RoboticsURJC/tfg-vperez/README.md

# Trabajo de Fin de Grado - Vidal Pérez

### The dedicated repo of this proyect is available [here!](https://github.com/vidalperezbohoyo/g-arm/tree/main)
