RoboticsURJC/tfg-vperez/latex/Presentacion/slides.tex

% Completa los datos convenientemente en las zonas marcadas con TODO

\documentclass{beamer}
%PARA VISUALIZAR PRESENTACIONN CON NOTAS USAR VISUALIZADOR "pdfpc":
%Para ver las notas, el cronometro y siguente diapo:
% pdfpc --notes=right slides.pdf
% "tecla p": para pausar el cronometro
\mode<presentation> {
  \usetheme{CambridgeUS}
  \usecolortheme{crane} % color naranja
}
\setbeamercolor{titlelike}{parent=structure,bg=yellow!85!orange} % Cambia el color de la caja del título de la página inicial

\setbeamertemplate{navigation symbols}{} % ocultar iconos de navegación
\setbeamerfont{subsection in toc}{size=\small} % reducir tamaño en TOC
\setbeamerfont{date}{size=\tiny}
\usepackage[spanish]{babel}
\usepackage[utf8]{inputenc}
\usepackage{graphicx}
\usepackage{eurosym}
\usepackage{booktabs}
\usepackage{hyperref}
\usepackage{graphicx}
\usepackage{multicol}
\usepackage{pgfpages}
\usepackage{listings}
\usepackage{multimedia}
\usepackage[export]{adjustbox}
\usepackage{outlines} % Para poner bullets tabulados (\1 \2 \3 ...) y no items
\usepackage{siunitx}
\usepackage{multicol}
\usepackage{xspace}
\usepackage{xcolor}
\usepackage{array,tabularx} % para tabular leyenda de ecuaciones
\newenvironment{conditions*} % entorno de "leyenda de ecuación"
  {\par\vspace{\abovedisplayskip}\noindent
   \tabularx{\columnwidth}{>{$}l<{$} @{\ : } >{\raggedright\arraybackslash}X}}
  {\endtabularx\par\vspace{\belowdisplayskip}}
  
% USO DE NOTAS
\setbeameroption{hide notes} % Para mostrar u ocultar (hide/show)
%\setbeameroption{show only notes} % Mostrar solo las notas
%\setbeameroption{show notes on second screen=right} % Mostrar notas en otra pantalla
\setbeamertemplate{note page}{ % asi solo muestro el texto de las notas
  \insertnote%
}

%========= TODO: datos internos del documento
\hypersetup{
	pdftitle={Defensa de trabajo de fin de grado de Vidal Pérez Bohoyo},
	pdfauthor={Vidal Pérez Bohoyo},
	pdfsubject={Brazo robótico de bajo coste para la docencia universitaria},
	pdfkeywords={teaching, robotics, arm, ROS, actuators, DOF, 3D, printer},
	pdfproducer={pdfLaTeX},
  colorlinks=true,
  linkcolor=blue
}
%=========

%========= TODO: diapositiva de portada
\title[Brazo robótico de bajo coste]{Brazo robótico de bajo coste \\ para la docencia universitaria} % El título reducido aparece en la parte inferior de todas las diapositivas
                                         % El título completo aparece solo en la diapositiva de portada
\author[Vidal Pérez Bohoyo]{Vidal Pérez Bohoyo}
\institute[URJC]
{
\textit{\href{mailto:v.perezb.2019@alumnos.urjc.es}{\color{blue}{\underline{v.perezb.2019@alumnos.urjc.es}}}}\\
\vspace{0.5cm}
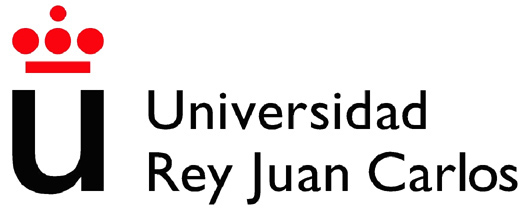
[picture p1: latex/Presentacion/figs/logo-urjc.jpg]
\\
\vspace{1cm}
Trabajo fin de grado
}
\date{27 de octubre de 2023}
%=========

%========= COMIENZO DEL DOCUMENTO
\begin{document}

%========= Portada inicial con notas
\begin{frame}[plain] % plain: quita header y footer
\large{\titlepage}
\note[item]{En esta presentación voy a hablar sobre...}
\note[item]{En primer lugar...}
\end{frame}

%========= Licencia
\begin{frame}
\input{licencia.tex}
\end{frame}

%========= Índice o tabla de contenidos (TOC)
\begin{frame}
\frametitle{Contenidos}
%\begin{multicols}{2} % si tengo muchas secciones, lo parte en dos columnas
  \tableofcontents[hideallsubsections] % no muestra subsecciones
%\end{multicols}
\note[item]{La presentaci\'on esta dividida en cuatro partes.}
\end{frame}

%========= Diapositiva "vacía" de comienzo de sección:
\section*{}
\begin{frame}{}
  \centering \Huge
  \emph{Introducción}
\note[item]{Comencemos con la introducción.}
\end{frame}

\section{Introducción}
\subsection{Contexto general}

\begin{frame}
\frametitle{Robótica industrial}
\begin{table}[htbp]
  \centering
  \begin{tabular}{cc}
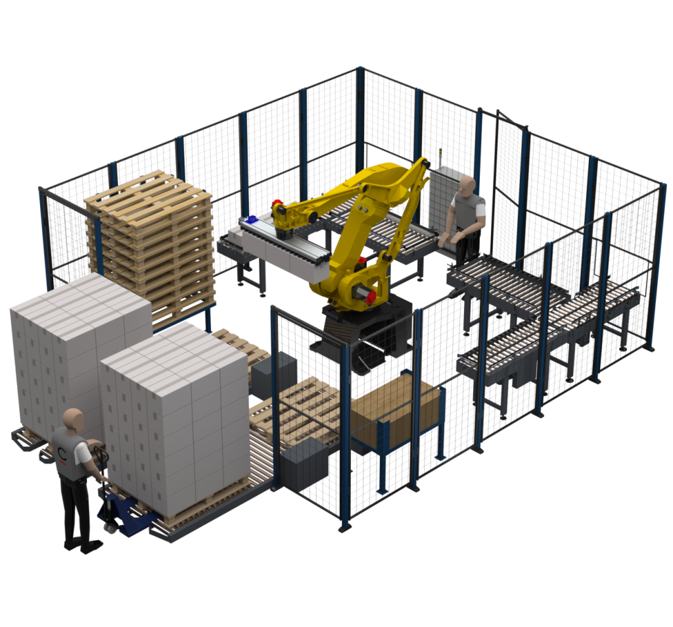
[picture p2: latex/Presentacion/figs/robotica_industrial_jaula.png]
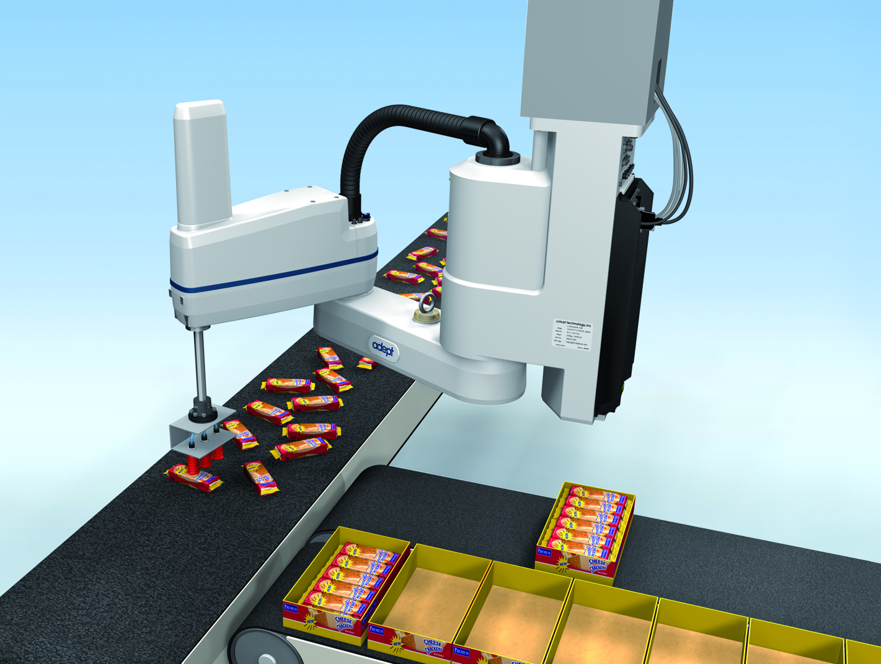
[picture p3: latex/Presentacion/figs/robotica_industrial_adept.png]
       &  \\
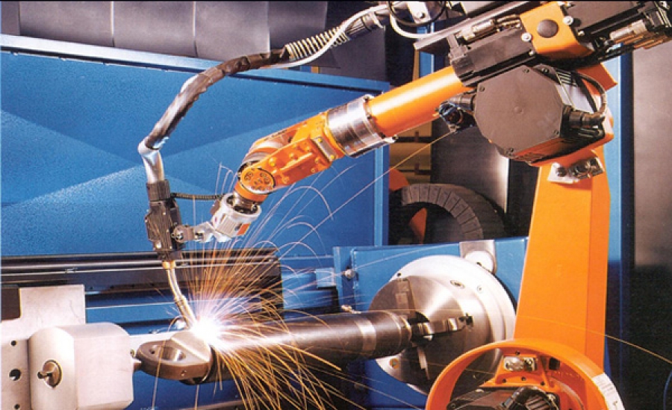
[picture p4: latex/Presentacion/figs/robotica_industrial_soldadura.png]
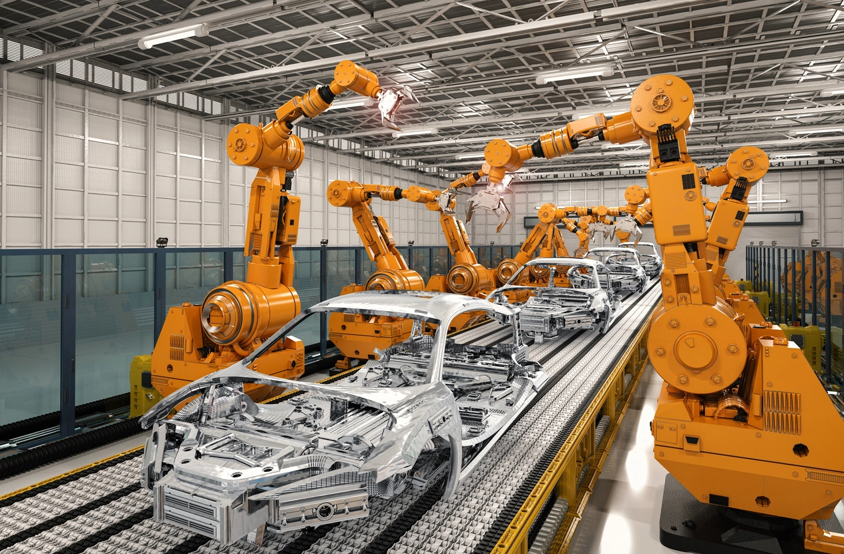
[picture p5: latex/Presentacion/figs/robotica_industrial_coches.png]
       &  
  \end{tabular}
\end{table}
\end{frame}

\begin{frame}
\frametitle{Robótica educativa}
\begin{table}[htbp]
  \centering
  \begin{tabular}{cc}
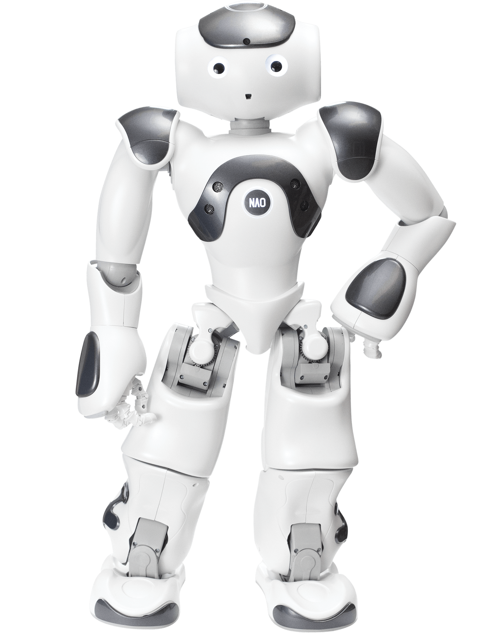
[picture p6: latex/Presentacion/figs/nao.png]
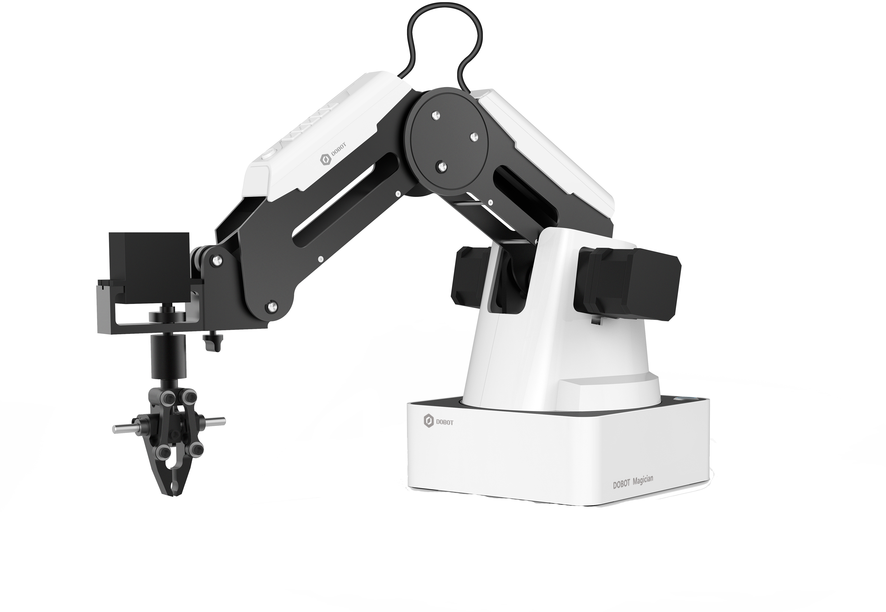
[picture p7: latex/Presentacion/figs/dobot.png]
       &  \\
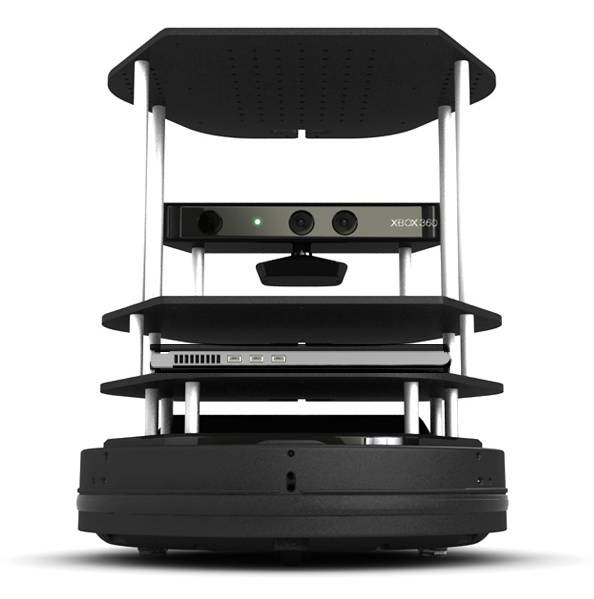
[picture p8: latex/Presentacion/figs/turtlebot.jpg]
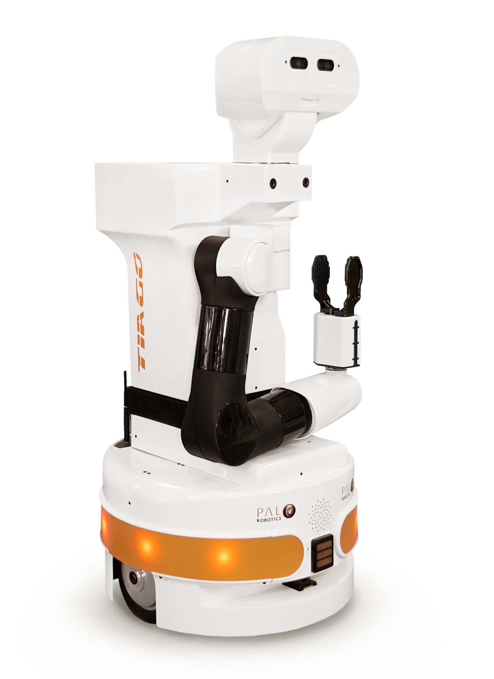
[picture p9: latex/Presentacion/figs/tiago.jpg]
       &  
  \end{tabular}
\end{table}
\end{frame}

\begin{frame}
\frametitle{Robótica de bajo coste}
\begin{table}[htbp]
  \centering
  \begin{tabular}{cc}
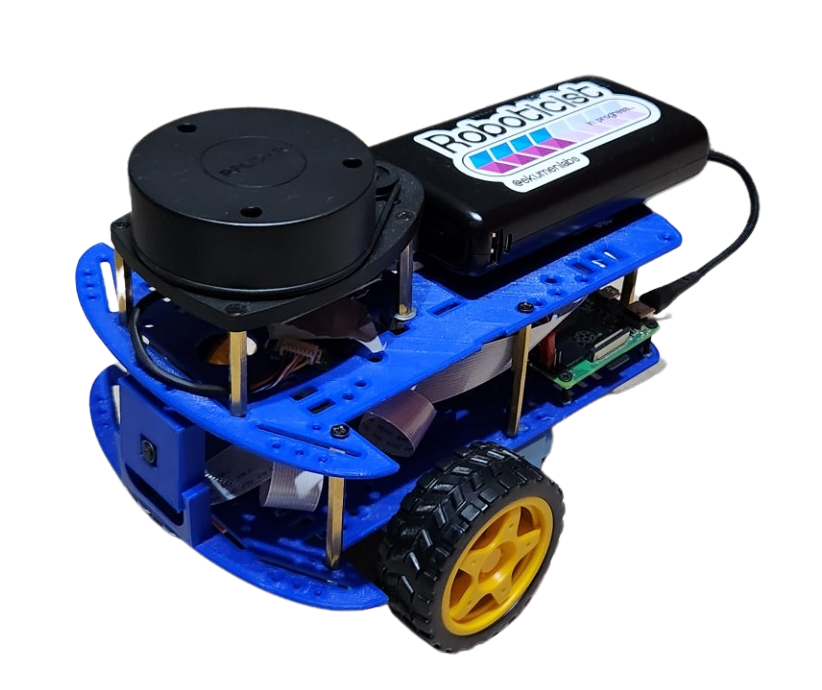
[picture p10: latex/Presentacion/figs/andino.png]
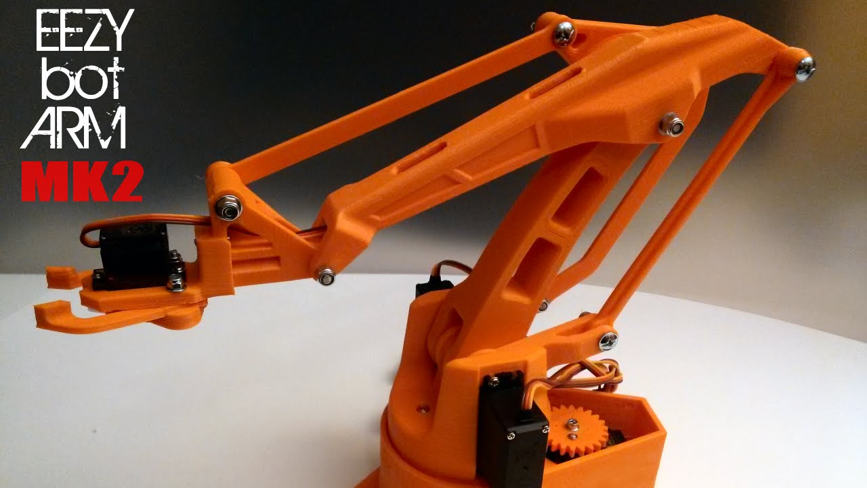
[picture p11: latex/Presentacion/figs/eezy.jpg]
       &  \\
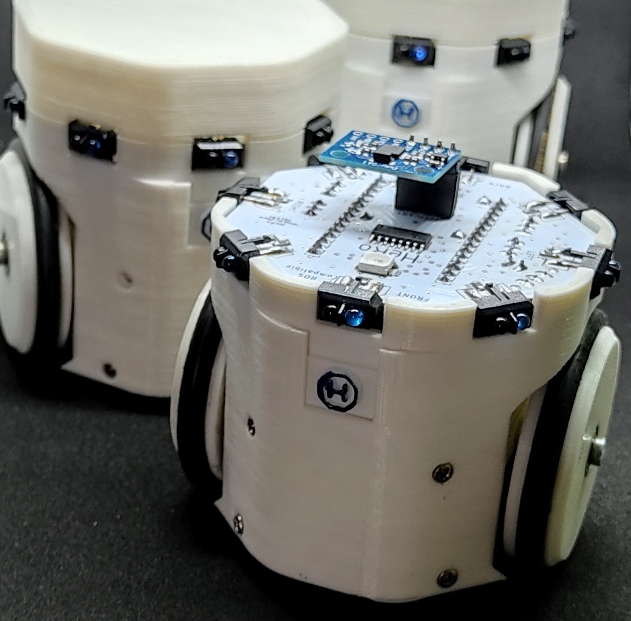
[picture p12: latex/Presentacion/figs/hero.png]
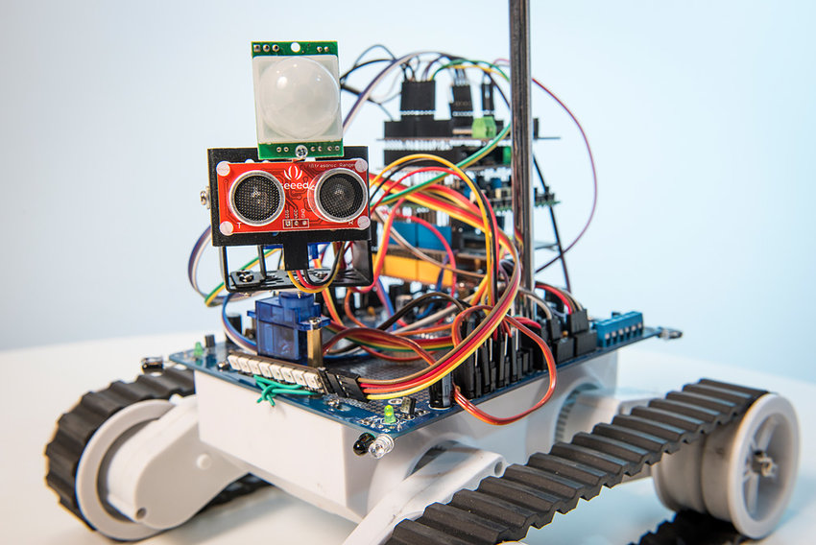
[picture p13: latex/Presentacion/figs/r5robot.png]
       &  
  \end{tabular}
\end{table}
\end{frame}

\section*{}
\begin{frame}{}
  \centering \Huge
  \emph{Objetivos}
\note[item]{Pasemos ahora a comentar los objetivos que nos hemos con este trabajo.}
\end{frame}

\section{Objetivos}

\begin{frame}
\frametitle{Descripción del problema}
\begin{table}[htbp]
  \centering
  \begin{tabular}{cc}
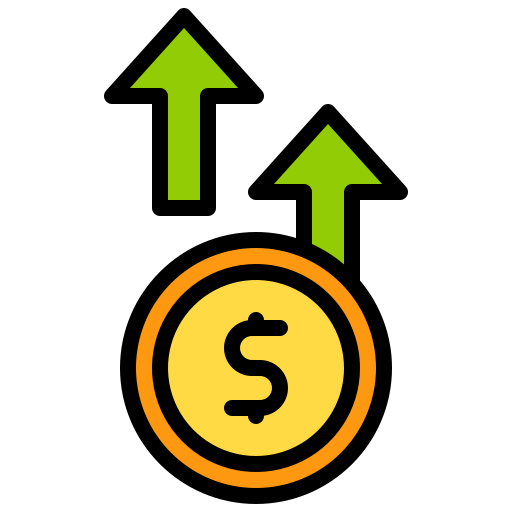
[picture p14: latex/Presentacion/figs/high_price.png]
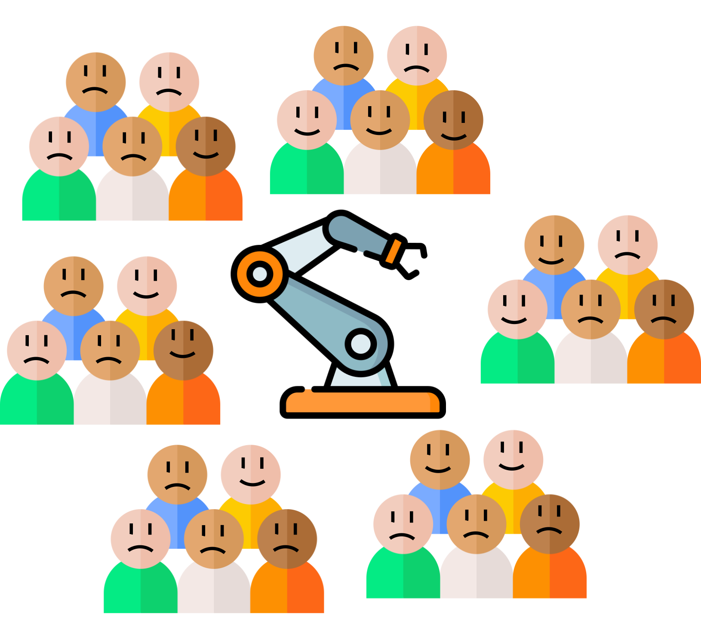
[picture p15: latex/Presentacion/figs/high_people.png]
       &  \\
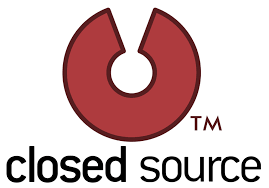
[picture p16: latex/Presentacion/figs/closed_source.png]
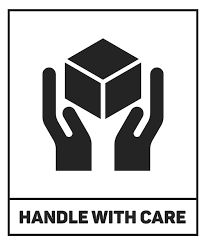
[picture p17: latex/Presentacion/figs/care.png]
       & 
  \end{tabular}
\end{table}
\end{frame}
  
\begin{frame}
\frametitle{Requisitos}
\begin{enumerate}
\item Coste inferior a 200\euro.
\item En su mayoría impreso en 3D.
\item Bajo consumo eléctrico, inferior a 25 vatios.
\item Tamaño reducido.
\item Sencillo de montar.
\item Tener integración con ROS 2 y MoveIt 2.
\end{enumerate}
\end{frame}

\begin{frame}
\frametitle{Metodología}
\begin{table}[htbp]
  \centering
  \begin{tabular}{ccc}
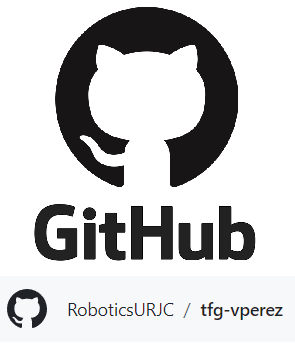
[picture p18: latex/Presentacion/figs/repo.png]
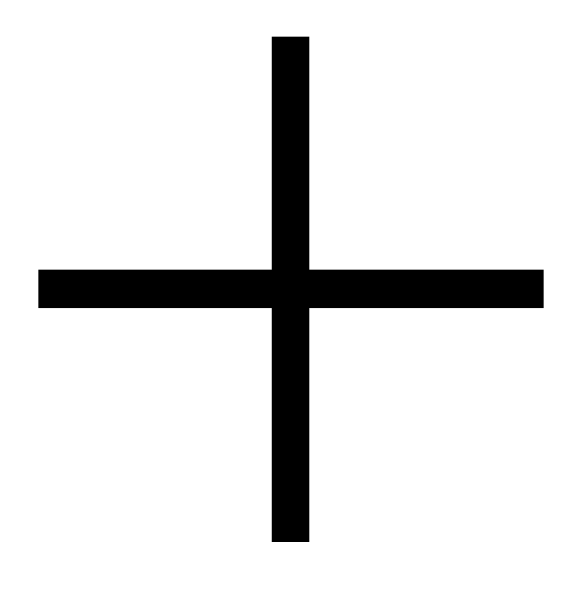
[picture p19: latex/Presentacion/figs/plus.png]
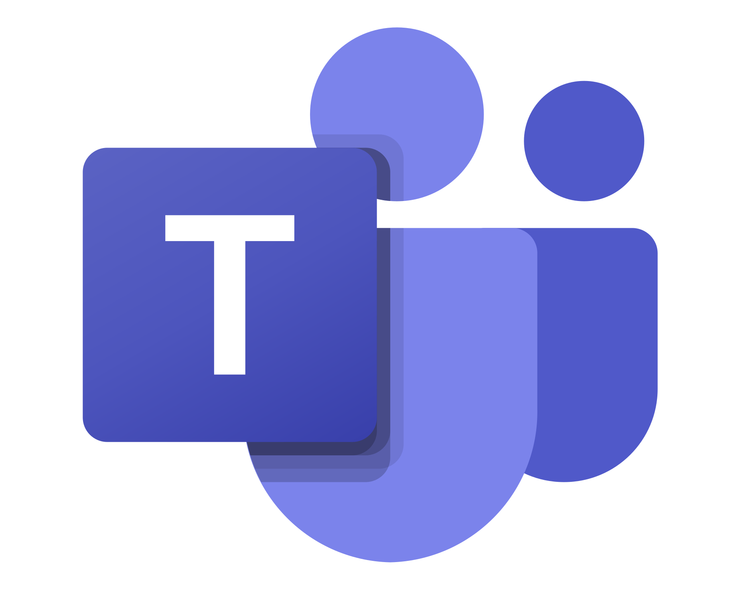
[picture p20: latex/Presentacion/figs/teams.png]
       &  &  
  \end{tabular}
\end{table}
\begin{center}
  \url{https://github.com/RoboticsURJC/tfg-vperez}
\end{center}

\end{frame}

\section*{}
\begin{frame}{}
  \centering \Huge
  \emph{Plataforma de desarrollo}
\note[item]{Una vez descritos los objetivos, veamos qué hemos hecho para alcanzarlos.}
\end{frame}
\section{Plataforma de desarrollo}
\begin{frame}
\frametitle{Software}
\begin{table}[htbp]
  \centering
  \begin{tabular}{ccc}
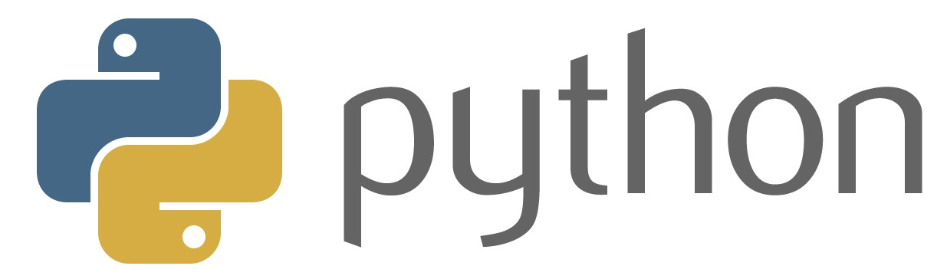
[picture p21: latex/Presentacion/figs/phyton.jpg]
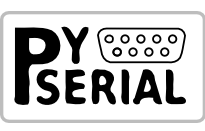
[picture p22: latex/Presentacion/figs/pyserial.png]
       &  &
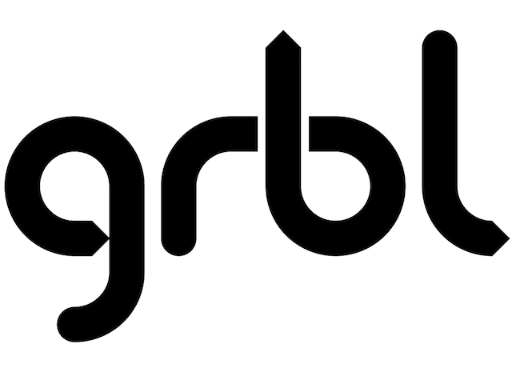
[picture p23: latex/Presentacion/figs/grbl.png]
       \\
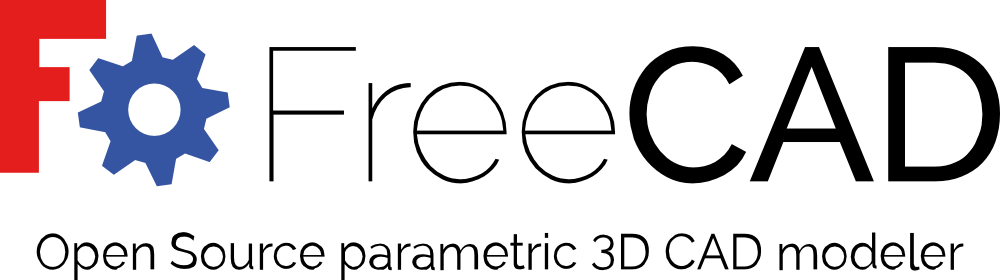
[picture p24: latex/Presentacion/figs/freecad.png]
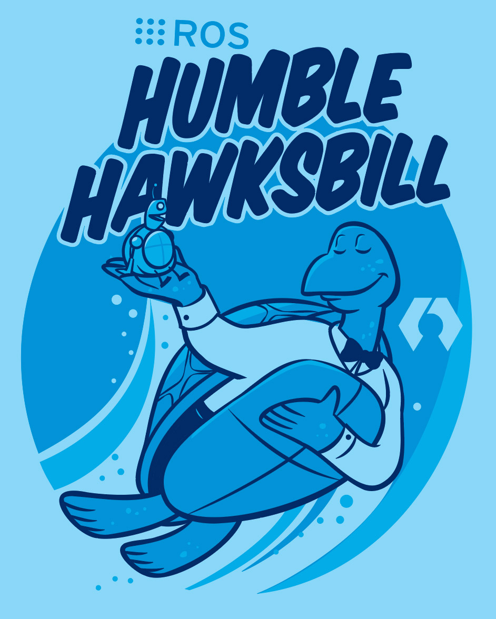
[picture p25: latex/Presentacion/figs/ros2logo.jpeg]
       &  & 
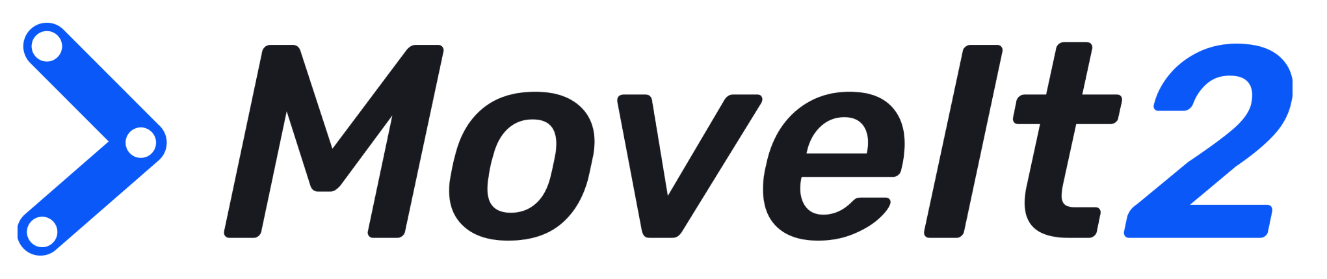
[picture p26: latex/Presentacion/figs/moveit2.png]
      
  \end{tabular}
\end{table}
\end{frame}

\begin{frame}
\frametitle{Hardware}
\begin{table}[htbp]
  \centering
  \begin{tabular}{ccc}
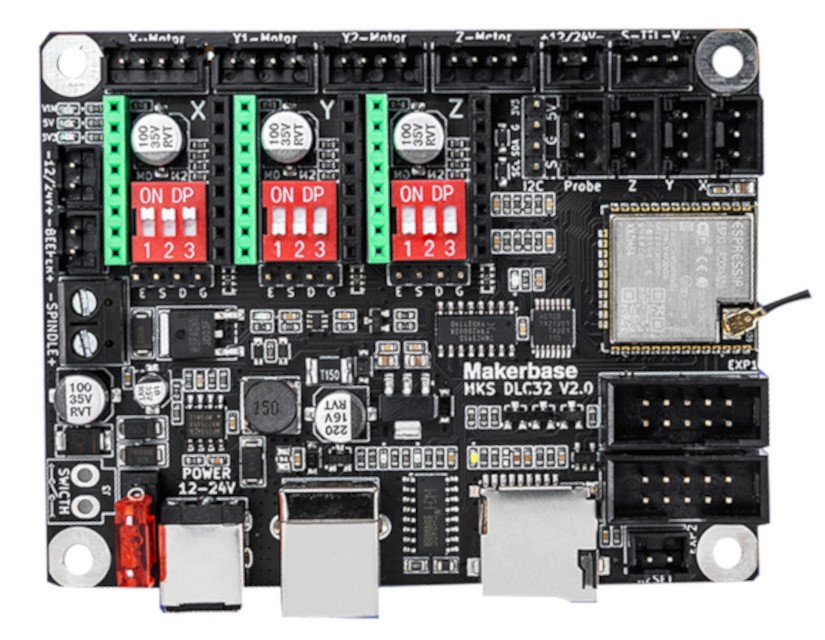
[picture p27: latex/Presentacion/figs/mksdlc32.jpg]
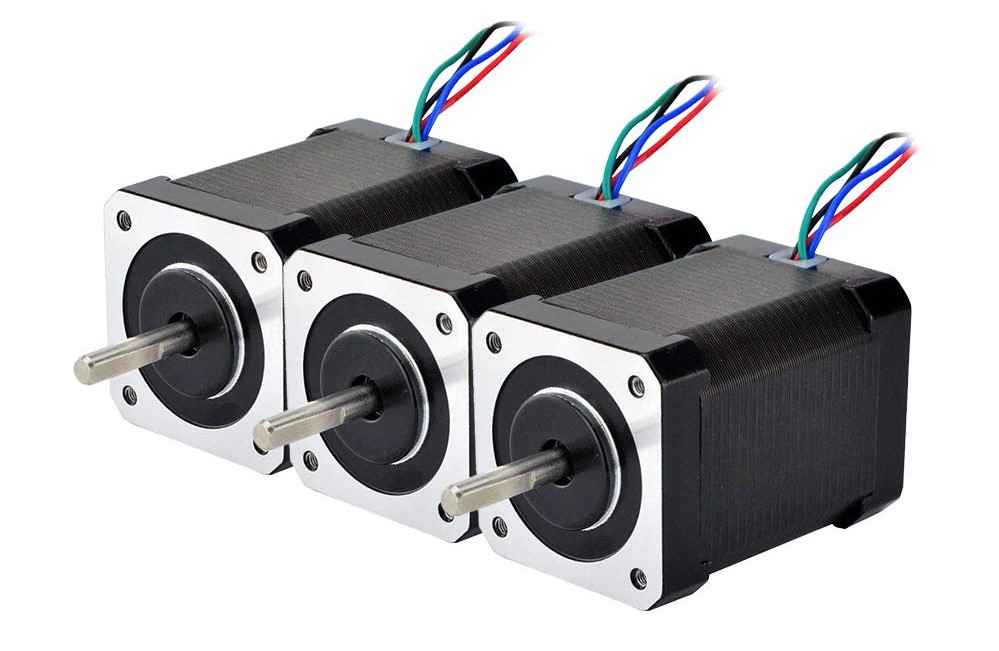
[picture p28: latex/Presentacion/figs/nema17.jpg]
       &  &
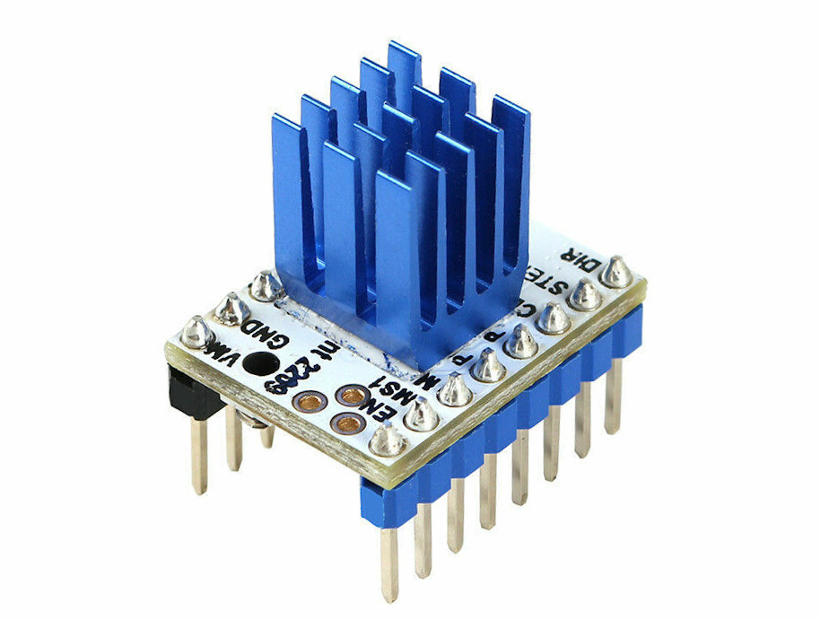
[picture p29: latex/Presentacion/figs/TMC2209.jpg]
       \\
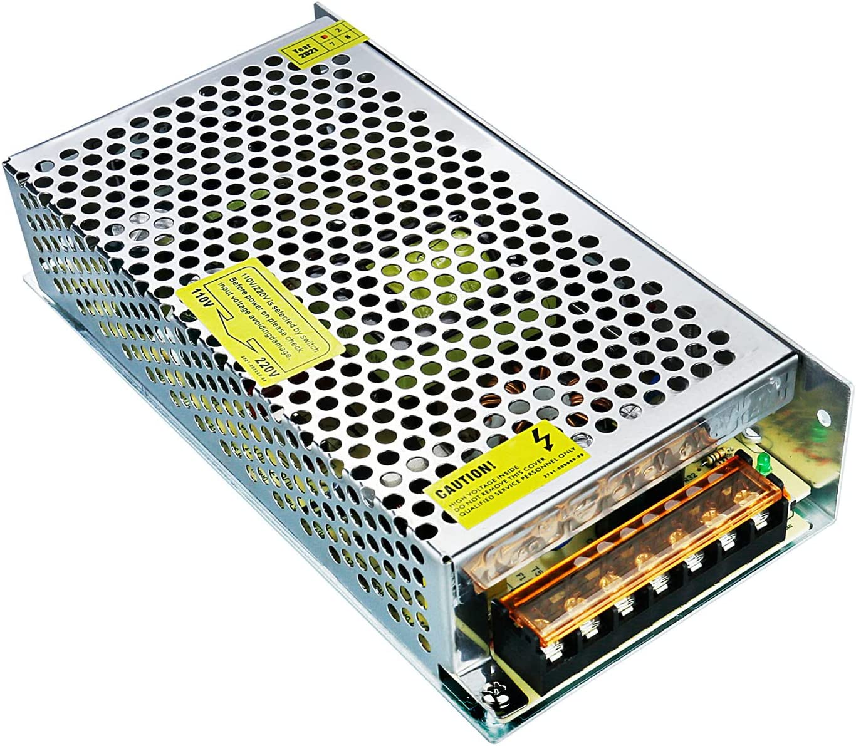
[picture p30: latex/Presentacion/figs/pw24v.jpg]
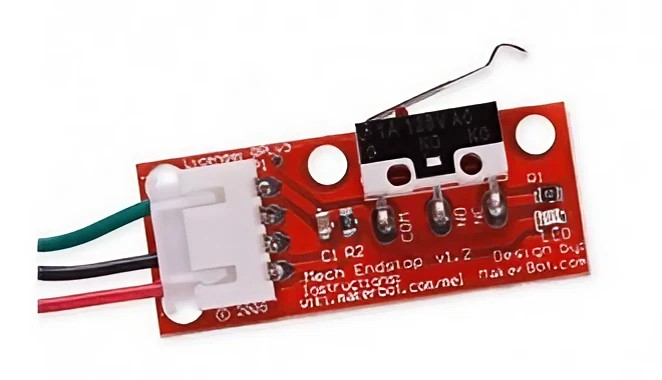
[picture p31: latex/Presentacion/figs/finaldecarrera.jpg]
       &  & 
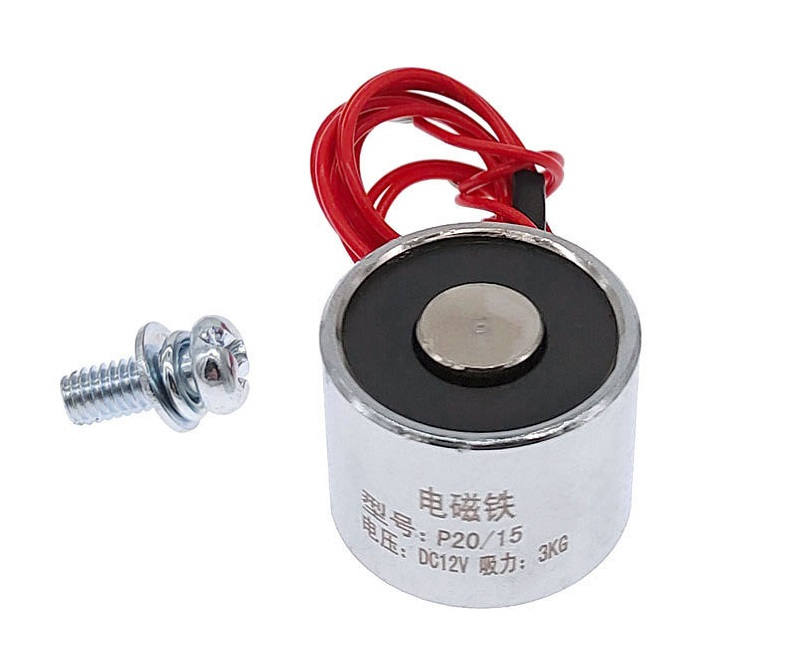
[picture p32: latex/Presentacion/figs/d20h15.jpg]
       \\ 
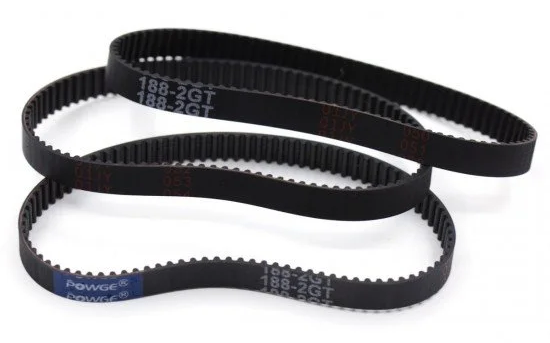
[picture p33: latex/Presentacion/figs/correa.png]
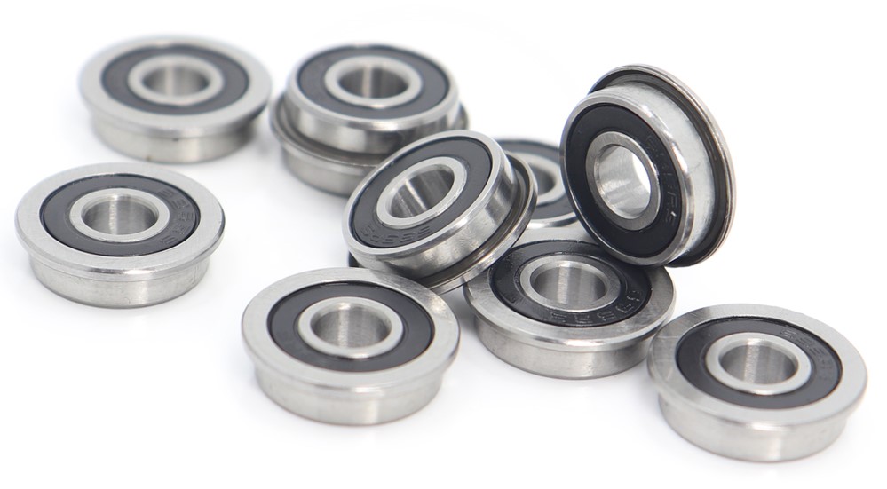
[picture p34: latex/Presentacion/figs/F695-2RS.jpeg]
       &  & 
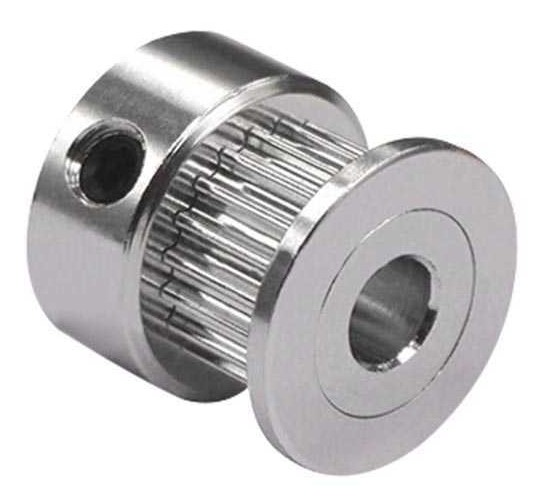
[picture p35: latex/Presentacion/figs/20t.jpg]
      
  \end{tabular}
\end{table}
\end{frame}

\section*{}
\begin{frame}{}
  \centering \Huge
  \emph{Desarrollo hardware}
\note[item]{Una vez descritos los objetivos, veamos qué hemos hecho para alcanzarlos.}
\end{frame}
\section{Desarrollo hardware}

\begin{frame}
  \frametitle{Concepción de la idea: Inspiración}
  \begin{table}[htbp]
    \centering
    \begin{tabular}{cc}
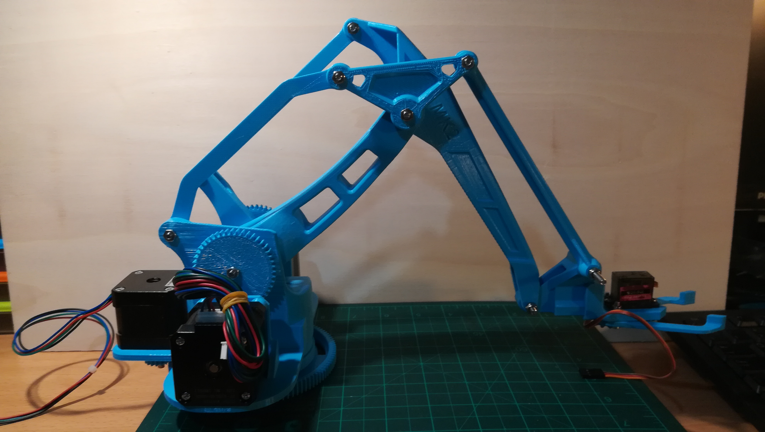
[picture p36: latex/Presentacion/figs/robotarmMK2plus.jpg]
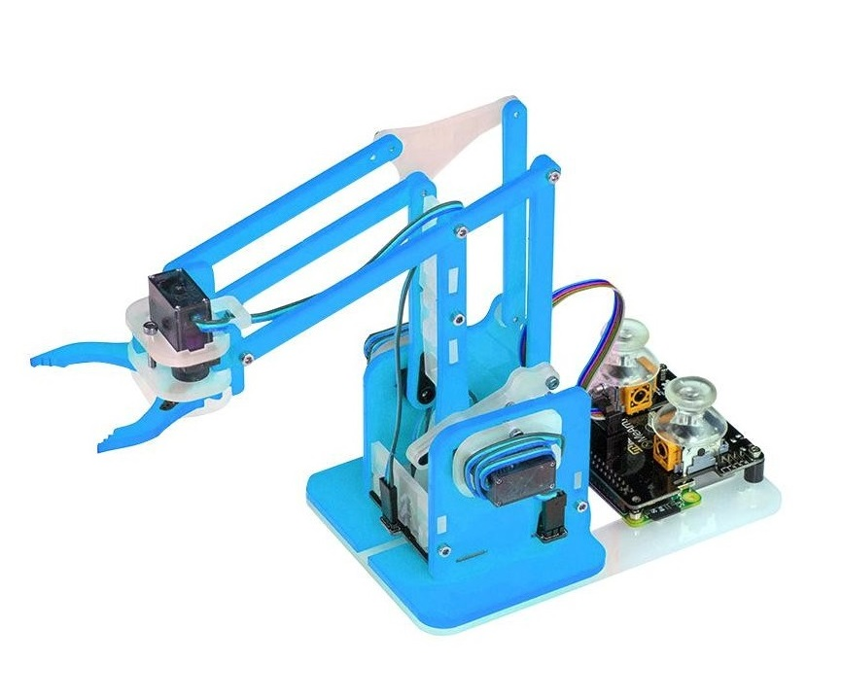
[picture p37: latex/Presentacion/figs/mearm.jpg]
         &  
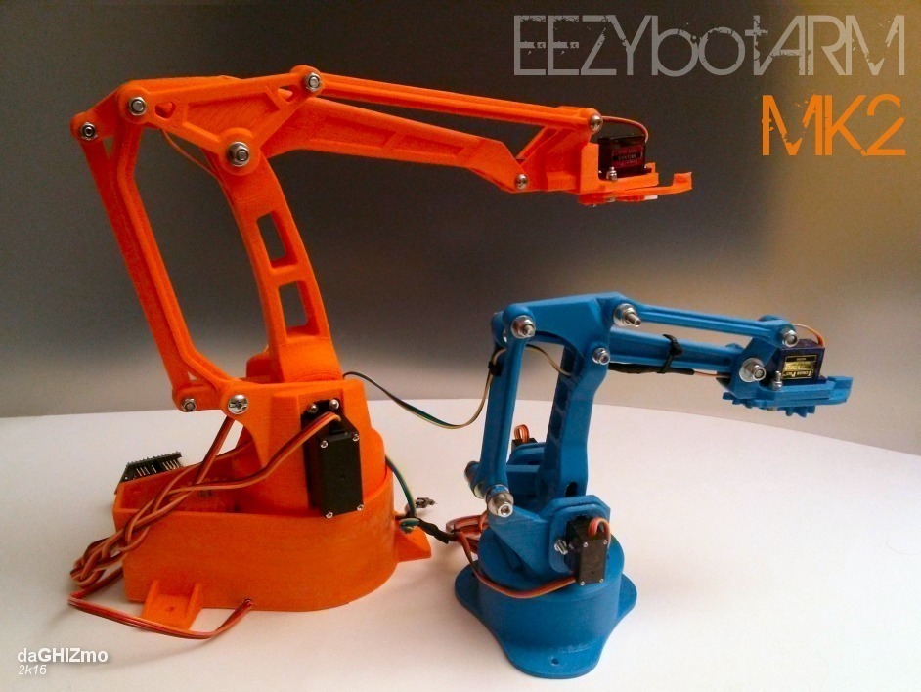
[picture p38: latex/Presentacion/figs/mearms.jpg]
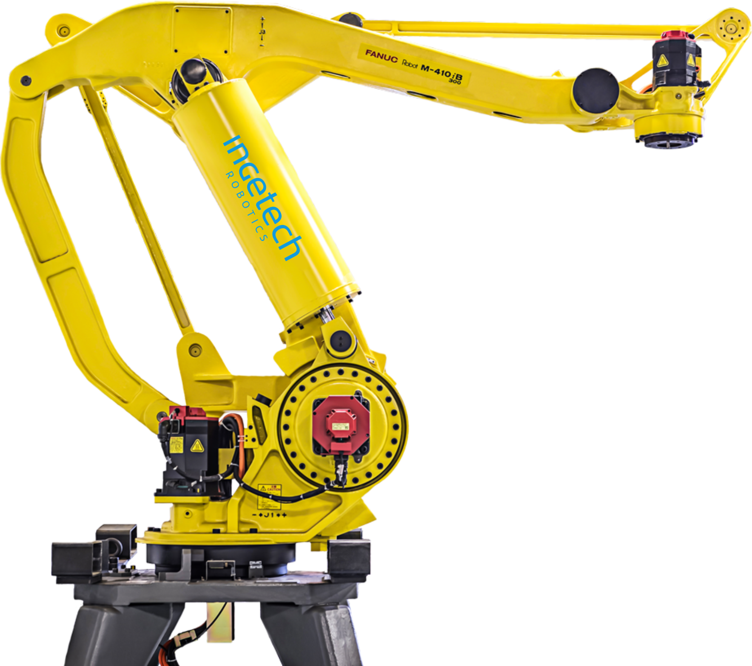
[picture p39: latex/Presentacion/figs/fanuc.png]
         \\  &  
        
    \end{tabular}
  \end{table} 
\end{frame}

\begin{frame}
  \frametitle{Concepción de la idea: Mejoras}
  \begin{block}{Puntos débiles de las soluciones ya existentes}
    \begin{itemize}
    \item \textcolor{red}{Baja fuerza} y capacidad de carga.
    \item \textcolor{red}{Holgura} en engranajes y articuaciones los hace inexactos e imprecisos.
    \item Poco tiempo de vida por el \textcolor{red}{desgaste} del plástico de sus articulaciones.
    \end{itemize}
  \end{block}

  \begin{table}[htbp]
    \centering
    \begin{tabular}{cccc}
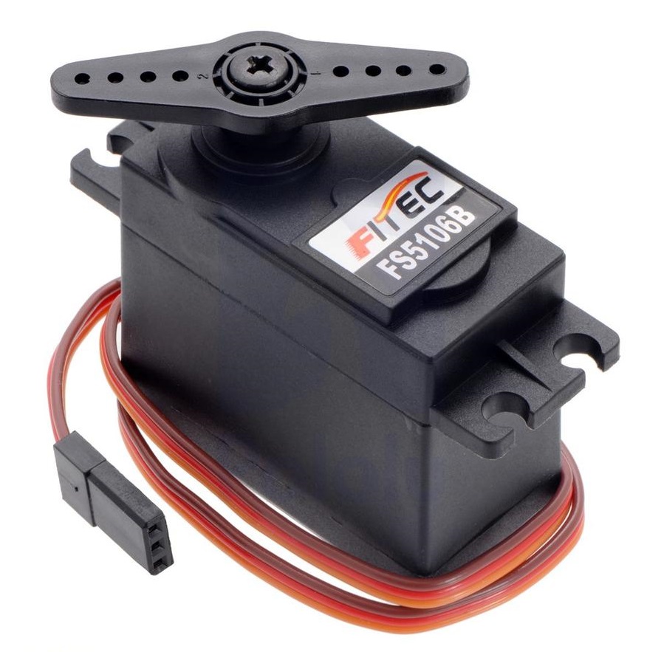
[picture p40: latex/Presentacion/figs/servo.jpg]
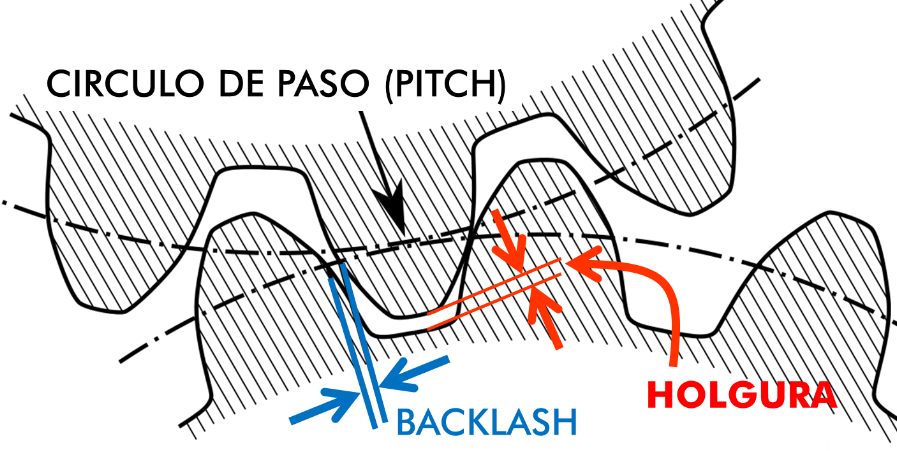
[picture p41: latex/Presentacion/figs/holgura.png]
         &  
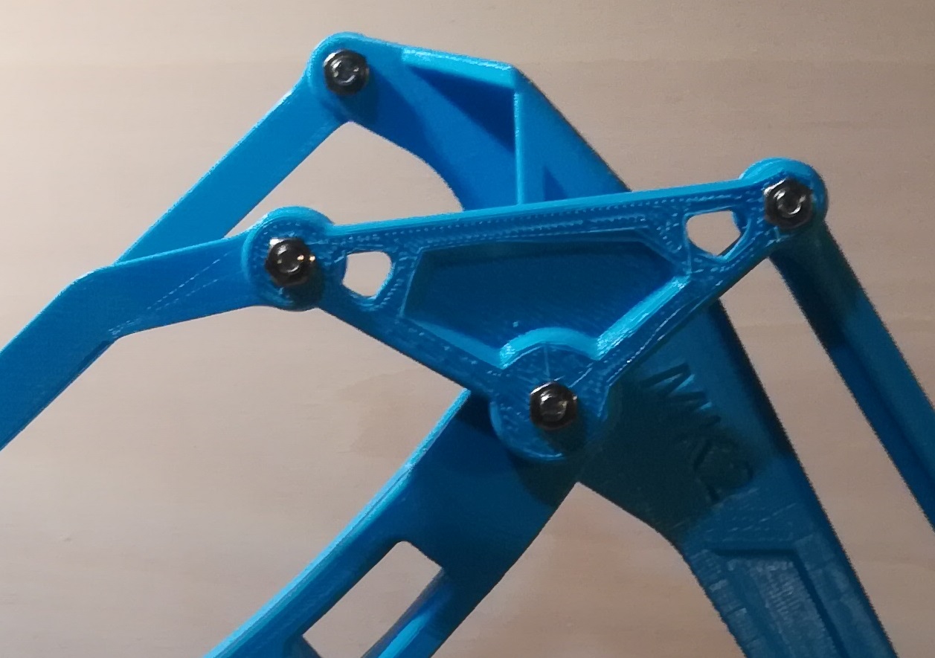
[picture p42: latex/Presentacion/figs/friccion.jpg]
        & 
        
    \end{tabular}
  \end{table} 

\end{frame}

\begin{frame}
  \frametitle{Concepción de la idea: Mejoras}
  
  \begin{block}{Soluciónes y mejoras}
    \begin{itemize}
    \item Utilizar motores más potentes de tipo \textcolor{blue}{paso a paso}, en vez de servos.
    \item \textcolor{blue}{Correas} dentadas para eliminar la holgura en la reductora del motor.
    \item \textcolor{blue}{Rodamientos} en articulaciones. Menos fricción y más vida útil.
    \end{itemize}
  \end{block}
  \begin{tabular}{cccc}
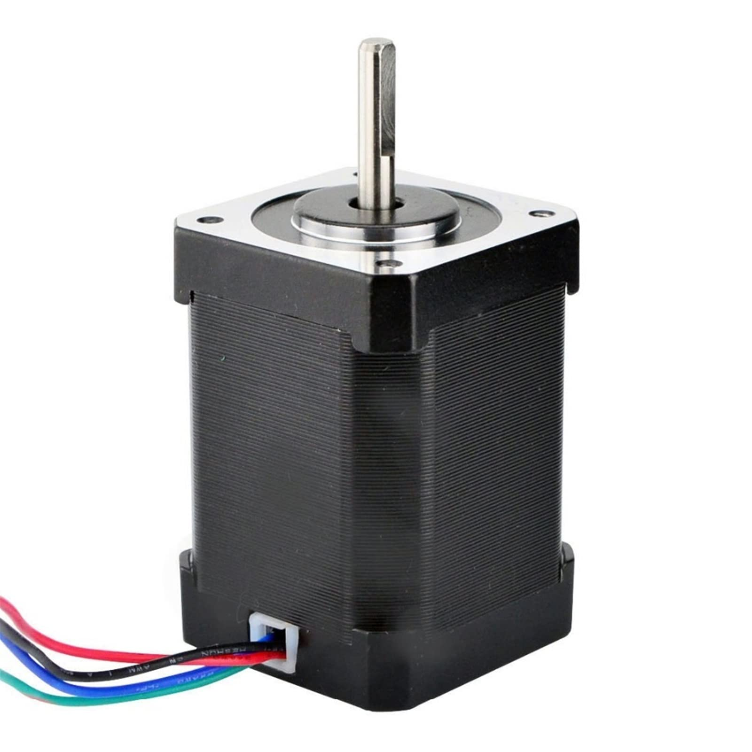
[picture p43: latex/Presentacion/figs/nema1760.jpg]
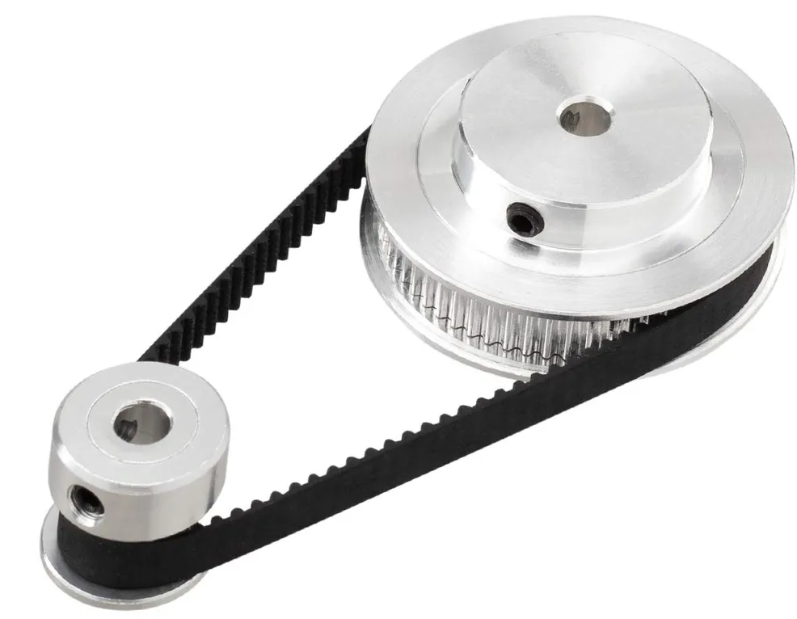
[picture p44: latex/Presentacion/figs/polea.png]
     &  
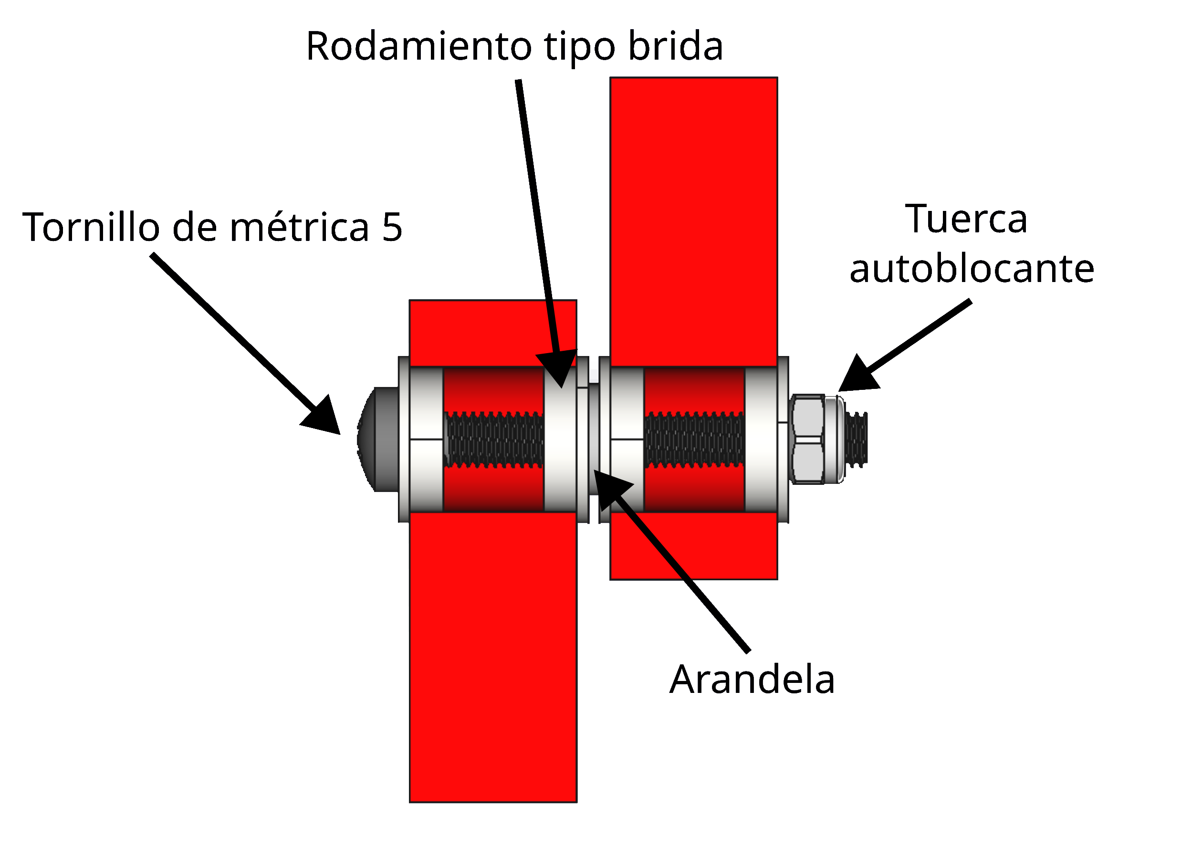
[picture p45: latex/Presentacion/figs/RodamientosBrida.png]
    & 
    
\end{tabular}
\end{frame}

\begin{frame}
  \frametitle{Concepción de la idea: Bocetos}
  \begin{table}[htbp]
    \centering
    \begin{tabular}{ccc}
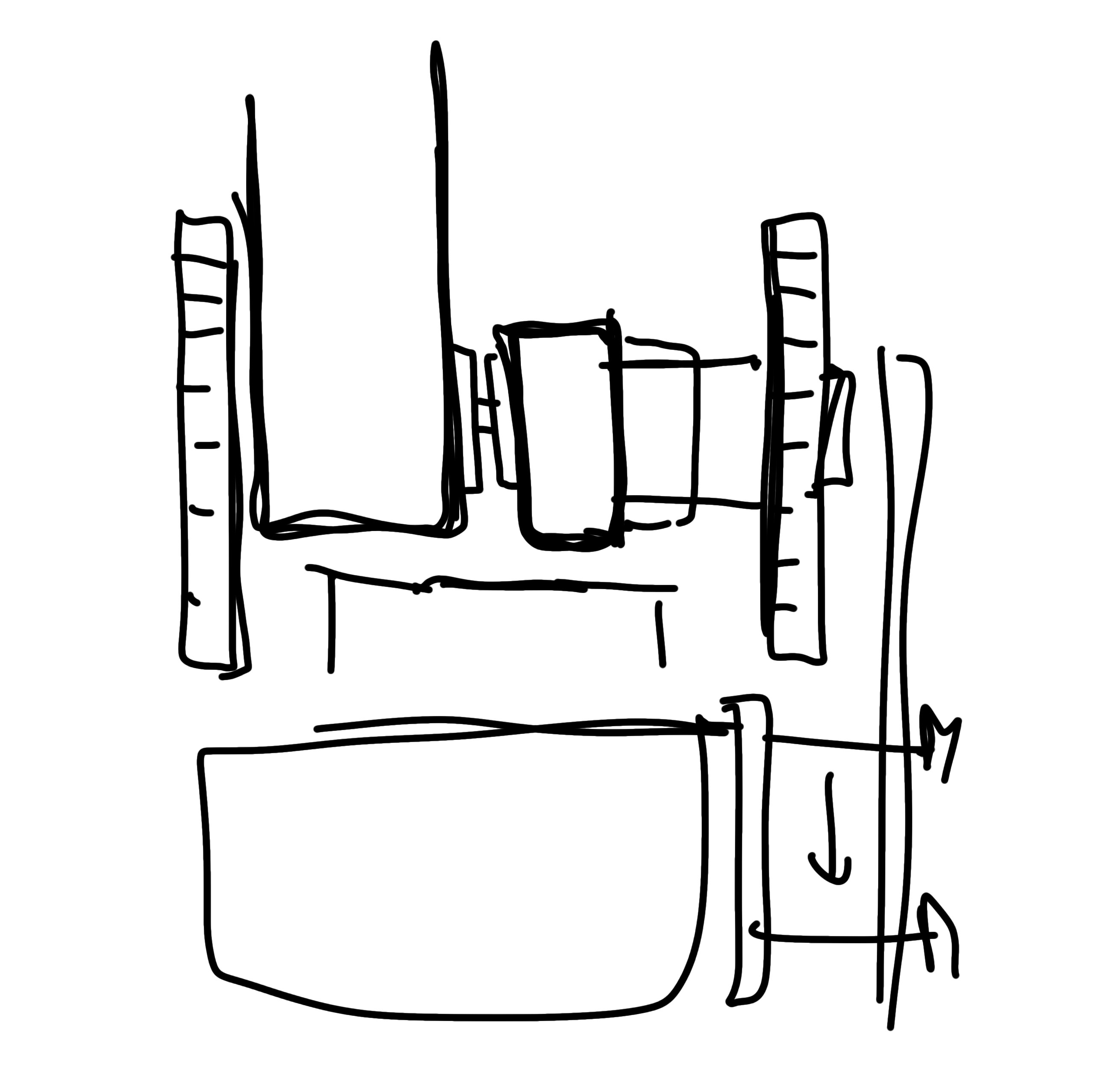
[picture p46: latex/Presentacion/figs/boceto4.PNG]
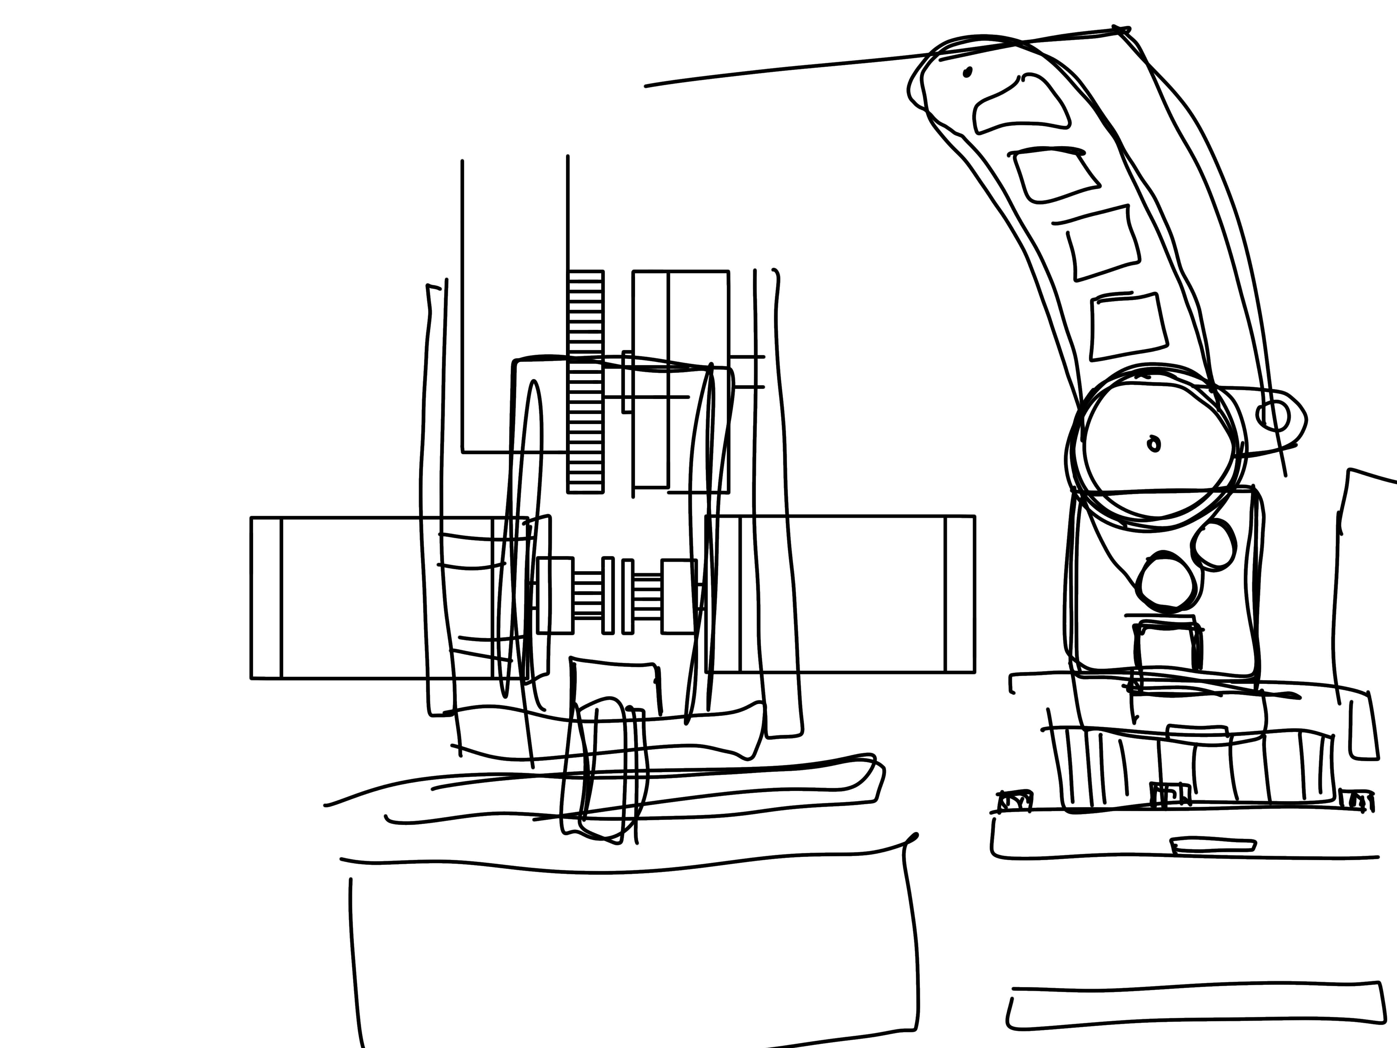
[picture p47: latex/Presentacion/figs/boceto2.PNG]
         &  
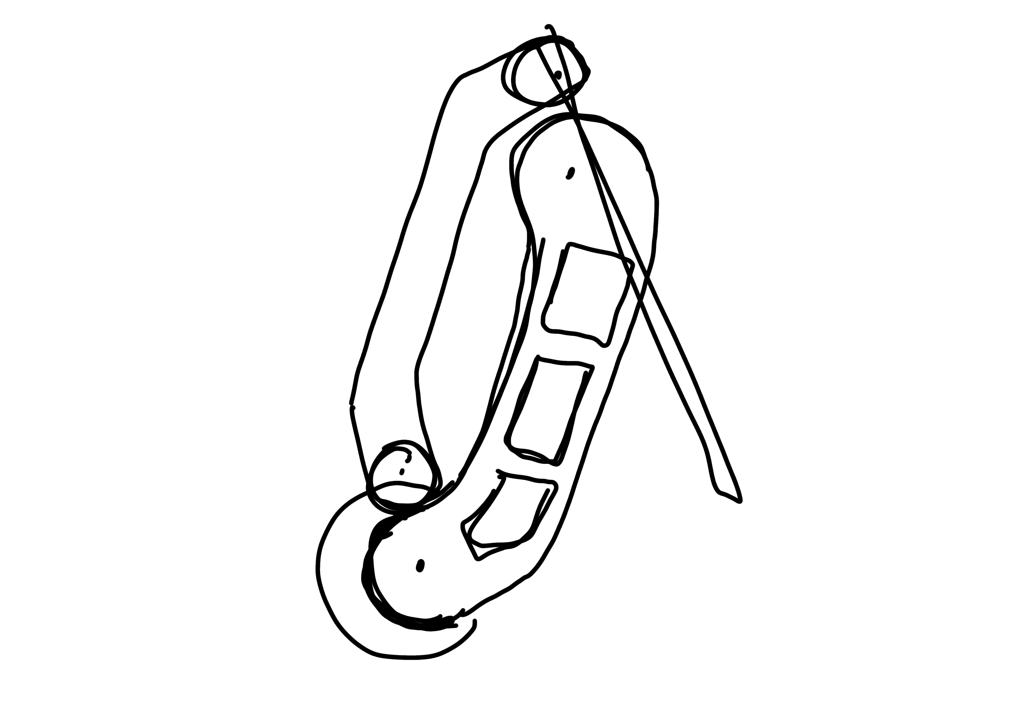
[picture p48: latex/Presentacion/figs/boceto7.jpeg]
         &  \\
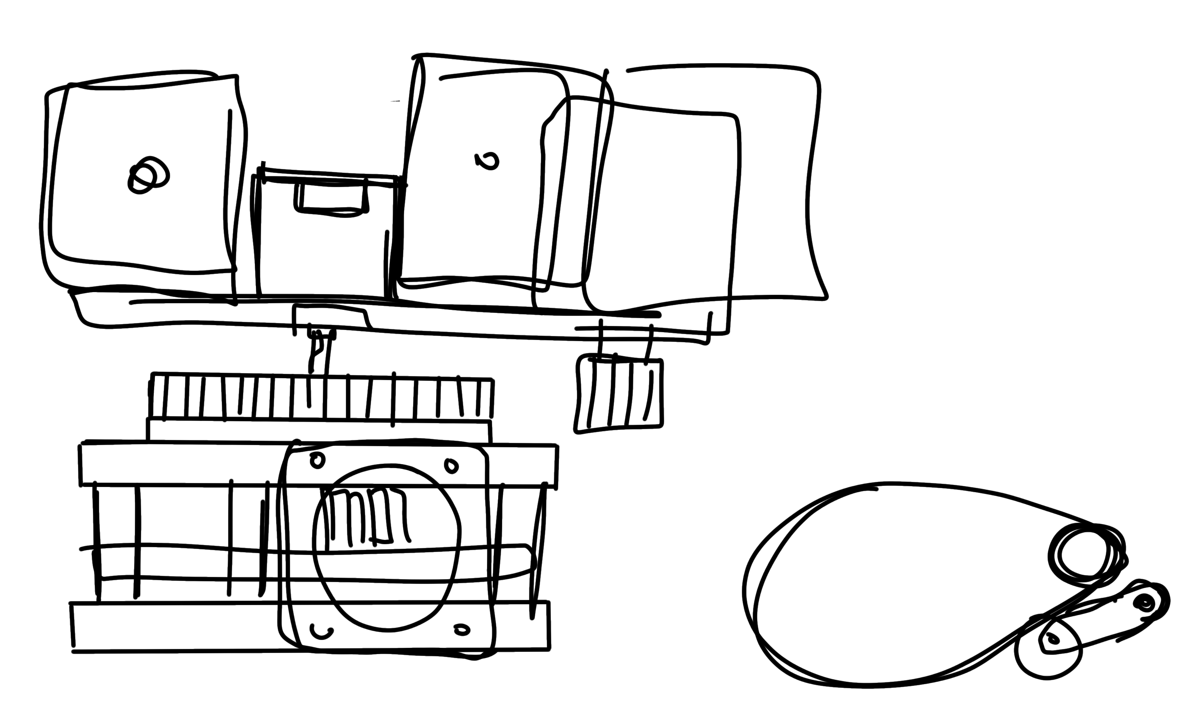
[picture p49: latex/Presentacion/figs/boceto5.PNG]
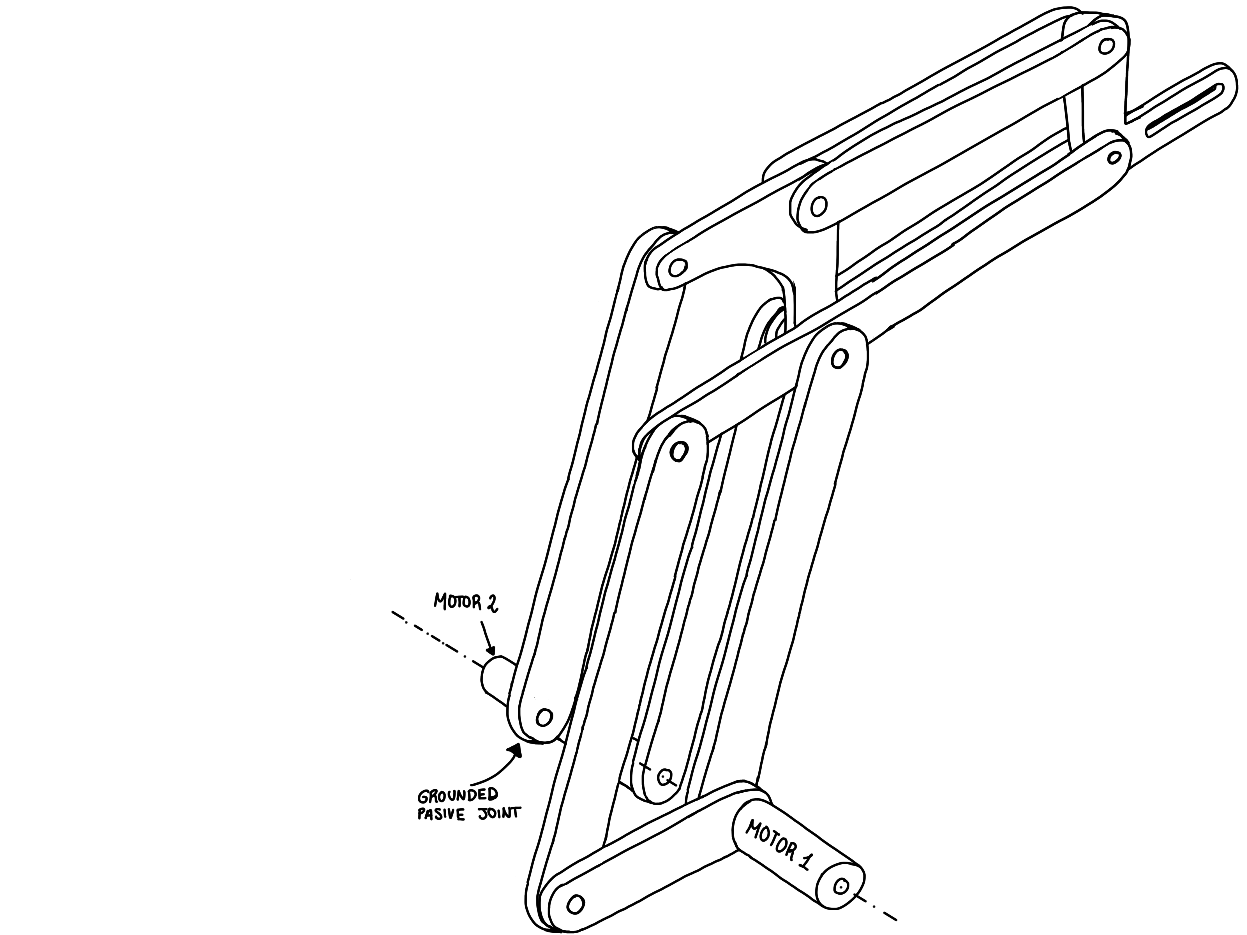
[picture p50: latex/Presentacion/figs/boceto1.PNG]
          &  
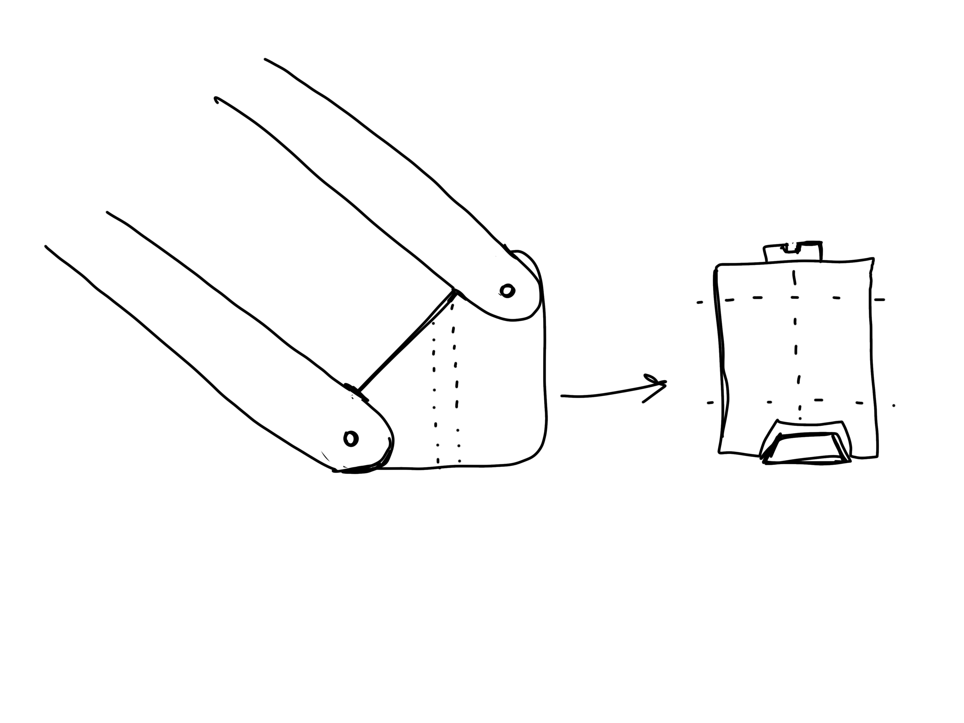
[picture p51: latex/Presentacion/figs/boceto8.jpeg]
         & 
        
    \end{tabular}
  \end{table}
\end{frame}

\begin{frame}
  \frametitle{Diseño alámbrico}
  \begin{figure}[h]
    \centering
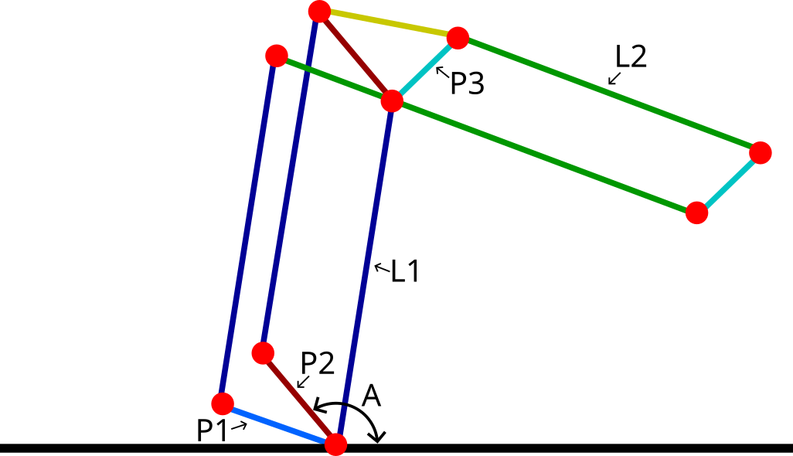
[picture p52: latex/Presentacion/figs/alambrico_params.png]
    
  \end{figure}
\end{frame}

\begin{frame}
  \frametitle{Diseño CAD (FreeCAD)}
  \begin{figure}[h]
    \centering
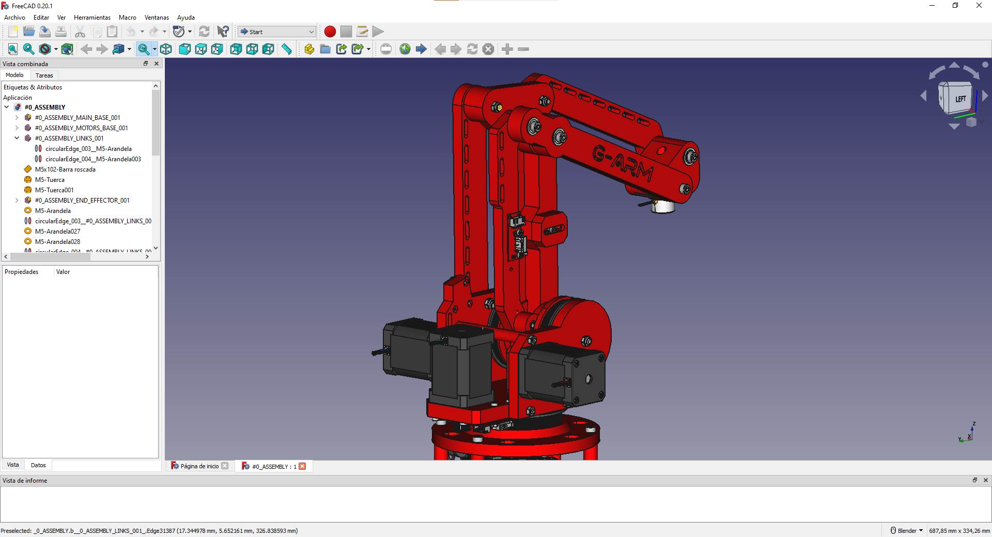
[picture p53: latex/Presentacion/figs/freecadUI.png]
    
  \end{figure}
\end{frame}

\begin{frame}
  \frametitle{Impresión y montaje}
  \begin{table}[htbp]
    \centering
    \begin{tabular}{ccc}
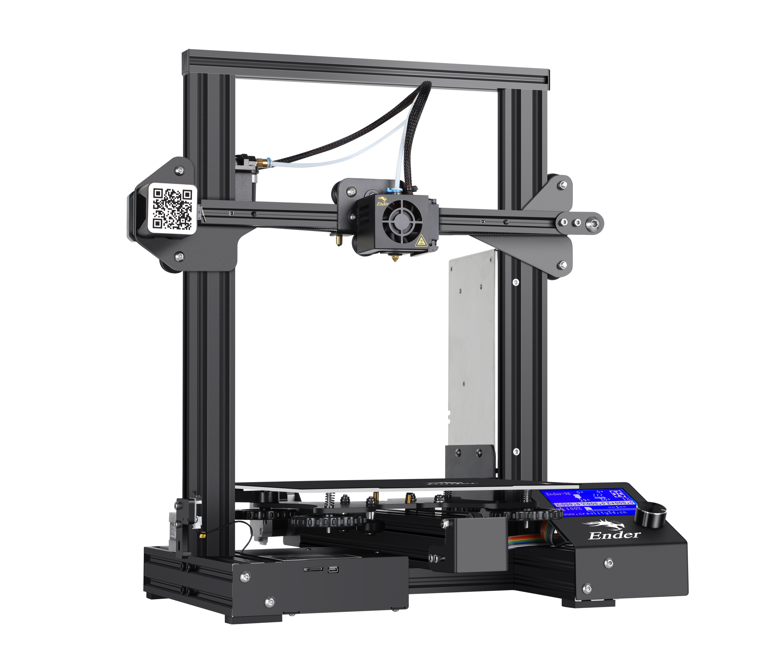
[picture p54: latex/Presentacion/figs/ender3.png]
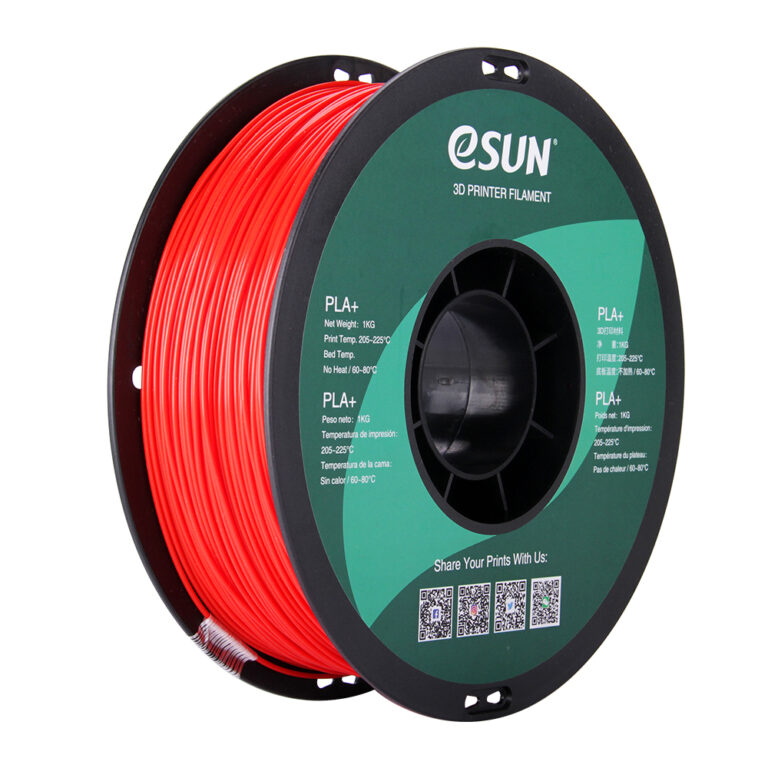
[picture p55: latex/Presentacion/figs/pla.jpg]
         &  
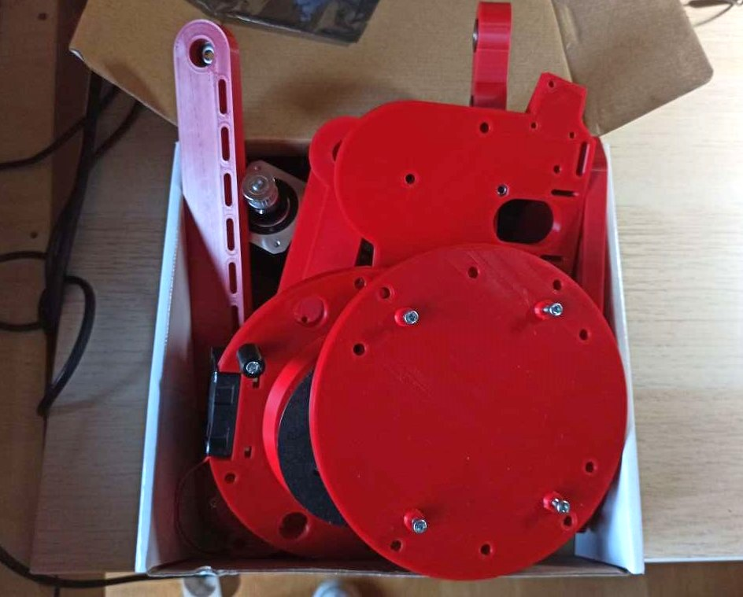
[picture p56: latex/Presentacion/figs/montaje2.JPEG]
         &  \\
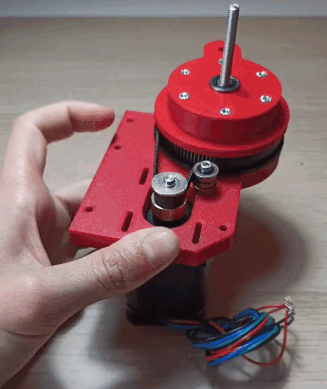
[picture p57: latex/Presentacion/figs/montaje.png]
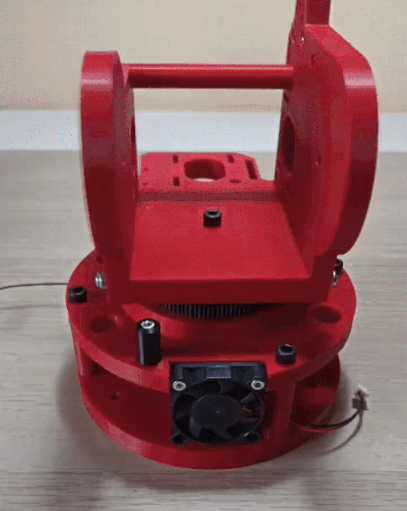
[picture p58: latex/Presentacion/figs/montaje1.png]
          &  
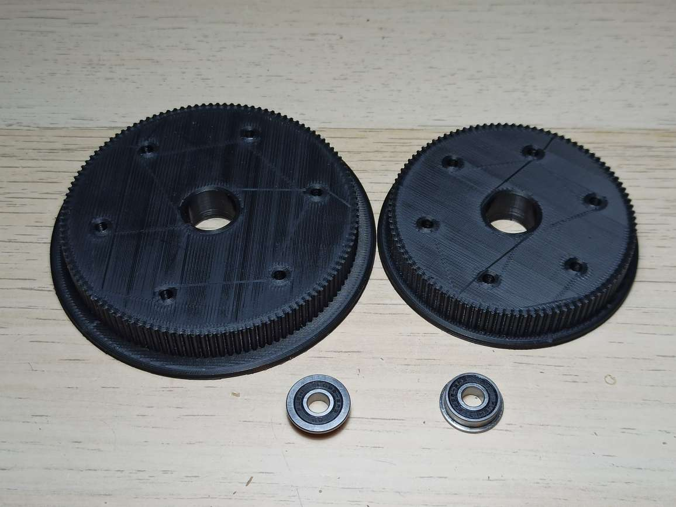
[picture p59: latex/Presentacion/figs/montaje3.JPEG]
         & 
        
    \end{tabular}
  \end{table}
\end{frame}

\begin{frame}
  \frametitle{Resultado final}
  \begin{table}[htbp]
  \begin{tabular}{cc}
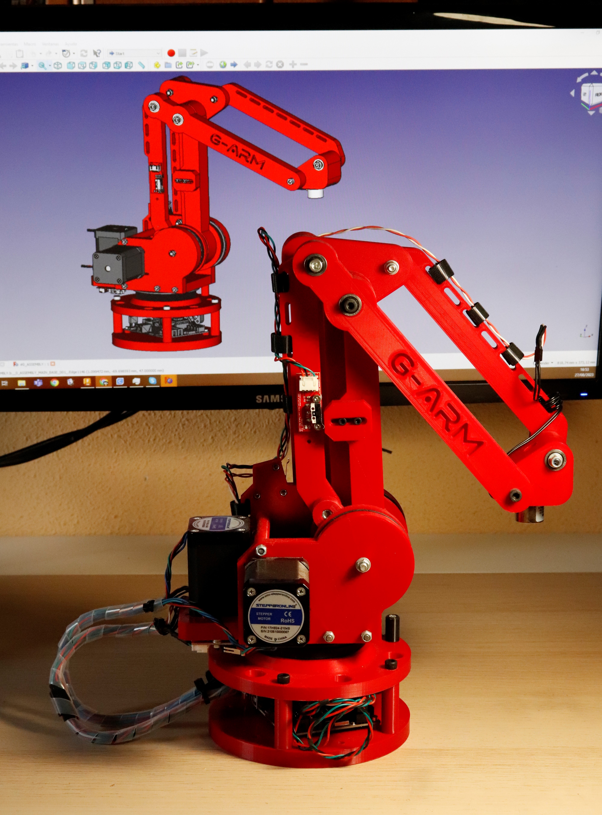
[picture p60: latex/Presentacion/figs/resultado2.jpg]
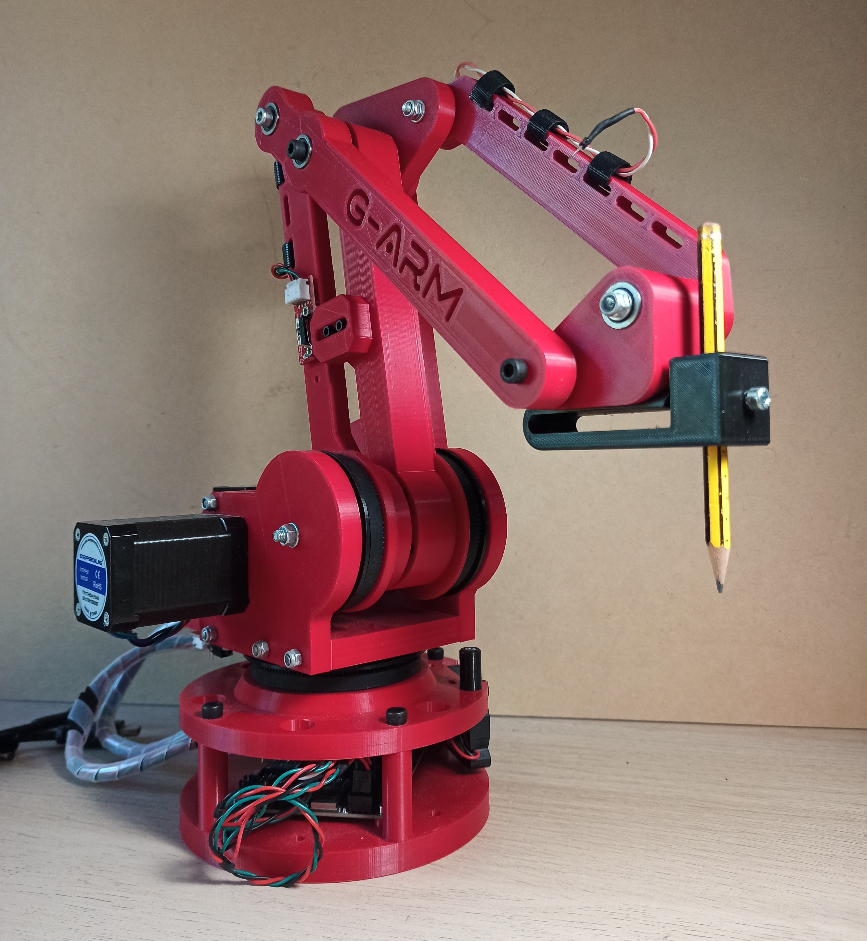
[picture p61: latex/Presentacion/figs/resultado1.jpg]
     &  
  \end{tabular}
\end{table}
\end{frame}

\section*{}
\begin{frame}{}
  \centering \Huge
  \emph{Desarrollo software}
\note[item]{Una vez descritos los objetivos, veamos qué hemos hecho para alcanzarlos.}
\end{frame}
\section{Desarrollo software}

\begin{frame}
  \frametitle{Arquitectura software}
  \begin{figure}[h]
    \centering
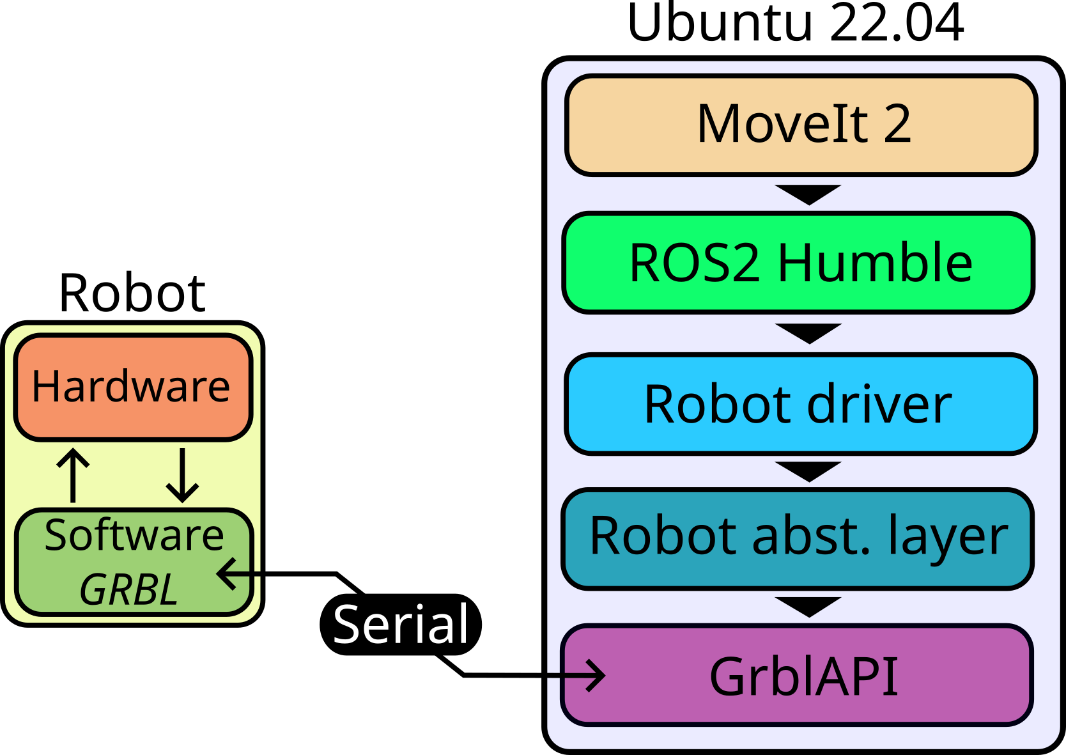
[picture p62: latex/Presentacion/figs/arquitectura_sw.png]
    
  \end{figure}
  \end{frame}

\begin{frame}
\frametitle{Grbl y comunicación con el ordenador}
\begin{figure}[h]
  \centering
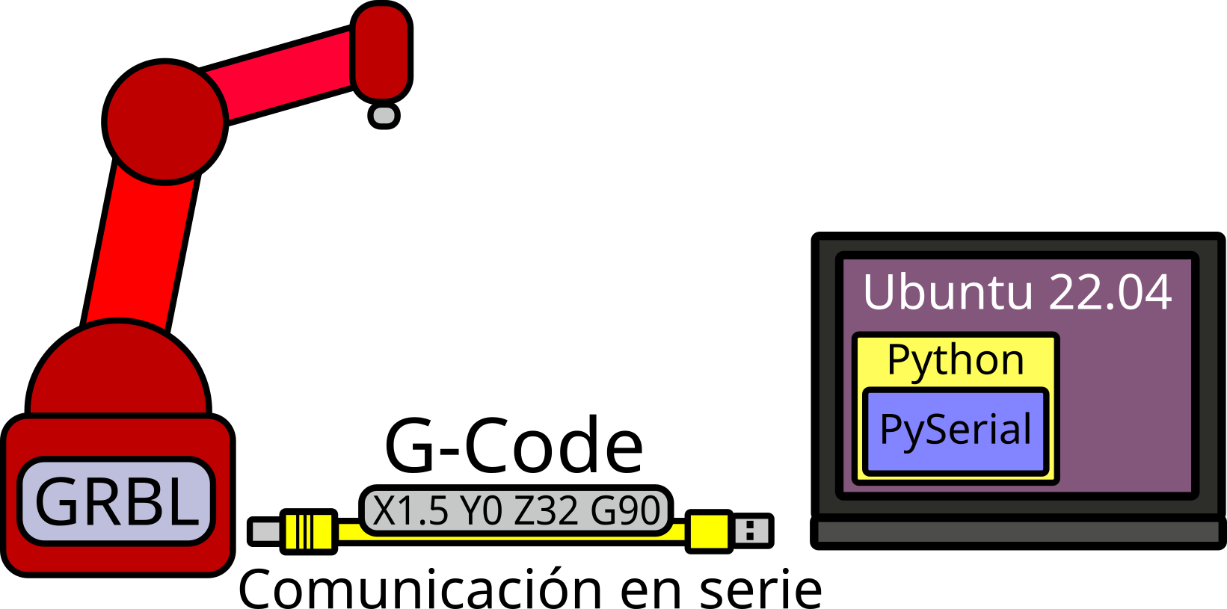
[picture p63: latex/Presentacion/figs/coms.png]
  
\end{figure}
\end{frame}

\begin{frame}
\frametitle{Integración con ROS 2}
\begin{table}[htbp]
  \centering
  \begin{tabular}{ccccc}
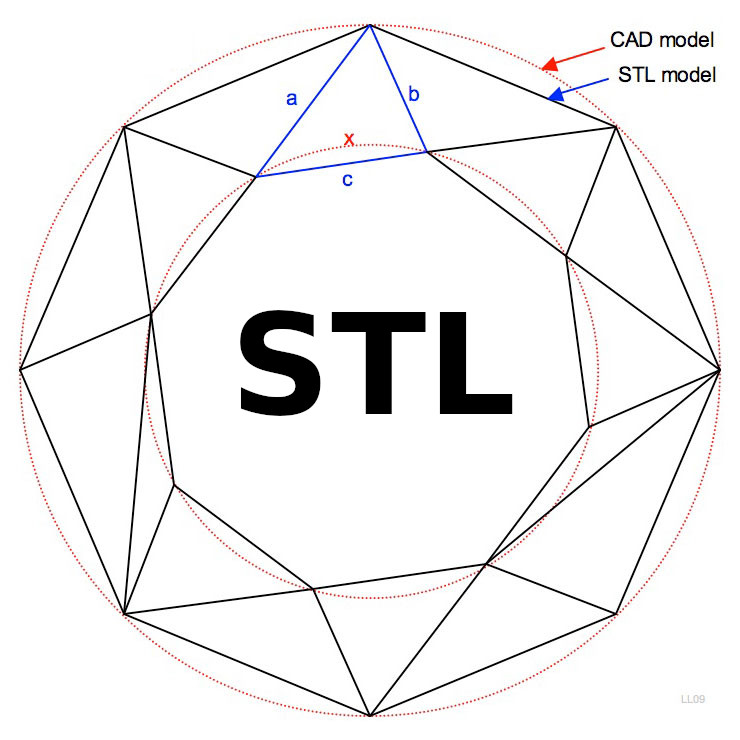
[picture p64: latex/Presentacion/figs/STL.jpg]
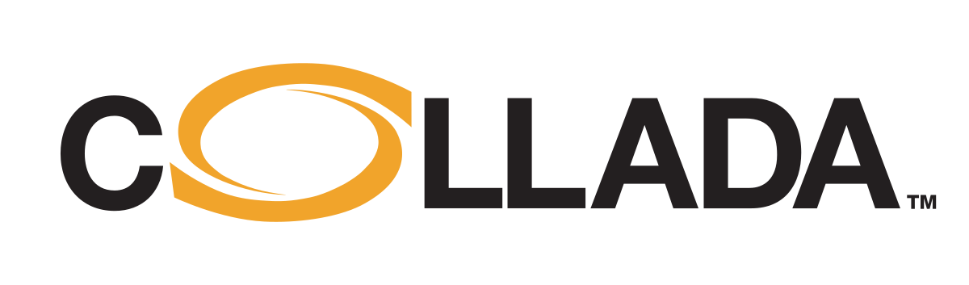
[picture p65: latex/Presentacion/figs/collada.png]
       &  &  
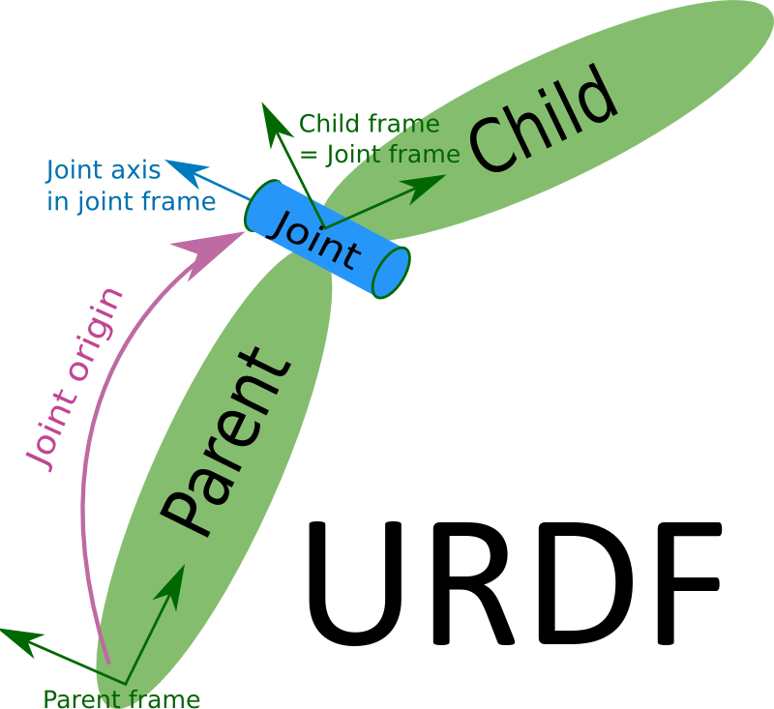
[picture p66: latex/Presentacion/figs/urdf.png]
       &  &  \\
      
  \end{tabular}
\end{table} 
\begin{figure}[h]
  
\centering
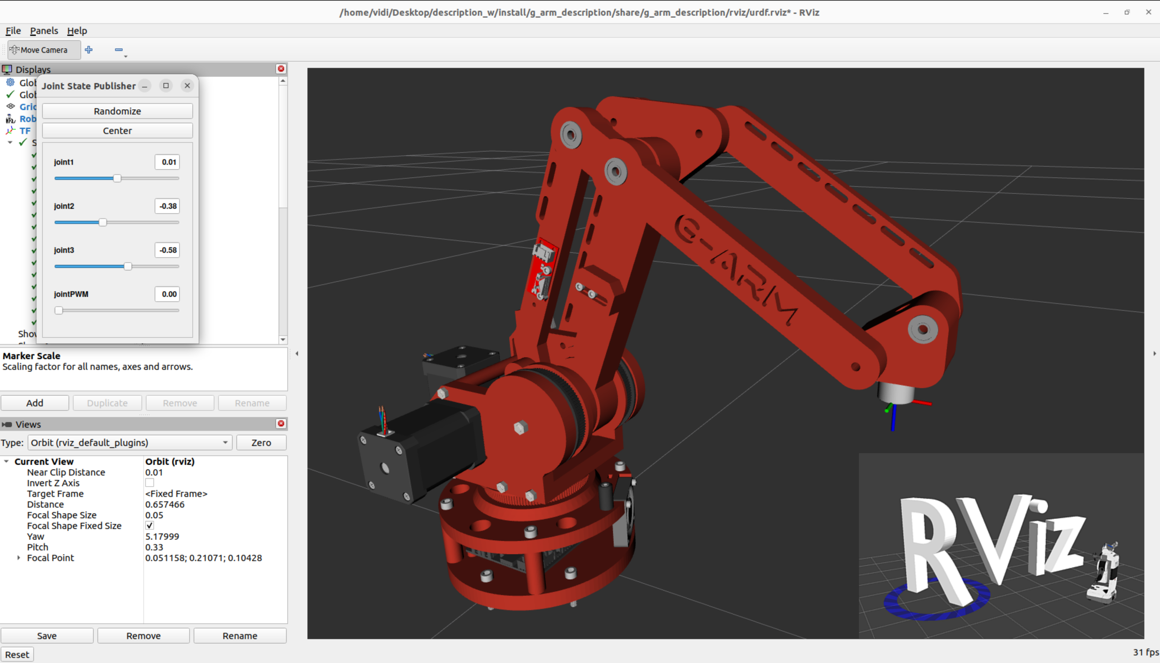
[picture p67: latex/Presentacion/figs/rviz.png]

\end{figure}  
\end{frame}

\begin{frame}
\frametitle{Integración con MoveIt 2}
\begin{table}[htbp]
  \centering
  \begin{tabular}{cc}
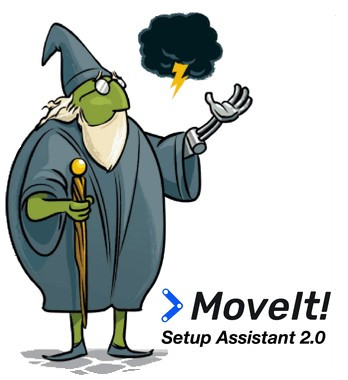
[picture p68: latex/Presentacion/figs/setup_assistant.jpg]
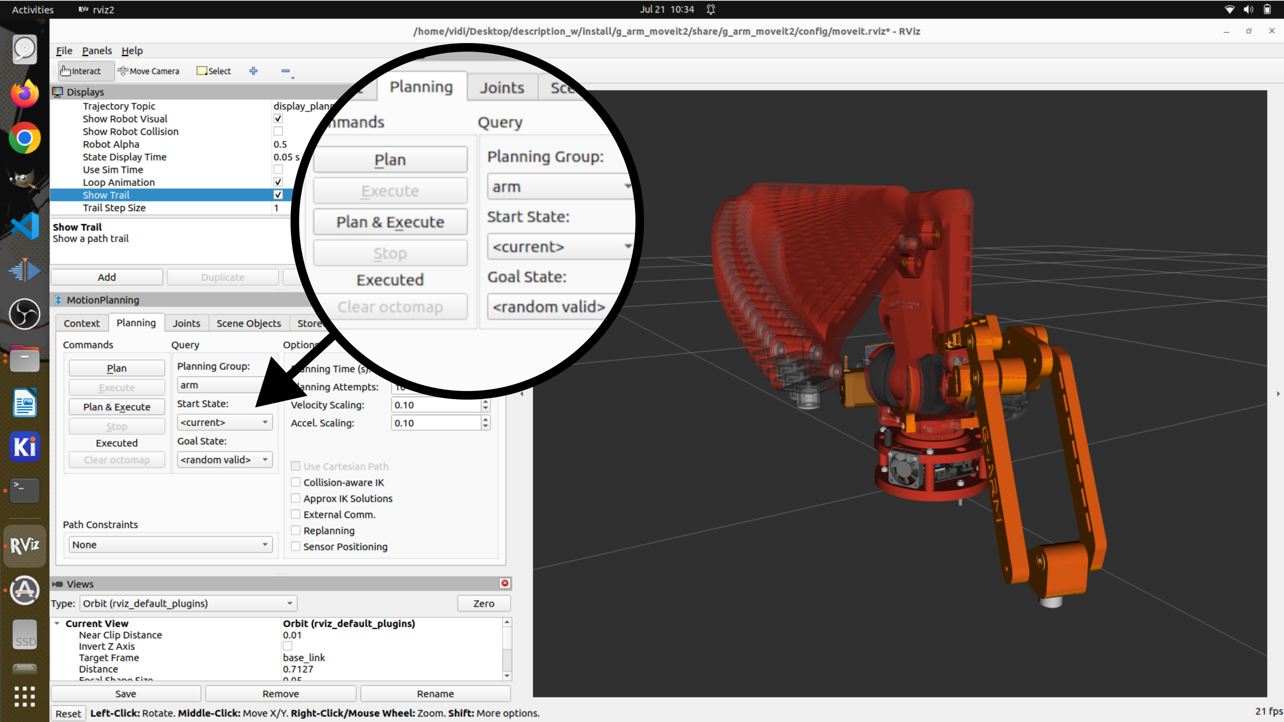
[picture p69: latex/Presentacion/figs/moveit_demo_trajectory.png]
       &  
  \end{tabular}
\end{table}  
\end{frame}

\begin{frame}
\frametitle{Herramientas disponibles a día de hoy}
\begin{table}[htbp]
  \centering
  \begin{tabular}{cc}
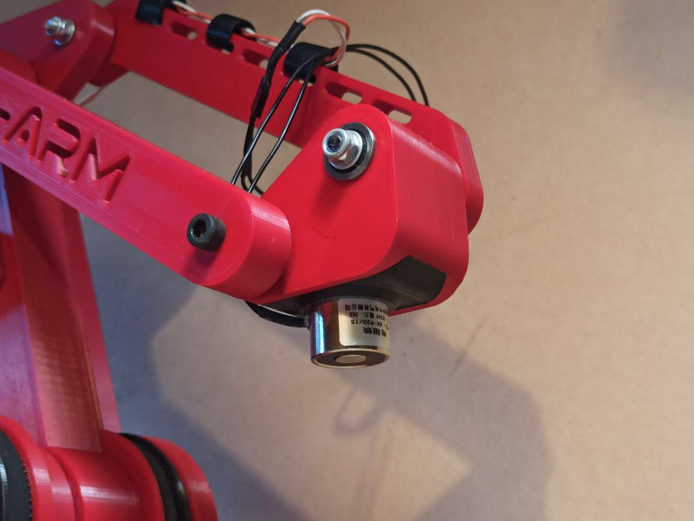
[picture p70: latex/Presentacion/figs/electromagnet_tool.JPEG]
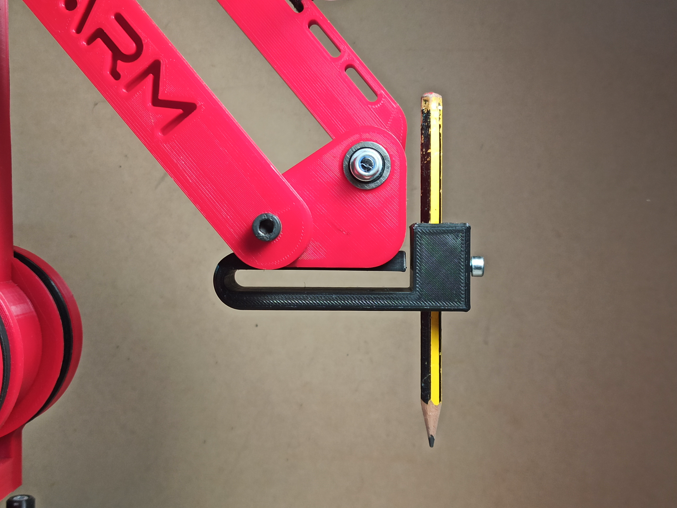
[picture p71: latex/Presentacion/figs/pen_tool.jpg]
       &   \\
      Electroimán & Porta lápices/bolígrafos
  \end{tabular}
\end{table}  
\end{frame}

\section*{}
\begin{frame}{}
  \centering \Huge
  \emph{Pruebas técnicas}
\end{frame}
\section{Pruebas técnicas}
\begin{frame}
  \frametitle{Capacidad de carga}
  \begin{columns}
    \begin{column}{0.35\textwidth} % Columna izquierda para la imagen
      
    \end{column}
    \begin{column}{0.5\textwidth} % Columna derecha para la tabla
      Tres escenarios distintos:
      \begin{itemize}
        \item 1: Completamente extendido.
        \item 2: Parcialmente retraído.
        \item 3: Fuerza del electroimán.
      \end{itemize}
      \begin{table}[H]
        \begin{center}
        \begin{tabular}{|c|c|}
        \hline
        \textbf{Escenario} & \textbf{Carga máxima} \\
        \hline
        Escenario 1& \SI{365}{\gram} \\
        Escenario 2 & \SI{480}{\gram} \\
        Escenario 3 & \SI{305}{\gram} \\
        \hline
        \end{tabular}
        \end{center}
        \end{table}
    
      \end{column}
  \end{columns}
\end{frame}

\begin{frame}
  \frametitle{Velocidad máxima}
  \begin{columns}
    \begin{column}{0.35\textwidth} % Columna izquierda para la imagen
      
    \end{column}
    \begin{column}{0.5\textwidth} % Columna derecha para la tabla
      
      \begin{itemize}
        \item Velocidad máxima de la base: 225º/s
        \item Velocidad máxima de los otros dos grados de libertad: 120º/s
      \end{itemize}

      Por debajo, pero no mucho, de un ABB IRB120 de 20.000\euro, que ronda los 
      250º/s.
      \end{column}
  \end{columns}
\end{frame}

\begin{frame}
  \frametitle{Consumo eléctrico}
  \begin{columns}
    \begin{column}{0.35\textwidth} % Columna izquierda para la imagen
      
    \end{column}
    \begin{column}{0.5\textwidth} % Columna derecha para la tabla
      
      Tres escenarios distintos:
      \begin{itemize}
        \item 1: Movimientos lentos.
        \item 2: Movimientos rápidos.
        \item 3: Robot inmóvil.
      \end{itemize}
      \begin{table}[H]
        \begin{center}
        \begin{tabular}{|c|c|}
        \hline
        \textbf{Escenario} & \textbf{Consumo medio}\\
        \hline
        Escenario 1 & 14.4W\\
        Escenario 2 & 17W\\
        Escenario 3 & 6.8W\\
        \hline
        \end{tabular}
        \end{center}
        \end{table}
      \end{column}
  \end{columns}
\end{frame}

\section*{}
\begin{frame}{}
  \centering \Huge
  \emph{Conclusiones}
\note[item]{Para acabar esta presentación, vamos a repasar lo hecho, unas breves conclusiones y las líneas futuras.}
\end{frame}

\section{Conclusiones}

\begin{frame}
\begin{block}{Objetivos cumplidos}
\begin{itemize}
\item Coste de fabricación completo inferior a 200\euro\xspace(aprox. \textcolor{blue}{171\euro})
\item Más del 80\% del robot está impreso en 3D.
\item Consumo inferior a 25 vatios.
\item Es \textcolor{blue}{portable} y tiene un tamaño ideal para usarse sobre cualquier mesa.
\item Supera la capacidad de carga propuesta de 300g.
\item Es simple de montar y es reproducible en \textcolor{blue}{cualquier impresora 3D}.
\item Se ha realizado una integración completa en \textcolor{blue}{ROS 2} y \textcolor{blue}{MoveIt2}.
\end{itemize}
\end{block}
\end{frame}

\begin{frame}
\begin{block}{Líneas futuras}
  \begin{itemize}
  \item Añadir un \textcolor{blue}{cuarto grado de libertad} para rotar piezas en el plano XY.
  \item Crear más herramientas para aumentar así sus posibilidades.
  \item Integrar este robot en la asignatura de Robótica Industrial (\textcolor{blue}{Anexo II}).
  \item Crear un \textcolor{blue}{firmware específico} para controlarlo a más bajo nivel.
  \end{itemize}
  \end{block}
\end{frame}

\begin{frame}[plain]
\large{\titlepage}
\note[item]{Y hasta aquí mi exposición.}
\note[item]{Quedo a disposición del tribunal...}
\end{frame}

\end{document}
