RoboticsURJC/tfg-vperez/latex/Memoria/anexos.tex

\input{estilo.tex} % archivo de configuraci�n de estilo

\makeindex

\begin{document}

\setcounter{page}{1}

\input{capitulos/anexoi}

\input{capitulos/anexoii}

\clearpage
\thispagestyle{empty}

\printindex \nocite{*}
\appendix

\end{document}
