RoboticsURJC/tfg-vperez/latex/Memoria/portada/portada.tex

\thispagestyle{empty}
\vspace{2cm}

\begin{figure}[htb]
  \centerline{\resizebox{.60\textwidth}{!}{}}
\end{figure}

\begin{center}
  {\Large {\bf GRADO EN INGENIERÍA DE ROBÓTICA SOFTWARE}}
  \vspace{5mm}
 
  {\large {Escuela de Ingeniería de Fuenlabrada}}
  \vspace{5mm}

  {\large {Curso académico 2023-2024}}

  \vspace{1cm}

  {\large {\bf Trabajo Fin de Grado}}

  \vspace{2cm}

  {\Large {Brazo robótico de bajo coste para la docencia universitaria  \\[1cm] }}

  \vspace{5cm}
  {\bf Tutor}: Julio Vega Pérez \\
  {\bf Autor}: Vidal Pérez Bohoyo
\end{center}

\clearpage
\thispagestyle{empty}
