RoboticsURJC/tfg-vperez/latex/Memoria/portada/acronimos.tex

\cleardoublepage

\chapter*{Acrónimos\markboth{Acrónimos}{Acrónimos}}

% Añade a continuación los acrónimos que uses en el documento. Algunos ejemplos:
\begin{acronym}
	\acro{DOF}{\emph{Degrees Of Freedom}}
	\acro{STEM}{\emph{Science, Technology, Engineering and Mathematics}}
	\acro{DIY}{\emph{Do It by Yourself}}
	\acro{CAD}{\emph{Computer-Aided Design}}
	\acro{FDM}{\emph{Fused Deposition Modeling}}
	\acro{ROS}{\emph{Robot Operating System}}
	\acro{CNC}{\emph{Control Numérico por Computadora}}
	\acro{PWM}{\emph{Pulse Width Modulation}}
	\acro{DDS}{\emph{Data Distribution Service}}
	\acro{SCARA}{\emph{Selective Compilant Assembly Robot Arm}}
	\acro{URDF}{\emph{Unified Robot Description Format}}
	\acro{XML}{\emph{eXtensible Markup Language}}
	\acro{UART}{\emph{Universal Asynchronous Receiver/Transmitter}}
	\acro{STL}{\emph{Standard Tessellation Language}}
\end{acronym}
