RoboticsURJC/tfg-vperez/latex/Memoria/portada/dedicatoria.tex

\begin{verse}
\begin{flushright}
\vspace*{3cm}
\textit{A mi familia\\ 
	(biológica y\\
	 política).}
\end{flushright}
\end{verse}
