RoboticsURJC/tfg-vperez/latex/Memoria/memoria.tex

\input{estilo.tex} % archivo de configuraci�n de estilo

\makeindex

\begin{document}
\baselineskip 1.35\baselineskip

\frontmatter

\input{portada/indice.tex} % aqu� se cargan todas las "primeras p�ginas"

% Bibliograf�a
\let\OLDthebibliography=\thebibliography
\def\thebibliography#1{\OLDthebibliography{#1}
  \addcontentsline{toc}{chapter}{\bibname}}

\mainmatter

\setcounter{page}{1}
\input{capitulos/capitulo1}

\input{capitulos/capitulo2}

\input{capitulos/capitulo3}

\input{capitulos/capitulo4}

\input{capitulos/capitulo5}

\input{capitulos/capitulo6}

\input{capitulos/capitulo7}

\clearpage
\thispagestyle{empty}

\printindex \nocite{*}
\appendix
\bibliographystyle{apalike} \bibliography{bibliografia}

\end{document}
