RoboticsURJC/tfg-vperez/latex/Memoria/portada/resumen.tex

\cleardoublepage

\chapter*{Resumen\markboth{Resumen}{Resumen}}
\noindent La robótica ---disciplina enfocada en el diseño, construcción y programación de robots--- se compone de 
diversas ramas entre las cuales interesa destacar la robótica educativa, caracterizada por 
ofrecer robots útiles para el aprendizaje, y 
la robótica de bajo coste, campo de estudio que busca superar las barreras 
económicas que presentan los robots tradicionales para garantizar que todo el mundo 
pueda acceder a esta tecnología, ambas ramas estrechamente relacionadas con este proyecto.

Los robots usados comúnmente en las universidades son realmente costosos, por lo que 
es complicado adquirir una gran cantidad de ellos, limitando su disponibilidad. Es por esto que 
en este trabajo se ha desarrollado una solución para este problema. Concretamente, se ha desarrollado 
un brazo robótico industrial de bajo coste que puede ser fabricado mediante cualquier impresora 3D convencional.

El modelo 3D se ha desarrollado con la herramienta de diseño 3D FreeCAD, por ser de código abierto. Por 
otro lado, el hardware empleado es fácilmente adquirible a través de internet, lo que ha permitido 
desarrollar el robot de manera accesible y económica. 

El robot final ha sido integrado en ROS 2 Humble, un \textit{middleware} de código abierto ampliamente 
utilizado en aplicaciones robóticas. Esta integración ha proporcionado una interfaz 
estandarizada y eficiente para que cualquier aplicación desarrollada en este ecosistema pueda hacer uso de él. Además, 
ha sido configurado para utilizarse en el \textit{framework} MoveIt 2, lo que facilita aún más su uso.

Con la combinación de estas herramientas y tecnologías, se ha logrado desarrollar un robot altamente 
funcional y resistente, preparado para utilizarse en un entorno académico formando a nuevas generaciones. El 
resultado obtenido representa un esfuerzo de investigación y desarrollo significativo, que abre la puerta a futuras 
mejoras y avances en el campo de la robótica.

Finalmente, se han realizado numerosas pruebas que evalúan los distintos aspectos técnicos que 
definen el rendimiento y características del robot final.
