RoboticsURJC/tfg-vperez/latex/Presentacion/slides.pdf

# Brazo robótico de bajo coste para la docencia universitaria

# Vidal Pérez Bohoyo

### v.perezb.2019@alumnos.urjc.es

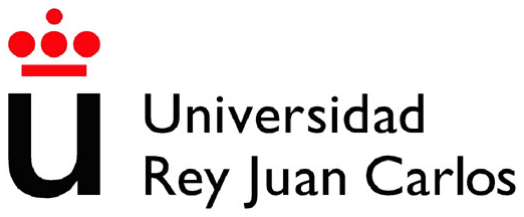
[picture p153: figure]

### Trabajo fin de grado

xx de xxxxxxx de 20xx

(CC) Vidal Pérez Bohoyo

Este trabajo se entrega bajo licencia CC BY-NC-SA. (https://creativecommons.org/licenses/by-nc-sa/3.0/es/) Usted es libre de (a) compartir: copiar y redistribuir el material en cualquier medio o formato; y (b) adaptar: remezclar, transformar y crear a partir del material. El licenciador no puede revocar estas libertades mientras cumpla con los términos de la licencia.

Vidal Pérez Bohoyo (URJC) | Brazo robótico de bajo coste | xx de xxxxxxx de 20xx | 2 / 26

# Contenidos

1 | Introducción
2 | Plataforma de desarrollo
3 | Desarrollo hardware
4 | Desarrollo software
5 | Conclusiones
Vidal Pérez Bohoyo (URJC) | Brazo robótico de bajo coste | xx de xxxxxxx de 20xx | 3 / 26

# Introducción

Vidal Pérez Bohoyo (URJC) | Brazo robótico de bajo coste | xx de xxxxxxx de 20xx | 4 / 26

Introducción Contexto general

# Robótica industrial

Vidal Pérez Bohoyo (URJC) | Brazo robótico de bajo coste | xx de xxxxxxx de 20xx | 5 / 26

Introducción Contexto general

# Robótica educativa

Vidal Pérez Bohoyo (URJC) | Brazo robótico de bajo coste | xx de xxxxxxx de 20xx | 6 / 26

Introducción Contexto general

# Robótica de bajo coste

Vidal Pérez Bohoyo (URJC) | Brazo robótico de bajo coste | xx de xxxxxxx de 20xx | 7 / 26

Introducción Contexto general

# Situación de la Robótica

La tecnología está cada vez más presente en la vida cotidiana. Los robots de servicio aparecen en el mercado.
La domótica presenta cada vez más aplicaciones domésticas.
Vidal Pérez Bohoyo (URJC) | Brazo robótico de bajo coste | xx de xxxxxxx de 20xx | 8 / 26

Introducción Contexto específico

# Precedentes de la robótica

# Primera revolución industrial de 1800

Productos fabricados por máquinas. La máquina de vapor fue clave.

Vidal Pérez Bohoyo (URJC) | Brazo robótico de bajo coste | xx de xxxxxxx de 20xx | 9 / 26

# Objetivos

Vidal Pérez Bohoyo (URJC) | Brazo robótico de bajo coste | xx de xxxxxxx de 20xx | 10 / 26

# Descripción del problema

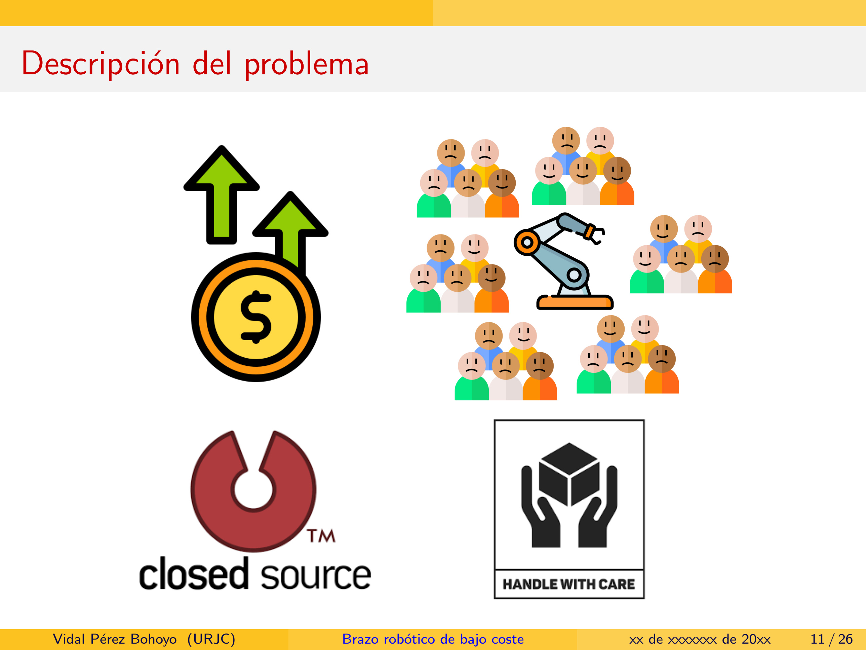
[picture p154: page 11]

Vidal Pérez Bohoyo (URJC) | Brazo robótico de bajo coste | xx de xxxxxxx de 20xx | 11 / 26

# Requisitos

1 | Coste inferior a 200e.
2 | En su mayoría impreso en 3D.
3 | Bajo consumo eléctrico, inferior a 25 vatios.
4 | Tamaño reducido.
5 | Sencillo de montar.
6 | Tener integración con ROS 2 y MoveIt 2.
Vidal Pérez Bohoyo (URJC) | Brazo robótico de bajo coste | xx de xxxxxxx de 20xx | 12 / 26

# Metodología

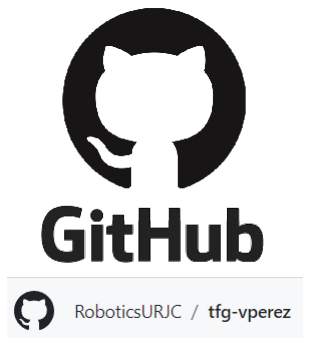
[picture p155: figure]

Vidal Pérez Bohoyo (URJC) | Brazo robótico de bajo coste | xx de xxxxxxx de 20xx | 13 / 26

# Plataforma de desarrollo

Vidal Pérez Bohoyo (URJC) | Brazo robótico de bajo coste | xx de xxxxxxx de 20xx | 14 / 26

Plataforma de desarrollo

# Software

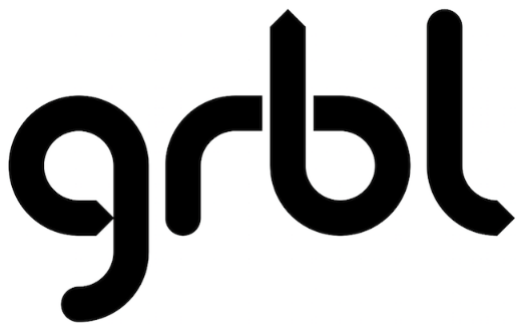
[picture p156: figure]
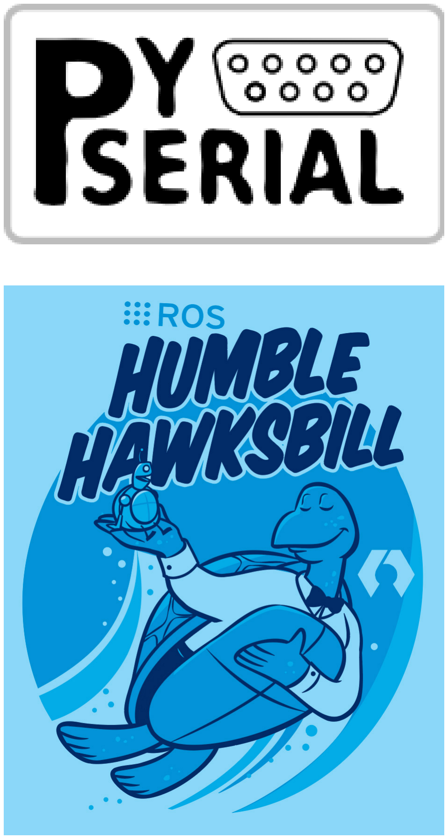
[picture p157: figure]
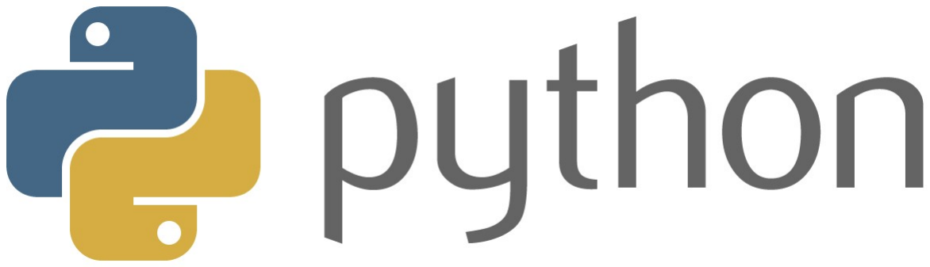
[picture p158: figure]
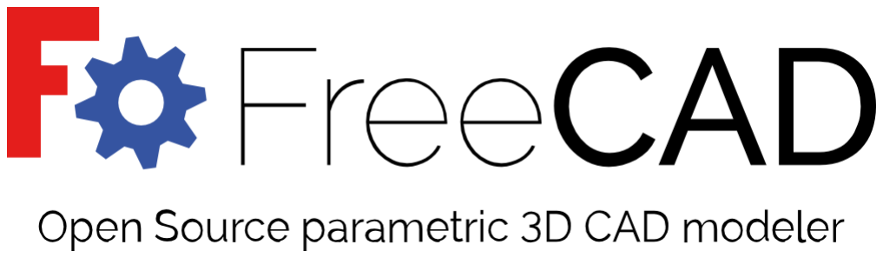
[picture p159: figure]
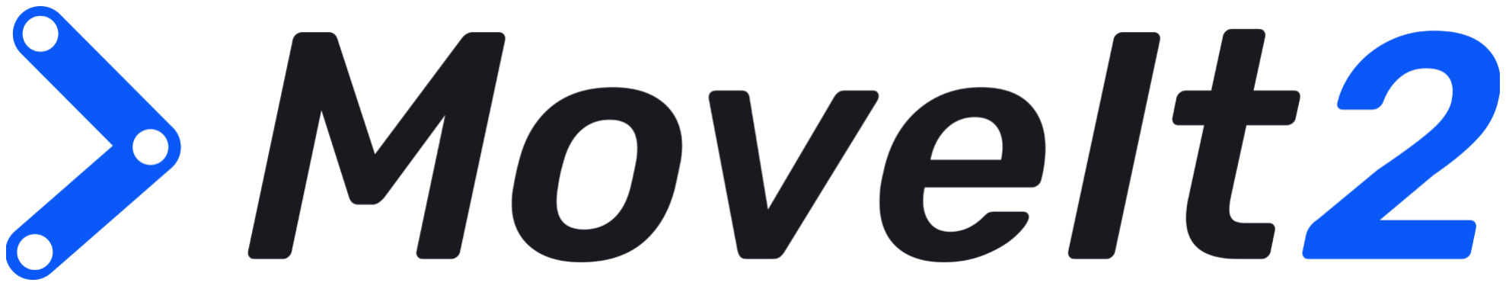
[picture p160: figure]

Vidal Pérez Bohoyo (URJC) | Brazo robótico de bajo coste | xx de xxxxxxx de 20xx | 15 / 26

Plataforma de desarrollo

# Hardware

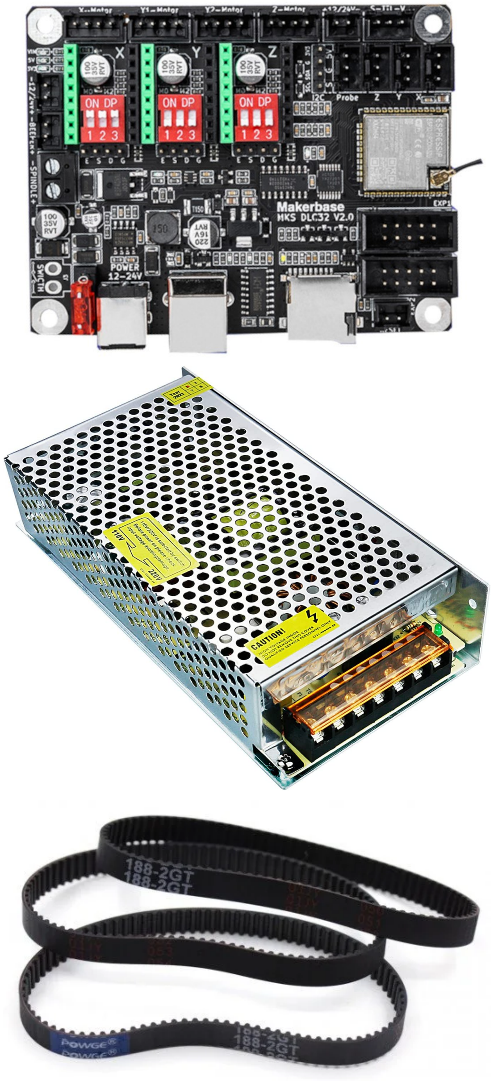
[picture p161: figure]
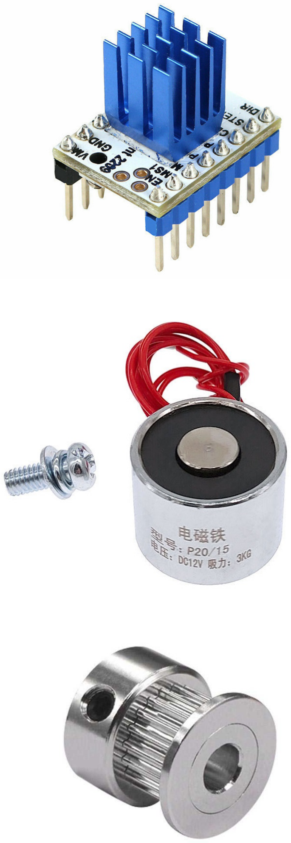
[picture p162: figure]
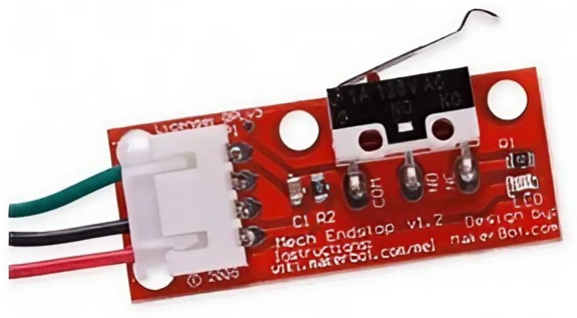
[picture p163: figure]

Vidal Pérez Bohoyo (URJC) | Brazo robótico de bajo coste | xx de xxxxxxx de 20xx | 16 / 26

# Desarrollo hardware

Vidal Pérez Bohoyo (URJC) | Brazo robótico de bajo coste | xx de xxxxxxx de 20xx | 17 / 26

# Desarrollo software

Vidal Pérez Bohoyo (URJC) | Brazo robótico de bajo coste | xx de xxxxxxx de 20xx | 18 / 26

Desarrollo software

# Grbl y comunicación con el ordenador

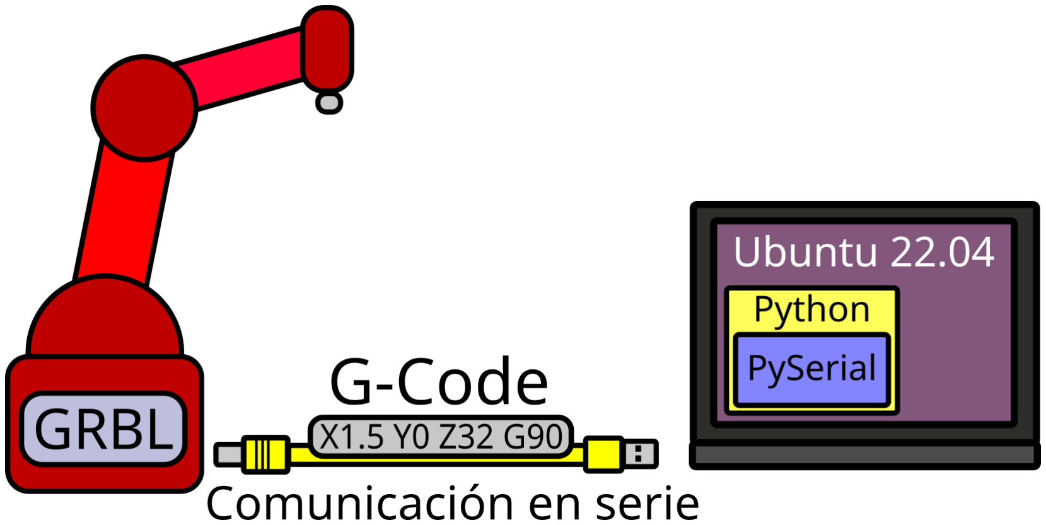
[picture p164: figure]

Vidal Pérez Bohoyo (URJC) | Brazo robótico de bajo coste | xx de xxxxxxx de 20xx | 19 / 26

# Integración con ROS 2

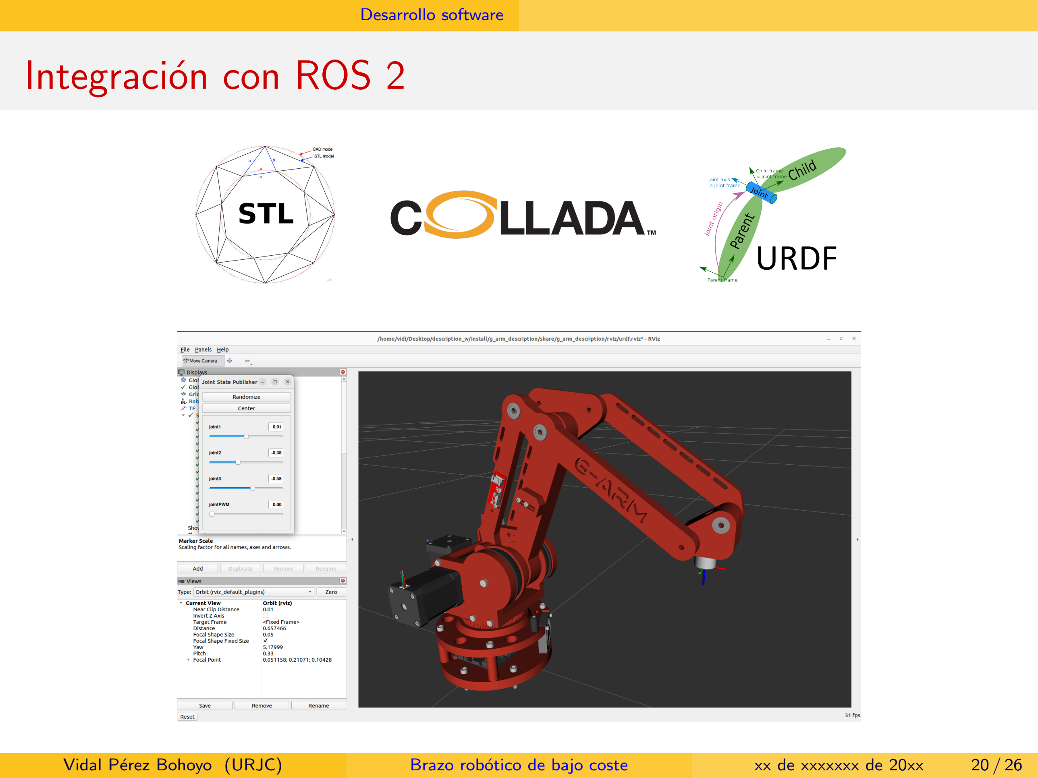
[picture p165: page 20]

Desarrollo software

Vidal Pérez Bohoyo (URJC) | Brazo robótico de bajo coste | xx de xxxxxxx de 20xx | 20 / 26

# Integración con MoveIt 2

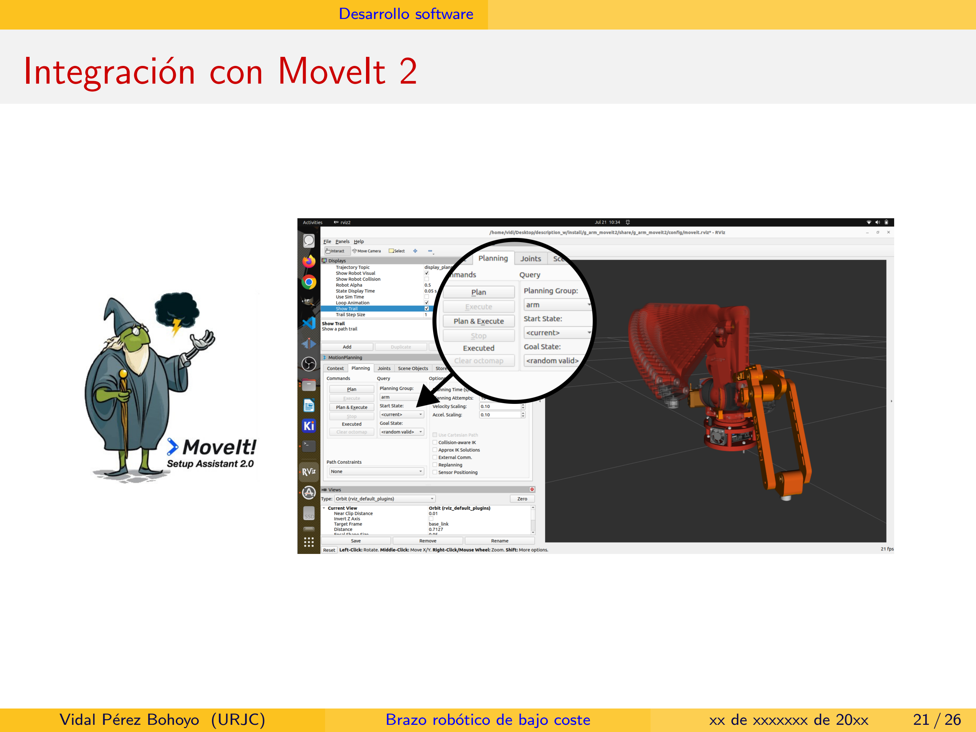
[picture p166: page 21]

Desarrollo software

Vidal Pérez Bohoyo (URJC) | Brazo robótico de bajo coste | xx de xxxxxxx de 20xx | 21 / 26

Desarrollo software

# Arquitectura software

Vidal Pérez Bohoyo (URJC) | Brazo robótico de bajo coste | xx de xxxxxxx de 20xx | 22 / 26

# Pruebas técnicas

Vidal Pérez Bohoyo (URJC) | Brazo robótico de bajo coste | xx de xxxxxxx de 20xx | 23 / 26

# Conclusiones

Vidal Pérez Bohoyo (URJC) | Brazo robótico de bajo coste | xx de xxxxxxx de 20xx | 24 / 26

Conclusiones

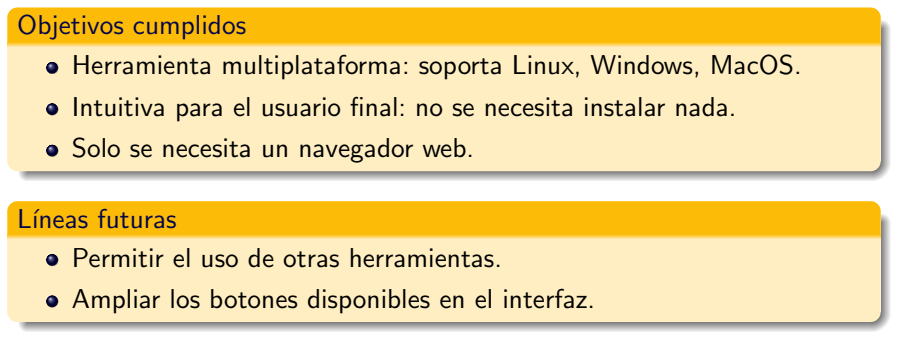
[picture p167: figure]
Objetivos cumplidos; Solo se necesita un navegador web.; Líneas futuras; Permitir el uso de otras herramientas.

Herramienta multiplataforma: soporta Linux, Windows, MacOS.

Intuitiva para el usuario final: no se necesita instalar nada.

Ampliar los botones disponibles en el interfaz.

Vidal Pérez Bohoyo (URJC) | Brazo robótico de bajo coste | xx de xxxxxxx de 20xx | 25 / 26

# Brazo robótico de bajo coste para la docencia universitaria

# Vidal Pérez Bohoyo

### v.perezb.2019@alumnos.urjc.es

### Trabajo fin de grado

xx de xxxxxxx de 20xx
