RoboticsURJC/tfg-vperez/img/ackerman.jpeg

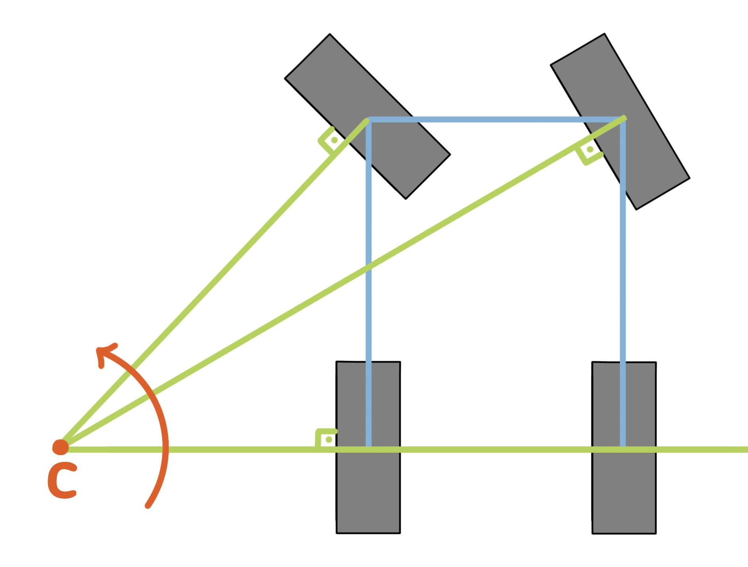
img/ackerman.jpeg
