RoboticsURJC/tfg-vperez/img/AckermanExplain.PNG

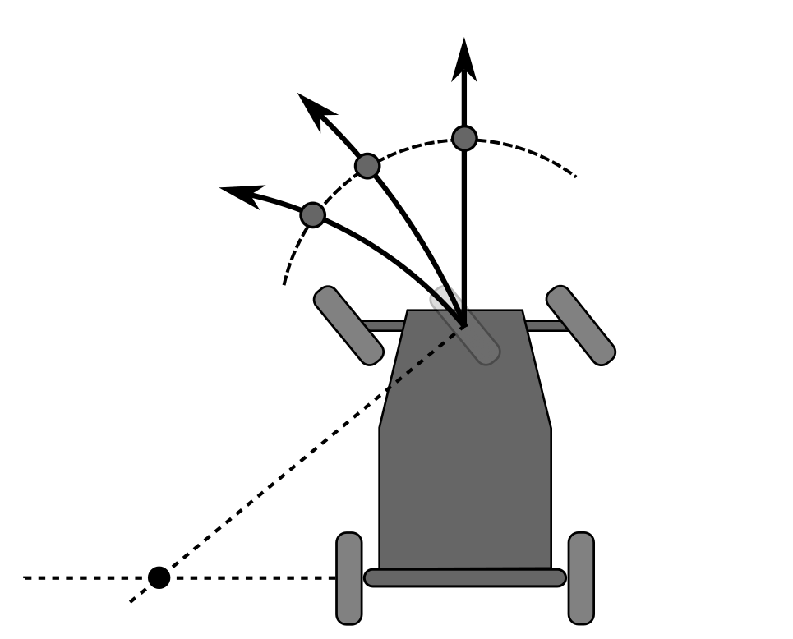
img/AckermanExplain.PNG
