RoboticsURJC/tfg-vperez/img/alambrico_garm.png

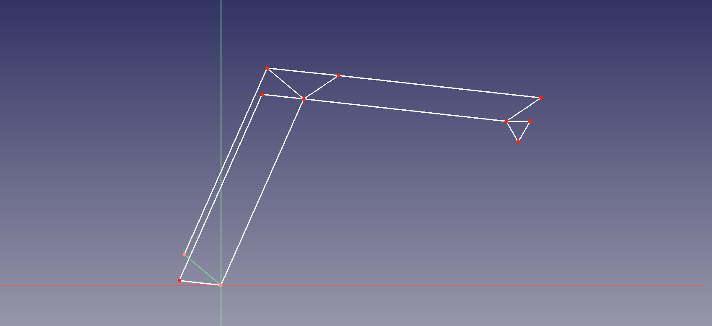
img/alambrico_garm.png
