RoboticsURJC/tfg-vperez/img/AprendiendoModeloAlambrico.gif

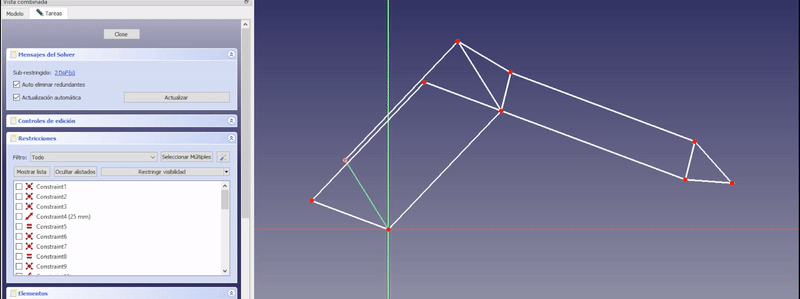
img/AprendiendoModeloAlambrico.gif
