RoboticsURJC/tfg-vperez/img/baseRedonda.png

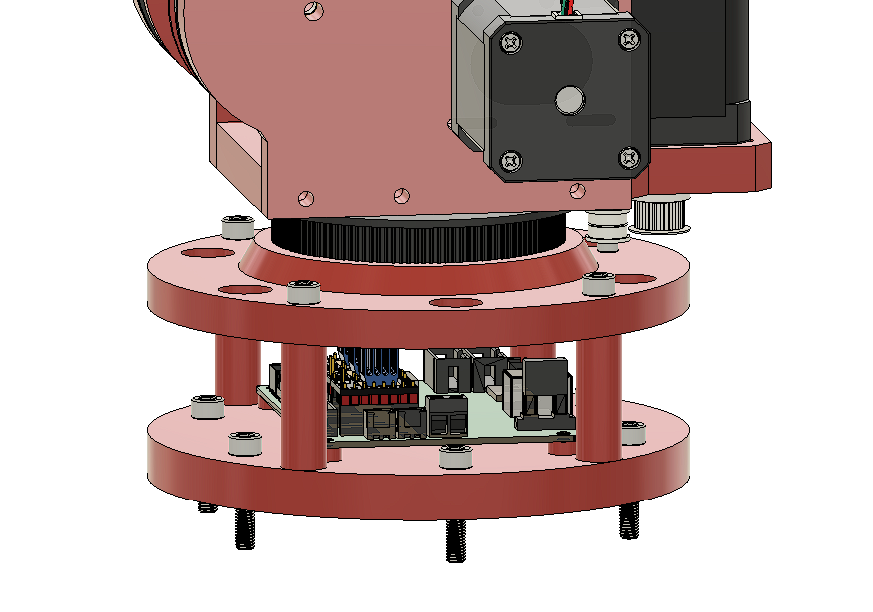
img/baseRedonda.png
