RoboticsURJC/tfg-vperez/img/bocetoManipulador.jpeg

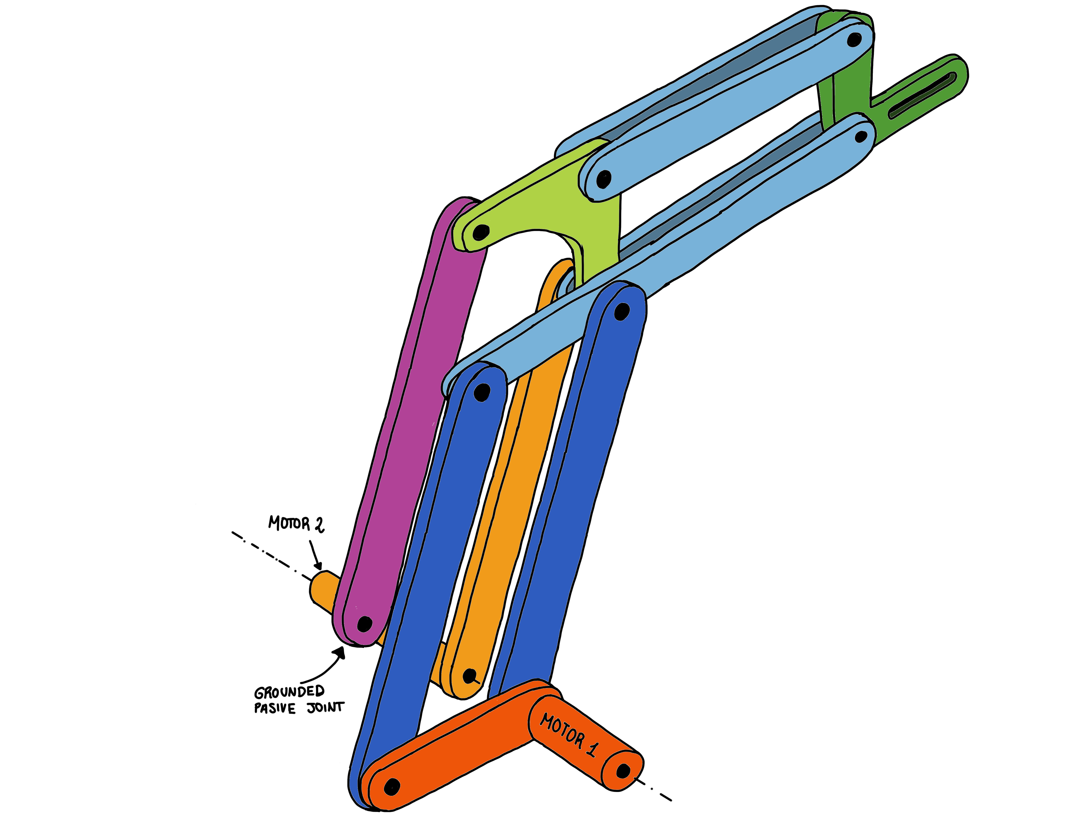
img/bocetoManipulador.jpeg
