RoboticsURJC/tfg-vperez/img/bocetoRealBase.jpg

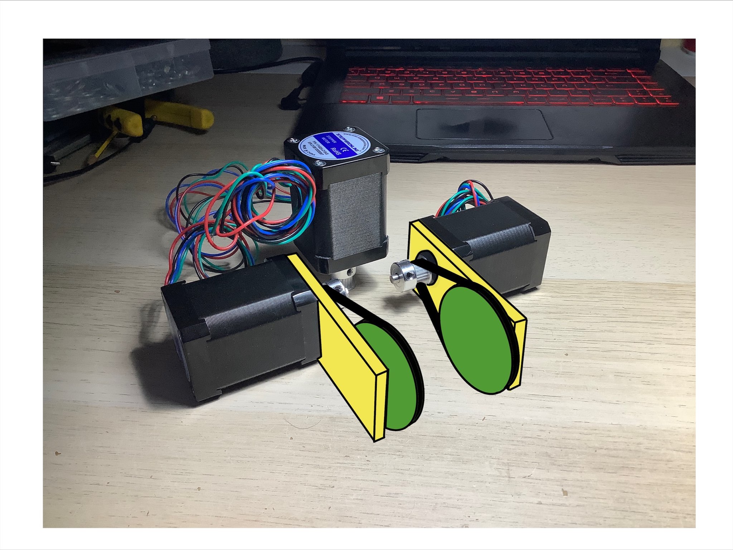
img/bocetoRealBase.jpg
