RoboticsURJC/tfg-vperez/img/childOrientation.PNG

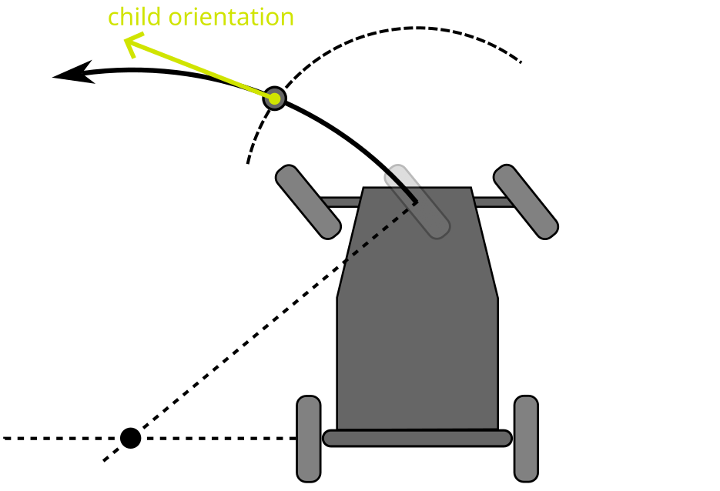
img/childOrientation.PNG
