RoboticsURJC/tfg-vperez/img/childs.jpg

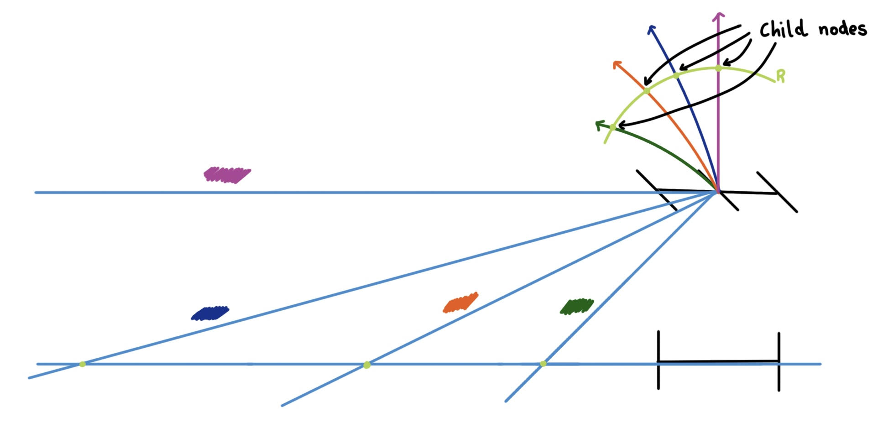
img/childs.jpg
