RoboticsURJC/tfg-vperez/img/closed-open_kinematics.jpg

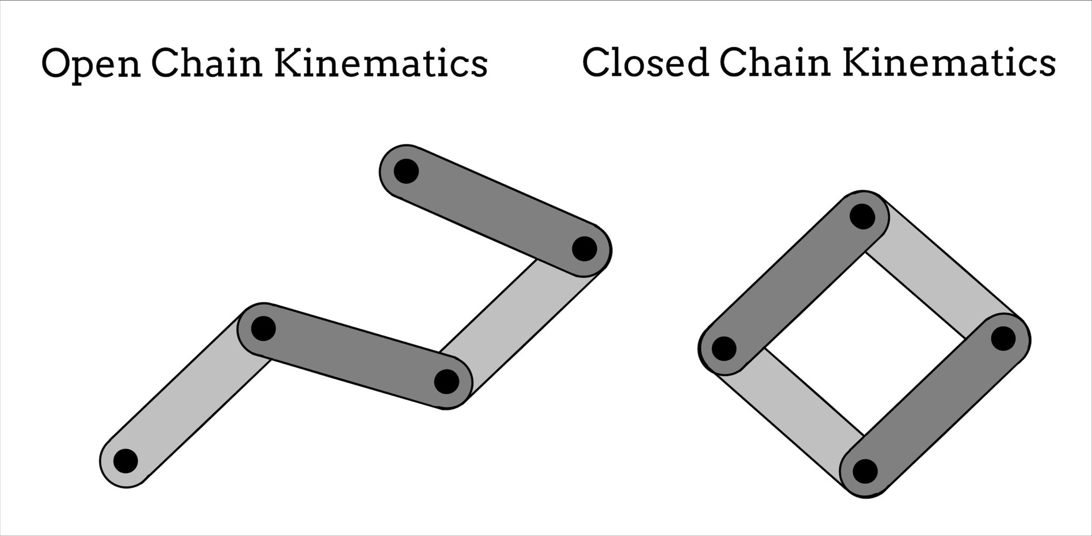
img/closed-open_kinematics.jpg
