RoboticsURJC/tfg-vperez/img/CNCShield.png

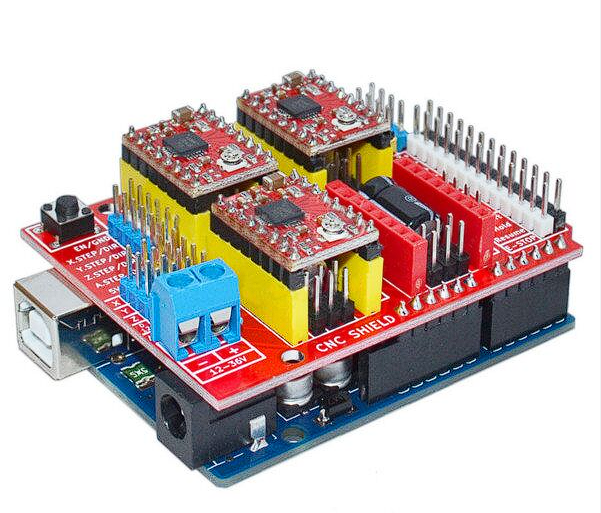
img/CNCShield.png
