RoboticsURJC/tfg-vperez/img/correaTensionExplicacion.jpg

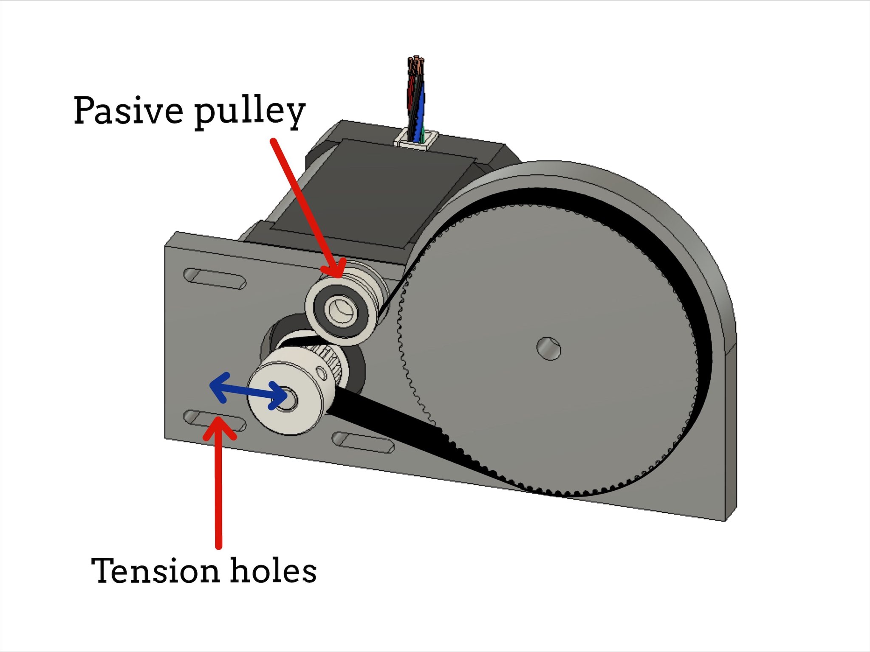
img/correaTensionExplicacion.jpg
