RoboticsURJC/tfg-vperez/img/DH_Joints.png

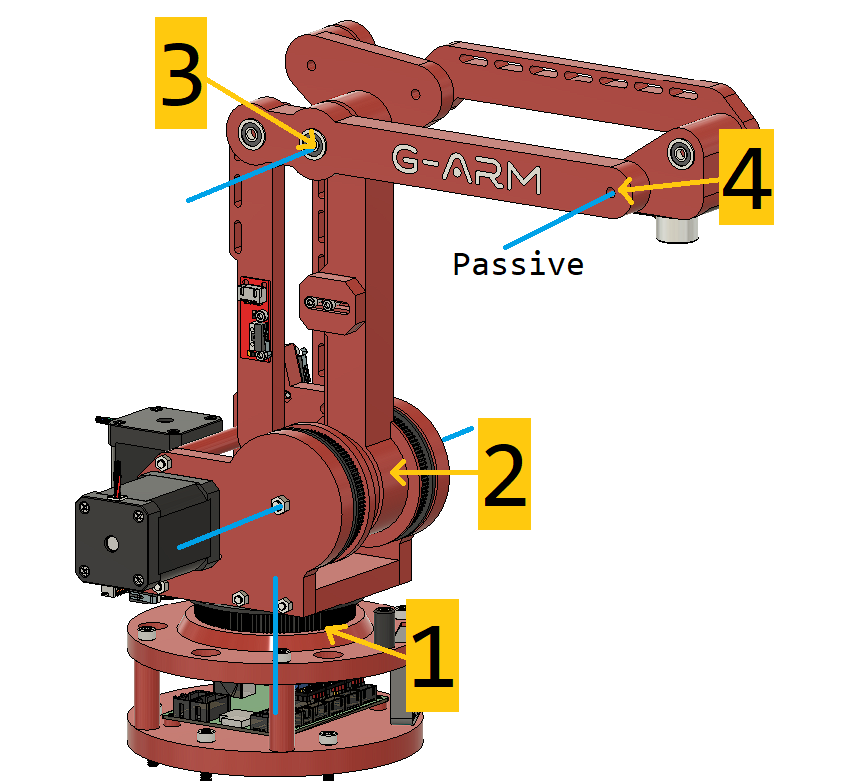
img/DH_Joints.png
