RoboticsURJC/tfg-vperez/img/DH_Links.png

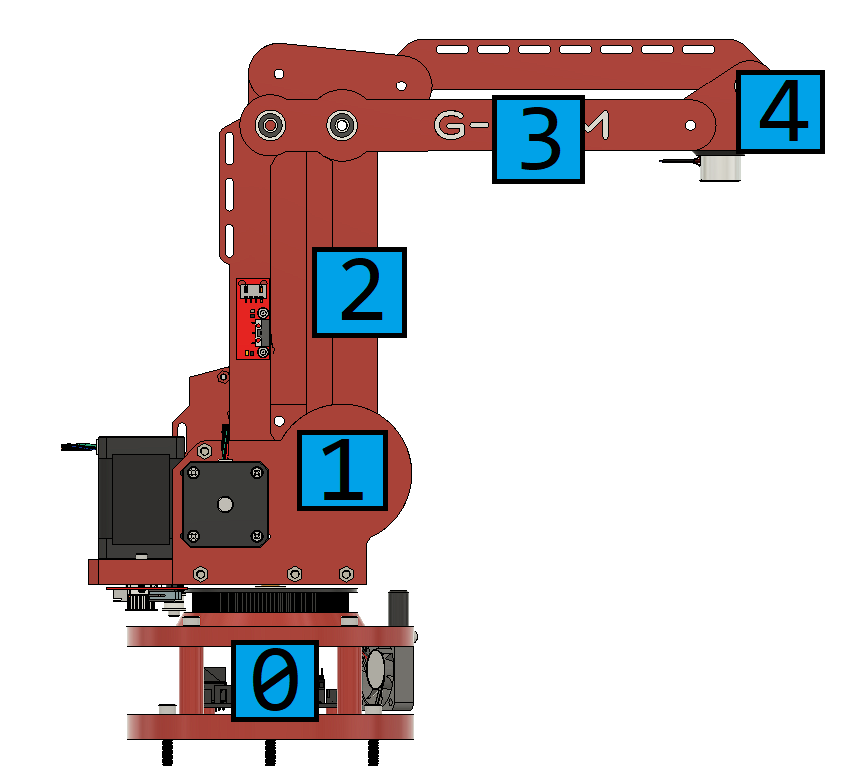
img/DH_Links.png
