RoboticsURJC/tfg-vperez/img/DH_Zero.png

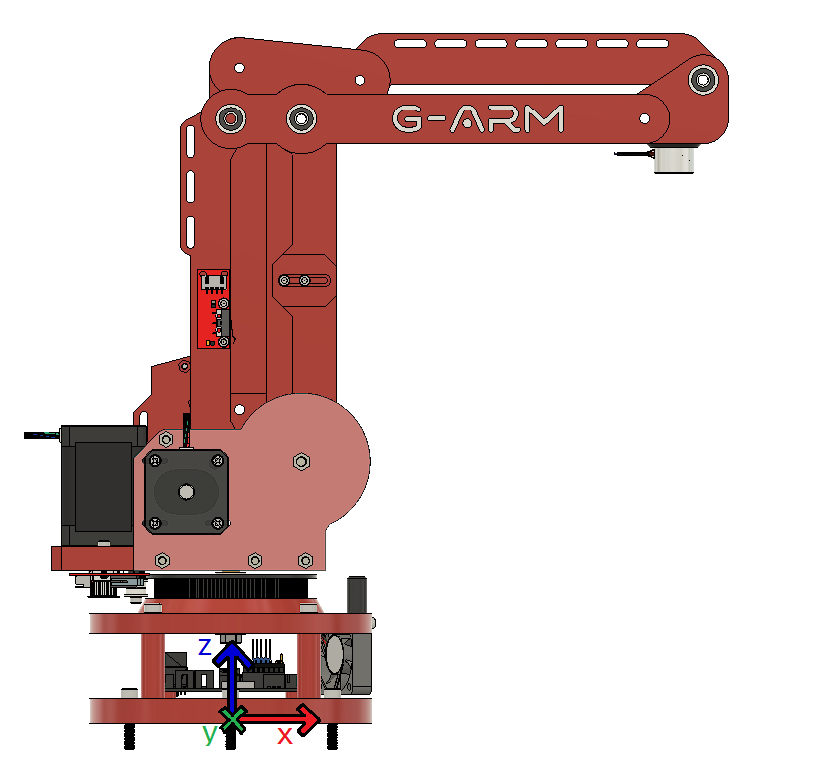
img/DH_Zero.png
