RoboticsURJC/tfg-vperez/img/dilema_Placa_abajo.png

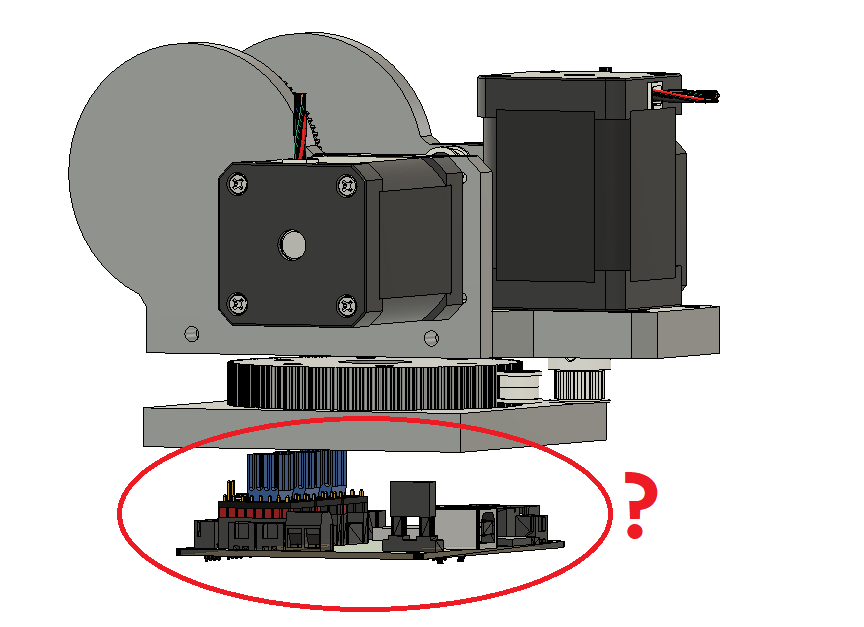
img/dilema_Placa_abajo.png
