RoboticsURJC/tfg-vperez/img/dilema_ventilador.png

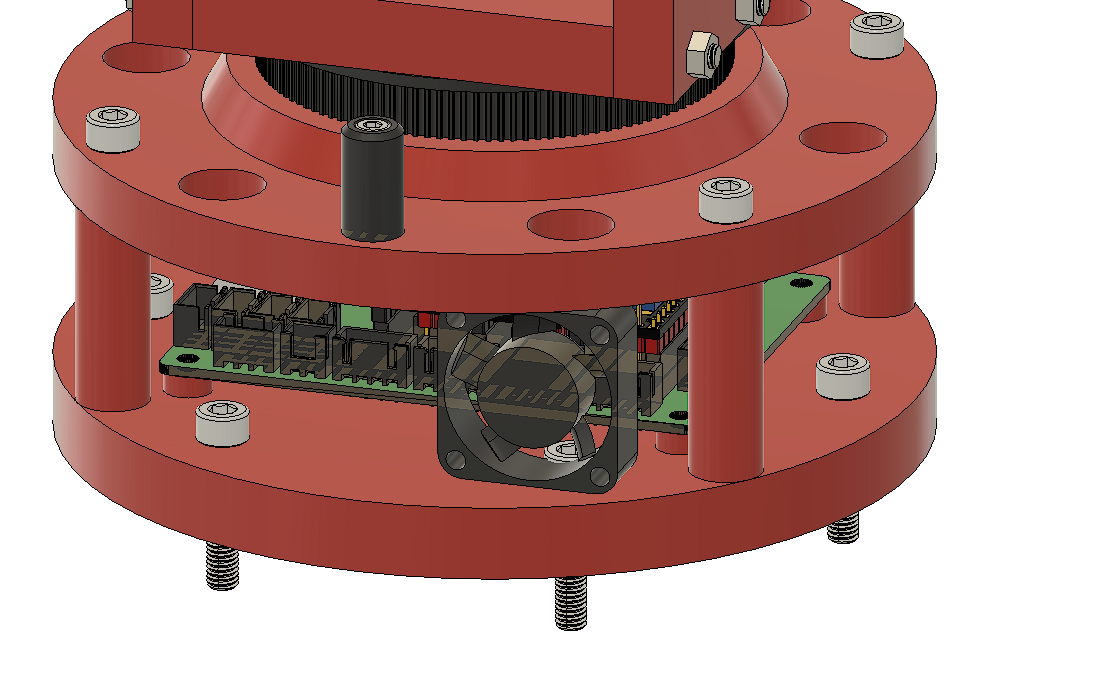
img/dilema_ventilador.png
