RoboticsURJC/tfg-vperez/img/DinamicModel.jpeg

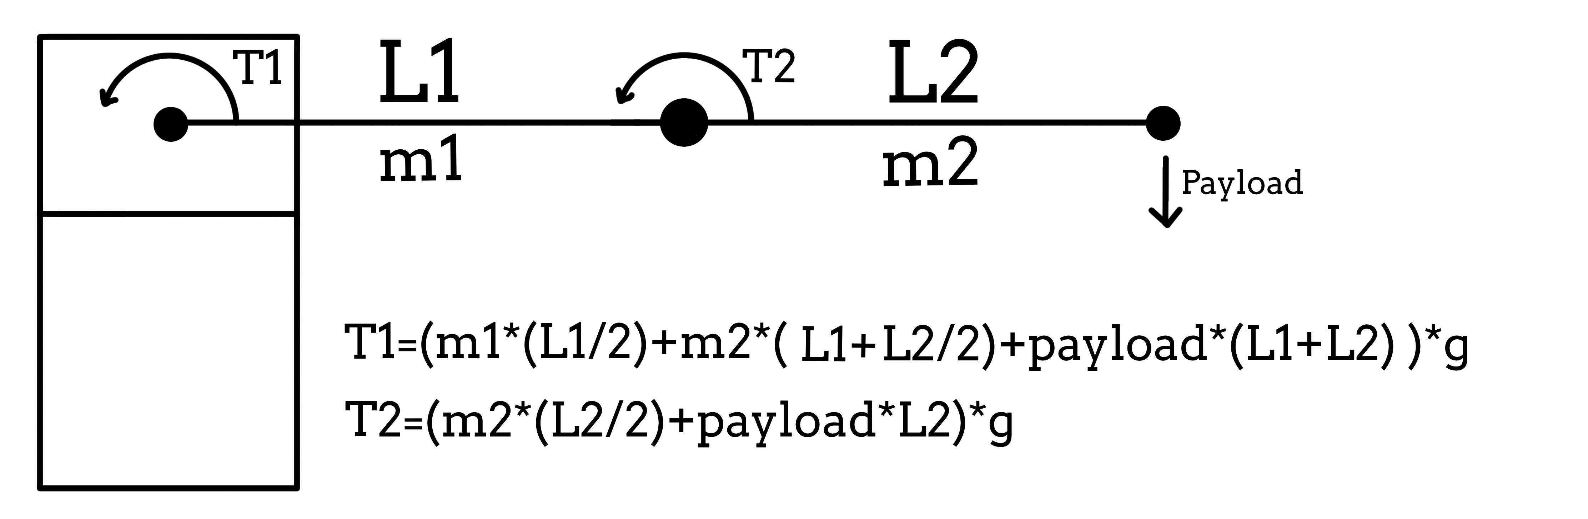
img/DinamicModel.jpeg
