RoboticsURJC/tfg-vperez/img/direct_kinematics.jpg

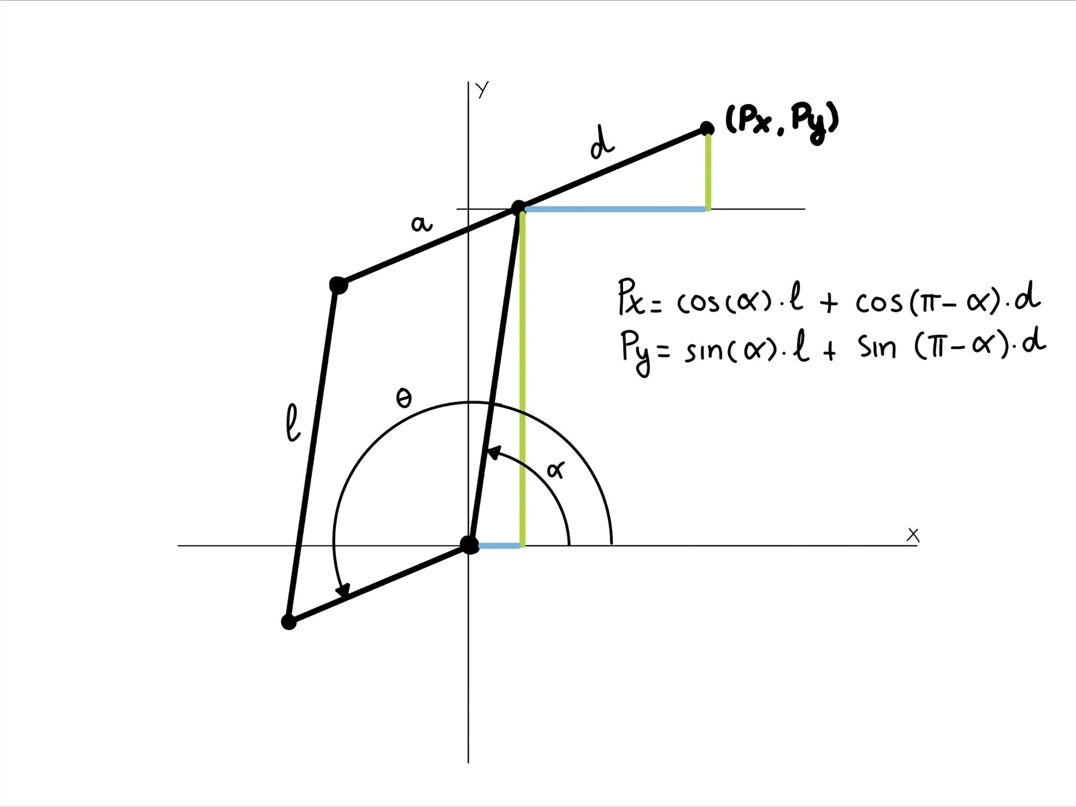
img/direct_kinematics.jpg
