RoboticsURJC/tfg-vperez/img/diseño_de_cables_link1link2.png

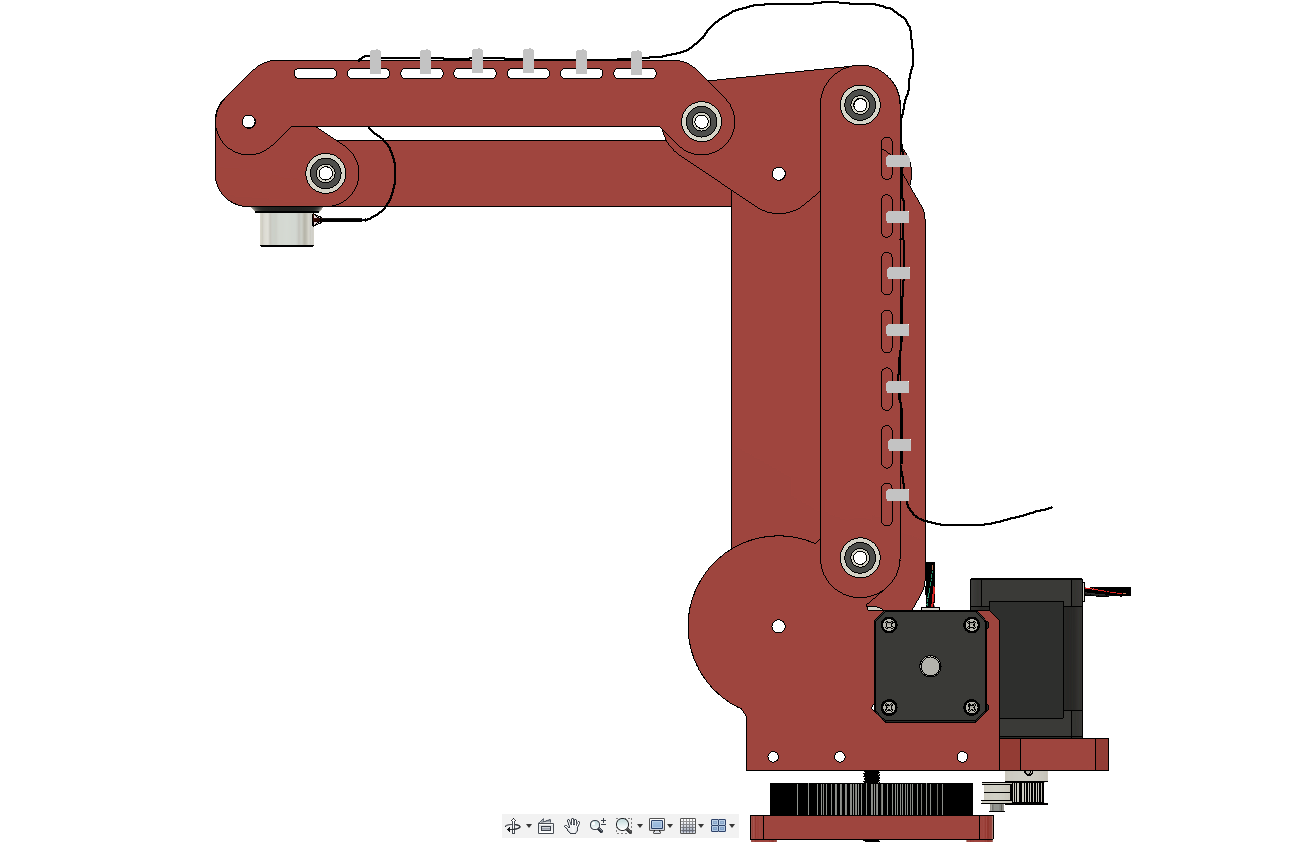
img/diseño_de_cables_link1link2.png
