RoboticsURJC/tfg-vperez/img/DisposicionMotores.png

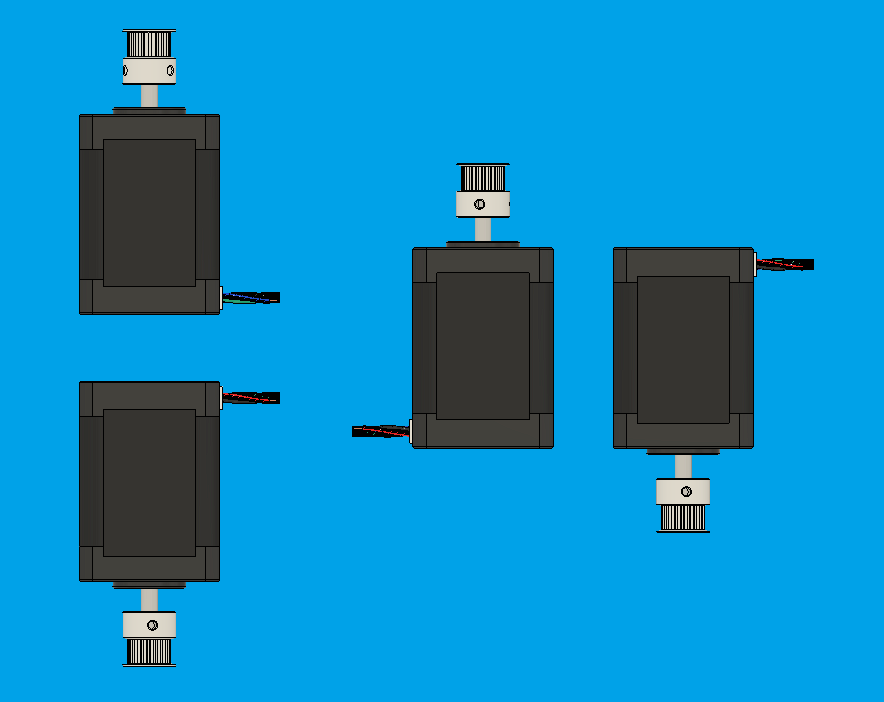
img/DisposicionMotores.png
