RoboticsURJC/tfg-vperez/img/drievrs.png

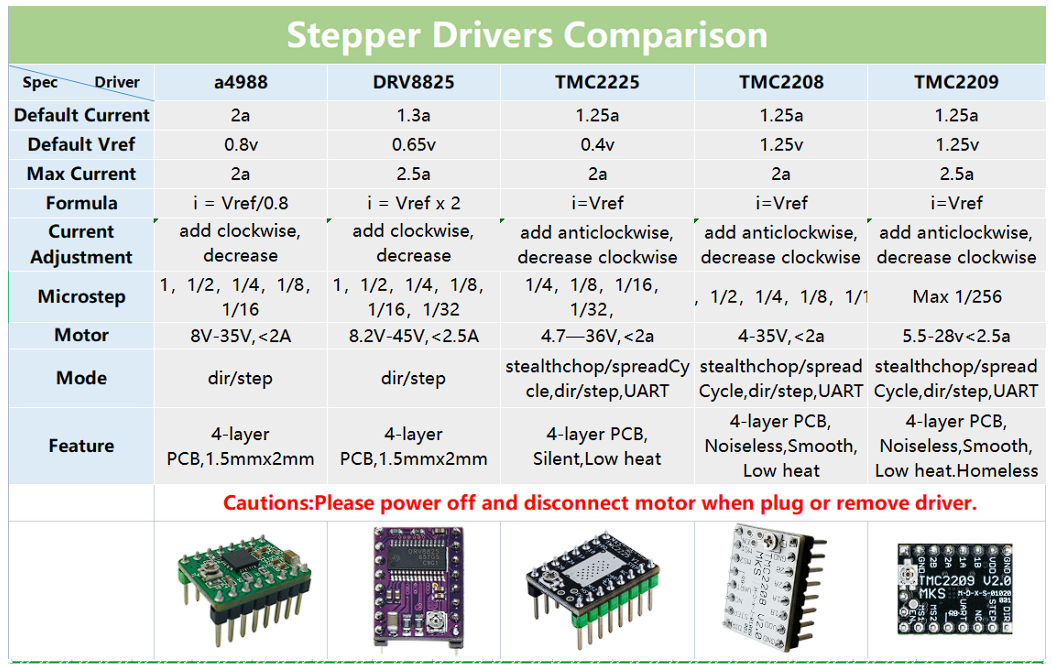
img/drievrs.png
