RoboticsURJC/tfg-vperez/img/electroiman_como_lo_situo.png

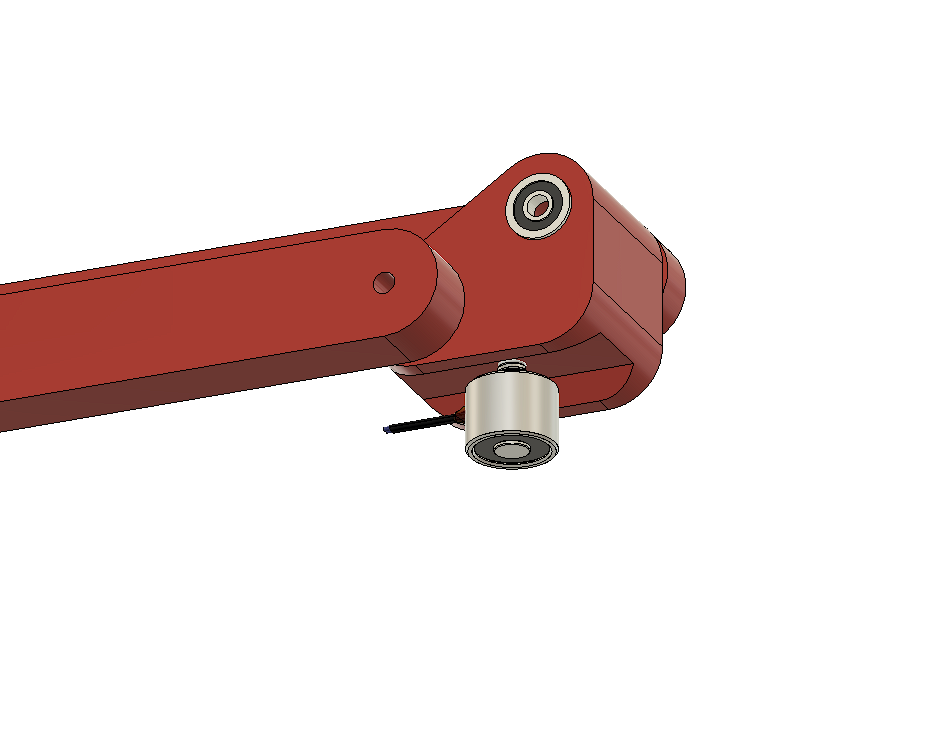
img/electroiman_como_lo_situo.png
