RoboticsURJC/tfg-vperez/img/FirstCircle.png

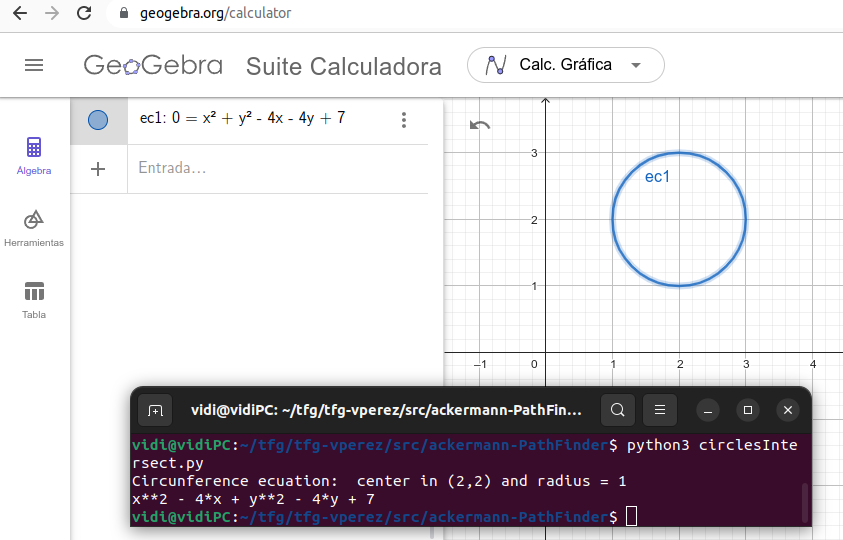
img/FirstCircle.png
