RoboticsURJC/tfg-vperez/img/firstRobotMoveit.gif

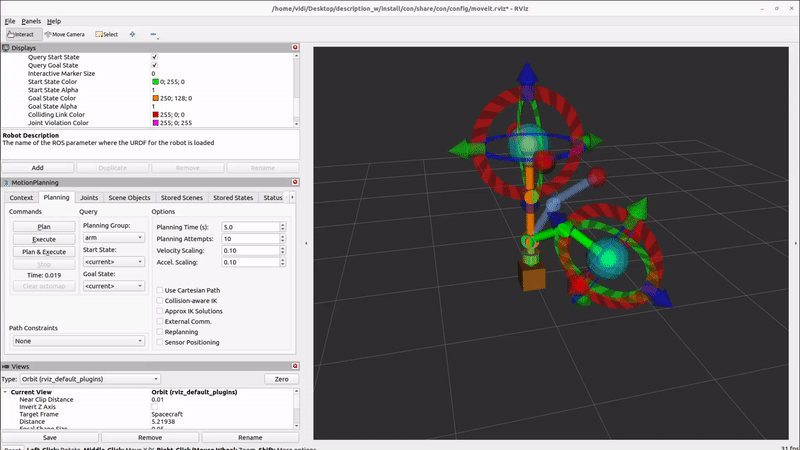
img/firstRobotMoveit.gif
