RoboticsURJC/tfg-vperez/img/GIF_rviz_desacoupled.gif

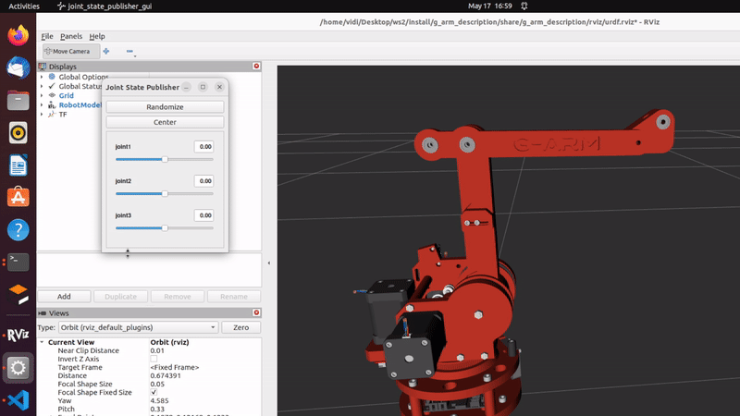
img/GIF_rviz_desacoupled.gif
