RoboticsURJC/tfg-vperez/img/GIF_rviz_end_effector_mimic.gif

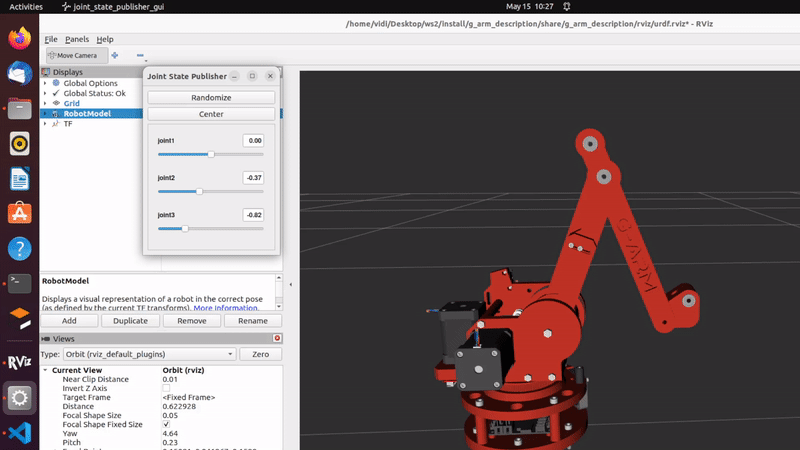
img/GIF_rviz_end_effector_mimic.gif
