RoboticsURJC/tfg-vperez/img/GIF_rviz_end_effector_mimic_bad_working.gif

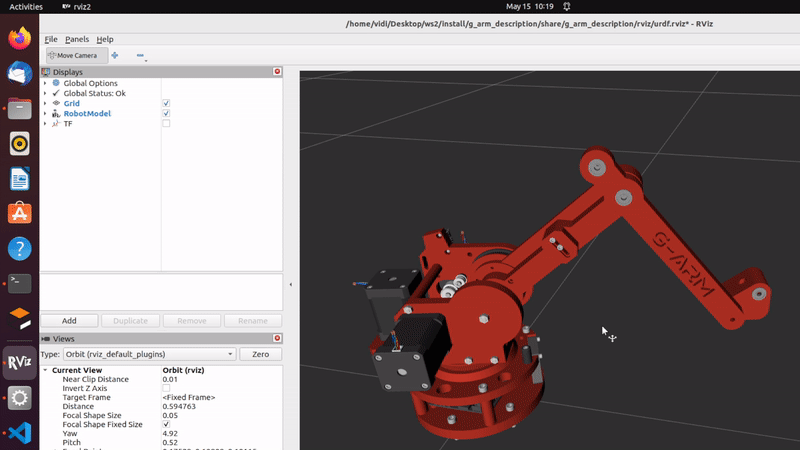
img/GIF_rviz_end_effector_mimic_bad_working.gif
