RoboticsURJC/tfg-vperez/img/GIF_rviz_simple_collisions.gif

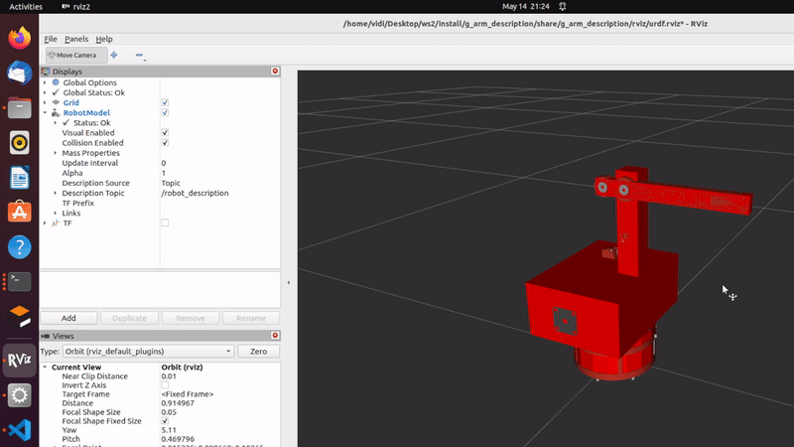
img/GIF_rviz_simple_collisions.gif
