RoboticsURJC/tfg-vperez/img/gif_ZeroPieza.gif

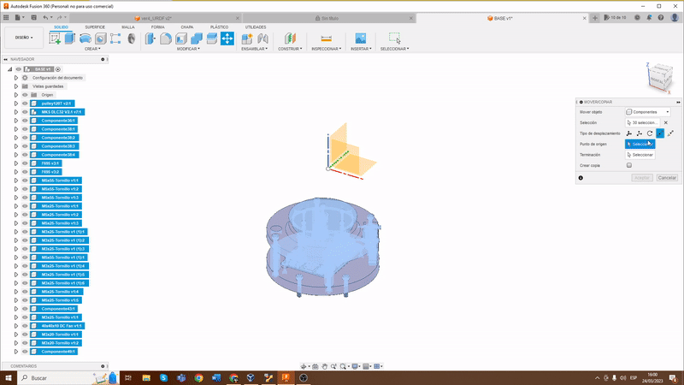
img/gif_ZeroPieza.gif
