RoboticsURJC/tfg-vperez/img/grbl_$$.png

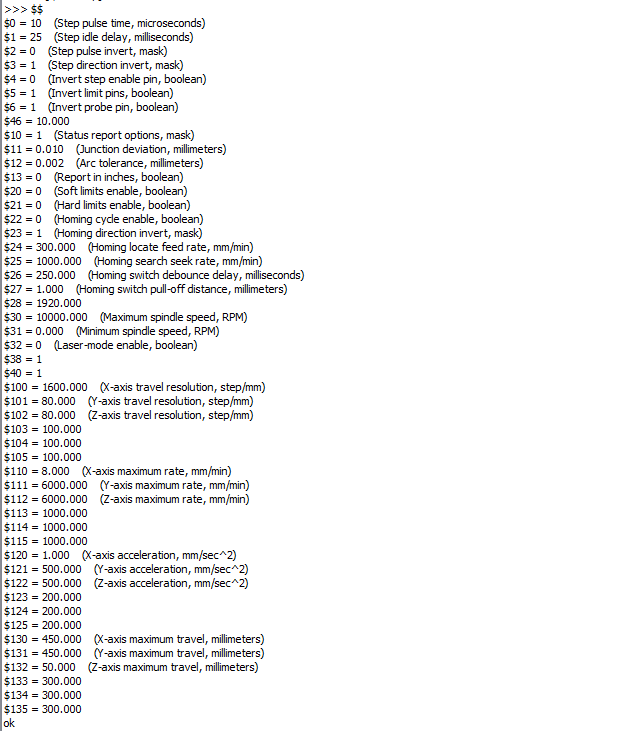
img/grbl_$$.png
