RoboticsURJC/tfg-vperez/img/GT2 20 to 60.png

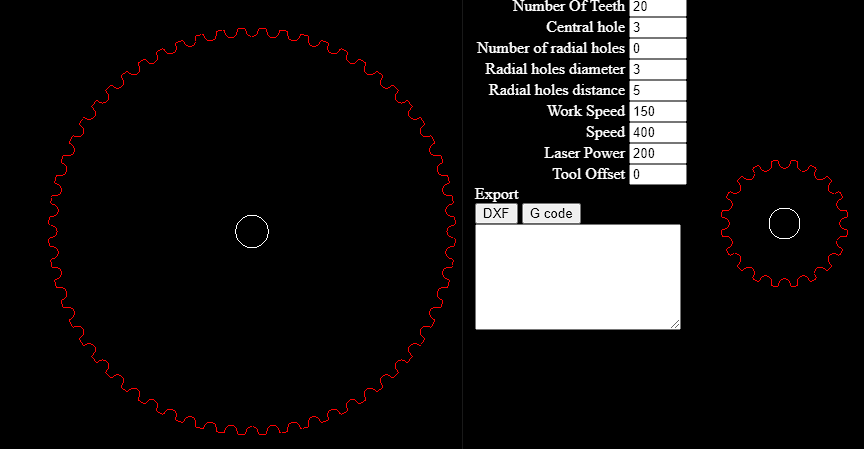
img/GT2 20 to 60.png
