RoboticsURJC/tfg-vperez/img/invert_kinematics.jpg

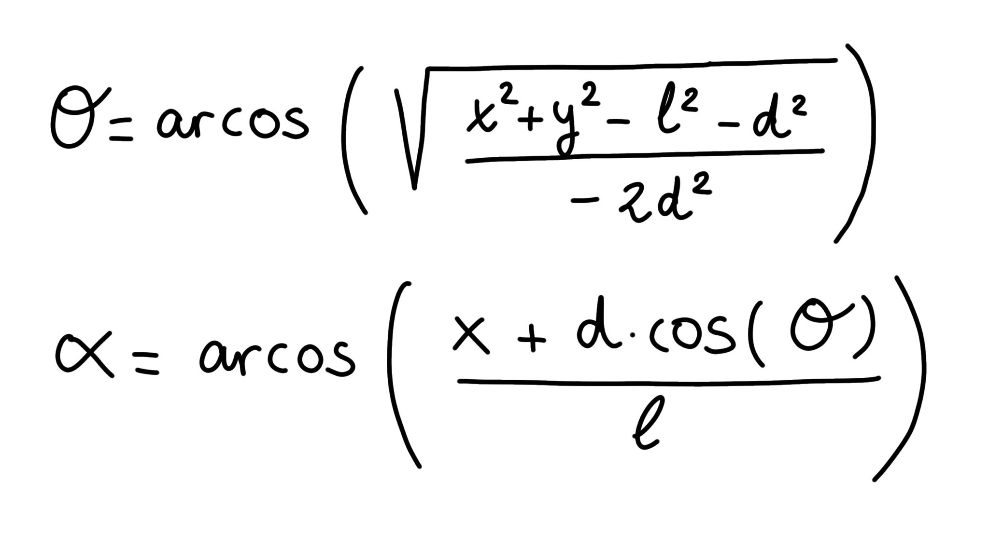
img/invert_kinematics.jpg
