RoboticsURJC/tfg-vperez/img/largocorrea.png

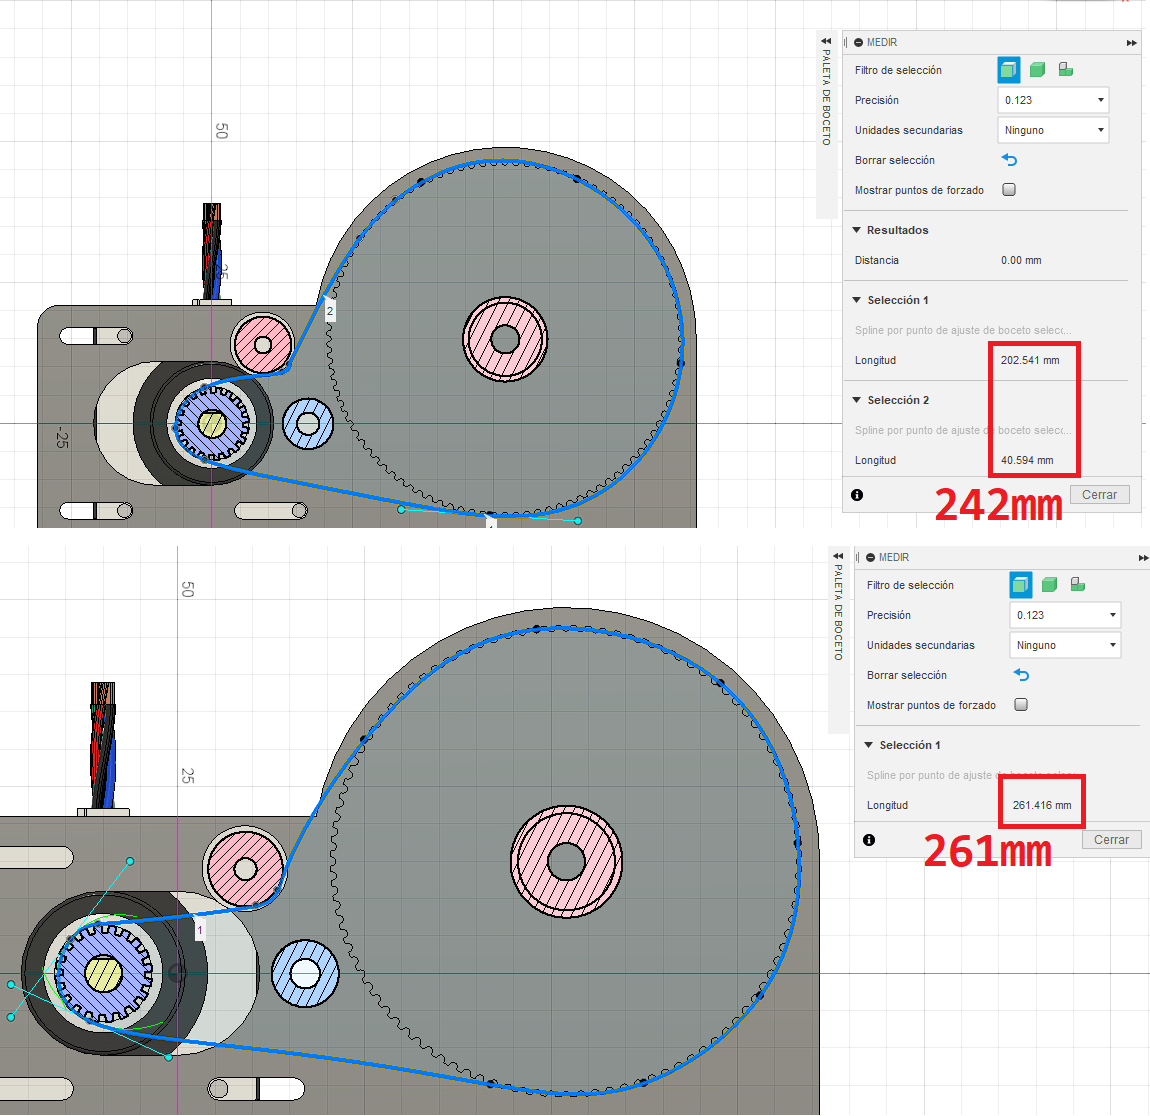
img/largocorrea.png
