RoboticsURJC/tfg-vperez/img/LineIntersection.png

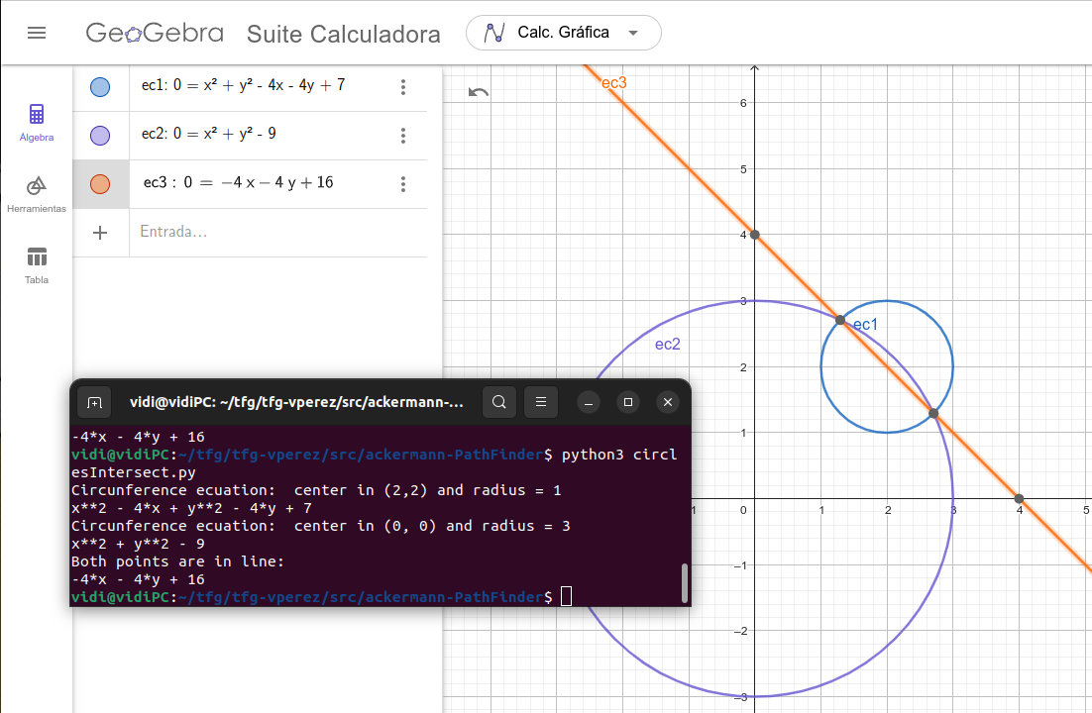
img/LineIntersection.png
