RoboticsURJC/tfg-vperez/img/link2_curvatura.png

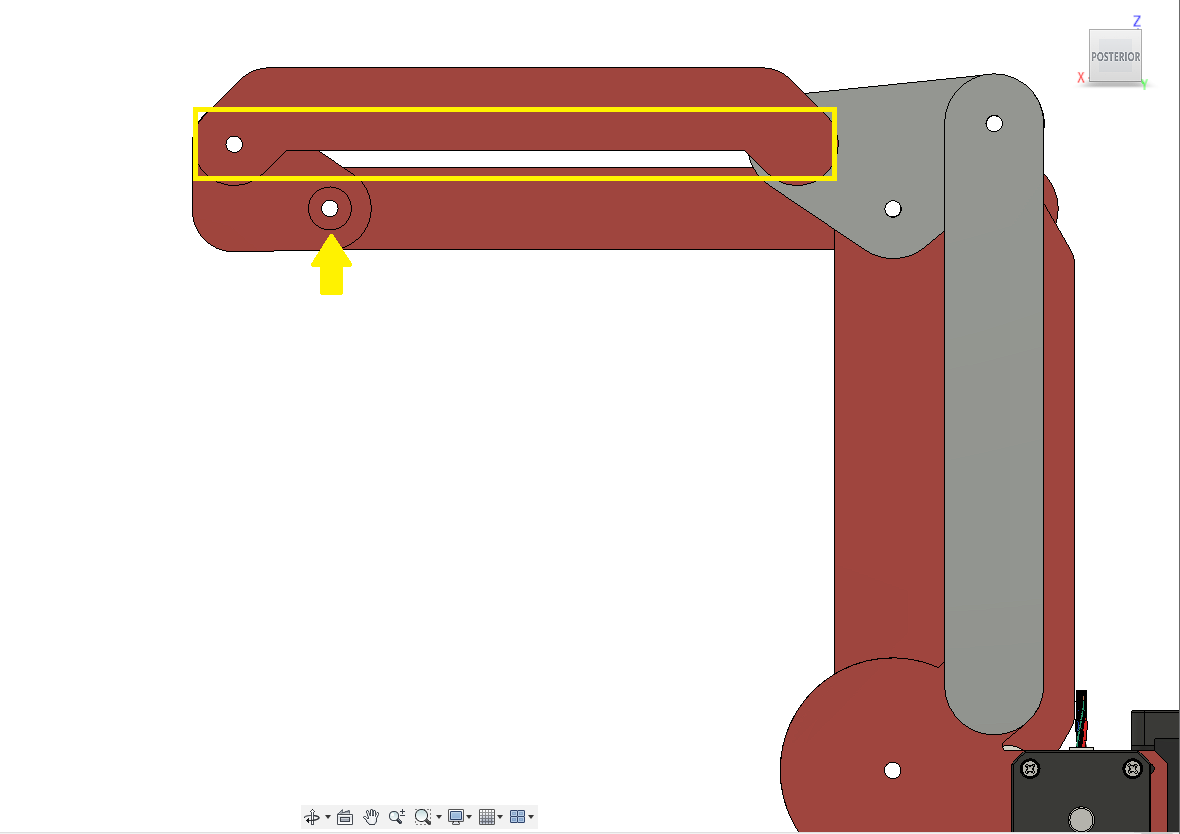
img/link2_curvatura.png
