RoboticsURJC/tfg-vperez/img/Motor precio.png

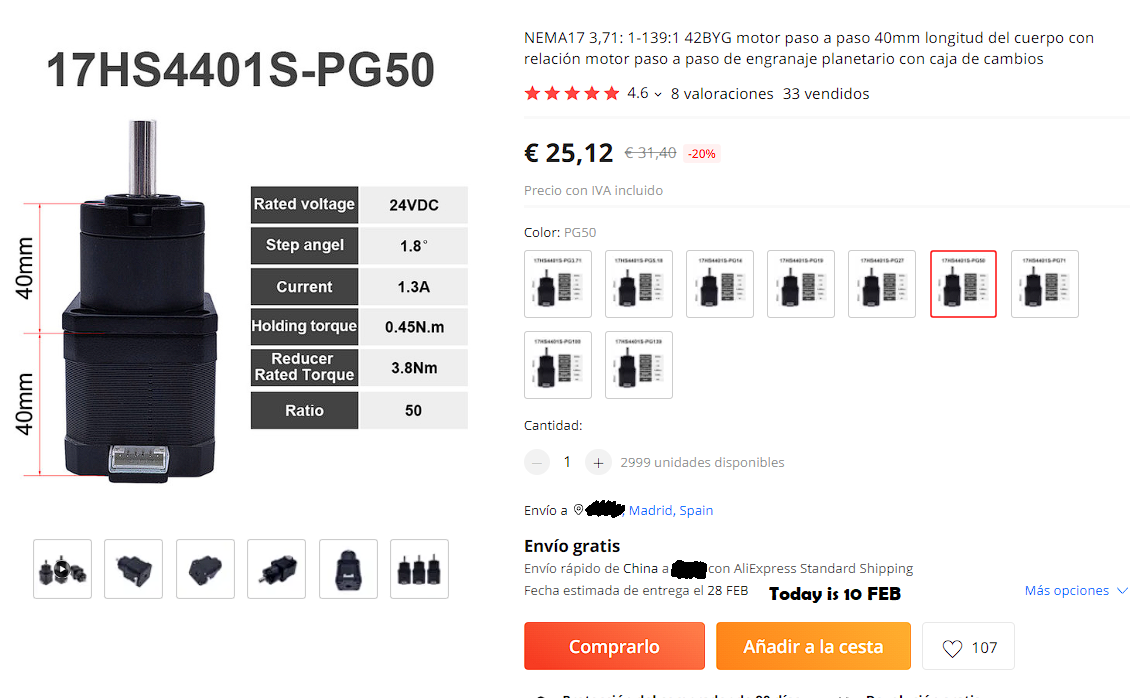
img/Motor precio.png
