RoboticsURJC/tfg-vperez/img/NewMethod.jpeg

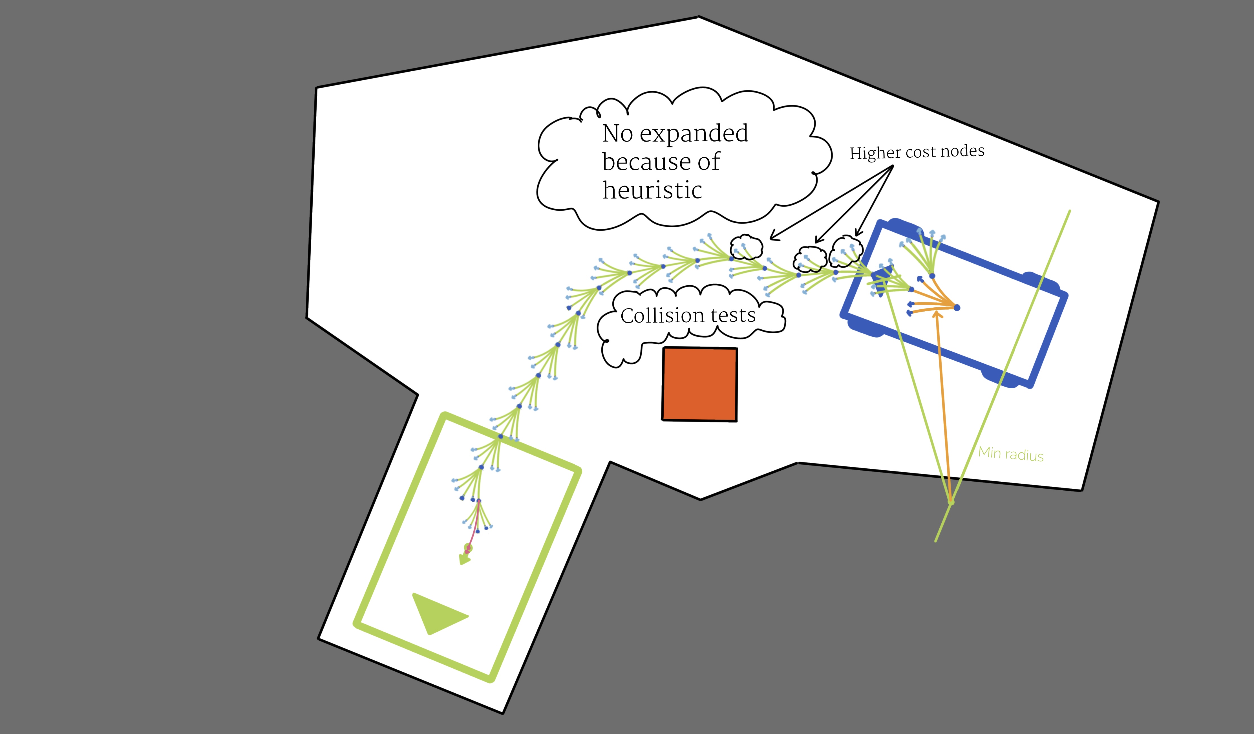
img/NewMethod.jpeg
