RoboticsURJC/tfg-vperez/img/ParalelepipedoRestricciones.png

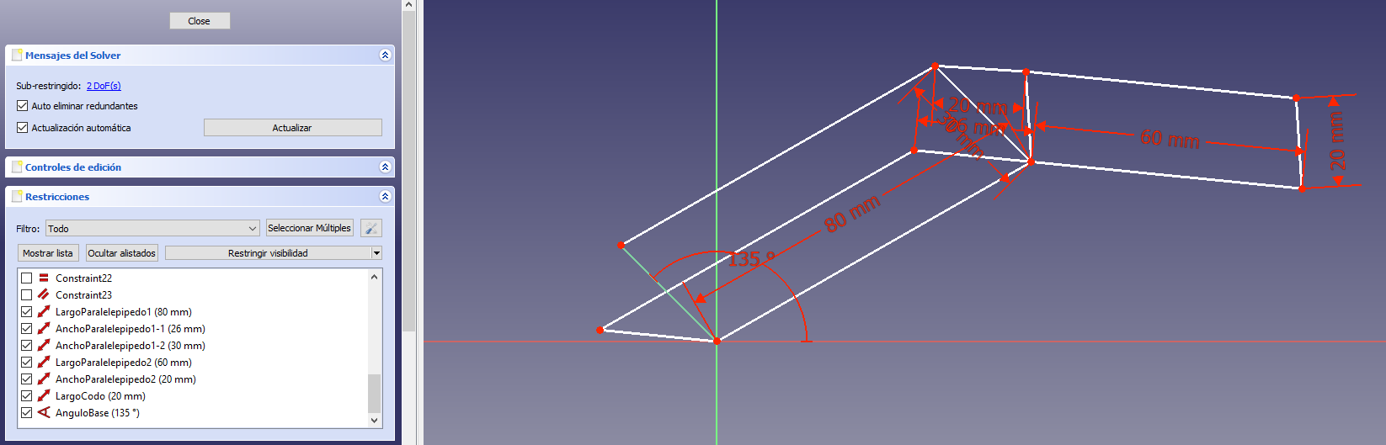
img/ParalelepipedoRestricciones.png
