RoboticsURJC/tfg-vperez/img/parallel-to-RR.jpg

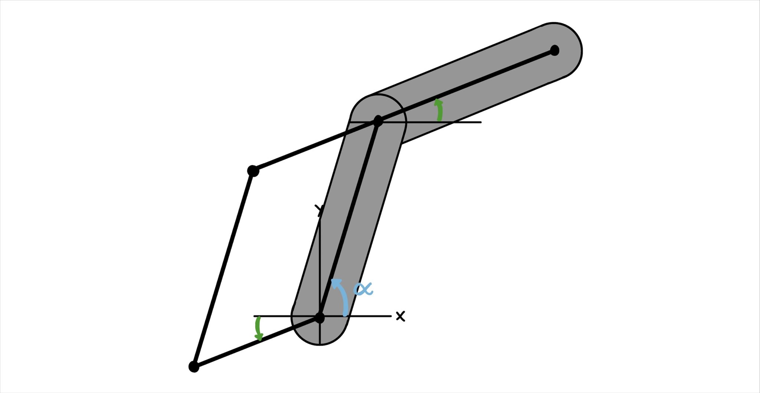
img/parallel-to-RR.jpg
