RoboticsURJC/tfg-vperez/img/PendantFirstView.gif

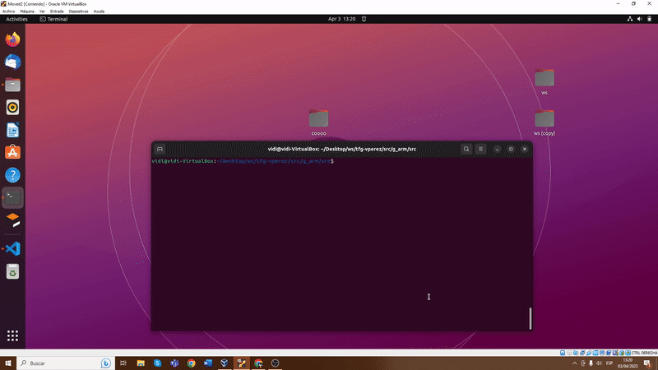
img/PendantFirstView.gif
