RoboticsURJC/tfg-vperez/img/PesoLink2.JPEG

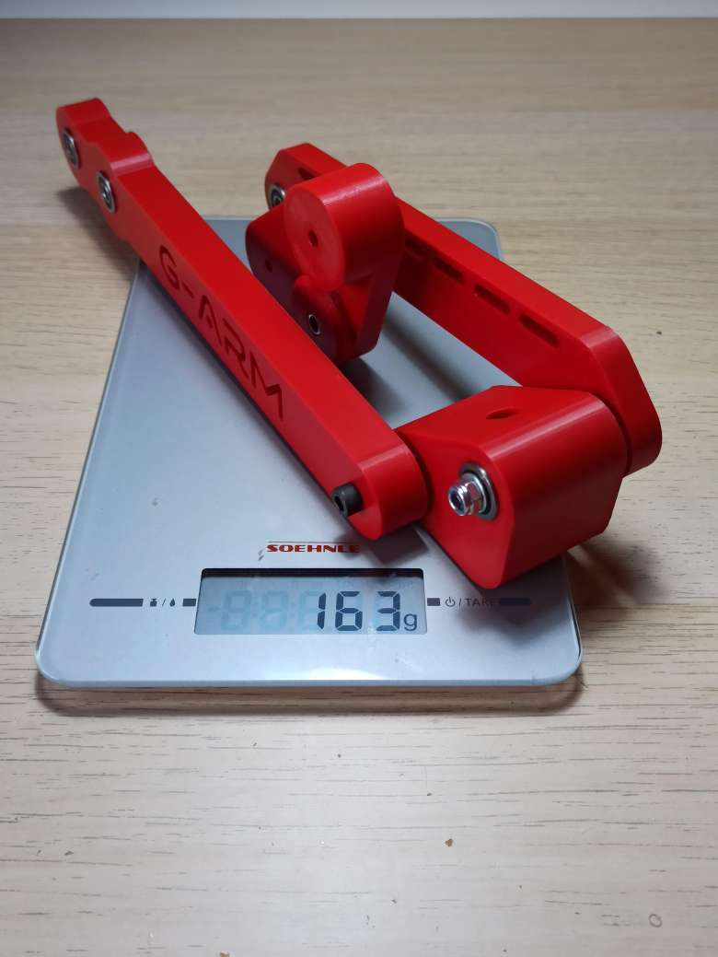
img/PesoLink2.JPEG
