RoboticsURJC/tfg-vperez/img/pizarra_brazo1.JPEG

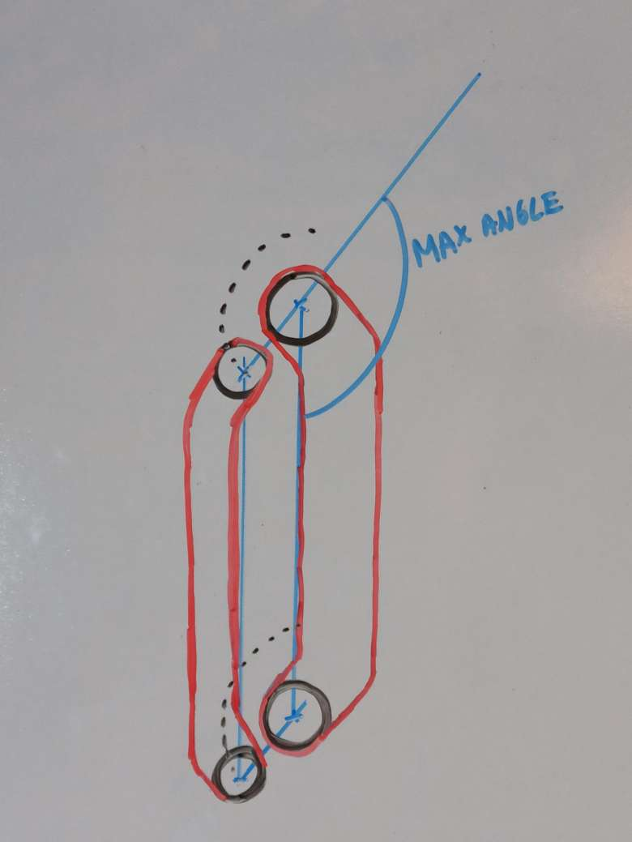
img/pizarra_brazo1.JPEG
