RoboticsURJC/tfg-vperez/img/Placa_abajo_concept.png

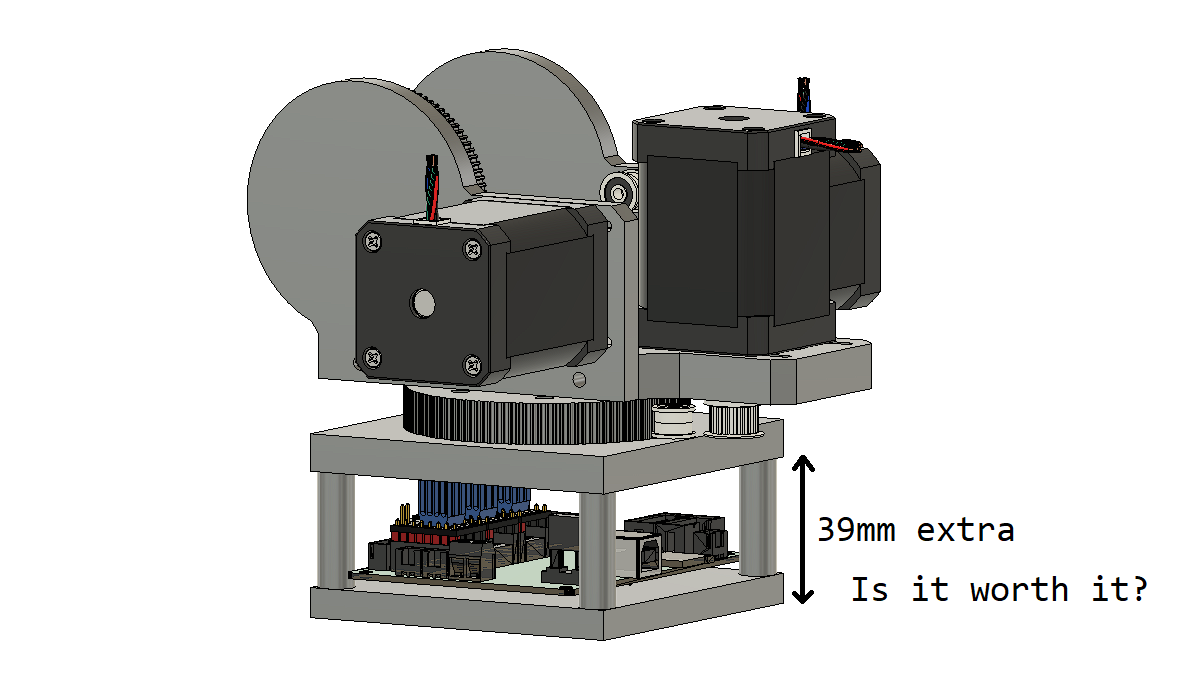
img/Placa_abajo_concept.png
