RoboticsURJC/tfg-vperez/img/PointExtraction.png

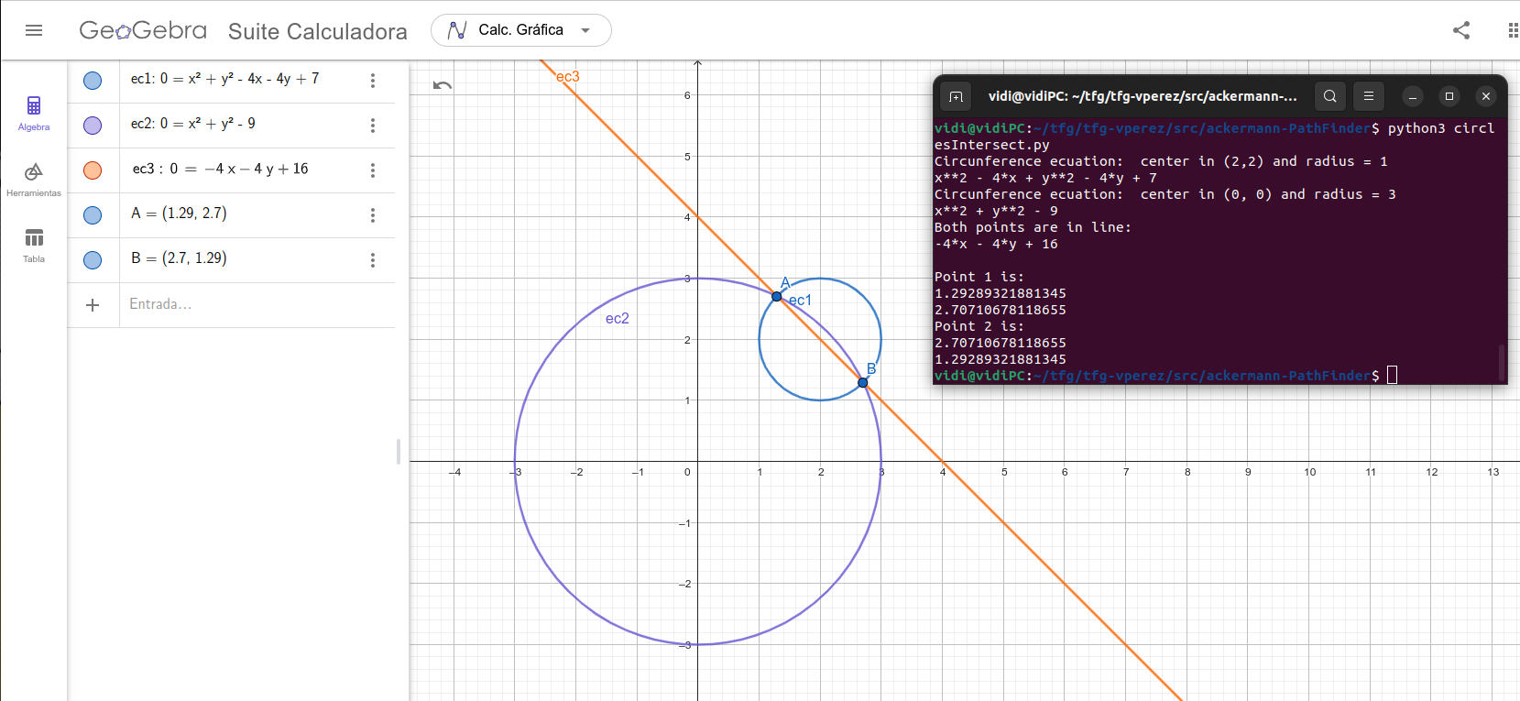
img/PointExtraction.png
