RoboticsURJC/tfg-vperez/img/portada_video_codo.png

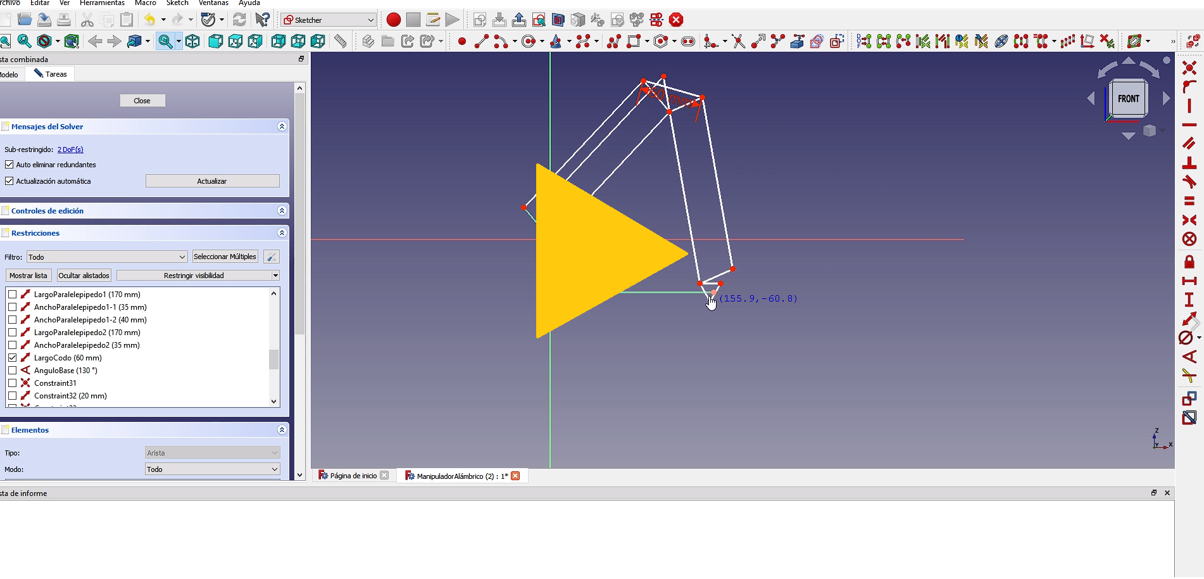
img/portada_video_codo.png
