RoboticsURJC/tfg-vperez/img/portada_video_electroiman.png

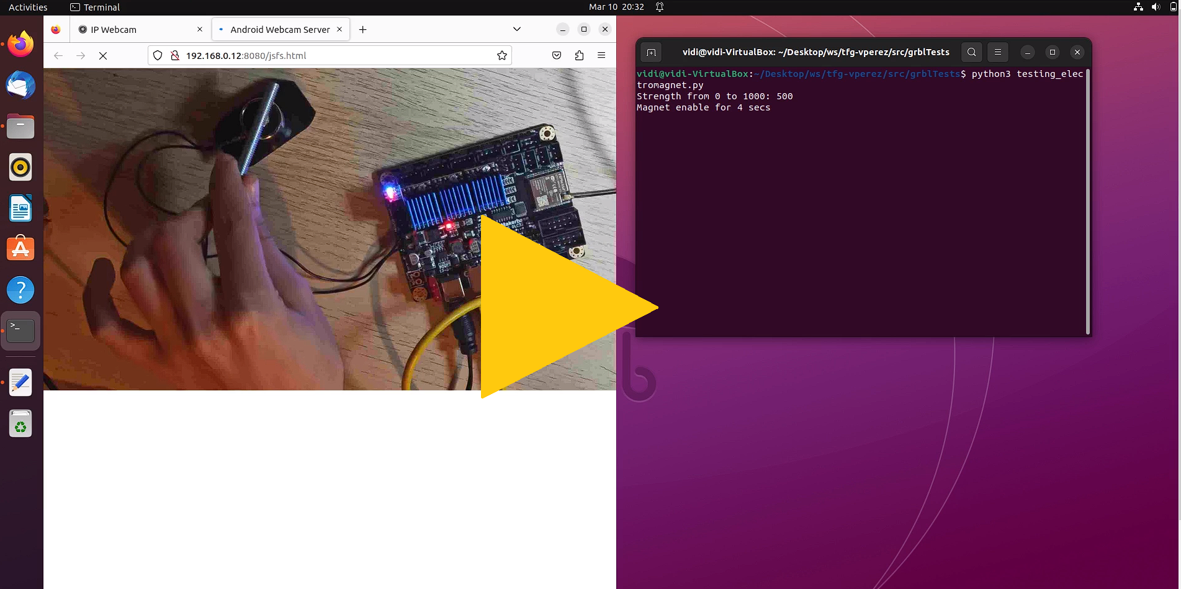
img/portada_video_electroiman.png
