RoboticsURJC/tfg-vperez/img/portada_videoApi1.png

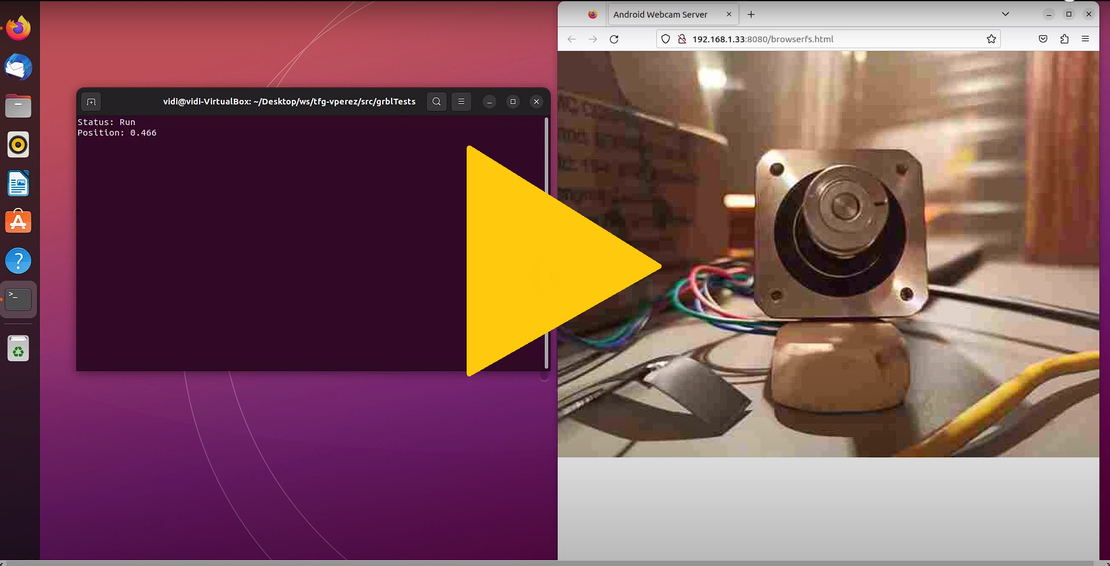
img/portada_videoApi1.png
