RoboticsURJC/tfg-vperez/img/prefixM5.JPEG

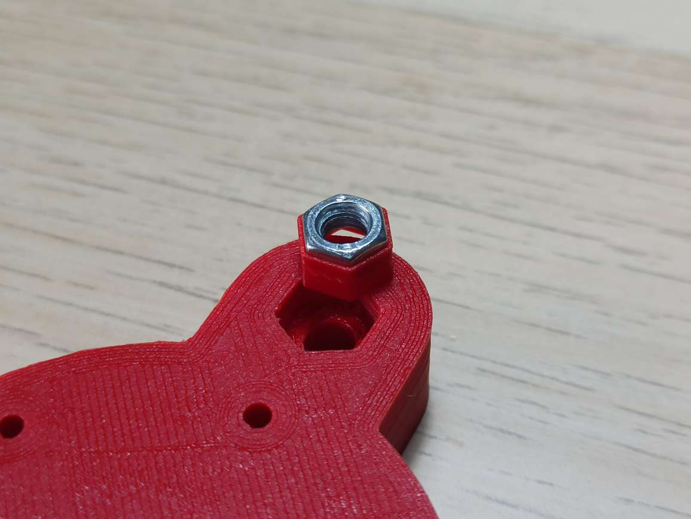
img/prefixM5.JPEG
