RoboticsURJC/tfg-vperez/img/problema_link_fijo.png

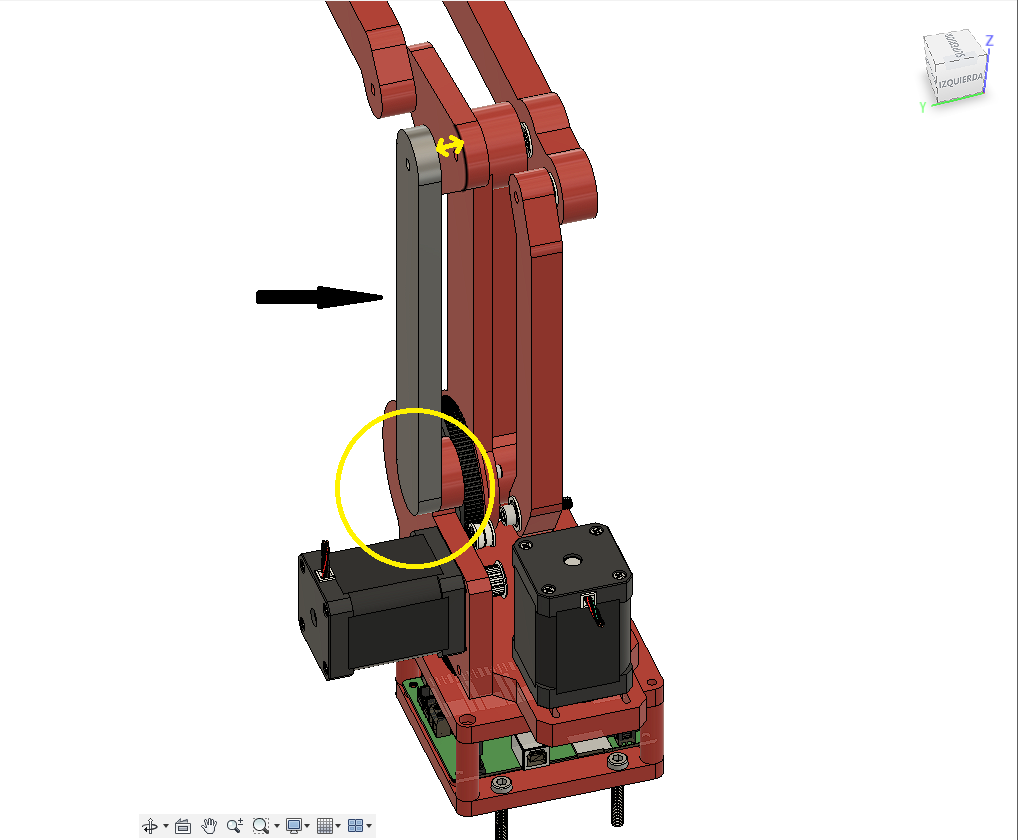
img/problema_link_fijo.png
