RoboticsURJC/tfg-vperez/img/ReferenceSystems.PNG

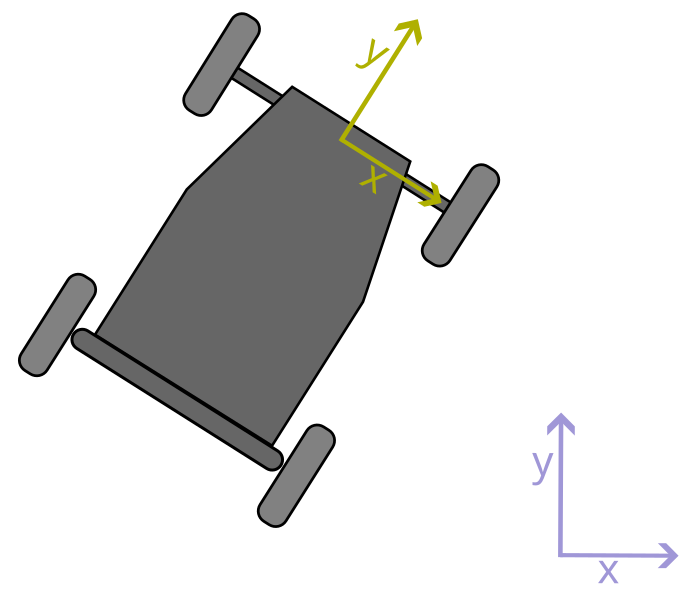
img/ReferenceSystems.PNG
