RoboticsURJC/tfg-vperez/img/Robot limitsText.png

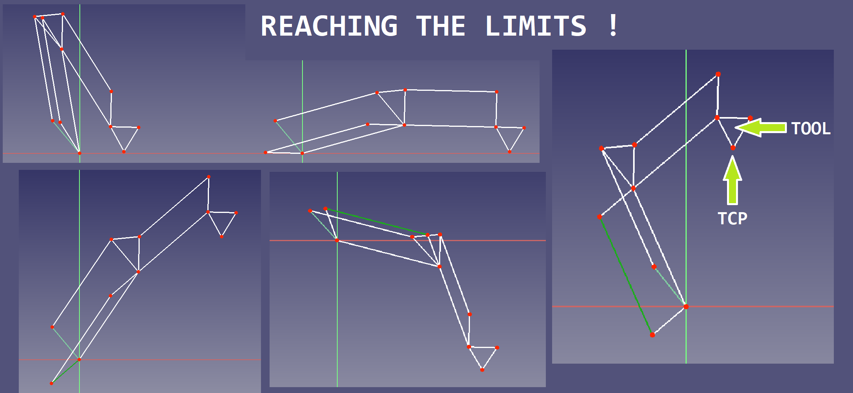
img/Robot limitsText.png
