RoboticsURJC/tfg-vperez/img/RR-gif.gif

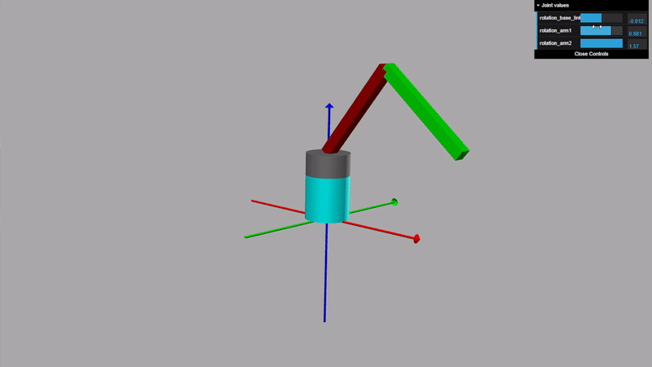
img/RR-gif.gif
