RoboticsURJC/tfg-vperez/img/rviz_g_arm_simple.png

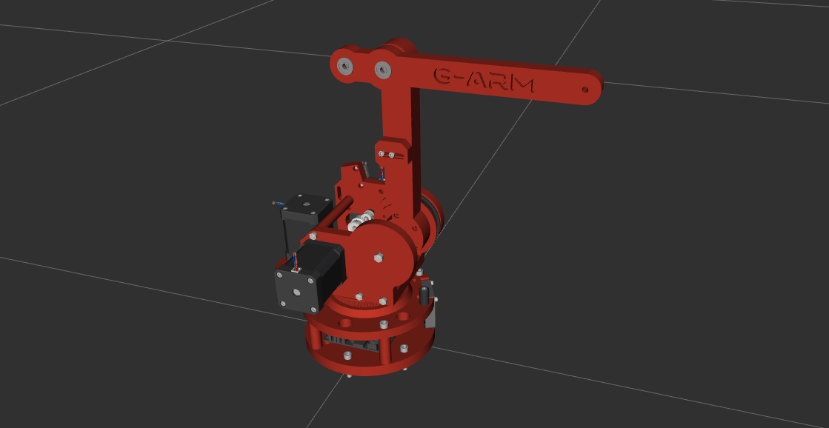
img/rviz_g_arm_simple.png
