RoboticsURJC/tfg-vperez/img/rvizBasePrimerIntento.gif

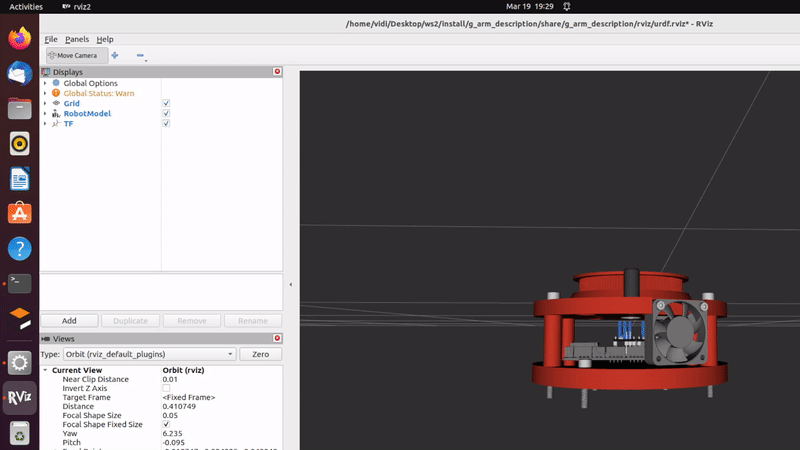
img/rvizBasePrimerIntento.gif
