RoboticsURJC/tfg-vperez/img/SolucionMotorTornilloCorto.png

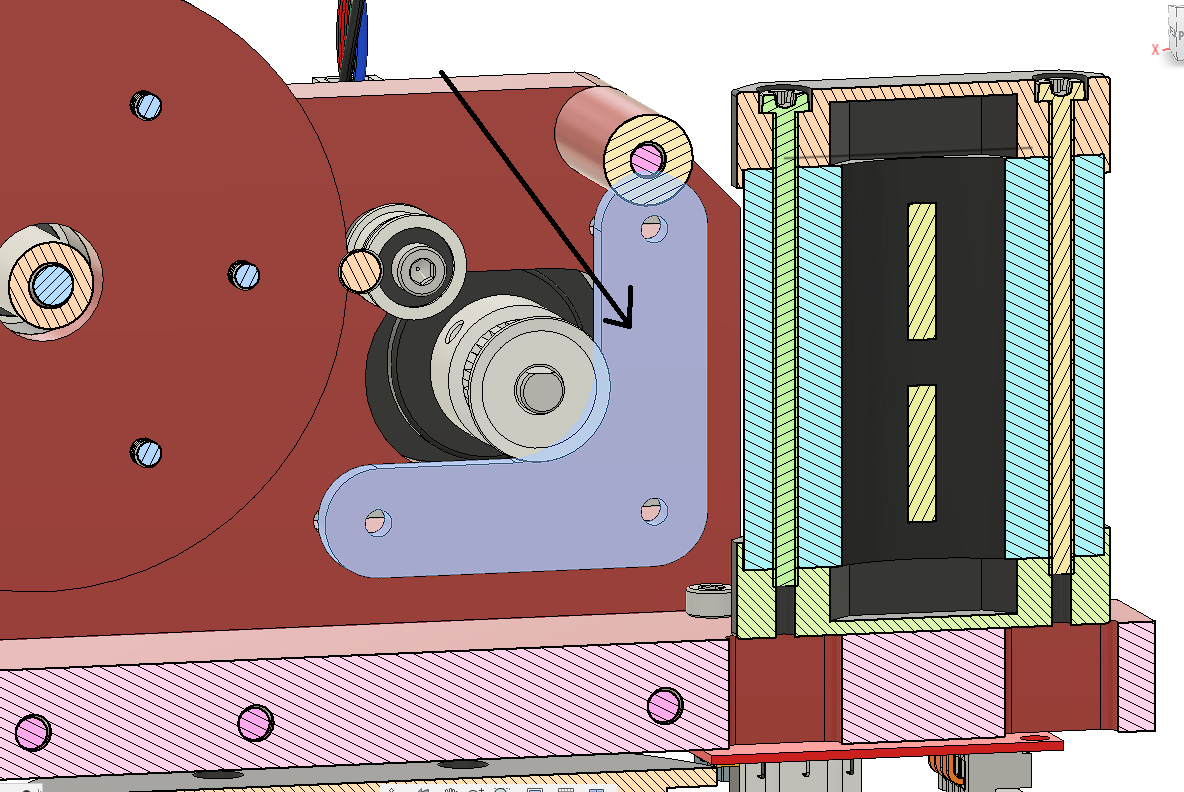
img/SolucionMotorTornilloCorto.png
