RoboticsURJC/tfg-vperez/img/soporte_real_modelo.png

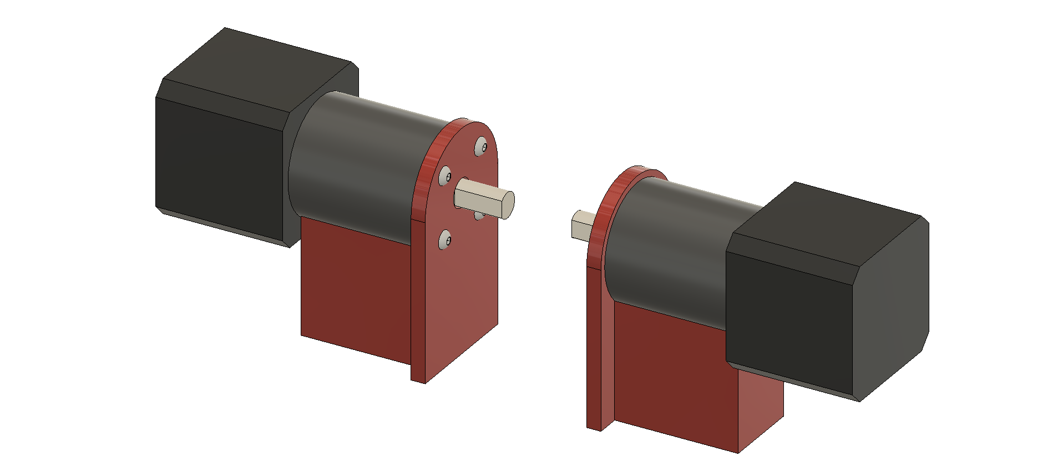
img/soporte_real_modelo.png
