RoboticsURJC/tfg-vperez/img/TeseladoX10.png

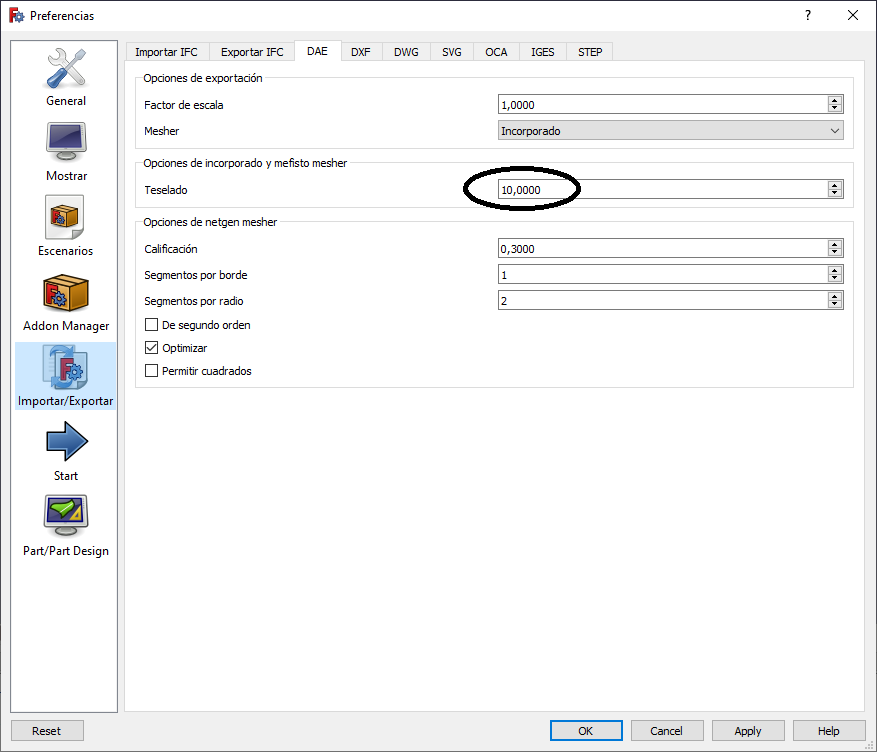
img/TeseladoX10.png
