RoboticsURJC/tfg-vperez/img/xyz_explanations_.jpg

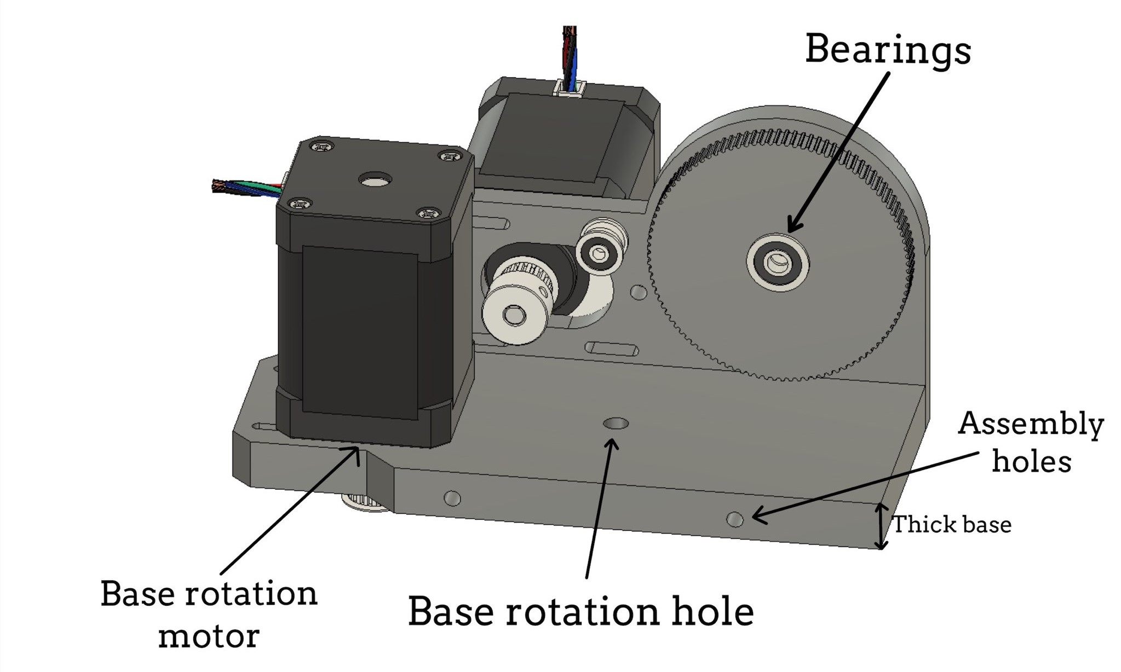
img/xyz_explanations_.jpg
