RoboticsURJC/tfg-vperez/latex/Memoria/figs/agv.jpg

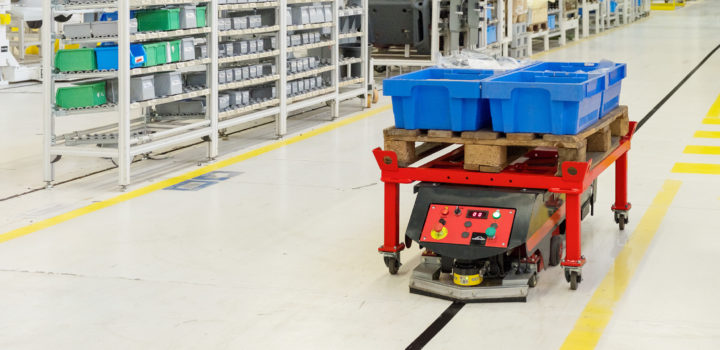
latex/Memoria/figs/agv.jpg
