RoboticsURJC/tfg-vperez/latex/Memoria/figs/autopilot.jpg

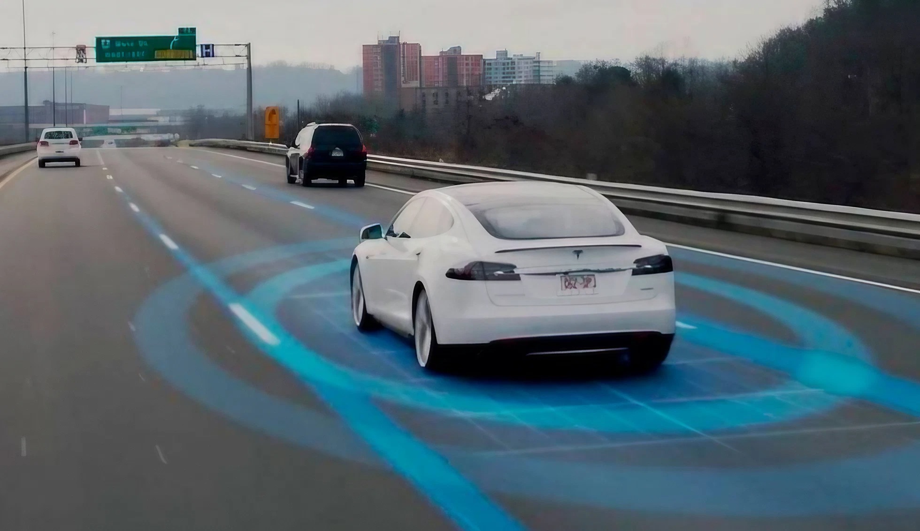
latex/Memoria/figs/autopilot.jpg
