RoboticsURJC/tfg-vperez/latex/Memoria/figs/boceto4.PNG

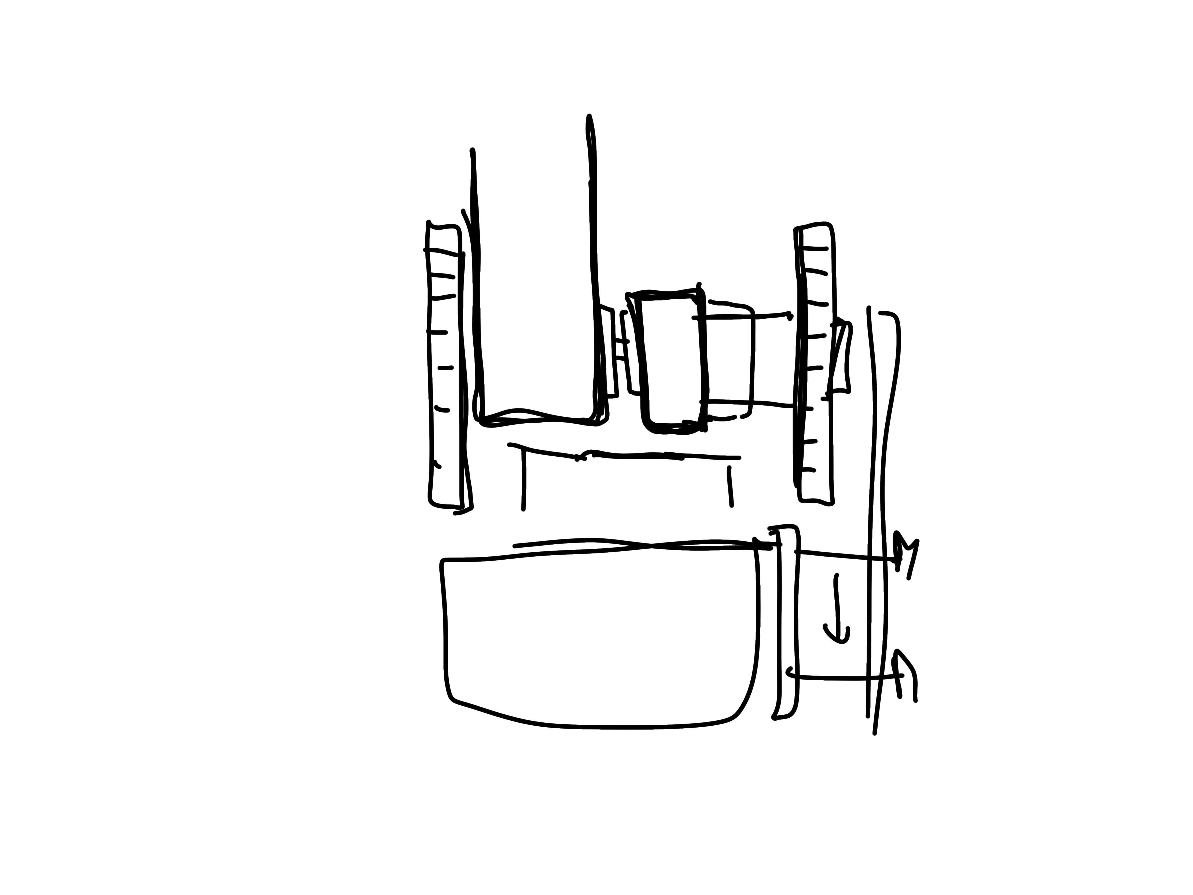
latex/Memoria/figs/boceto4.PNG
