RoboticsURJC/tfg-vperez/latex/Memoria/figs/boceto5.PNG

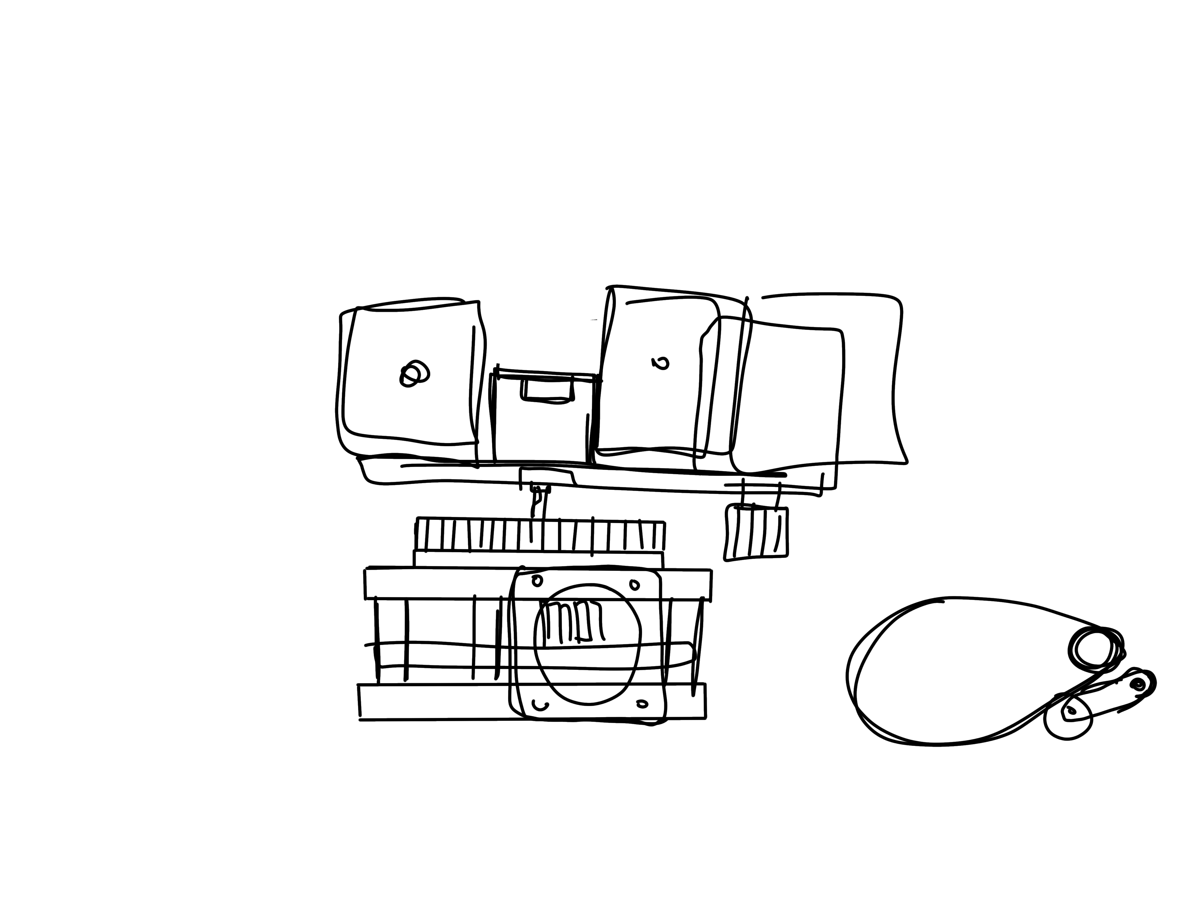
latex/Memoria/figs/boceto5.PNG
