RoboticsURJC/tfg-vperez/latex/Memoria/figs/diyroboticsarm.jpg

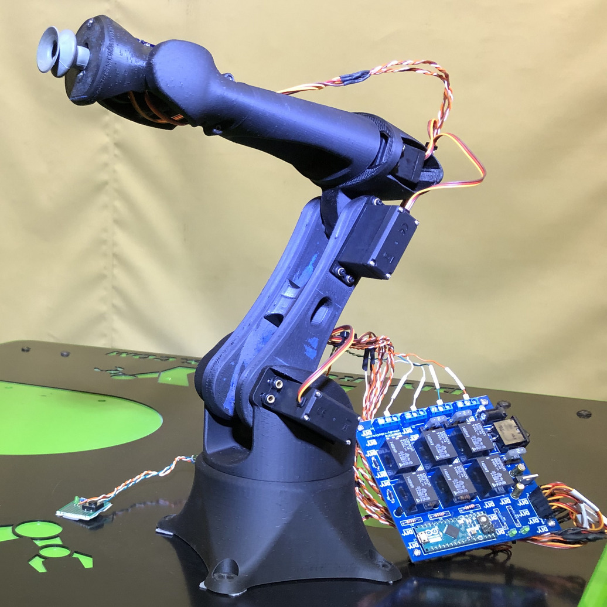
latex/Memoria/figs/diyroboticsarm.jpg
