RoboticsURJC/tfg-vperez/latex/Memoria/figs/drone.jpg

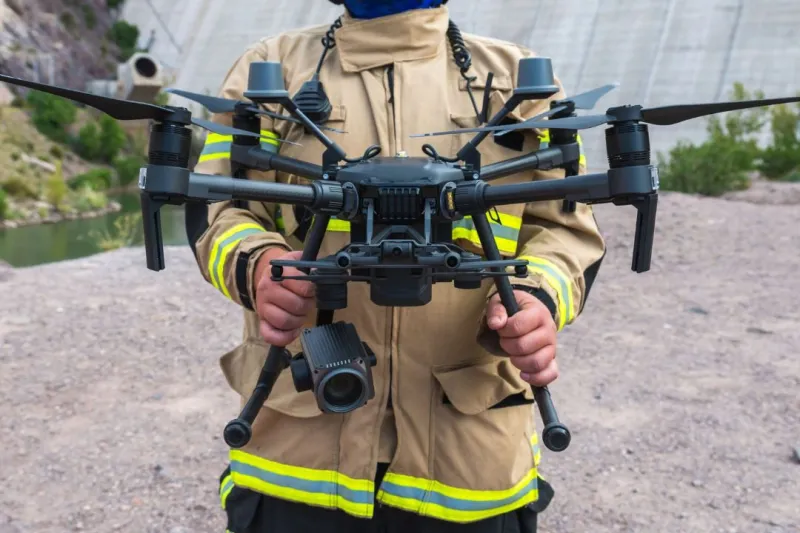
latex/Memoria/figs/drone.jpg
