RoboticsURJC/tfg-vperez/latex/Memoria/figs/eezy.jpg

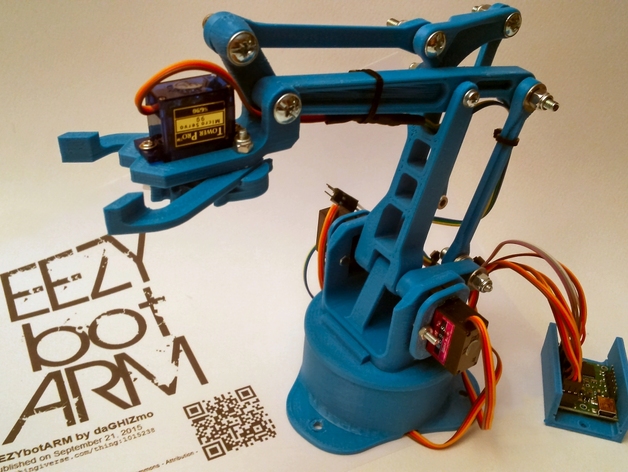
latex/Memoria/figs/eezy.jpg
