RoboticsURJC/tfg-vperez/latex/Memoria/figs/examples_goal.png

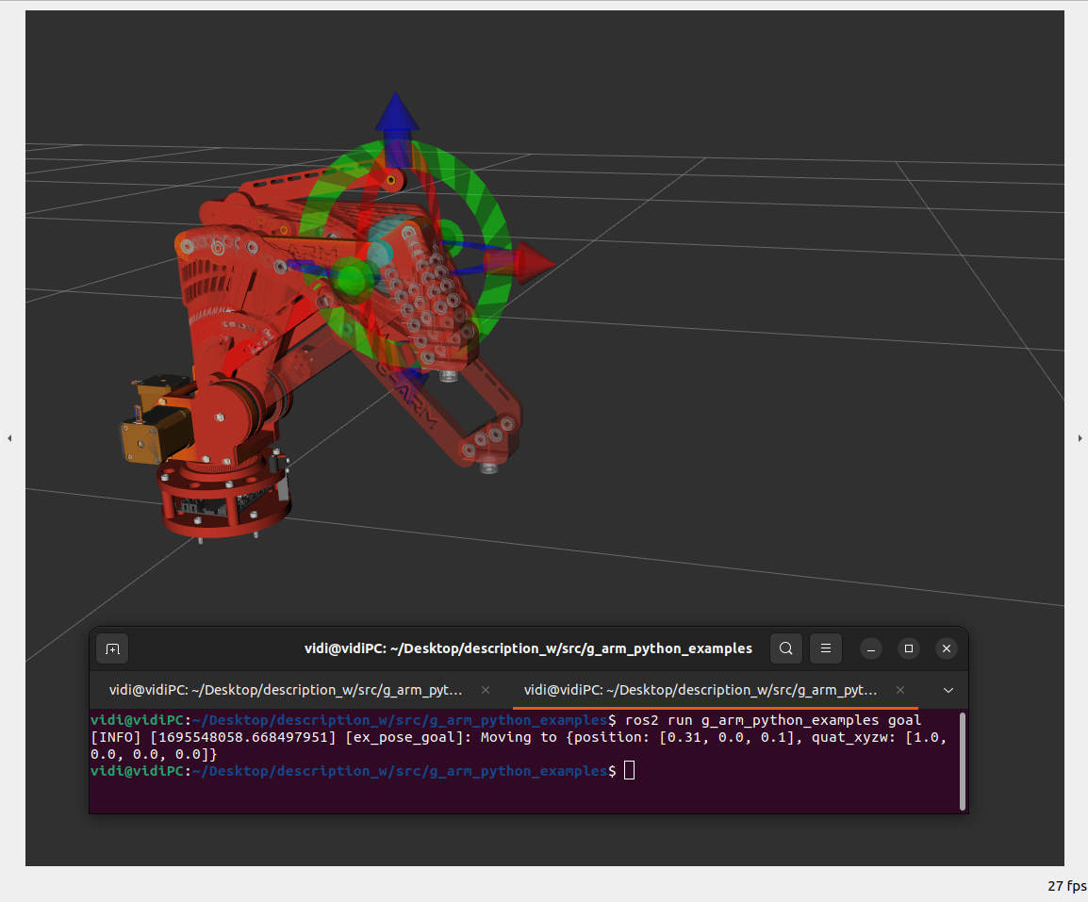
latex/Memoria/figs/examples_goal.png
