RoboticsURJC/tfg-vperez/latex/Memoria/figs/F695-2RS.jpeg

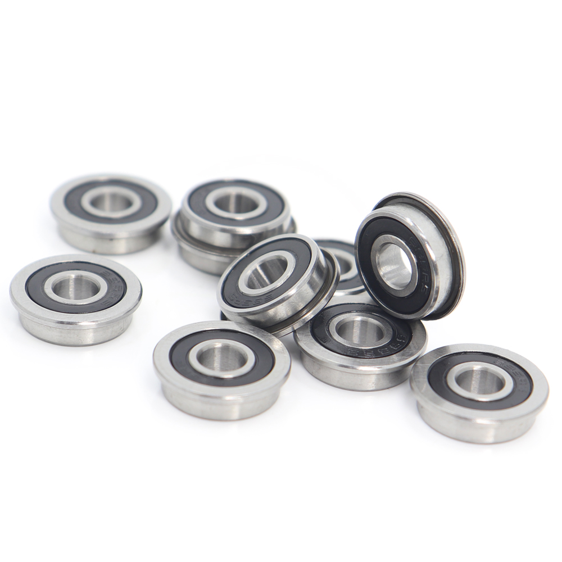
latex/Memoria/figs/F695-2RS.jpeg
