RoboticsURJC/tfg-vperez/latex/Memoria/figs/fanuc_spacio.jpg

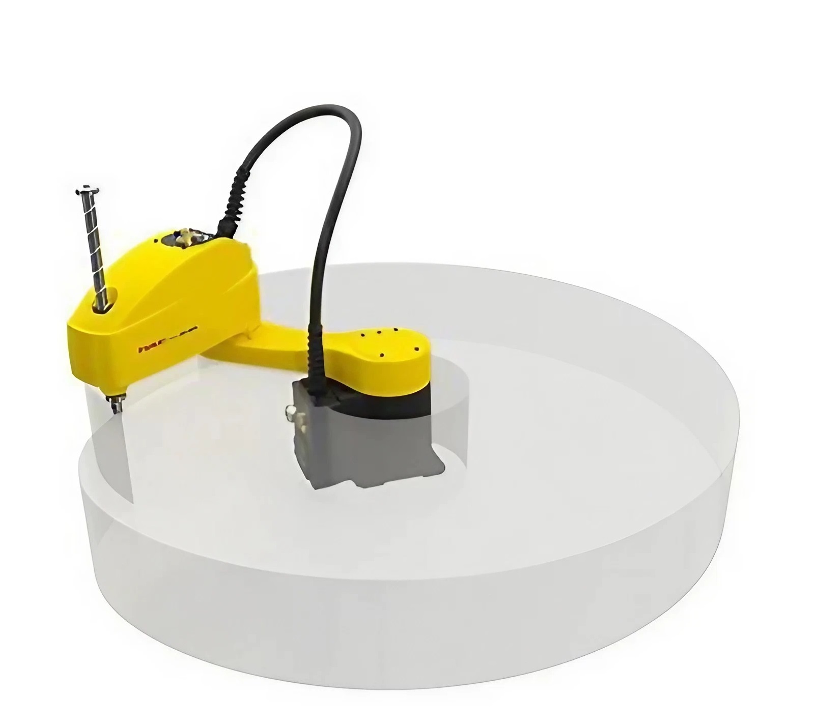
latex/Memoria/figs/fanuc_spacio.jpg
