RoboticsURJC/tfg-vperez/latex/Memoria/figs/icebot.png

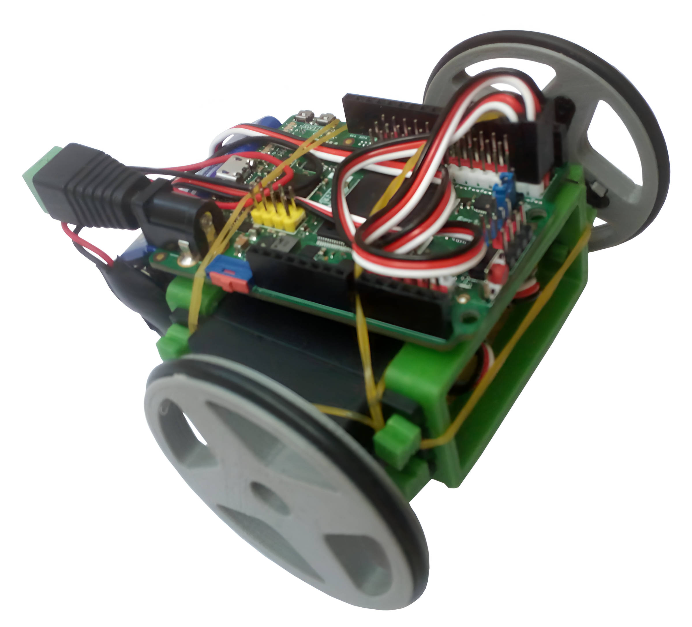
latex/Memoria/figs/icebot.png
