RoboticsURJC/tfg-vperez/latex/Memoria/figs/igus_space.png

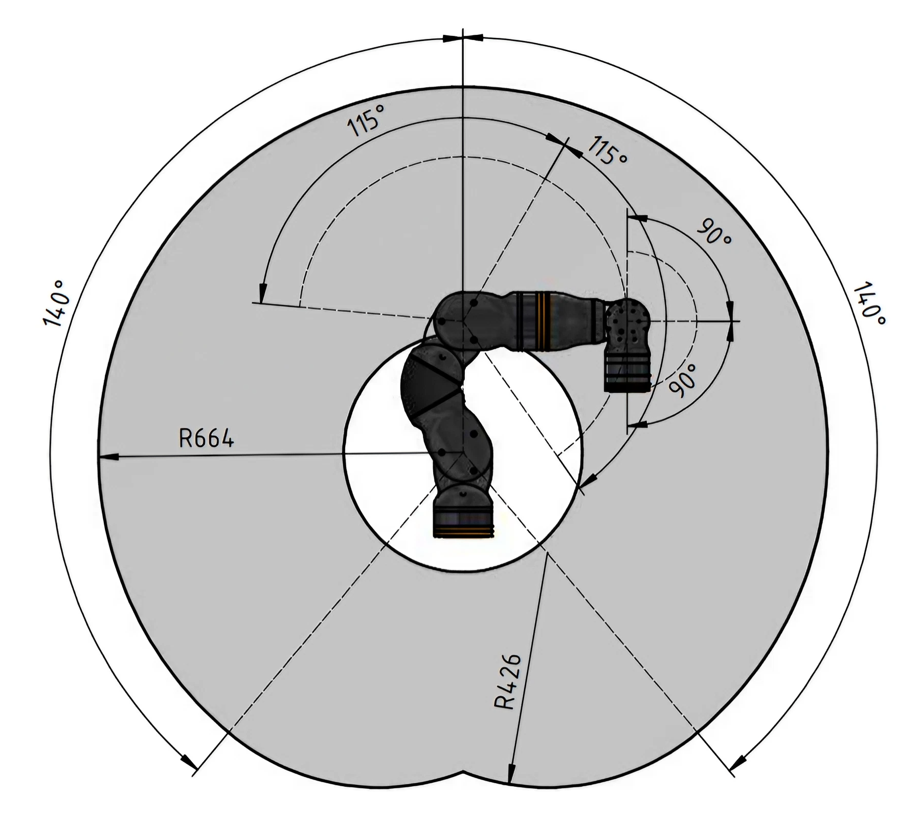
latex/Memoria/figs/igus_space.png
