RoboticsURJC/tfg-vperez/latex/Memoria/figs/joint_cil.png

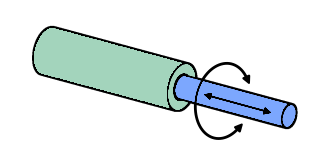
latex/Memoria/figs/joint_cil.png
