RoboticsURJC/tfg-vperez/latex/Memoria/figs/joint_esf.png

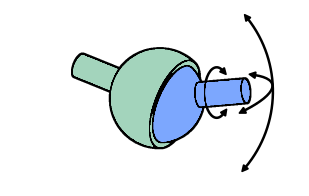
latex/Memoria/figs/joint_esf.png
