RoboticsURJC/tfg-vperez/latex/Memoria/figs/keystudio.jpg

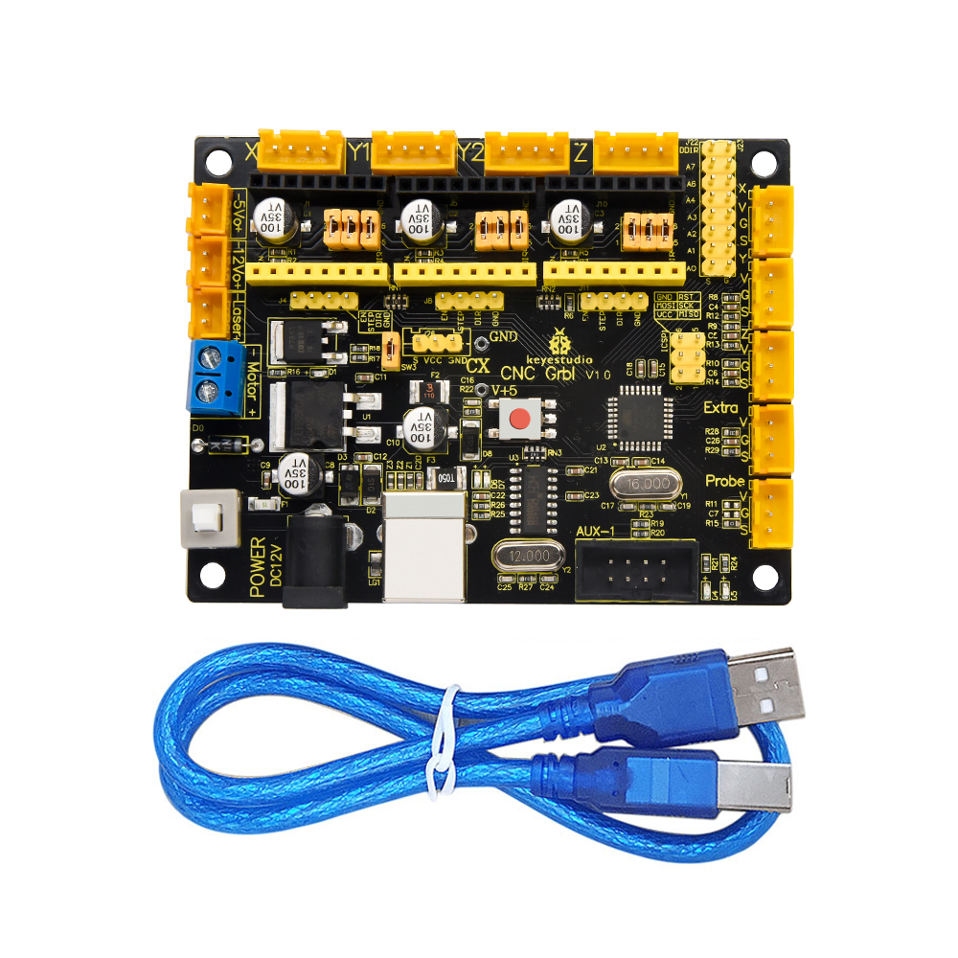
latex/Memoria/figs/keystudio.jpg
