RoboticsURJC/tfg-vperez/latex/Memoria/figs/lab_robot.jpg

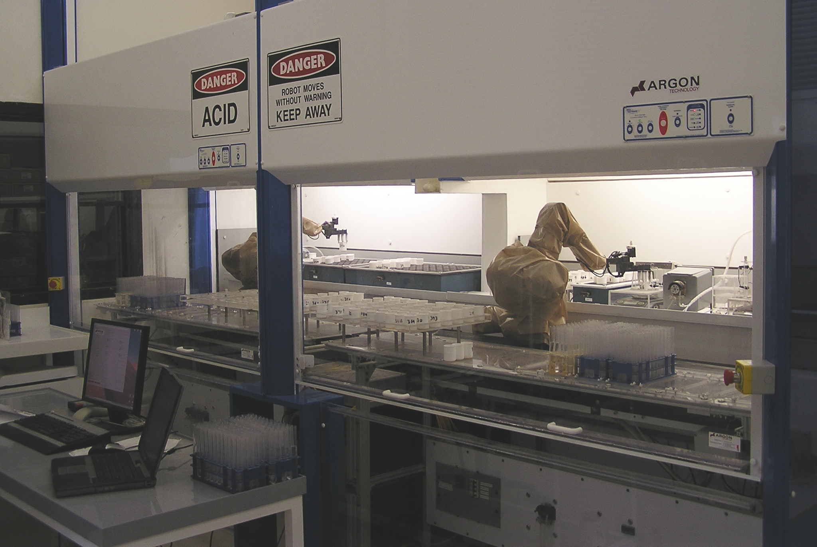
latex/Memoria/figs/lab_robot.jpg
