RoboticsURJC/tfg-vperez/latex/Memoria/figs/mearm.jpg

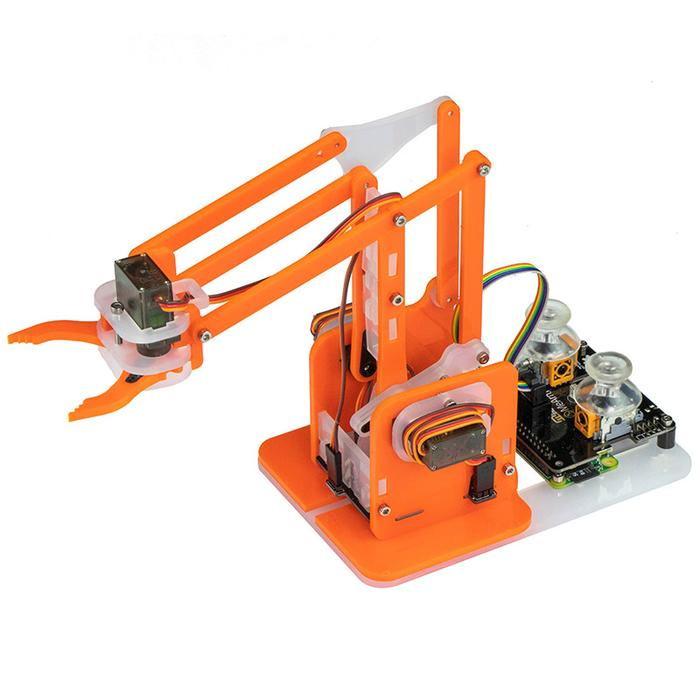
latex/Memoria/figs/mearm.jpg
