RoboticsURJC/tfg-vperez/latex/Memoria/figs/mksdlc32.jpg

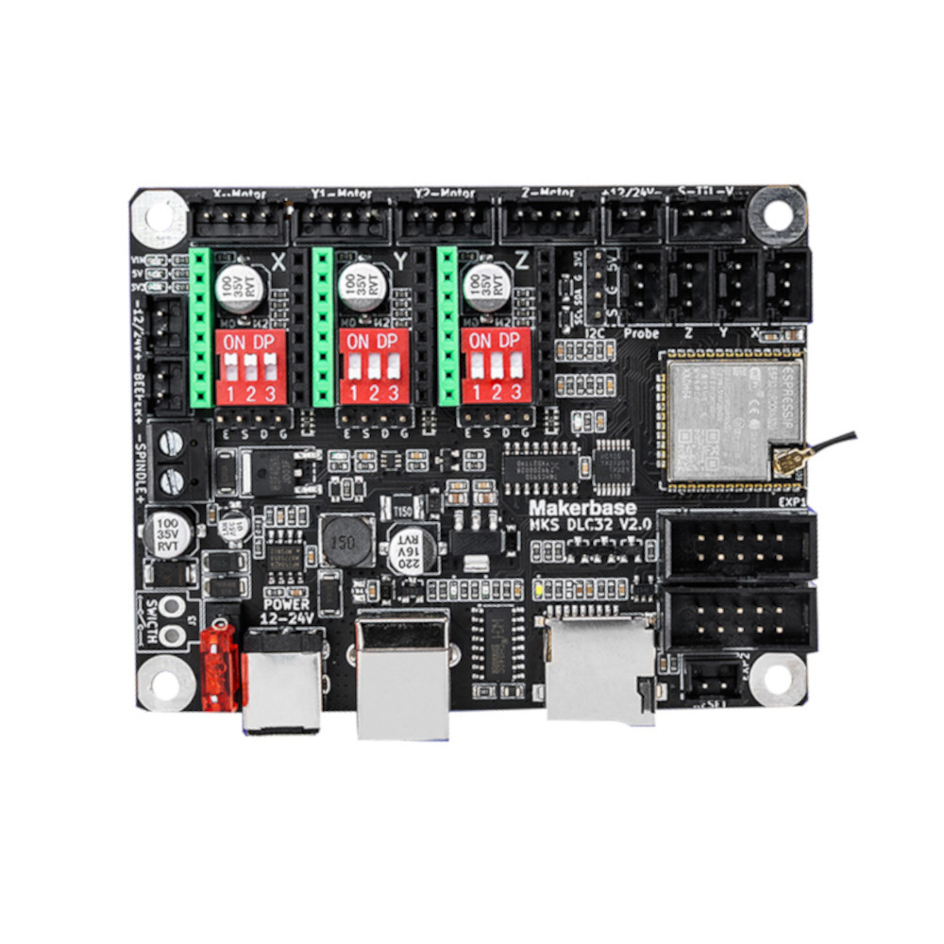
latex/Memoria/figs/mksdlc32.jpg
