RoboticsURJC/tfg-vperez/latex/Memoria/figs/nema17.jpg

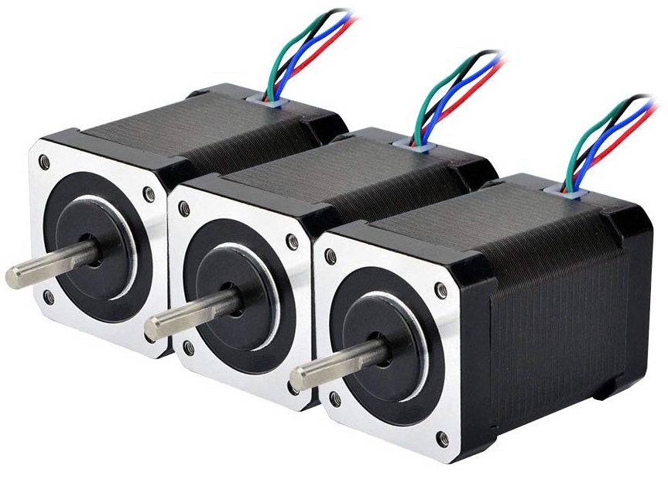
latex/Memoria/figs/nema17.jpg
