RoboticsURJC/tfg-vperez/latex/Memoria/figs/niryo.jpg

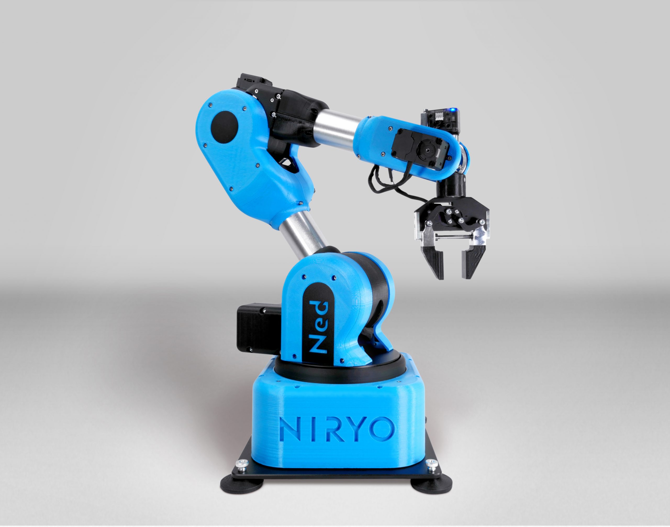
latex/Memoria/figs/niryo.jpg
