RoboticsURJC/tfg-vperez/latex/Memoria/figs/polea_freecad.png

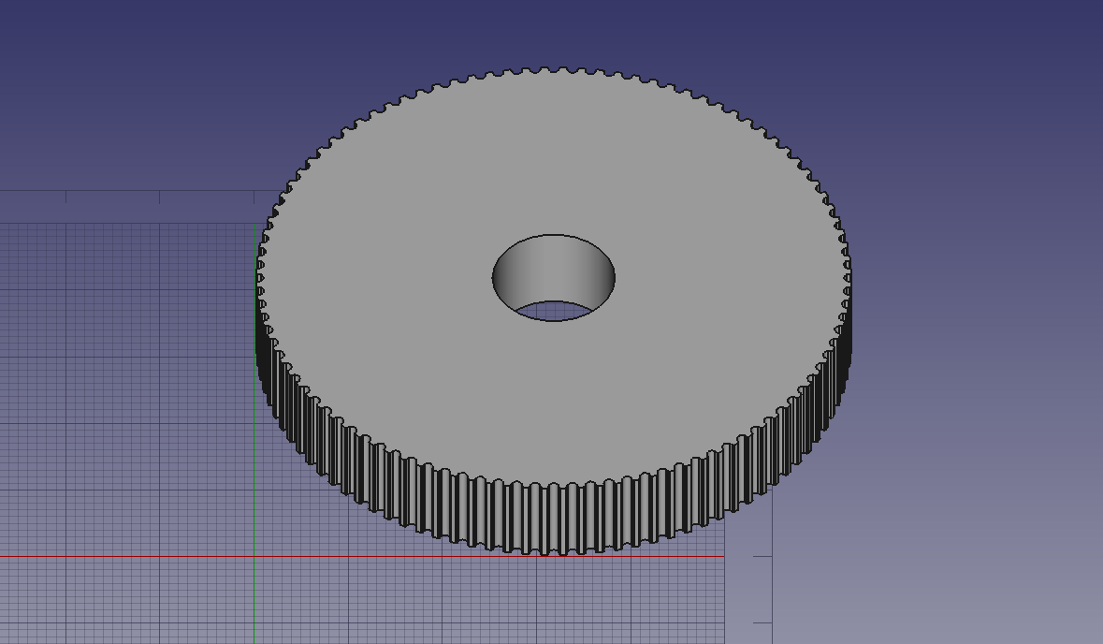
latex/Memoria/figs/polea_freecad.png
