RoboticsURJC/tfg-vperez/latex/Memoria/figs/polea_show1.png

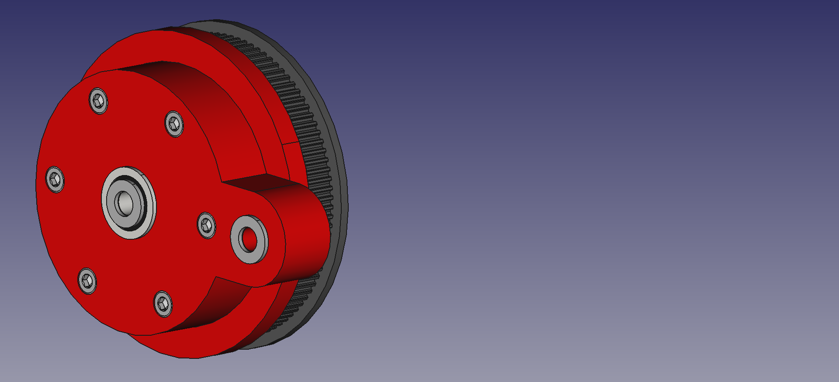
latex/Memoria/figs/polea_show1.png
