RoboticsURJC/tfg-vperez/latex/Memoria/figs/rebel4dof.jpg

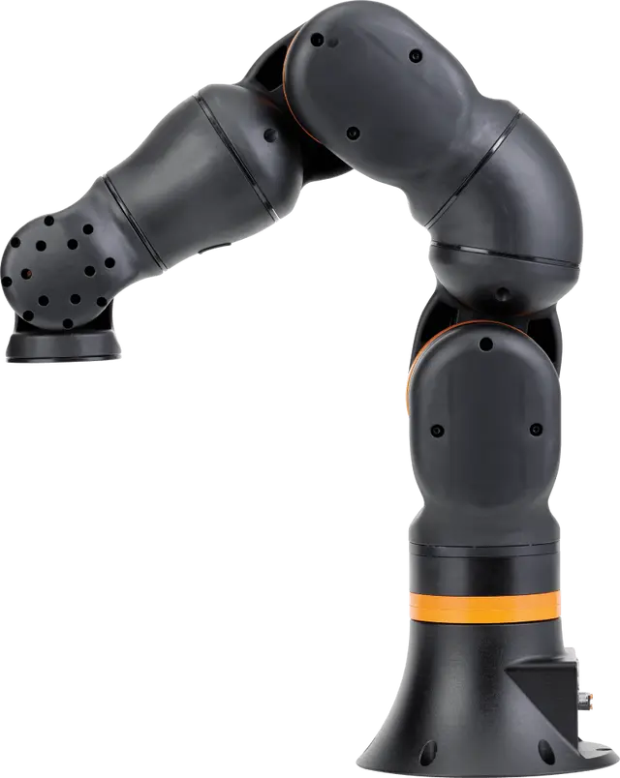
latex/Memoria/figs/rebel4dof.jpg
