RoboticsURJC/tfg-vperez/latex/Memoria/figs/roomba.jpg

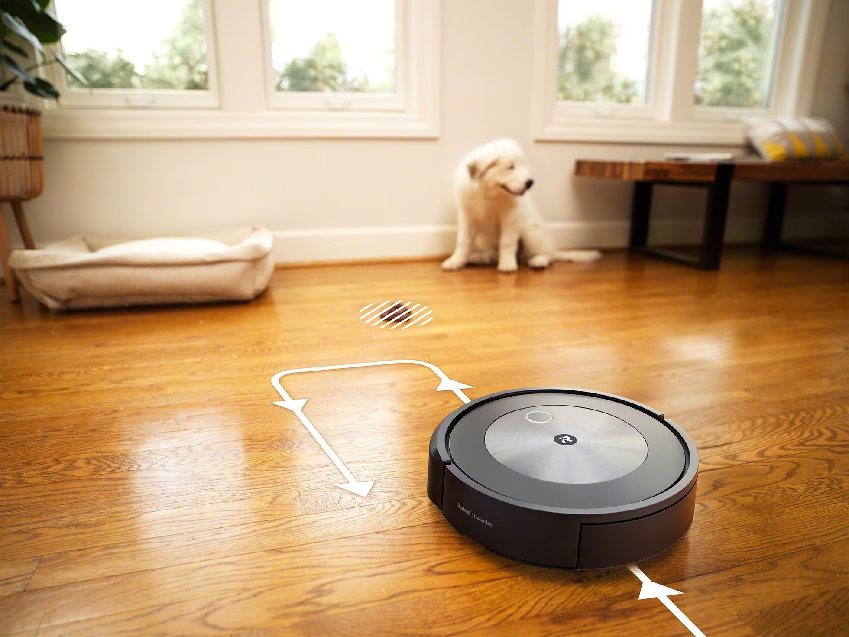
latex/Memoria/figs/roomba.jpg
