RoboticsURJC/tfg-vperez/latex/Memoria/figs/roombaAgua.jpg

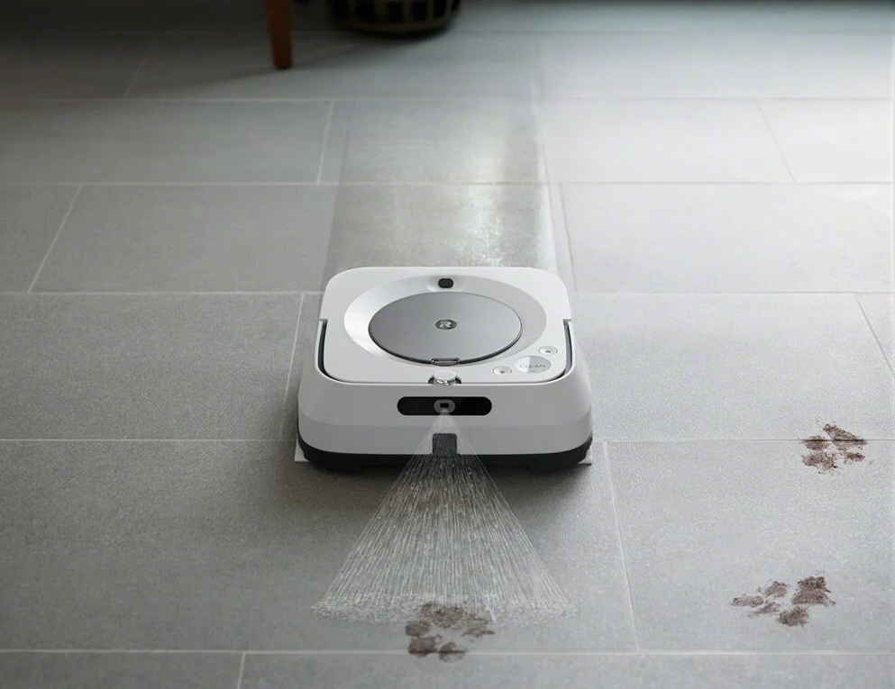
latex/Memoria/figs/roombaAgua.jpg
