RoboticsURJC/tfg-vperez/latex/Memoria/figs/rov.jpg

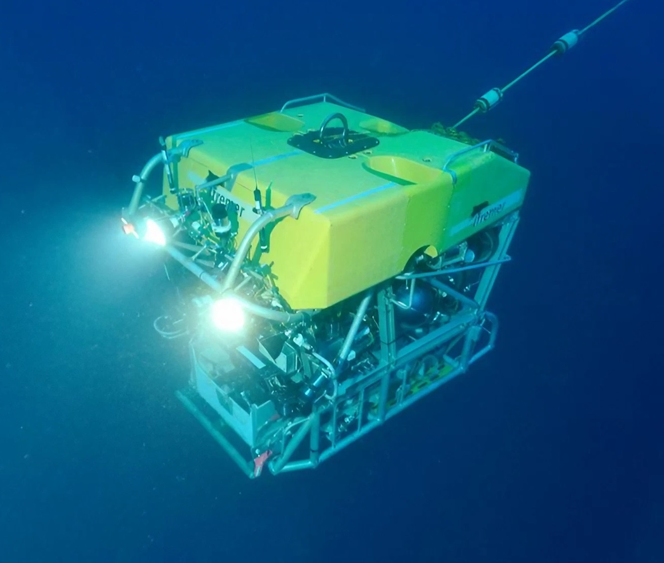
latex/Memoria/figs/rov.jpg
