RoboticsURJC/tfg-vperez/latex/Memoria/figs/smoothieboard.jpg

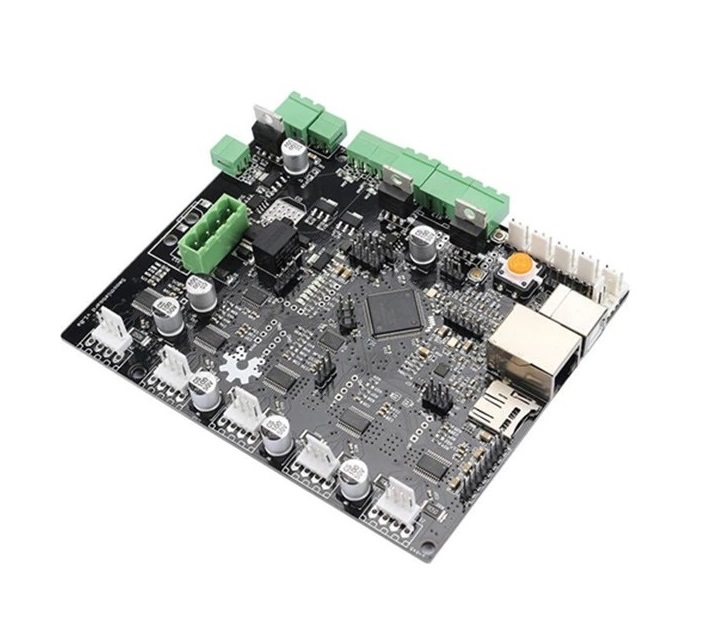
latex/Memoria/figs/smoothieboard.jpg
