RoboticsURJC/tfg-vperez/latex/Memoria/figs/tinyg.jpg

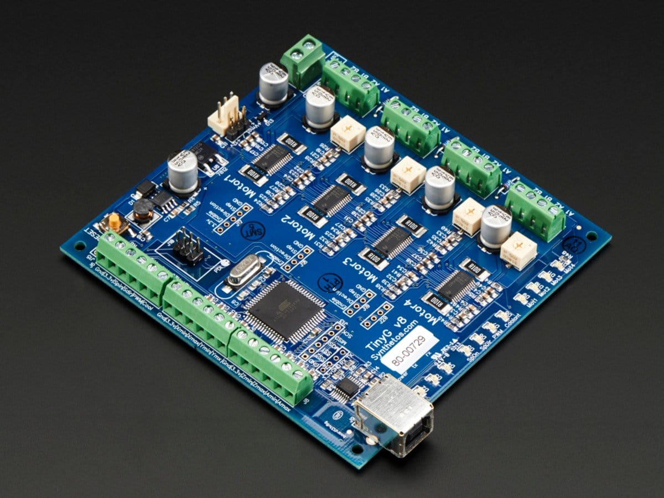
latex/Memoria/figs/tinyg.jpg
