RoboticsURJC/tfg-vperez/latex/Memoria/figs/tmc2208.jpg

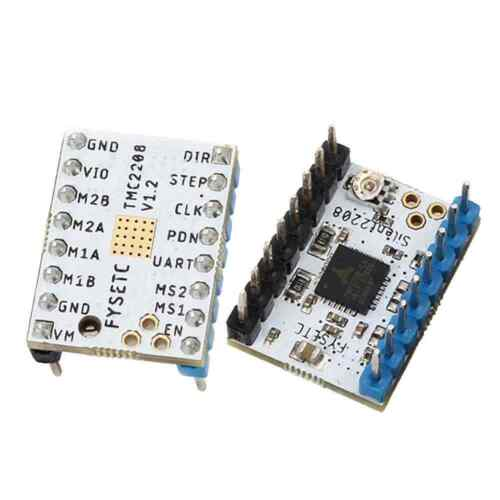
latex/Memoria/figs/tmc2208.jpg
