RoboticsURJC/tfg-vperez/latex/Memoria/figs/ToolTCP.png

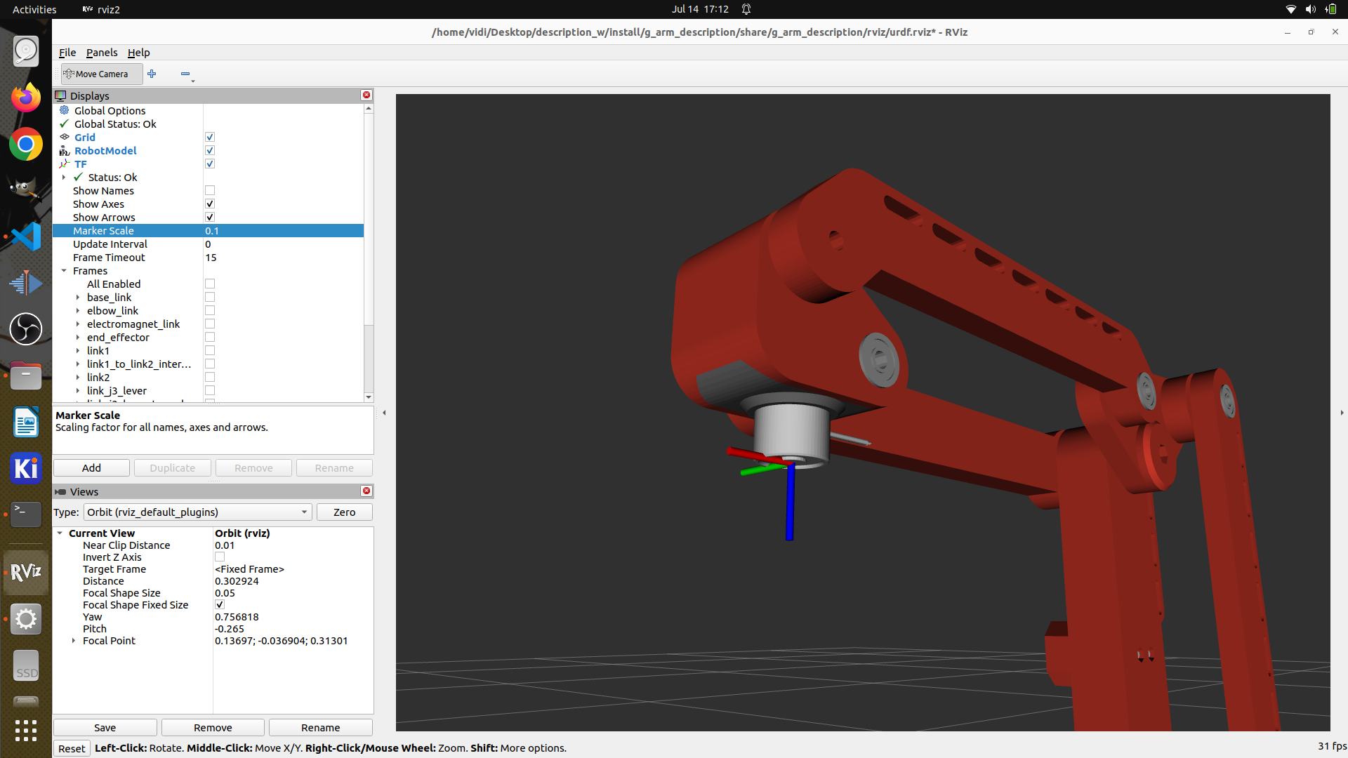
latex/Memoria/figs/ToolTCP.png
