RoboticsURJC/tfg-vperez/latex/Memoria/figs/tractor.jpg

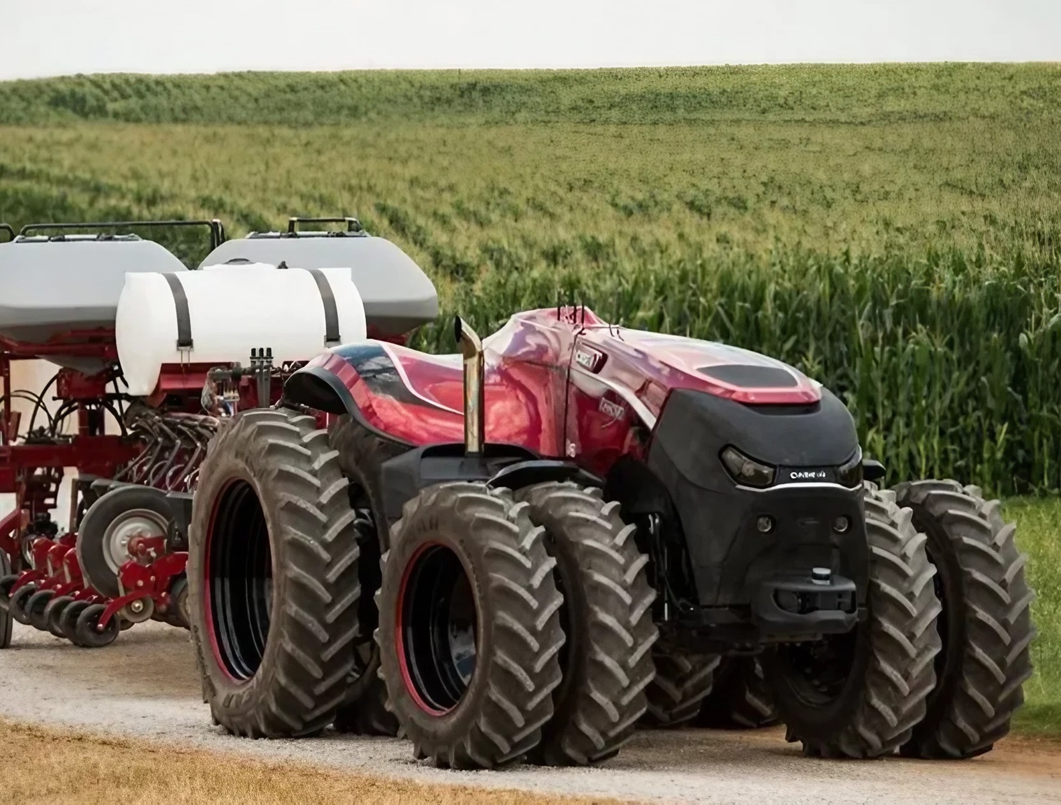
latex/Memoria/figs/tractor.jpg
