RoboticsURJC/tfg-vperez/latex/Memoria/figs/UART.png

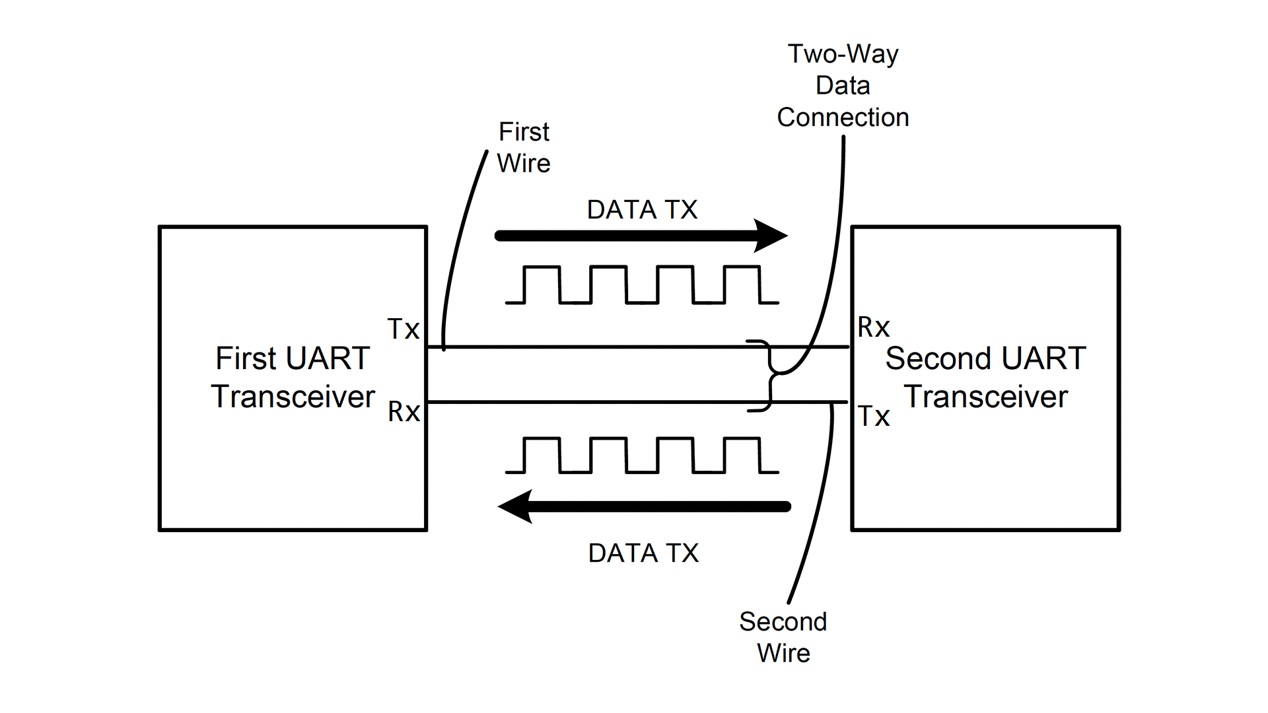
latex/Memoria/figs/UART.png
