RoboticsURJC/tfg-vperez/latex/Memoria/figs/waymo.jpg

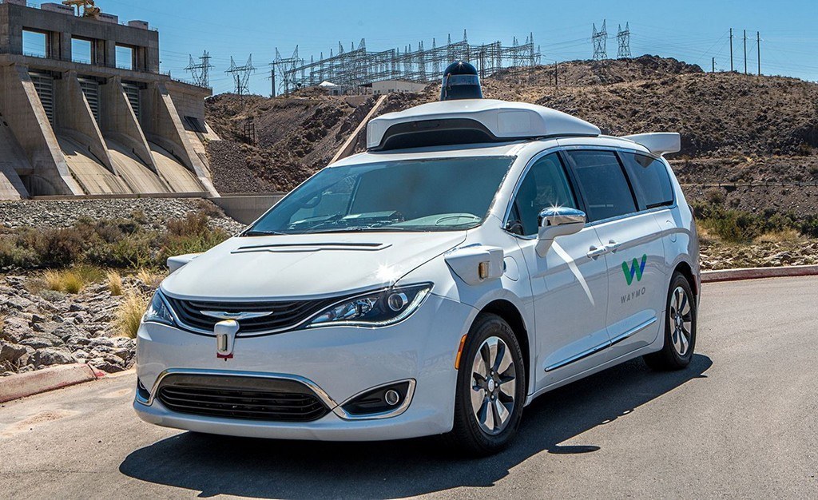
latex/Memoria/figs/waymo.jpg
