RoboticsURJC/tfg-vperez/latex/Memoria/figs/wifi.png

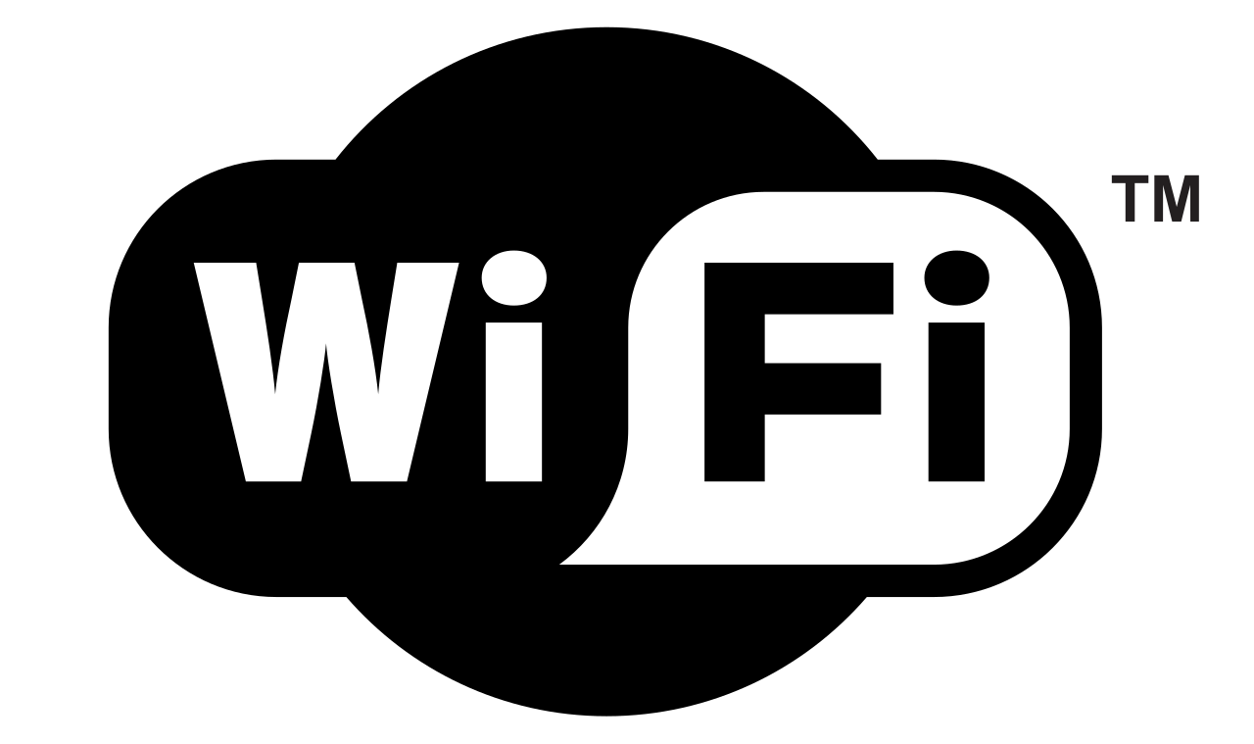
latex/Memoria/figs/wifi.png
