RoboticsURJC/tfg-vperez/latex/Presentacion/figs/freecadFiles.png

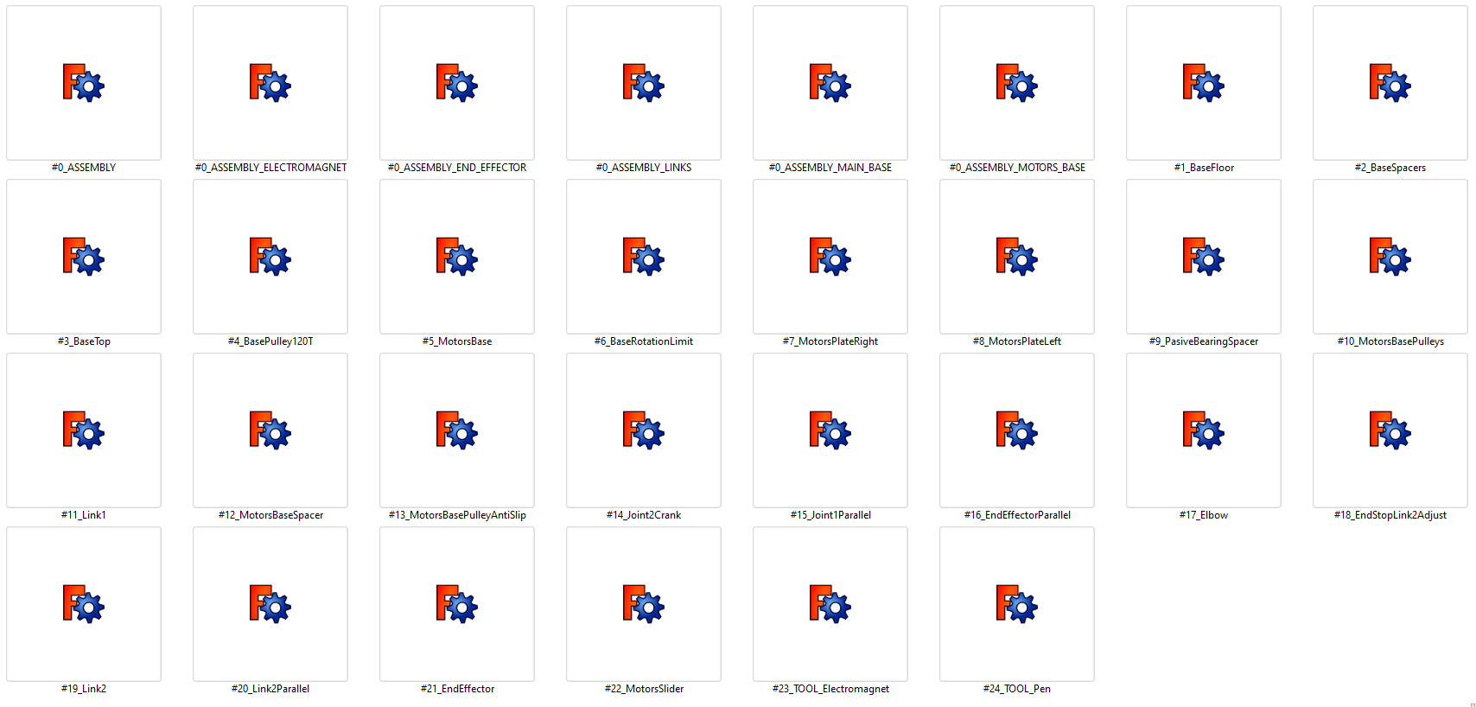
latex/Presentacion/figs/freecadFiles.png
