RoboticsURJC/tfg-vperez/latex/Presentacion/figs/gcode.jpg

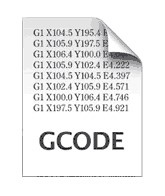
latex/Presentacion/figs/gcode.jpg
