RoboticsURJC/tfg-vperez/latex/Presentacion/figs/low_time.png

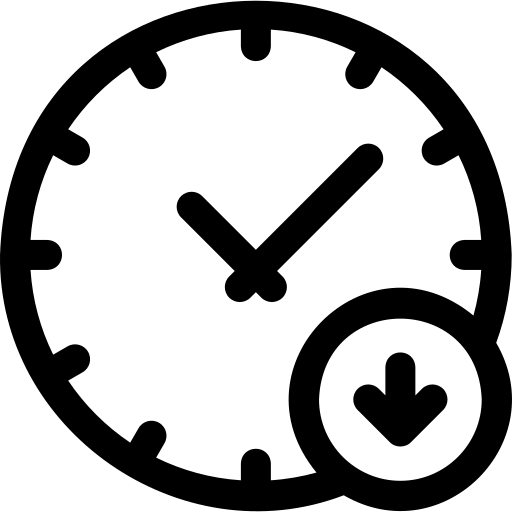
latex/Presentacion/figs/low_time.png
