RoboticsURJC/tfg-vperez/latex/Presentacion/figs/modelo_alambrico.png

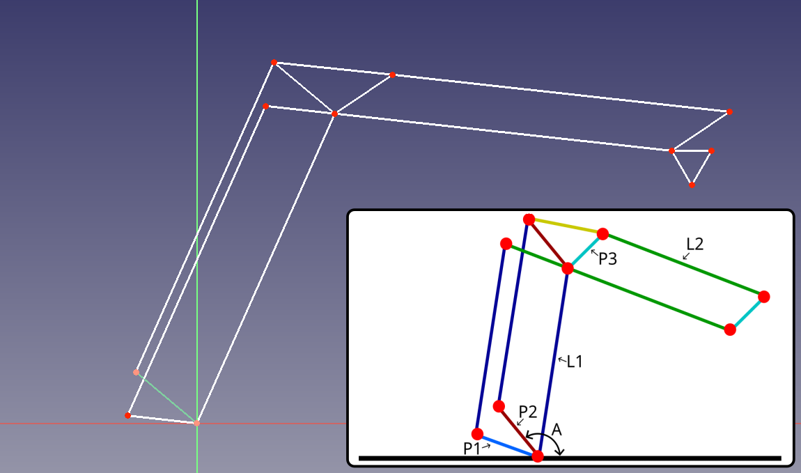
latex/Presentacion/figs/modelo_alambrico.png
