RoboticsURJC/tfg-vperez/latex/Presentacion/figs/people.png

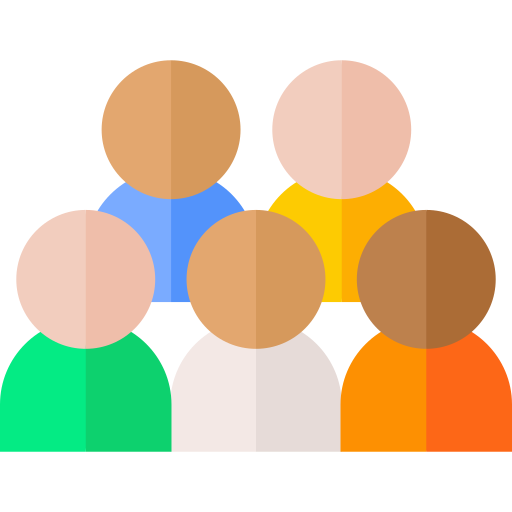
latex/Presentacion/figs/people.png
