RoboticsURJC/tfg-vperez/latex/Presentacion/figs/pinza.jpg

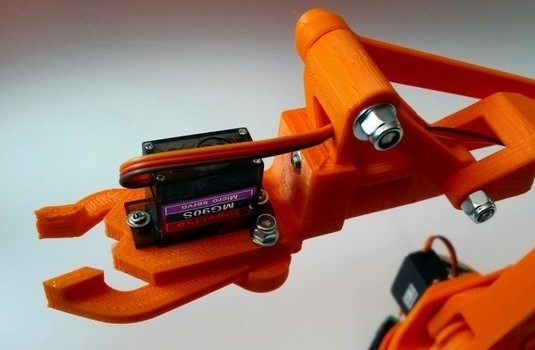
latex/Presentacion/figs/pinza.jpg
