RoboticsURJC/tfg-vperez/latex/Presentacion/figs/robot_arm.png

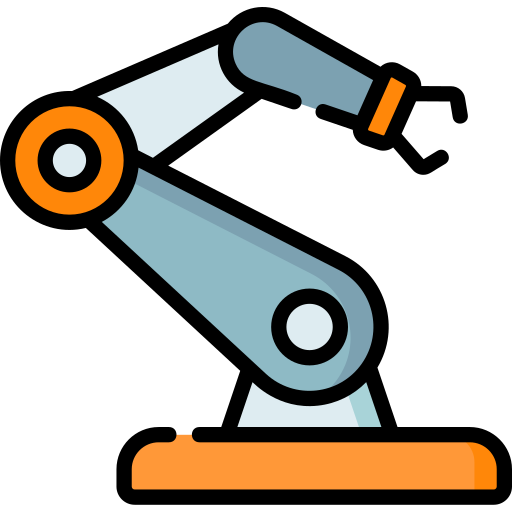
latex/Presentacion/figs/robot_arm.png
