RoboticsURJC/tfg-vperez/latex/Presentacion/figs/roomba.jpg

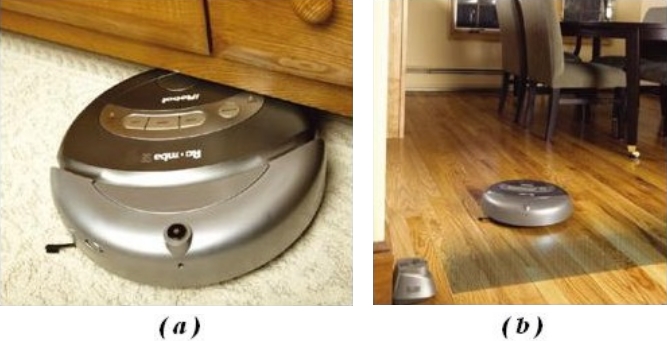
latex/Presentacion/figs/roomba.jpg
