RoboticsURJC/tfg-vperez/src/software/.g_arm_code/Examples/NutsAndBolts/imageExample.jpg

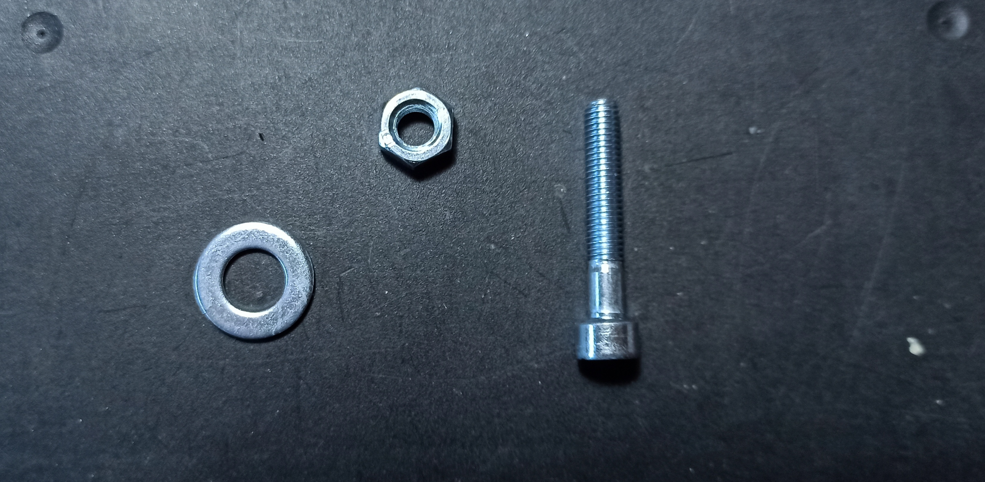
src/software/.g_arm_code/Examples/NutsAndBolts/imageExample.jpg
