RoboticsURJC/tfg-vperez/img/linkParts.png

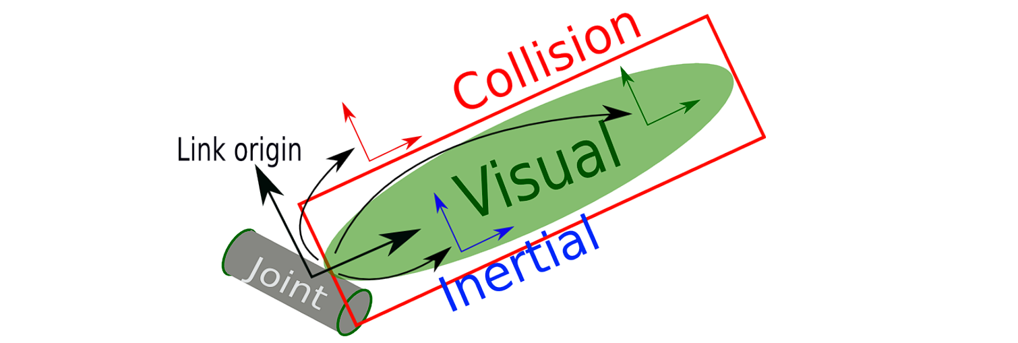
img/linkParts.png
