RoboticsURJC/tfg-vperez/src/design/FreeCad/#0_ASSEMBLY_ELECTROMAGNET.FCStd

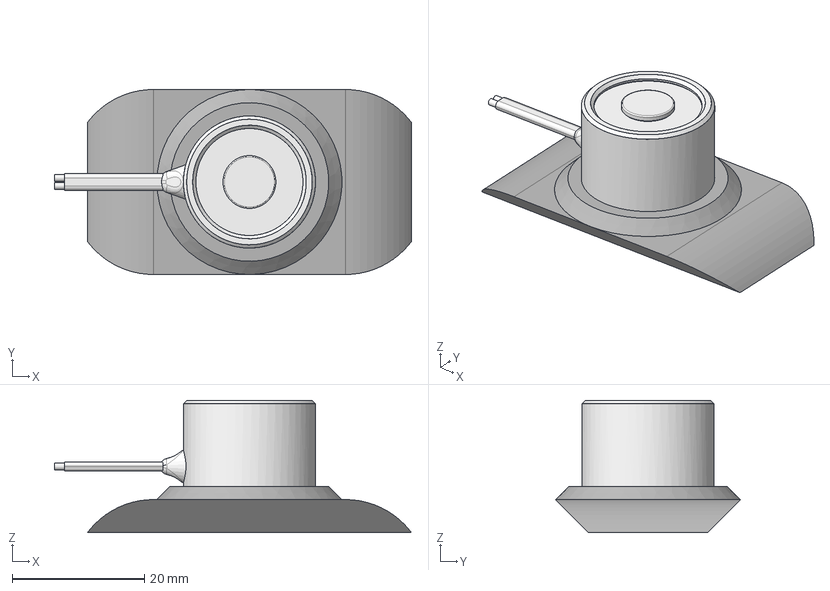
[picture p271: CAD file, 2023-07-20]
src/design/FreeCad/#0_ASSEMBLY_ELECTROMAGNET.FCStd
54.0 x 28.0 x 20.0 mm
#23_TOOL_Electromagnet_001
electromagnet1_001
