RoboticsURJC/tfg-vperez/src/design/FreeCad/#0_ASSEMBLY_MOTORS_BASE.FCStd

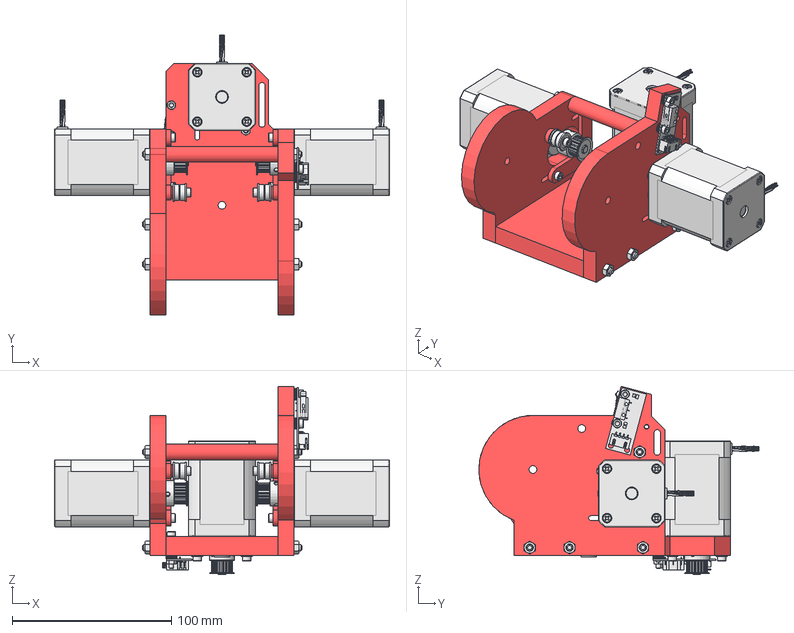
[picture p272: CAD file, 2023-07-20]
src/design/FreeCad/#0_ASSEMBLY_MOTORS_BASE.FCStd
210.2 x 176.0 x 118.2 mm
#5_MotorsBase_001
#7_MotorsPlateRight_001
#8_MotorsPlateLeft_001
#12_MotorsBaseSpacer_001
M4-Tuerca
M4-Tuerca001
M4-Tuerca002
M4-Tuerca006
M4-Tuerca007
M4-Tuerca008
M3-Tuerca
M3-Tuerca001
M4-Tuerca009
M3-Tuerca003
M3-Tuerca004
M3-Tuerca005
M3-Tuerca006
M4x100-Barra roscada
M4-Tuerca012
M4x100-Barra roscada001
M4x100-Barra roscada002
M4x100-Barra roscada003
M4-Tuerca011
M5-Arandela
#22_MotorsSlider_001
#22_MotorsSlider_002
M3x16-Tornillo
M3x16-Tornillo001
M3x16-Tornillo002
M3x16-Tornillo006
M3x16-Tornillo007
M3x16-Tornillo008
NEMA171_001
NEMA171_002
GT2_20T1_001
GT2_20T1_002
NEMA171_003
GT2_20T1_003
M3-Arandela
M3-Arandela003
M3-Arandela004
M3x16-Tornillo009
M3x16-Tornillo010
M3x16-Tornillo011
Endstop1_001
M3-Arandela005
M3-Arandela006
M3-Arandela007
M3-Arandela008
M3-Arandela009
M3-Arandela010
M3-Arandela011
M3-Arandela012
M3-Arandela013
M3-Arandela014
M3-Arandela015
M3-Arandela016
M3-Arandela021
M3-Arandela020
M3x20-Tornillo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
