RoboticsURJC/tfg-vperez/src/design/FreeCad/#0_ASSEMBLY_LINKS.FCStd

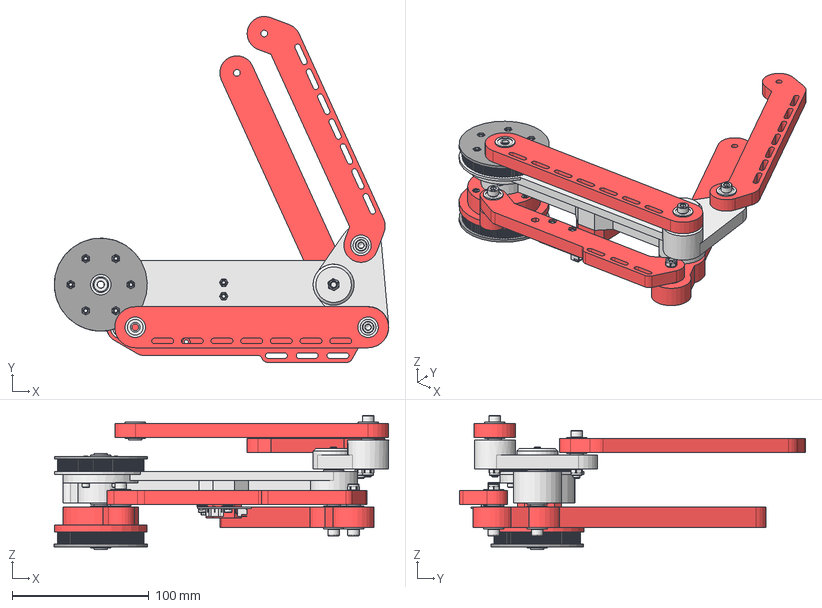
[picture p273: CAD file, 2023-07-17]
src/design/FreeCad/#0_ASSEMBLY_LINKS.FCStd
244.2 x 252.6 x 98.0 mm
#11_Link1_001
F6951_001
F6951_002
F6951_003
F6951_004
F6951_006
F6951_007
F6951_008
F6951_009
F6951_010
#10_MotorsBasePulleys_001
M3x30-Tornillo
M3x30-Tornillo001
M3x30-Tornillo002
M3x30-Tornillo003
M3x20-Tornillo
M3x20-Tornillo001
M3-Tuerca
M3-Tuerca001
M3-Tuerca002
M3-Tuerca003
M3-Tuerca004
M3-Tuerca005
M3-Tuerca008
M3-Tuerca009
#18_EndStopLink2Adjust_001
M3x30-Tornillo006
M3x30-Tornillo005
M5-Arandela_001
M5-Arandela_002
M5-Arandela_003
M5-Arandela_004
#19_Link2_001
#14_Joint2Crank_001
F6951_011
F6951_012
#13_MotorsBasePulleyAntiSlip_001
#10_MotorsBasePulleys_002
M3-Tuerca010
M3-Tuerca011
M3-Tuerca012
M3-Tuerca013
M3-Tuerca014
M3-Tuerca015
M5-Arandela_005
M5-Arandela_006
#17_Elbow_001
M5-Arandela_007
M5-Arandela_009
#15_Joint1Parallel_001
F6951_005
M5-Arandela_008
F6951_013
#20_Link2Parallel_001
#16_EndEffectorParallel_001
F6951_014
M5-Arandela_010
M5-Arandela_011
F6951_015
F6951_016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
