RoboticsURJC/tfg-vperez/src/design/FreeCad/#0_ASSEMBLY_END_EFFECTOR.FCStd

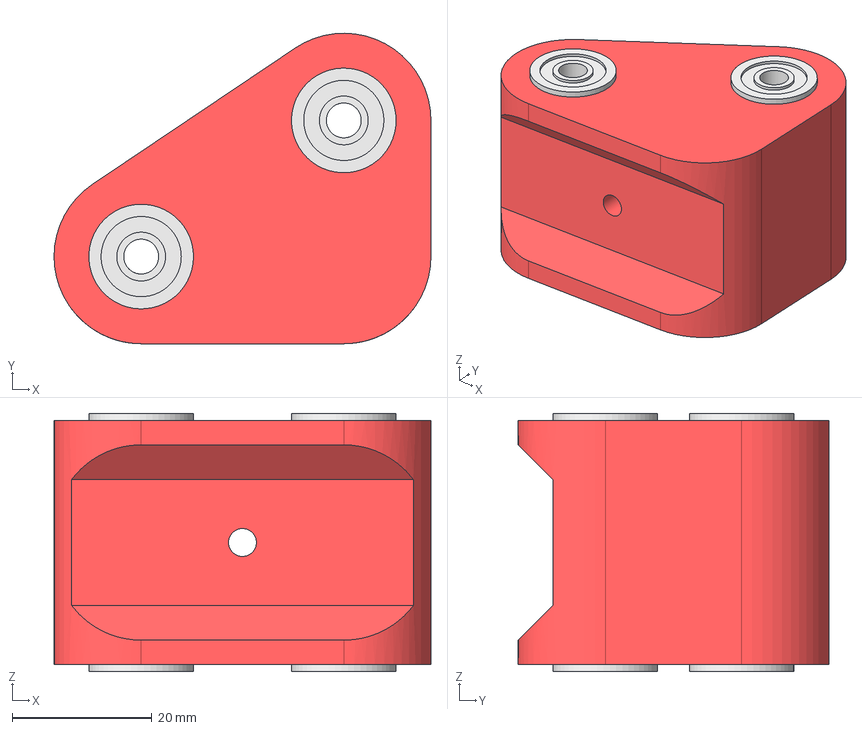
[picture p274: CAD file, 2023-07-10]
src/design/FreeCad/#0_ASSEMBLY_END_EFFECTOR.FCStd
54.1 x 44.5 x 37.0 mm
#21_EndEffector_001
F6951_001
F6951_002
F6951_003
F6951_004
