RoboticsURJC/tfg-vperez/src/design/FreeCad/#0_ASSEMBLY.FCStd

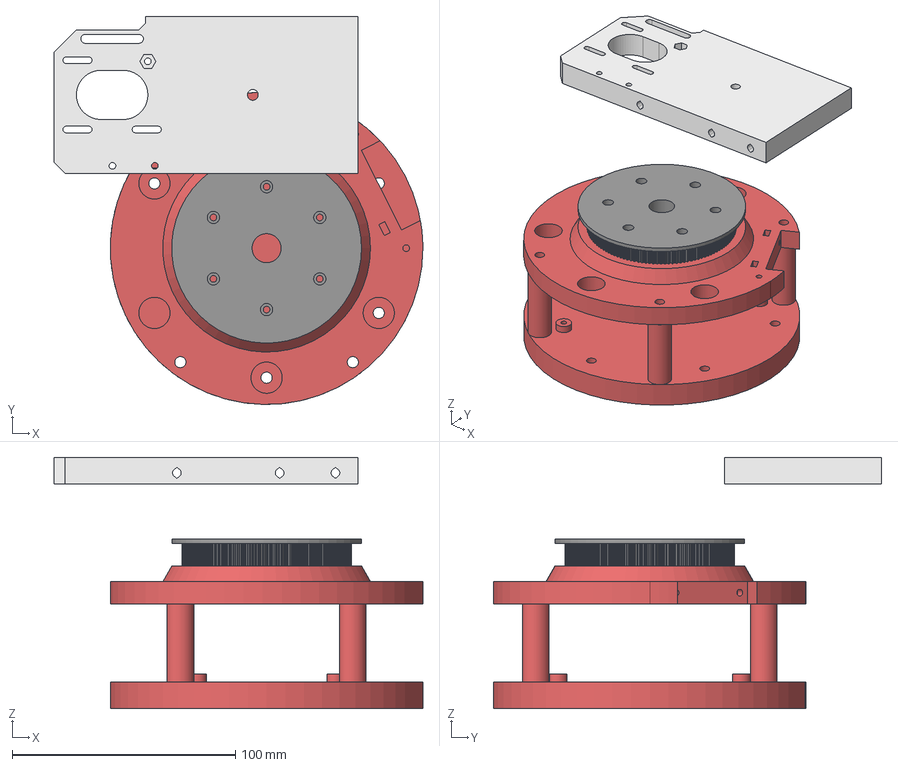
[picture p276: CAD file, 2023-05-02]
src/design/FreeCad/#0_ASSEMBLY.FCStd
165.2 x 173.7 x 112.6 mm
#1_BaseFloor_001
#2_BaseSpacers_001
#2_BaseSpacers_002
#2_BaseSpacers_003
#2_BaseSpacers_004
#3_BaseTop_001
#4_BasePulley120T_001
#5_MotorsBase_001
