RoboticsURJC/tfg-vperez/src/design/FreeCad/#24_TOOL_Pen.FCStd

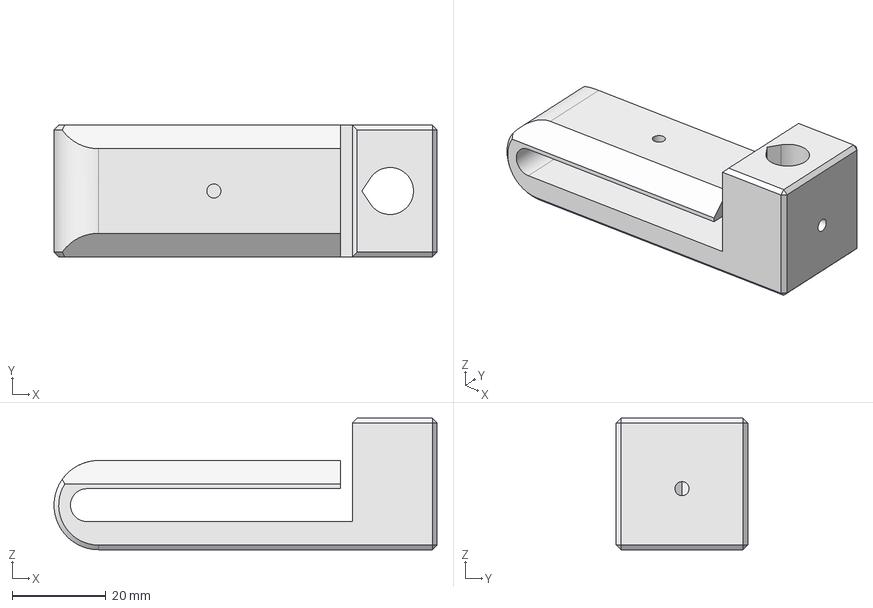
[picture p278: CAD file, 2023-09-24]
src/design/FreeCad/#24_TOOL_Pen.FCStd
81.5 x 28.0 x 28.0 mm
