RoboticsURJC/tfg-vperez/src/software/g_arm_description/meshes/elbow.stl

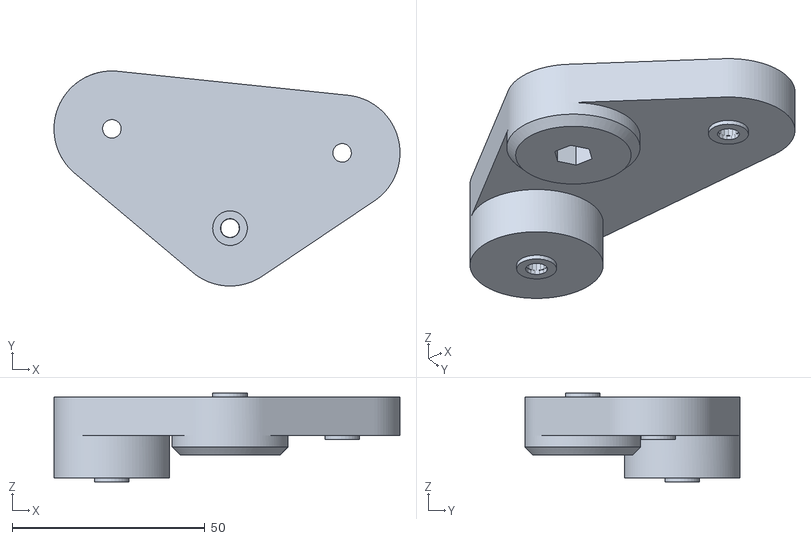
[picture p279: CAD file, 2023-06-05]
src/software/g_arm_description/meshes/elbow.stl
89.7 x 55.7 x 23.0
