RoboticsURJC/tfg-vperez/src/design/Complements/NEMA17.step

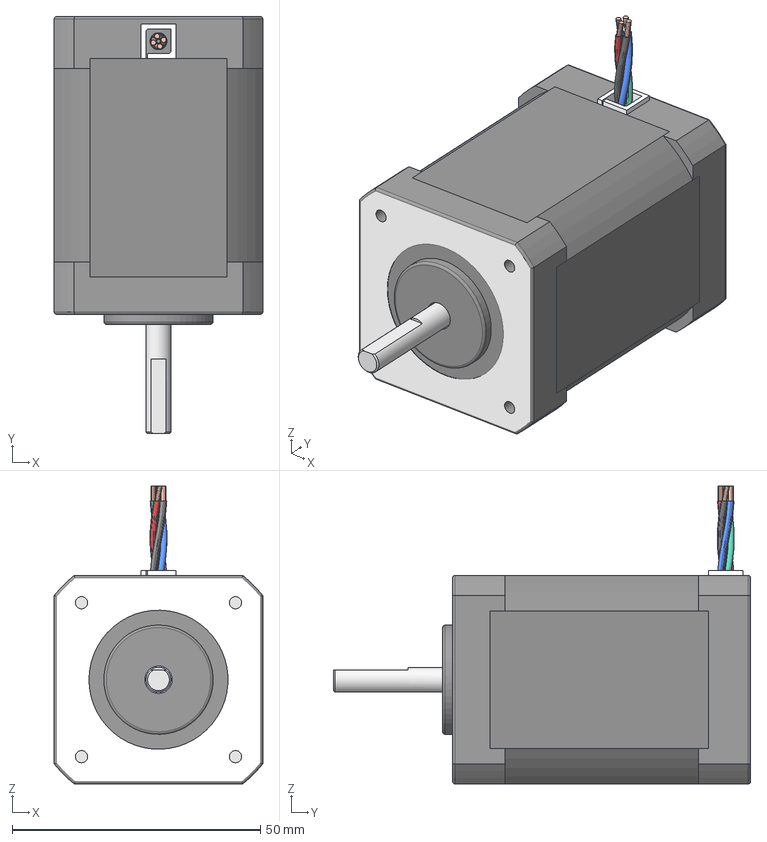
[picture p280: CAD file, 2023-07-06]
src/design/Complements/NEMA17.step
42.0 x 84.0 x 60.0 mm
Copper-2of4
Frontplate
Backplate
Connenctor
Housing
Bearing dummy
Bearing dummy 01
Core
M3x52-Screw
M3x52-Screw007
M3x52-Screw008
M3x52-Screw009
Cable-1of4
Copper-1of4
Cable-2of4
Copper-4of4
Cable-3of4
Copper-3of4
Cable-4of4
