RoboticsURJC/tfg-vperez/src/software/g_arm_description/meshes/link_j3_lever.stl

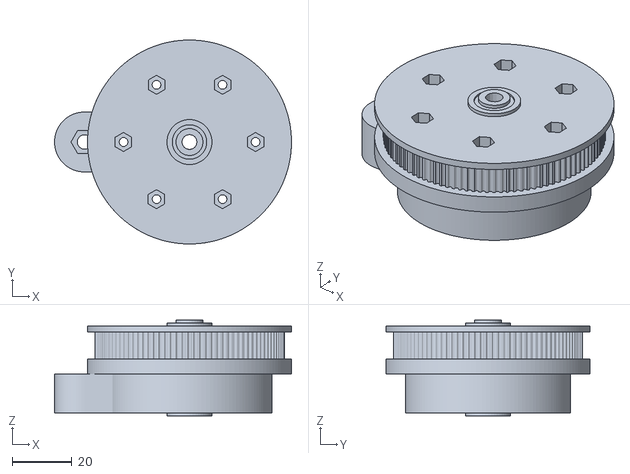
[picture p281: CAD file, 2023-06-05]
src/software/g_arm_description/meshes/link_j3_lever.stl
79.0 x 68.0 x 32.0
