RoboticsURJC/tfg-vperez/src/design/Complements/F623.step

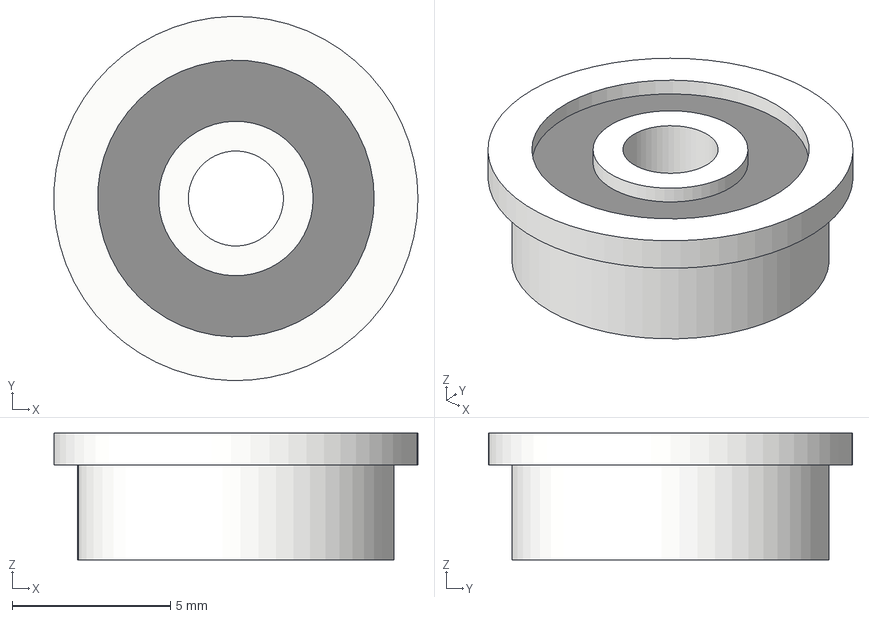
[picture p282: CAD file, 2023-07-06]
src/design/Complements/F623.step
11.5 x 11.5 x 4.00 mm
