RoboticsURJC/tfg-vperez/src/software/g_arm_description/meshes/end.stl

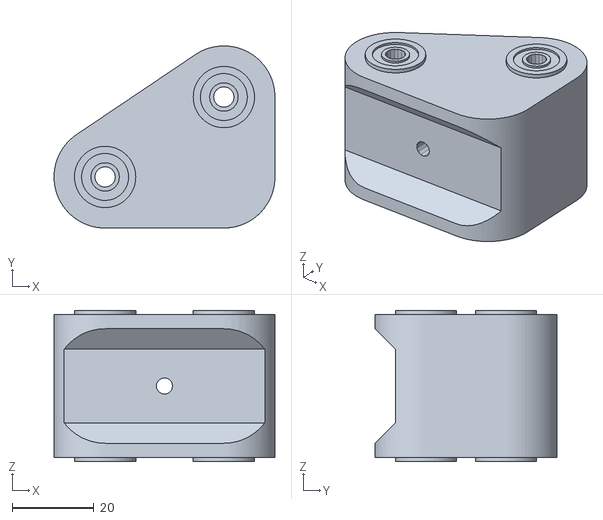
[picture p283: CAD file, 2023-06-05]
src/software/g_arm_description/meshes/end.stl
54.0 x 44.5 x 37.0
