RoboticsURJC/tfg-vperez/src/design/Complements/Endstop.step

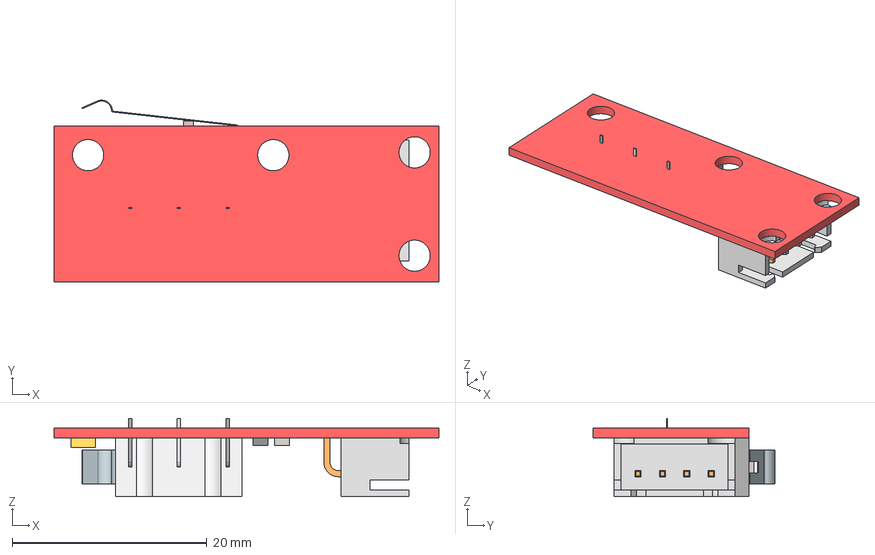
[picture p284: CAD file, 2023-07-06]
src/design/Complements/Endstop.step
39.5 x 18.6 x 8.02 mm
PCB Geometry
PCB^Endstop
Microswitch_1A_125vAC(seul)
JST 4Pin
