RoboticsURJC/tfg-vperez/src/software/g_arm_description/meshes/link2.stl

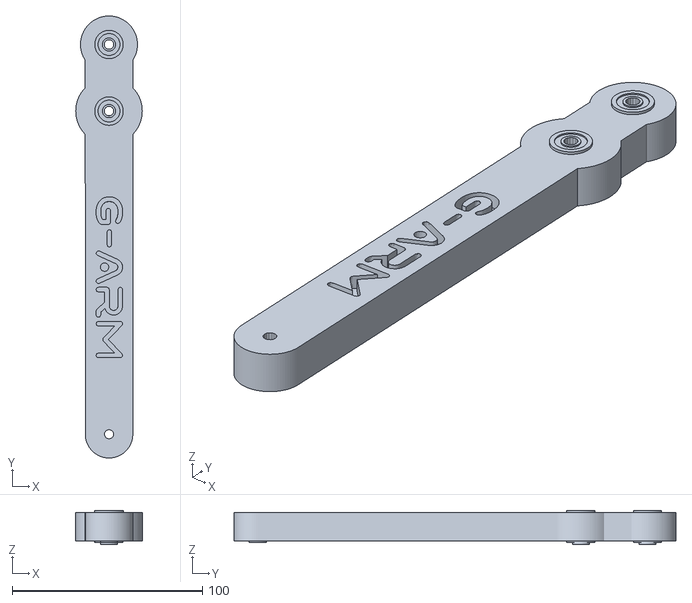
[picture p285: CAD file, 2023-06-05]
src/software/g_arm_description/meshes/link2.stl
35.0 x 232.5 x 18.0
