RoboticsURJC/tfg-vperez/src/design/Complements/GT2_20T.step

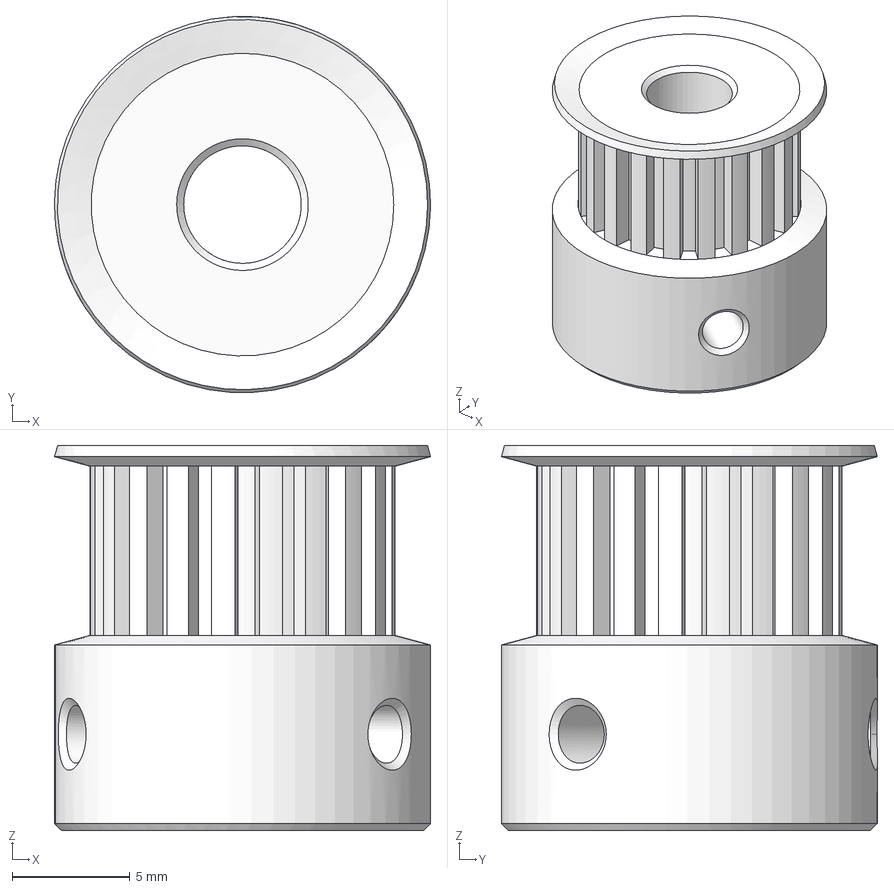
[picture p286: CAD file, 2023-07-06]
src/design/Complements/GT2_20T.step
16.0 x 16.0 x 16.4 mm
