RoboticsURJC/tfg-vperez/src/design/FreeCad/#15_Joint1Parallel.FCStd

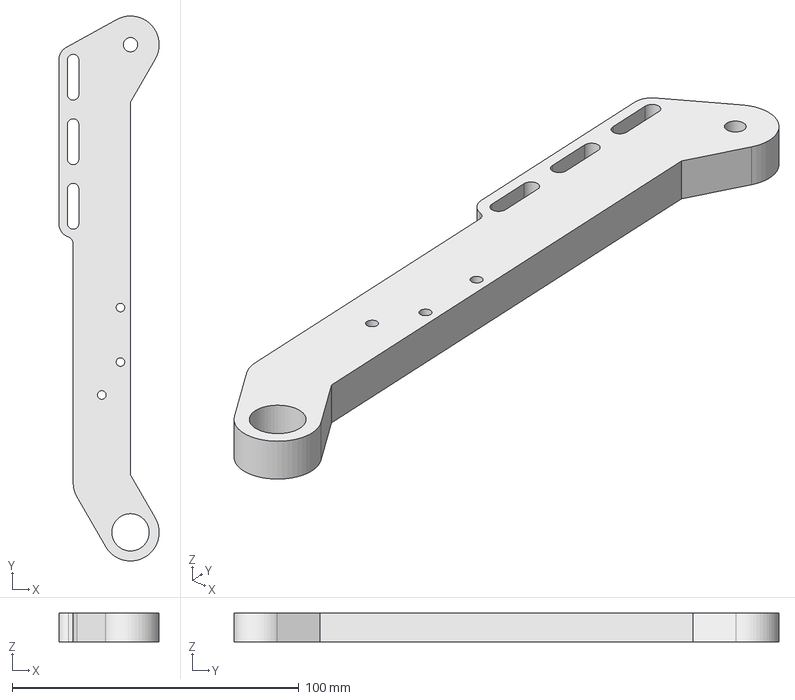
[picture p287: CAD file, 2023-07-17]
src/design/FreeCad/#15_Joint1Parallel.FCStd
35.0 x 190.0 x 10.0 mm
