RoboticsURJC/tfg-vperez/src/software/g_arm_description/meshes/link1.stl

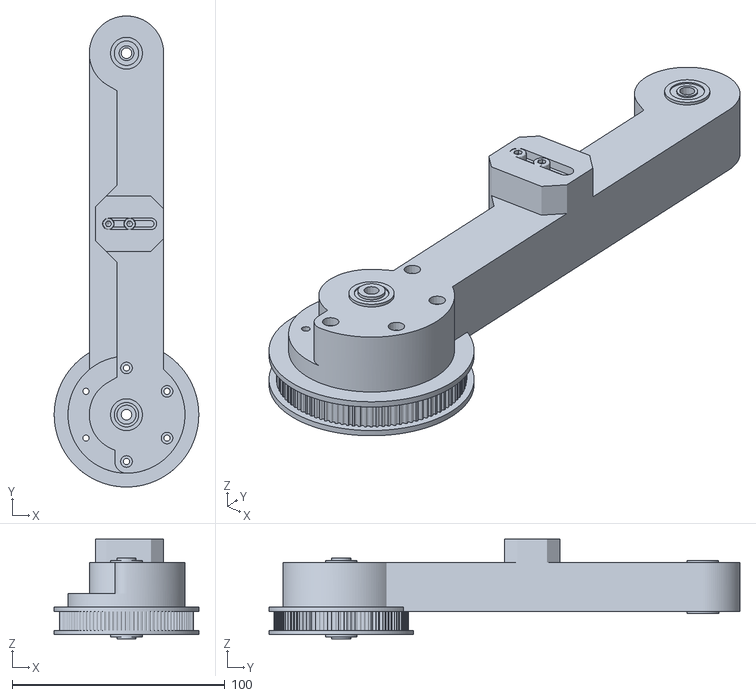
[picture p288: CAD file, 2023-06-05]
src/software/g_arm_description/meshes/link1.stl
68.0 x 221.5 x 47.0
