RoboticsURJC/tfg-vperez/src/design/Complements/F695.step

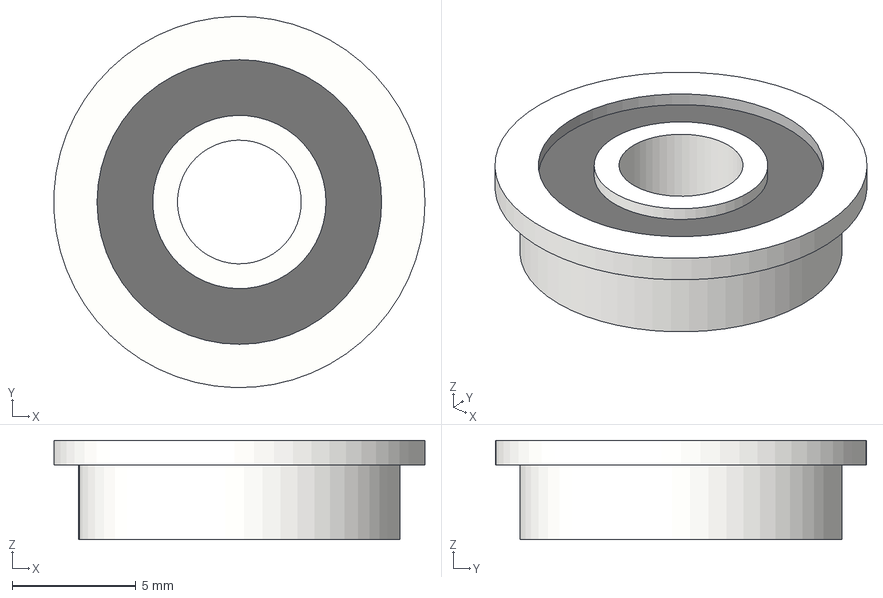
[picture p289: CAD file, 2023-07-04]
src/design/Complements/F695.step
15.0 x 15.0 x 4.00 mm
