RoboticsURJC/tfg-vperez/src/design/FreeCad/#21_EndEffector.FCStd

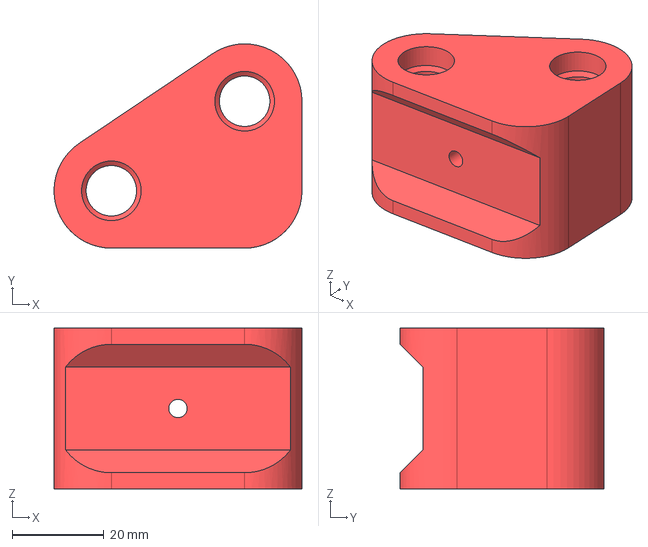
[picture p290: CAD file, 2023-07-14]
src/design/FreeCad/#21_EndEffector.FCStd
54.1 x 44.5 x 35.0 mm
