RoboticsURJC/tfg-vperez/src/software/g_arm_description/meshes/parallel_end_link1.stl

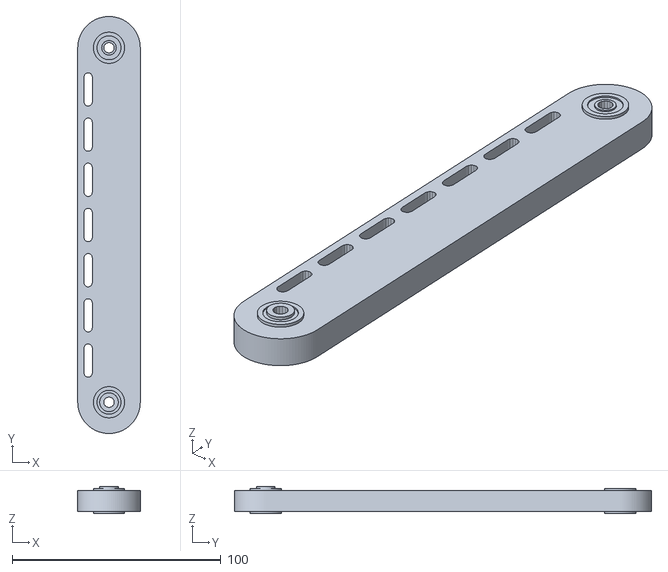
[picture p291: CAD file, 2023-06-05]
src/software/g_arm_description/meshes/parallel_end_link1.stl
30.0 x 200.0 x 13.0
