RoboticsURJC/tfg-vperez/src/design/FreeCad/#23_TOOL_Electromagnet.FCStd

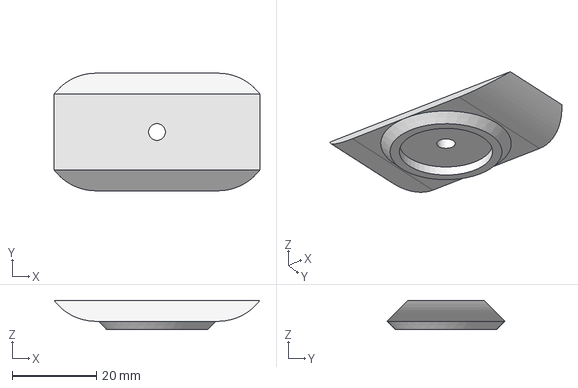
[picture p292: CAD file, 2023-07-10]
src/design/FreeCad/#23_TOOL_Electromagnet.FCStd
49.0 x 28.0 x 7.00 mm
