RoboticsURJC/tfg-vperez/src/software/g_arm_description/meshes/parallel_end_link2.stl

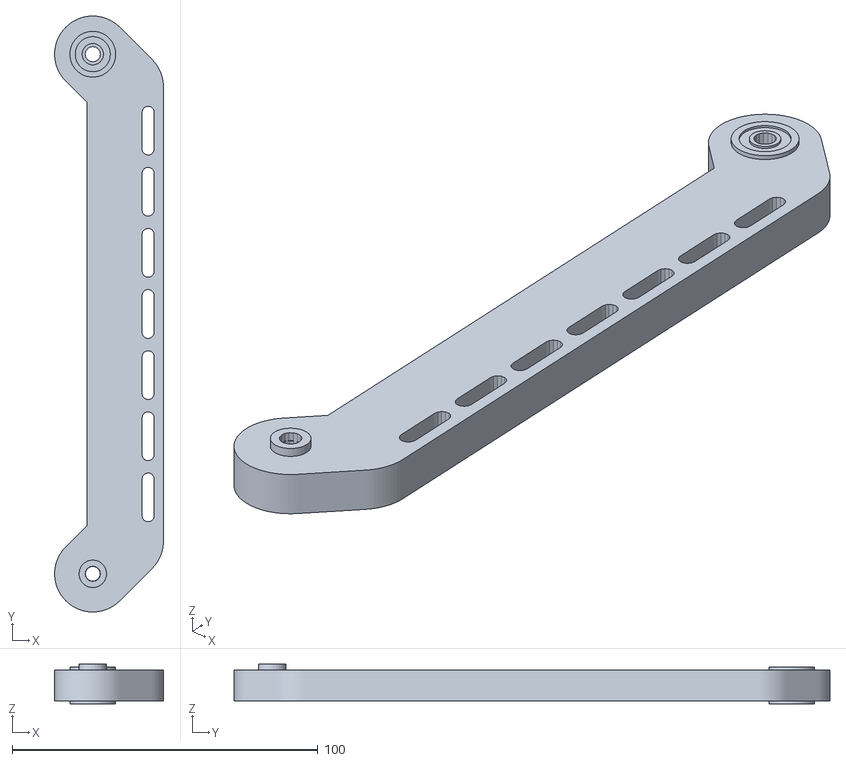
[picture p293: CAD file, 2023-06-05]
src/software/g_arm_description/meshes/parallel_end_link2.stl
35.6 x 195.0 x 13.0
