RoboticsURJC/tfg-vperez/src/software/g_arm_description/meshes/link_j3_rod.stl

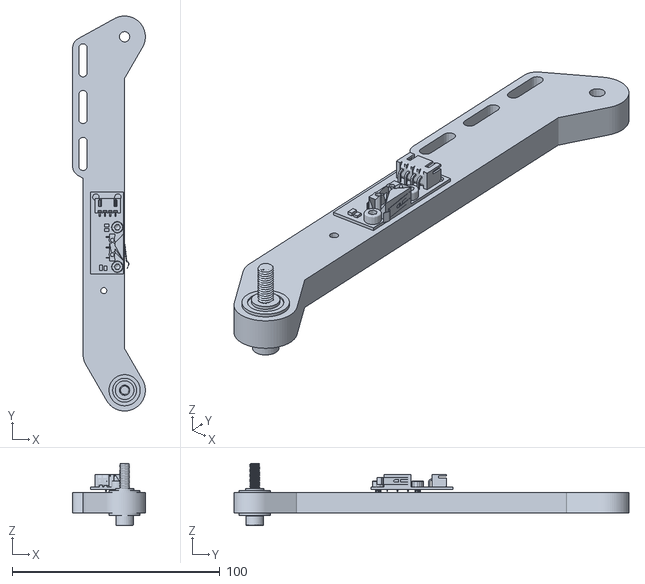
[picture p294: CAD file, 2023-06-05]
src/software/g_arm_description/meshes/link_j3_rod.stl
35.0 x 190.0 x 30.0
