RoboticsURJC/tfg-vperez/src/design/FreeCad/#14_Joint2Crank.FCStd

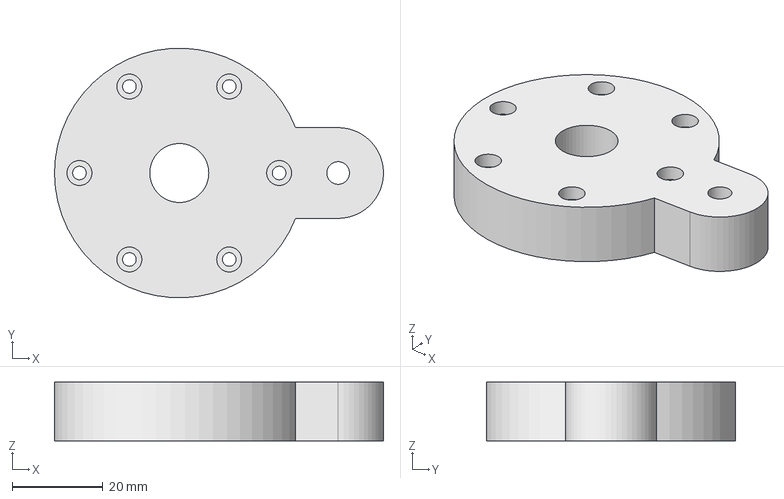
[picture p295: CAD file, 2023-07-10]
src/design/FreeCad/#14_Joint2Crank.FCStd
72.5 x 54.9 x 13.0 mm
