RoboticsURJC/tfg-vperez/src/design/FreeCad/#17_Elbow.FCStd

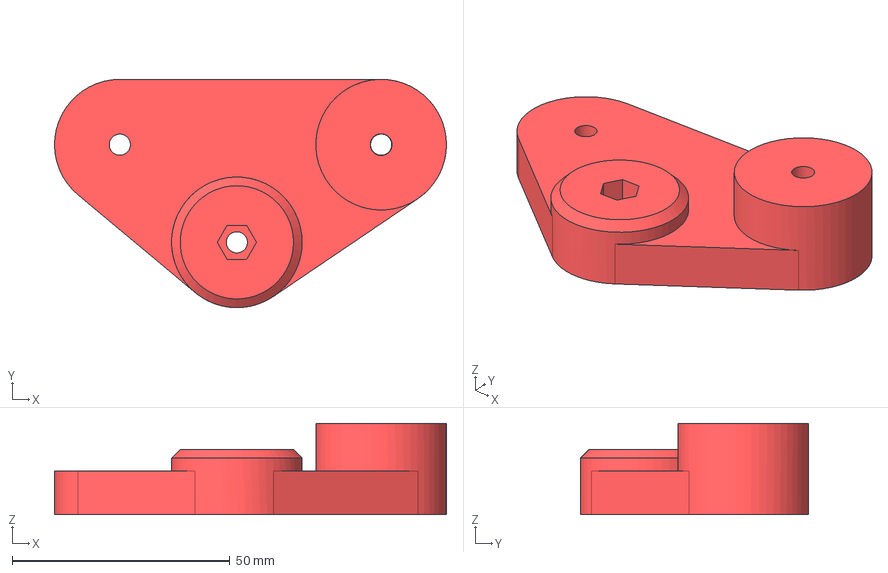
[picture p296: CAD file, 2023-07-10]
src/design/FreeCad/#17_Elbow.FCStd
90.0 x 52.4 x 21.0 mm
