RoboticsURJC/tfg-vperez/src/design/FreeCad/#19_Link2.FCStd

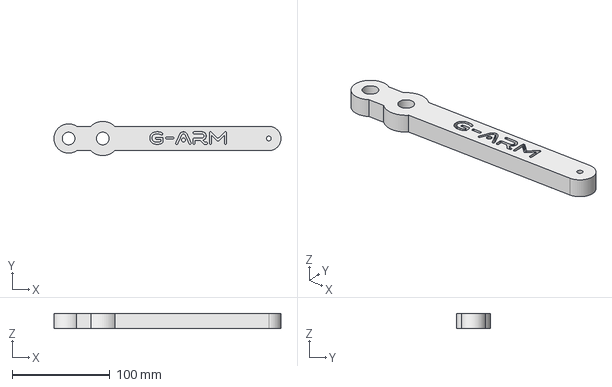
[picture p297: CAD file, 2023-07-10]
src/design/FreeCad/#19_Link2.FCStd
232.5 x 34.9 x 15.0 mm
