RoboticsURJC/tfg-vperez/src/design/FreeCad/#11_Link1.FCStd

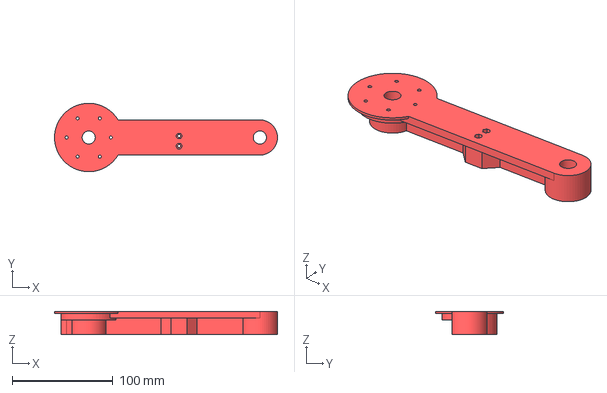
[picture p298: CAD file, 2023-07-06]
src/design/FreeCad/#11_Link1.FCStd
221.5 x 67.9 x 23.0 mm
