RoboticsURJC/tfg-vperez/src/design/FreeCad/#5_MotorsBase.FCStd

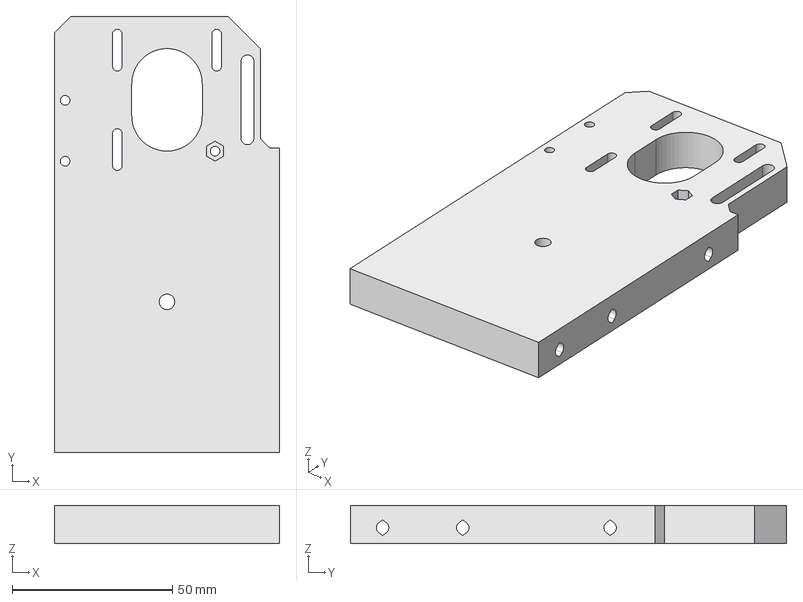
[picture p299: CAD file, 2023-07-05]
src/design/FreeCad/#5_MotorsBase.FCStd
70.2 x 136.0 x 12.0 mm
