RoboticsURJC/tfg-vperez/src/design/FreeCad/#20_Link2Parallel.FCStd

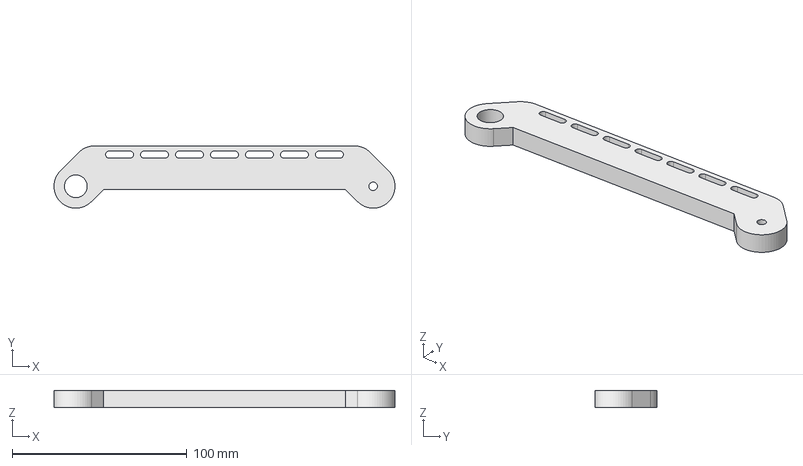
[picture p300: CAD file, 2023-05-02]
src/design/FreeCad/#20_Link2Parallel.FCStd
195.0 x 35.6 x 10.0 mm
