RoboticsURJC/tfg-vperez/src/design/FreeCad/#8_MotorsPlateLeft.FCStd

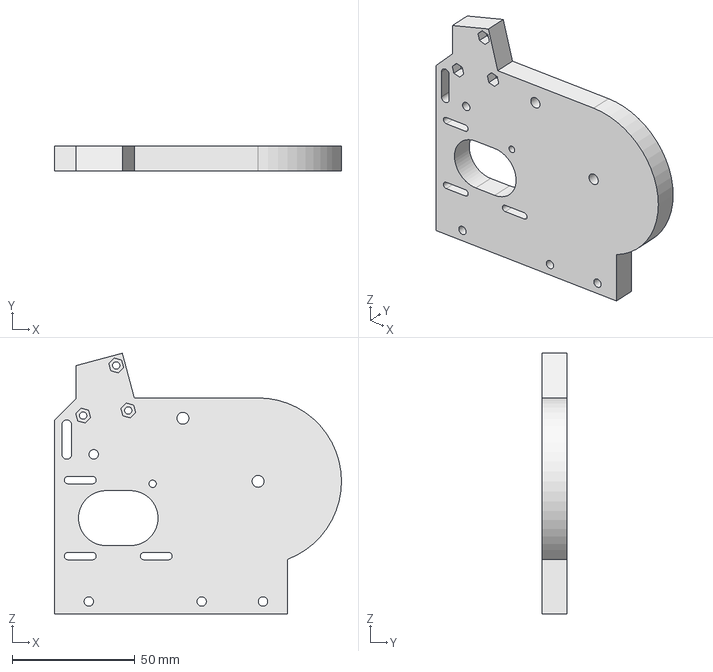
[picture p301: CAD file, 2023-05-02]
src/design/FreeCad/#8_MotorsPlateLeft.FCStd
117.0 x 10.0 x 106.2 mm
