RoboticsURJC/tfg-vperez/src/design/FreeCad/#22_MotorsSlider.FCStd

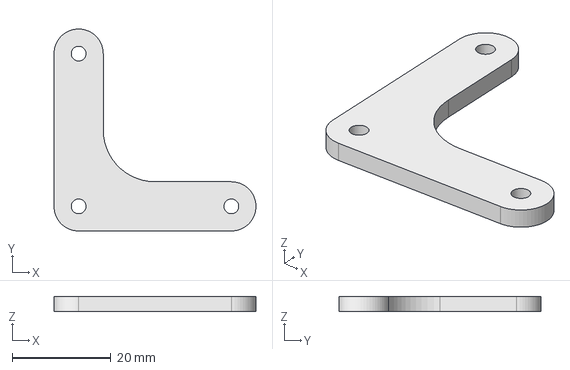
[picture p302: CAD file, 2023-05-02]
src/design/FreeCad/#22_MotorsSlider.FCStd
41.0 x 41.0 x 3.00 mm
