RoboticsURJC/tfg-vperez/src/design/FreeCad/#10_MotorsBasePulleys.FCStd

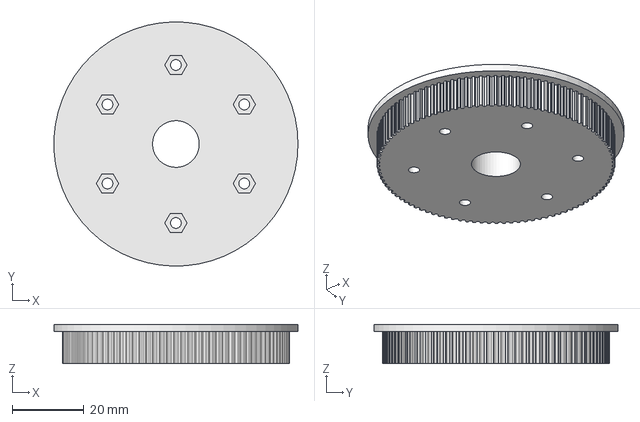
[picture p303: CAD file, 2023-05-02]
src/design/FreeCad/#10_MotorsBasePulleys.FCStd
68.0 x 68.0 x 11.0 mm
