RoboticsURJC/tfg-vperez/src/design/FreeCad/#16_EndEffectorParallel.FCStd

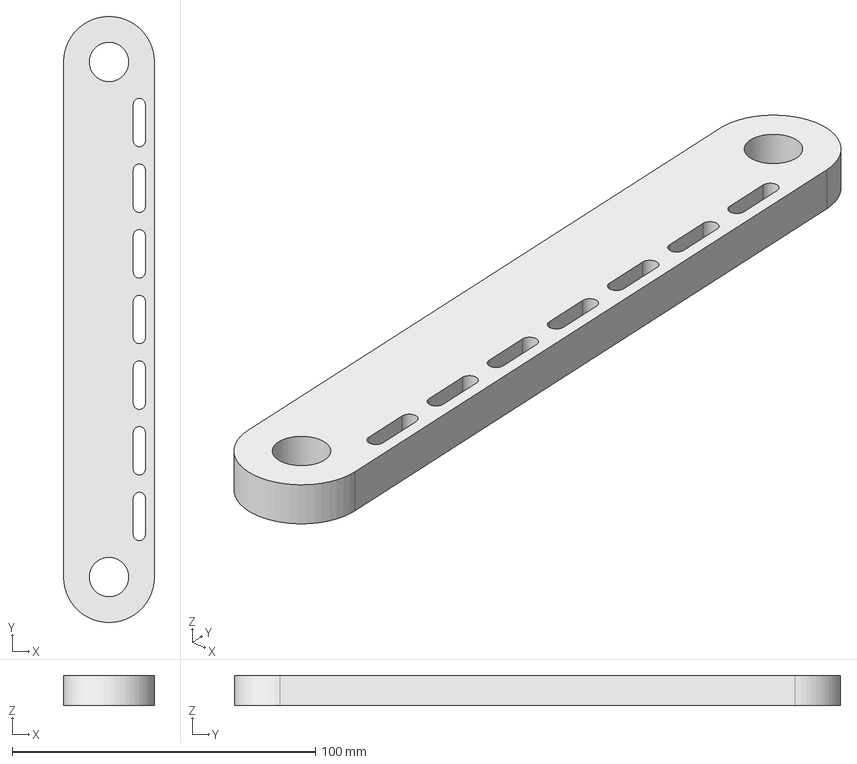
[picture p304: CAD file, 2023-05-02]
src/design/FreeCad/#16_EndEffectorParallel.FCStd
30.0 x 200.0 x 10.0 mm
