RoboticsURJC/tfg-vperez/src/design/FreeCad/#18_EndStopLink2Adjust.FCStd

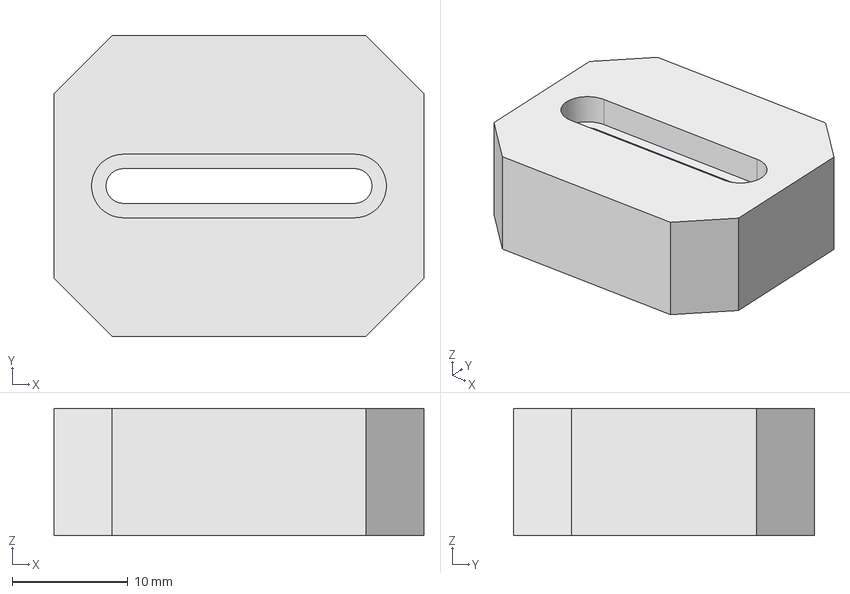
[picture p305: CAD file, 2023-05-02]
src/design/FreeCad/#18_EndStopLink2Adjust.FCStd
32.0 x 26.0 x 11.0 mm
