RoboticsURJC/tfg-vperez/src/design/FreeCad/#13_MotorsBasePulleyAntiSlip.FCStd

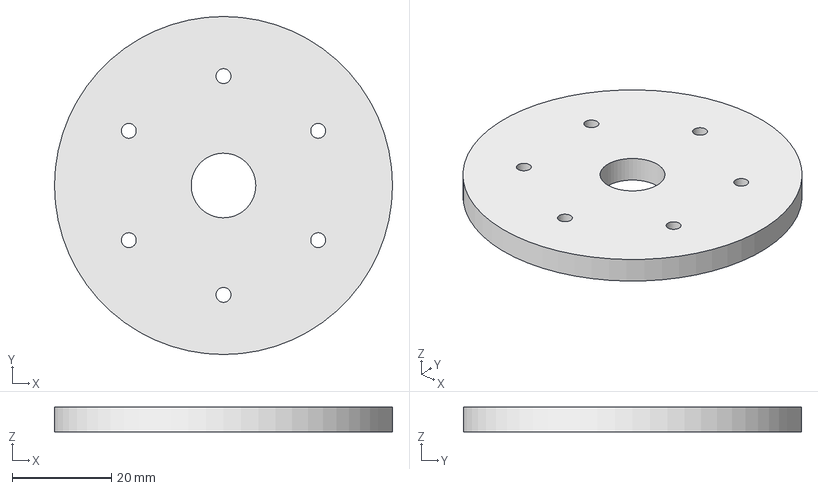
[picture p306: CAD file, 2023-05-02]
src/design/FreeCad/#13_MotorsBasePulleyAntiSlip.FCStd
68.0 x 68.0 x 5.00 mm
