RoboticsURJC/tfg-vperez/src/design/FreeCad/#12_MotorsBaseSpacer.FCStd

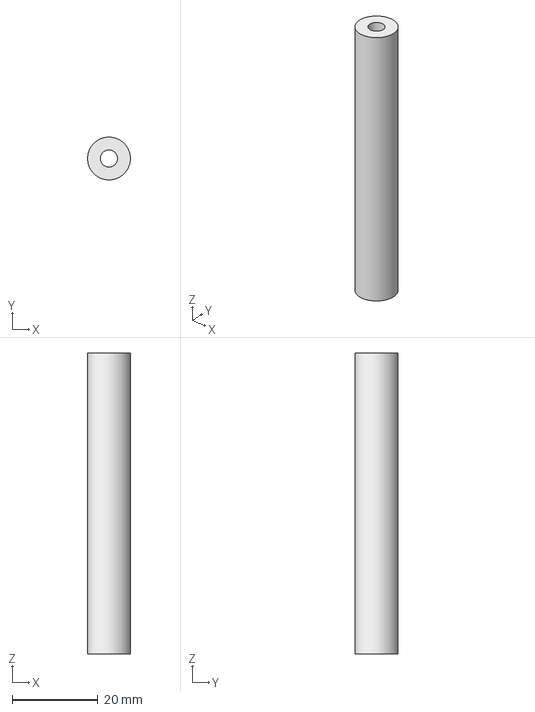
[picture p307: CAD file, 2023-05-02]
src/design/FreeCad/#12_MotorsBaseSpacer.FCStd
9.99 x 10.00 x 70.2 mm
