RoboticsURJC/tfg-vperez/src/design/FreeCad/#9_PasiveBearingSpacer.FCStd

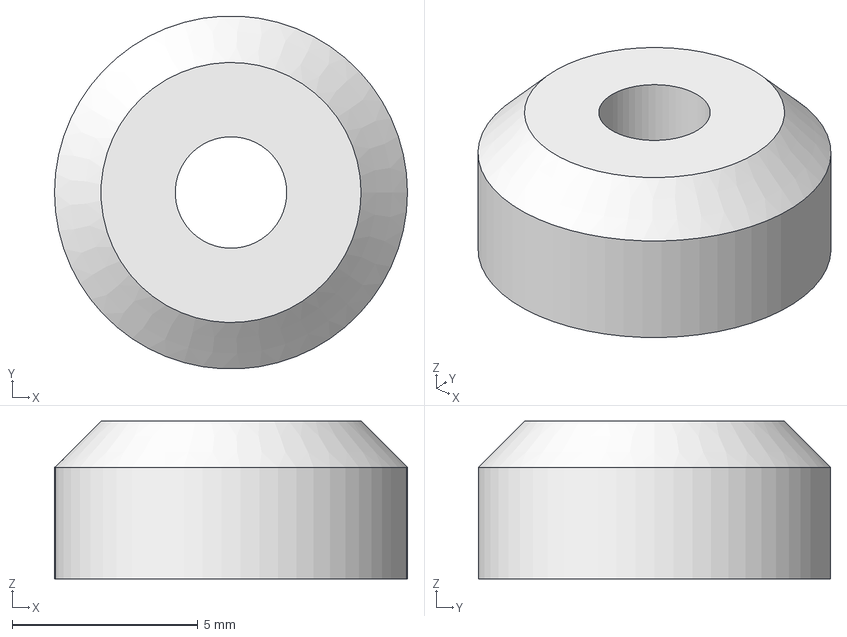
[picture p308: CAD file, 2023-05-02]
src/design/FreeCad/#9_PasiveBearingSpacer.FCStd
9.50 x 9.49 x 4.25 mm
