RoboticsURJC/tfg-vperez/src/design/FreeCad/#4_BasePulley120T.FCStd

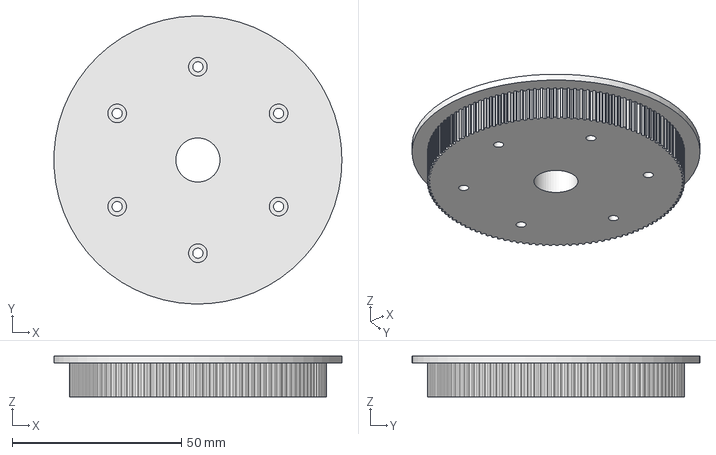
[picture p309: CAD file, 2023-05-01]
src/design/FreeCad/#4_BasePulley120T.FCStd
84.9 x 85.0 x 12.0 mm
