RoboticsURJC/tfg-vperez/src/design/FreeCad/#6_BaseRotationLimit.FCStd

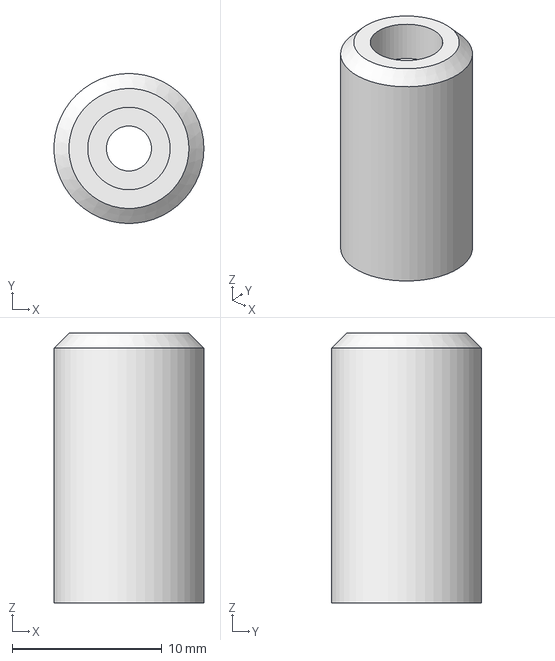
[picture p310: CAD file, 2023-05-01]
src/design/FreeCad/#6_BaseRotationLimit.FCStd
9.99 x 10.00 x 18.0 mm
