RoboticsURJC/tfg-vperez/src/design/FreeCad/#7_MotorsPlateRight.FCStd

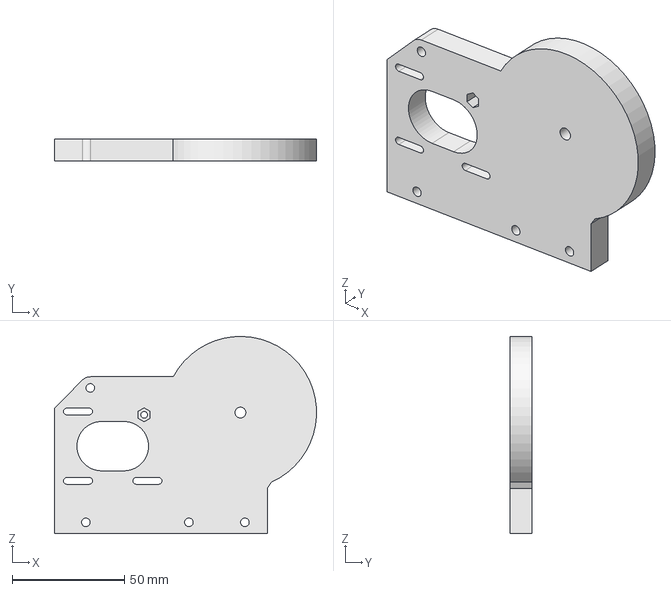
[picture p311: CAD file, 2023-05-01]
src/design/FreeCad/#7_MotorsPlateRight.FCStd
117.0 x 10.0 x 88.0 mm
