RoboticsURJC/tfg-vperez/src/design/FreeCad/#3_BaseTop.FCStd

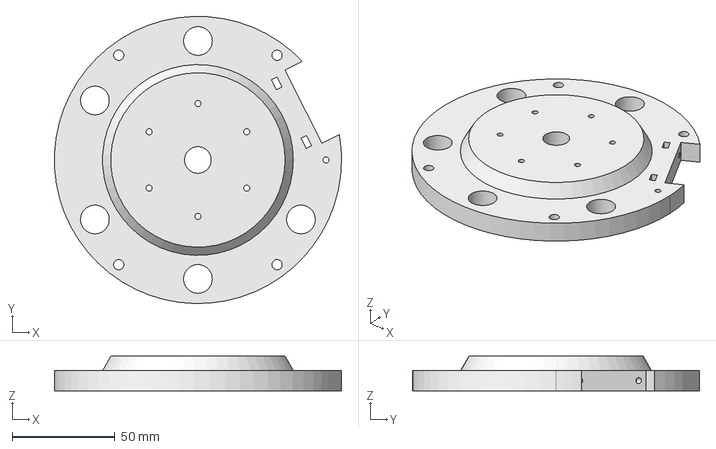
[picture p312: CAD file, 2023-05-01]
src/design/FreeCad/#3_BaseTop.FCStd
139.9 x 139.9 x 17.0 mm
