RoboticsURJC/tfg-vperez/src/design/FreeCad/#2_BaseSpacers.FCStd

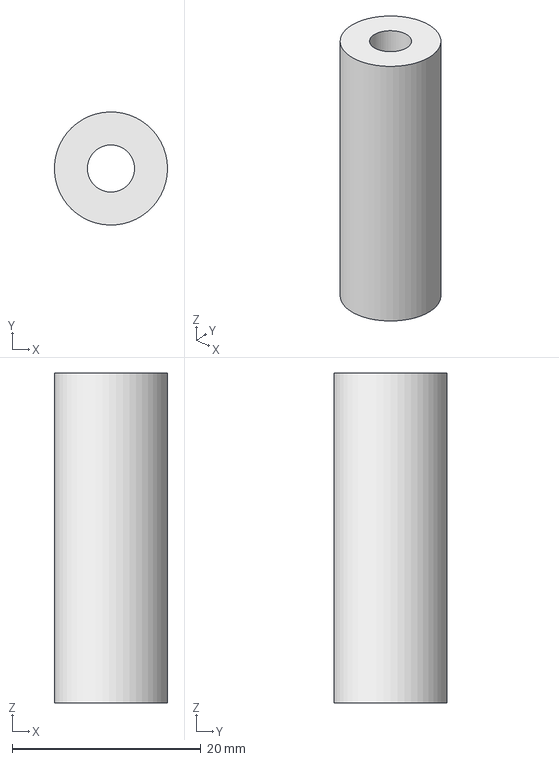
[picture p313: CAD file, 2023-04-30]
src/design/FreeCad/#2_BaseSpacers.FCStd
12.0 x 12.0 x 35.0 mm
