RoboticsURJC/tfg-vperez/src/design/FreeCad/#1_BaseFloor.FCStd

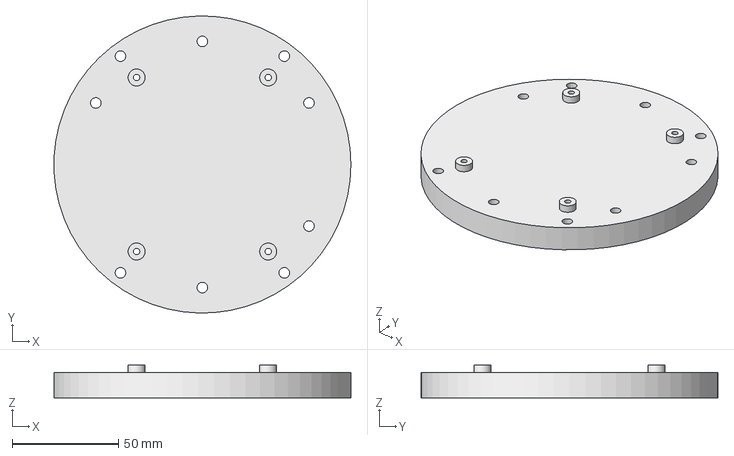
[picture p314: CAD file, 2023-04-30]
src/design/FreeCad/#1_BaseFloor.FCStd
139.9 x 140.0 x 15.5 mm
