RoboticsURJC/tfg-vperez/(list of files, cad)

Other CAD files:
src/design/PinzaDemoMemoria.FCStd
src/design/ModeloAlambrico.FCStd
