RoboticsURJC/tfg-vperez/img/MontajePaso2.JPEG

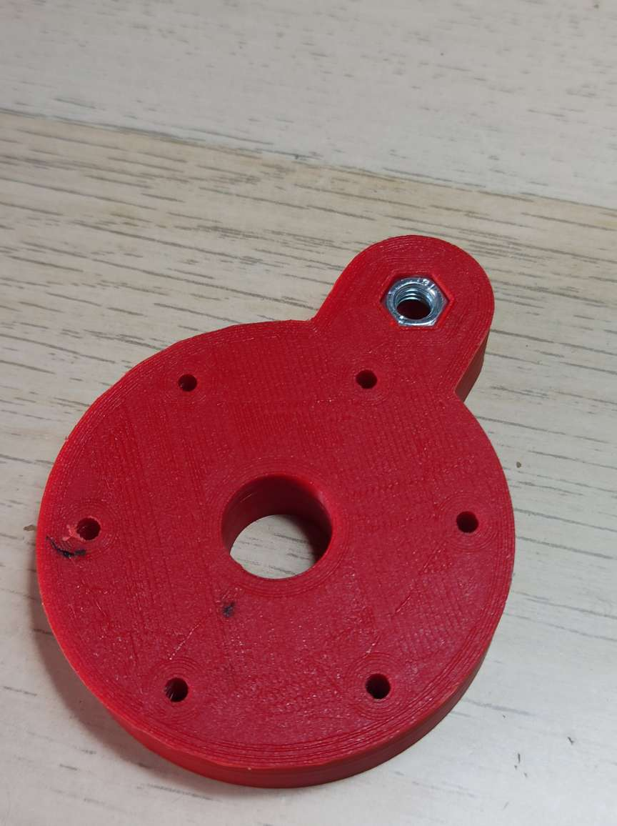
img/MontajePaso2.JPEG
