RoboticsURJC/tfg-vperez/img/SerialDebugAssistant_get_state_usage.png

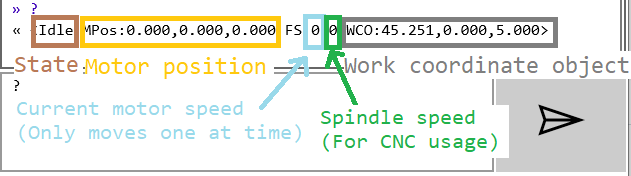
img/SerialDebugAssistant_get_state_usage.png
