RoboticsURJC/tfg-vperez/img/SerialDebugAssistant_setup.png

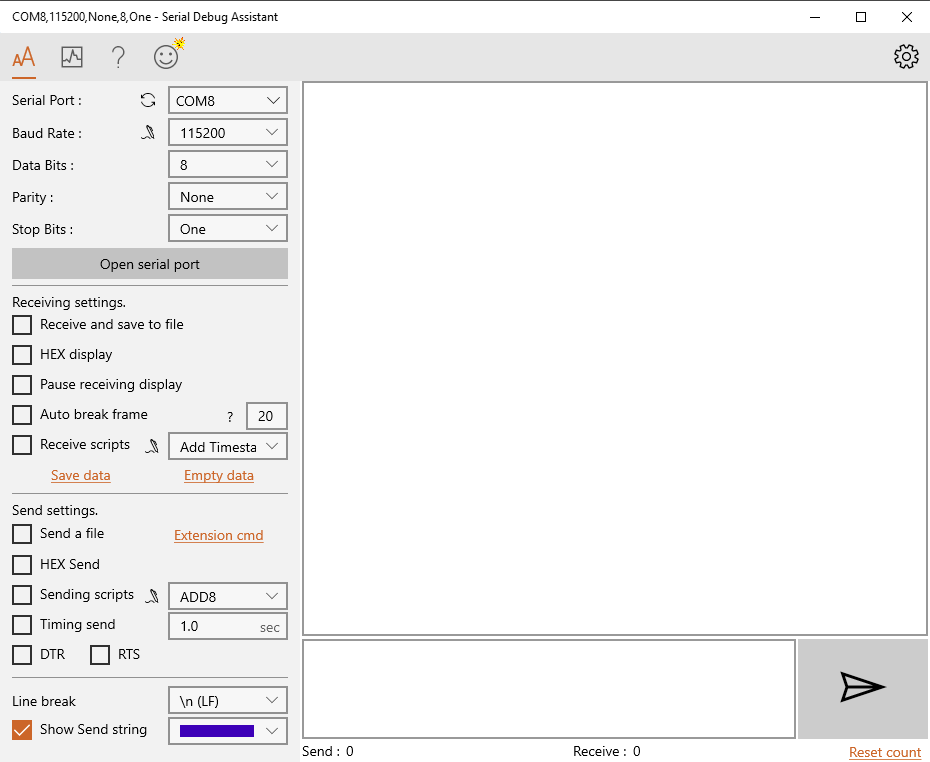
img/SerialDebugAssistant_setup.png
