RoboticsURJC/tfg-vperez/img/SetupAssistantPrimerXacro.png

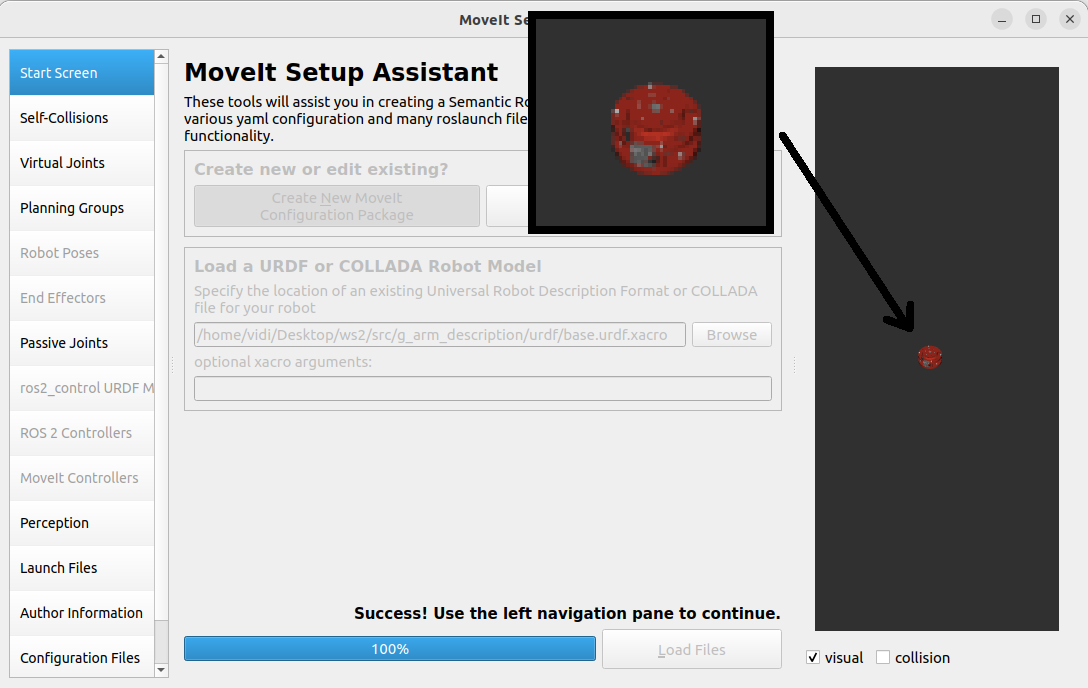
img/SetupAssistantPrimerXacro.png
