RoboticsURJC/tfg-vperez/latex/Memoria/figs/montaje.png

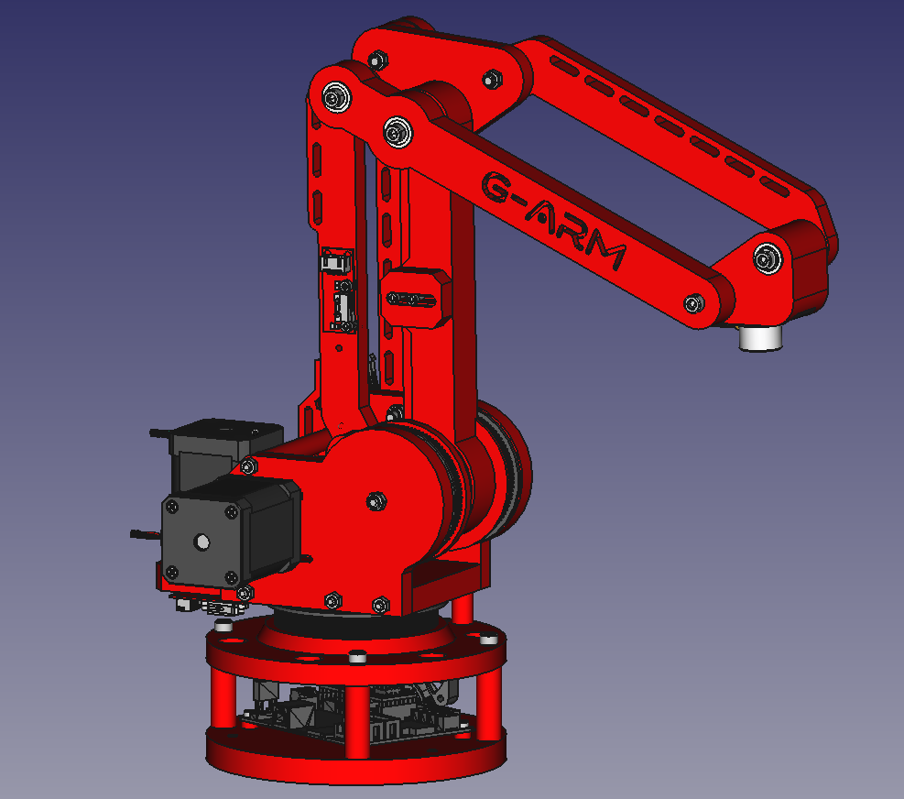
latex/Memoria/figs/montaje.png
