RoboticsURJC/tfg-vperez/latex/Memoria/figs/solder_robot.jpg

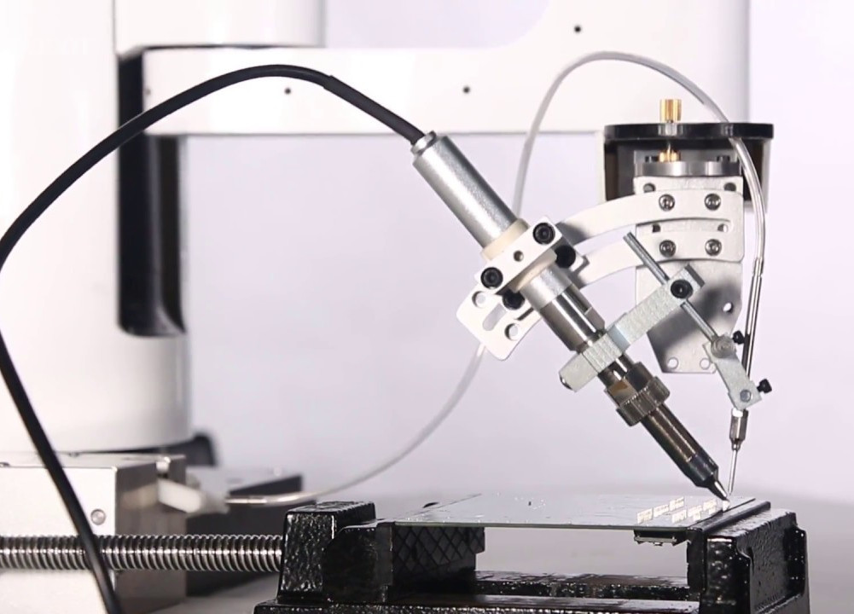
latex/Memoria/figs/solder_robot.jpg
