RoboticsURJC/tfg-vperez/img/algo_test1.png

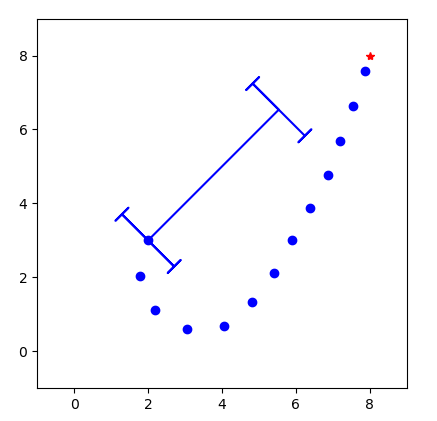
img/algo_test1.png
