RoboticsURJC/tfg-vperez/img/motorTest_relativeproblem.png

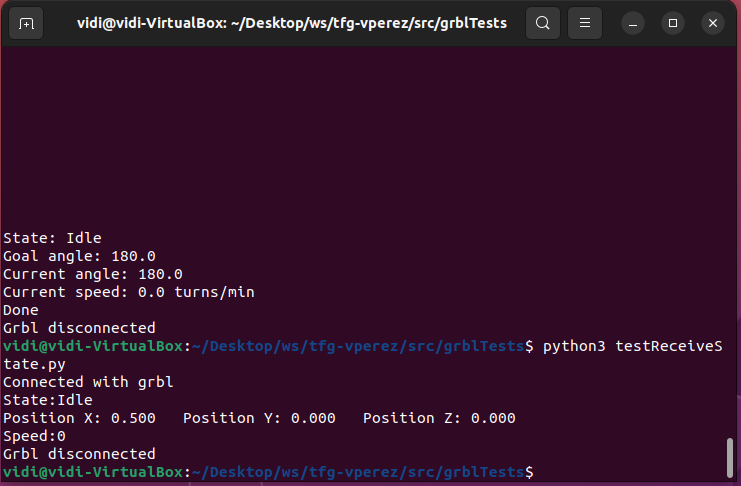
img/motorTest_relativeproblem.png
