RoboticsURJC/tfg-vperez/img/pruebaPoleaDientes.JPEG

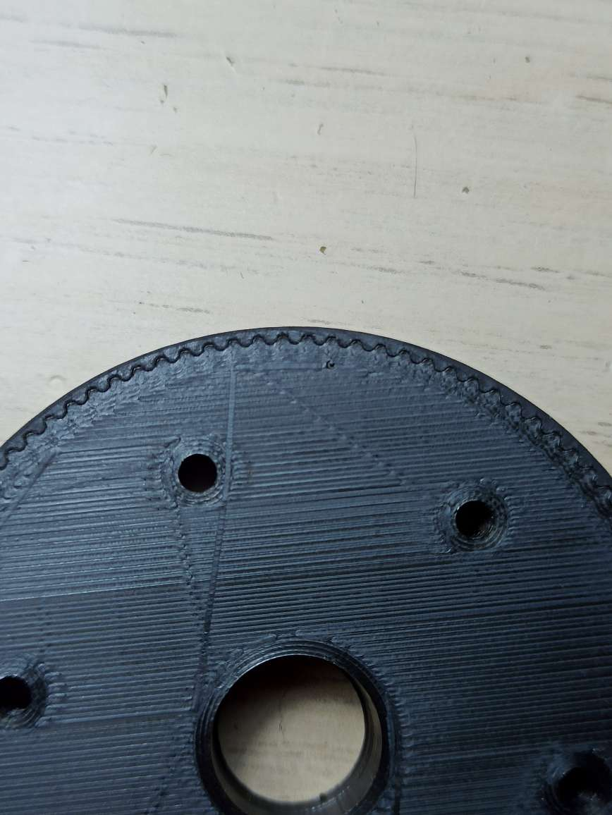
img/pruebaPoleaDientes.JPEG
