RoboticsURJC/tfg-vperez/img/pruebaTolerancias.JPEG

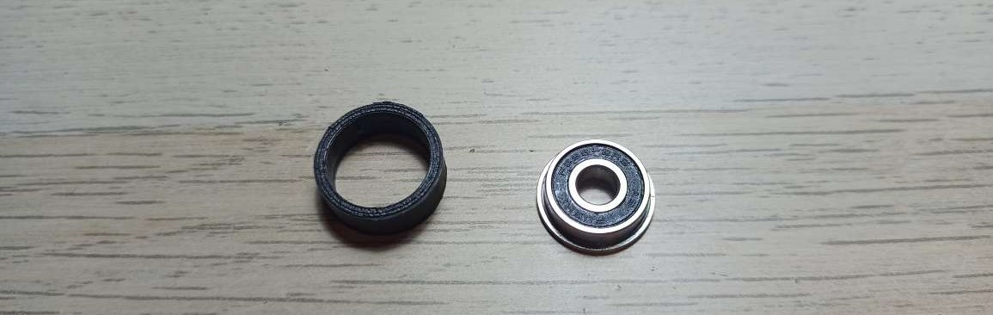
img/pruebaTolerancias.JPEG
