RoboticsURJC/tfg-vperez/img/ResultadoCorrea1.JPEG

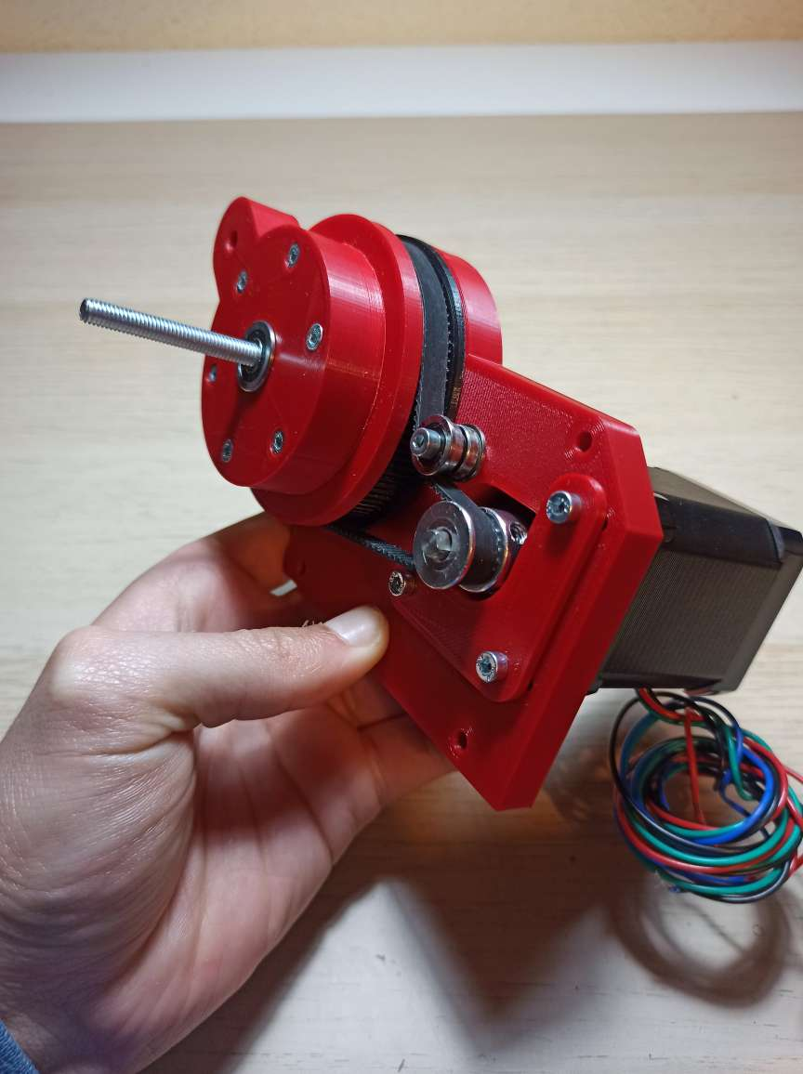
img/ResultadoCorrea1.JPEG
