RoboticsURJC/tfg-vperez/img/fixM5.JPEG

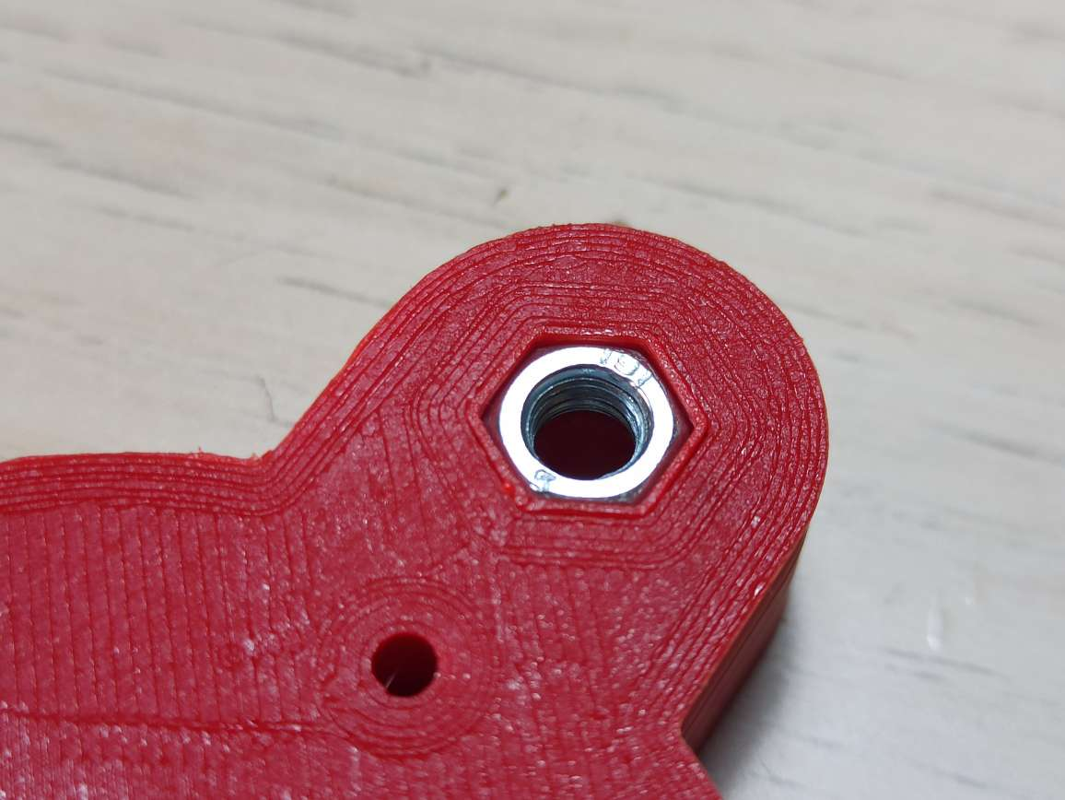
img/fixM5.JPEG
