RoboticsURJC/tfg-vperez/img/problemas_link1.png

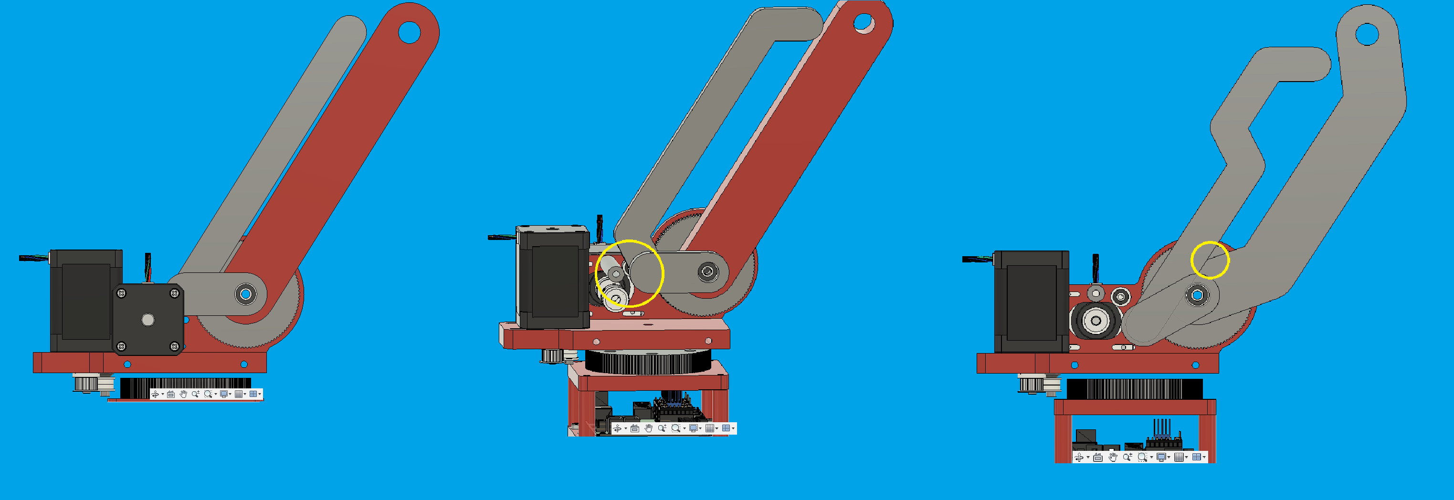
img/problemas_link1.png
