RoboticsURJC/tfg-vperez/img/SerialDebugAssistant_start_information.png

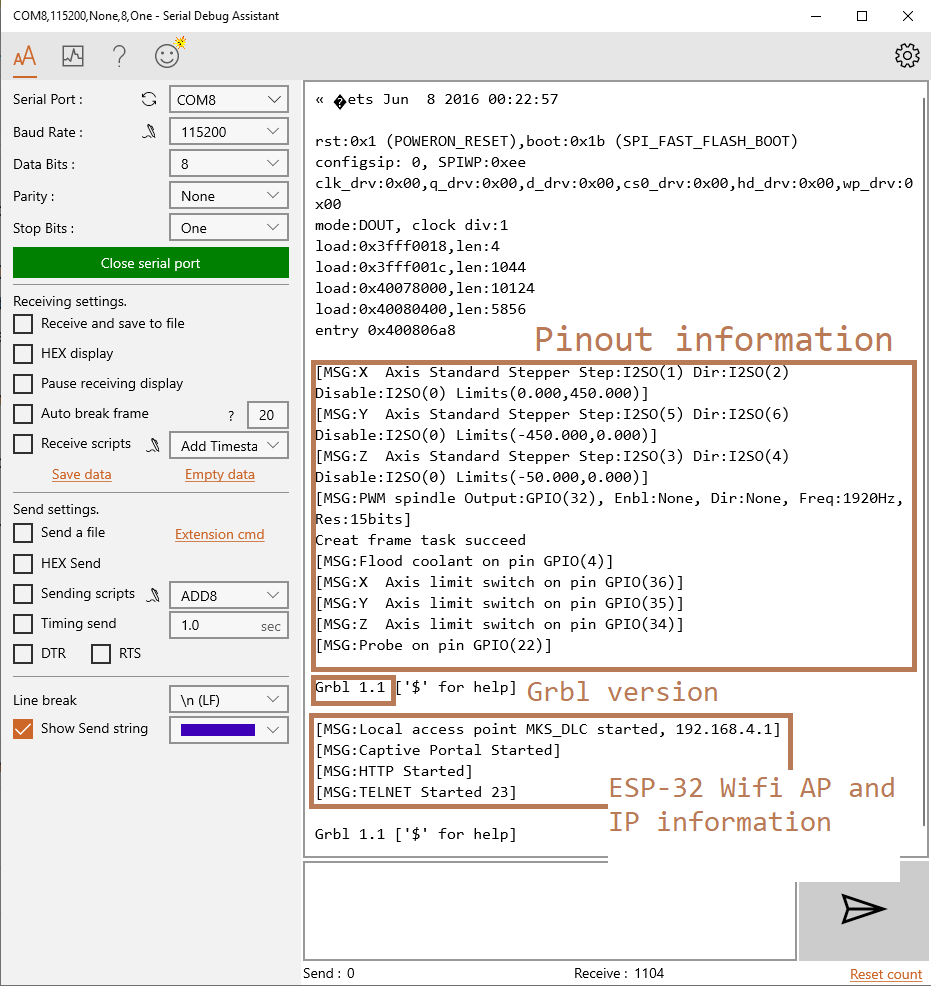
img/SerialDebugAssistant_start_information.png
