RoboticsURJC/tfg-vperez/src/software/Grbl_config.txt

$0 = 10    (Step pulse time, microseconds)
$1 = 255    (Step idle delay, milliseconds)
$2 = 0    (Step pulse invert, mask)
$3 = 1    (Step direction invert, mask)
$4 = 0    (Invert step enable pin, boolean)
$5 = 1    (Invert limit pins, boolean)
$6 = 1    (Invert probe pin, boolean)
$46 = 10.000   
$10 = 1    (Status report options, mask)
$11 = 0.010    (Junction deviation, millimeters)
$12 = 0.002    (Arc tolerance, millimeters)
$13 = 0    (Report in inches, boolean)
$20 = 0    (Soft limits enable, boolean)
$21 = 0    (Hard limits enable, boolean)
$22 = 1    (Homing cycle enable, boolean)
$23 = 1    (Homing direction invert, mask)
$24 = 1.000    (Homing locate feed rate, mm/min)
$25 = 1.000    (Homing search seek rate, mm/min)
$26 = 250.000    (Homing switch debounce delay, milliseconds)
$27 = 1.000    (Homing switch pull-off distance, millimeters)
$28 = 1920.000   
$30 = 10000.000    (Maximum spindle speed, RPM)
$31 = 0.000    (Minimum spindle speed, RPM)
$32 = 0    (Laser-mode enable, boolean)
$38 = 1   
$40 = 1   
$100 = 26.666    (X-axis travel resolution, step/mm)
$101 = 22.222    (Y-axis travel resolution, step/mm)
$102 = 22.222    (Z-axis travel resolution, step/mm)
$103 = 100.000   
$104 = 100.000   
$105 = 100.000   
$110 = 6000.000    (X-axis maximum rate, mm/min)
$111 = 6000.000    (Y-axis maximum rate, mm/min)
$112 = 6000.000    (Z-axis maximum rate, mm/min)
$113 = 1000.000   
$114 = 1000.000   
$115 = 1000.000   
$120 = 60.000    (X-axis acceleration, mm/sec^2)
$121 = 60.000    (Y-axis acceleration, mm/sec^2)
$122 = 60.000    (Z-axis acceleration, mm/sec^2)
$123 = 200.000   
$124 = 200.000   
$125 = 200.000   
$130 = 450.000    (X-axis maximum travel, millimeters)
$131 = 450.000    (Y-axis maximum travel, millimeters)
$132 = 50.000    (Z-axis maximum travel, millimeters)
$133 = 300.000   
$134 = 300.000   
$135 = 300.000   
