RoboticsURJC/tfg-vperez/src/software/g_arm_moveit2/config/initial_positions.yaml

# Default initial positions for g_arm's ros2_control fake system

initial_positions:
  joint1: 0
  joint2: 0
  joint3: 0
  jointPWM: 0
