RoboticsURJC/tfg-vperez/src/software/.grblTests/grblConfig.txt

$0=10
$1=25
$2=0
$3=1
$4=0
$5=1
$6=1
$46=10.000
$10=1
$11=0.010
$12=0.002
$13=0
$20=0
$21=0
$22=0
$23=1
$24=300.000
$25=1000.000
$26=250.000
$27=1.000
$28=1920.000
$30=10000.000
$31=0.000
$32=0
$38=1
$40=1
$100=1234.000
$101=80.000
$102=80.000
$103=100.000
$104=100.000
$105=100.000
$110=8.000
$111=6000.000
$112=6000.000
$113=1000.000
$114=1000.000
$115=1000.000
$120=1.000
$121=500.000
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
