RoboticsURJC/tfg-vperez/(commit log)

2023-02-10 update mech
    [ManipuladorAlámbrico.FCStd]
2023-02-11 Fotos varias
    [Tornillo_m3x12.step]
2023-02-14 Brazo a urdf
    [arm.xacro, base_link.stl, controller.yaml, link1_1.stl, link2_1.stl, materials.xacro]
2023-02-24 New grbl advances
2023-02-24 [WIP]Problem with coordinates systems
    [testMoveOneAxis.py]
2023-02-25 [WIP] Grbl api thread
2023-02-25 [FIX] grblApi working now
    [grblAPI.py, testing_grblAPI.py]
2023-02-26 [ADD] Load config to grbl api
2023-02-26 [ADD] Default config
    [grblBackupConfig.txt]
2023-02-26 [FIX] Grbl config no error fixed
    [grblConfig.txt]
2023-03-04 Joint and kinematics format
2023-03-11 Filters but not perfect
2023-03-19 Starting with description
    [base.urdf.xacro]
2023-03-22 Testing with new big size dae
    [base.urdf.xacro]
2023-03-24 New urdf
    [base.urdf.xacro]
2023-03-30 Tested with camera
2023-04-14 Homing working
2023-04-18 Autohome precise
    [no-visual.urdf, works.urdf]
2023-04-30 Organized folder
    [ManipuladorAlámbrico.FCStd, ManipuladorPrototipo.FCStd, Tornillo_m3x12.step, arm.urdf, arm.xacro, base.urdf.xacro, base_link.stl, controller.yaml]
2023-04-30 Design base
    [#1_BaseFloor.FCStd, #2_BaseSpacers.FCStd, BaseEndStop.stl, BodyPulleys.stl, ElectromagnetTool.stl, EndEffector.stl, TolerancesTest.stl]
2023-05-01 More freecad designs
    [#3_BaseTop.FCStd, #4_BasePulley120T.FCStd, #5_MotorsBase.FCStd, #6_BaseRotationLimit.FCStd, #7_MotorsPlateRight.FCStd, #8_MotorsPlateLeft.FCStd, AlambricModel.FCStd, ManipuladorAlámbrico.FCStd]
2023-05-02 New pieces
    [#0_ASSEMBLY.FCStd, #10_MotorsBasePulleys.FCStd, #11_Link1.FCStd, #12_MotorsBaseSpacer.FCStd, #13_MotorsBasePulleyAntiSlip.FCStd, #14_Joint2Crank.FCStd, #15_Joint1Parallel.FCStd, #16_EndEffectorParallel.FCStd]
2023-05-02 Last parts
    [#17_Elbow.FCStd, #19_Link2.FCStd, #20_Link2Parallel.FCStd, #21_EndEffector.FCStd, #22_MotorsSlider.FCStd, #8_MotorsPlateLeft(UNDONE).FCStd, #8_MotorsPlateLeft.FCStd]
2023-05-14 URDF easy part done, remains the complex joints
    [base.urdf.xacro]
2023-05-15 End-effector mimic
    [base.urdf.xacro]
2023-05-17 Desacoupled joints :)
    [base.urdf (copy).xacro]
2023-05-17 Parallelogram 1 done in URDF
    [base.urdf.xacro]
2023-05-22 Added 2 parts virtuals to urdf
    [base.urdf.xacro]
2023-05-23 End of the URDF visual
    [base.urdf.xacro]
2023-05-26 Added power supply latex
2023-05-31 added new imgs
    [PinzaDemoMemoria.FCStd]
2023-06-01 Added specs tables to latex
    [PinzaDemoMemoria.FCStd]
2023-06-02 Added scara, rr, and joints types to memory
2023-06-04 Added grbl config structure to memory
2023-06-05 Added precise collisions to URDF
    [base.urdf.xacro, elbow.stl, end.stl, link1.stl, link2.stl, link_j3_lever.stl, link_j3_rod.stl, parallel_end_link1.stl]
2023-07-01 Added some things on chapt 5
    [AlambricModel.FCStd, ModeloAlambrico.FCStd]
2023-07-04 Added base assembly
    [#0_ASSEMBLY_MAIN_BASE.FCStd, F695.step]
2023-07-05 Added base motors assembly
    [#0_ASSEMBLY_MAIN_BASE.FCStd, #0_ASSEMBLY_MOTORS_BASE.FCStd, #5_MotorsBase.FCStd]
2023-07-06 Some fixes
    [#0_ASSEMBLY_MAIN_BASE.FCStd]
2023-07-06 motors base and some chap reviews
    [#0_ASSEMBLY_MOTORS_BASE.FCStd, #21_EndEffector.FCStd, Endstop.step, F623.step, GT2_20T.step, NEMA17.step]
2023-07-06 Chapters fixes
    [#0_ASSEMBLY_END_EFFECTOR.FCStd, #21_EndEffector.FCStd, #23_TOOL_Electromagnet.FCStd, electromagnet.step]
2023-07-06 Tool electromagnet freecad
    [#0_ASSEMBLY_END_EFFECTOR.FCStd, #0_ASSEMBLY_MAIN_BASE.FCStd, #23_TOOL_Electromagnet.FCStd]
2023-07-06 Starting with links assembly
    [#0_ASSEMBLY_LINKS.FCStd, #11_Link1.FCStd]
2023-07-10 Full assembly
    [#0_ASSEMBLY_END_EFFECTOR.FCStd, #0_ASSEMBLY_LINKS.FCStd, #0_ASSEMBLY_MAIN_BASE.FCStd, #14_Joint2Crank.FCStd, #15_Joint1Parallel.FCStd, #17_Elbow.FCStd, #19_Link2.FCStd, #21_EndEffector.FCStd]
2023-07-10 Added some images to latex
    [#0_ASSEMBLY_END_EFFECTOR.FCStd, #21_EndEffector.FCStd, #23_TOOL_Electromagnet.FCStd]
2023-07-11 Fixed start error in moveit package
    [g_arm.ros2_control.xacro, joint_limits.yaml, robot.urdf, robot.urdf.xacro, ros2_controllers.yaml]
2023-07-11 Added some changes in latex
    [joint_limits.yaml]
2023-07-12 Launcher of moveit real
    [g_arm.ros2_control.xacro, joint_limits.yaml, ros2_controllers.yaml]
2023-07-13 Simple driver working fine!
2023-07-13 Added new logger traces
2023-07-14 Fixed joint3 overtravel bug
    [robot.urdf, robot.urdf.xacro]
2023-07-14 Fixed bug not planning because of low range passive link
    [robot.urdf, robot.urdf.xacro]
2023-07-14 Moveit with Z downwards fixed
    [robot.urdf, robot.urdf.xacro]
2023-07-14 Added assembly of magnet
    [#0_ASSEMBLY_ELECTROMAGNET.FCStd, #21_EndEffector.FCStd, robot_electromagnet.urdf.xacro]
2023-07-14 electromagnet stl
2023-07-14 electromagnet freecad stl
    [#0_ASSEMBLY_ELECTROMAGNET.FCStd]
2023-07-14 Added new package with tool working
    [g_arm.ros2_control.xacro, g_arm.urdf.xacro, joint_limits.yaml, robot_electromagnet.urdf, ros2_controllers.yaml]
2023-07-15 Added first part of chap 6 GRBL part
2023-07-16 Added new things about urdf
2023-07-16 Added full URDF explanation
2023-07-16 Added driver info in latex
2023-07-17 Added endstop in freecad links
    [#0_ASSEMBLY_LINKS.FCStd, #15_Joint1Parallel.FCStd]
2023-07-20 Added all bolts count
    [#0_ASSEMBLY_ELECTROMAGNET.FCStd, #0_ASSEMBLY_MOTORS_BASE.FCStd]
2023-09-04 Added anexos
    [BaseEndStop.stl, BodyPulleys.stl, ElectromagnetTool.stl, EndEffector.stl, TolerancesTest.stl]
2023-09-05 Some repo cleanning
    [arm.xacro, base_link.stl, controller.yaml, grblBackupConfig.txt, grblConfig.txt, link1_1.stl, link2_1.stl, materials.xacro]
2023-09-07 Added a example (not tested yet)
    [#24_TOOL_Pen.FCStd]
2023-09-08 servo not working
2023-09-21 Working IK
    [robot_electromagnet.urdf, robot_electromagnet.urdf.xacro]
2023-09-22 Some cleaning
    [g_arm.ros2_control.xacro, g_arm.urdf.xacro, joint_limits.yaml, ros2_controllers.yaml]
2023-09-23 Trying to fix repo issue
    [kinematics.py]
2023-09-24 Added pen tool
    [#24_TOOL_Pen.FCStd]
2023-09-24 Added electromagnet test and works
    [robot_electromagnet.urdf, robot_electromagnet.urdf.xacro]
